nikiiv/zx-uno/hardware/ps2arduino/fotos/zxunops2_conexion_a_membrana.jpg

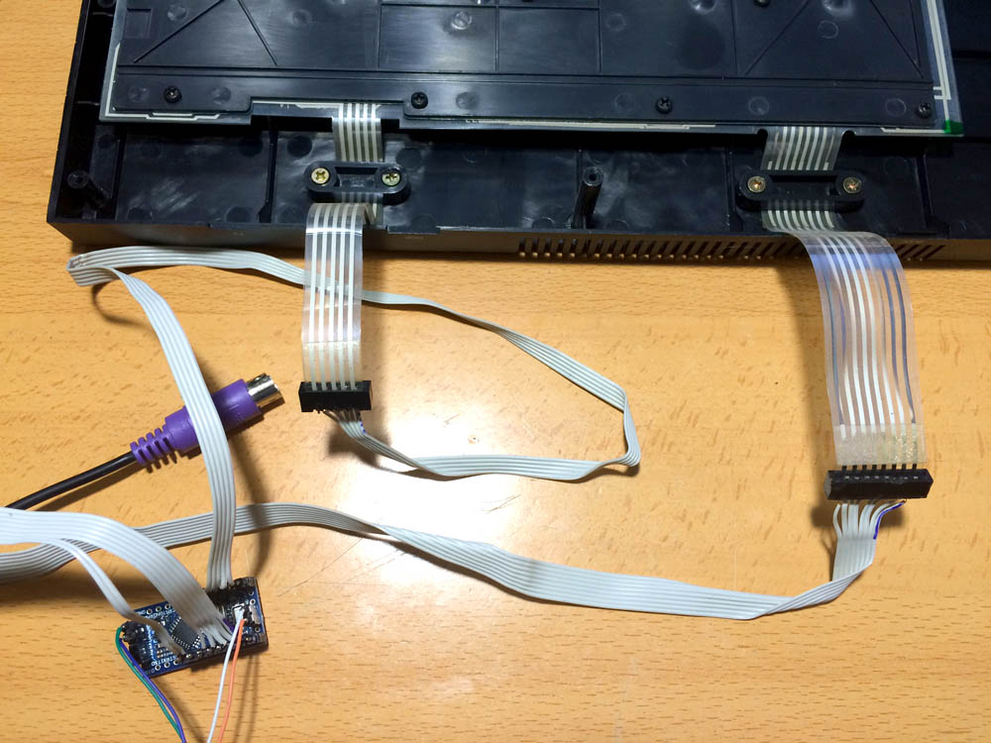
hardware/ps2arduino/fotos/zxunops2_conexion_a_membrana.jpg
