nikiiv/zx-uno/hardware/zxuno/A+/zxunoA.jpg

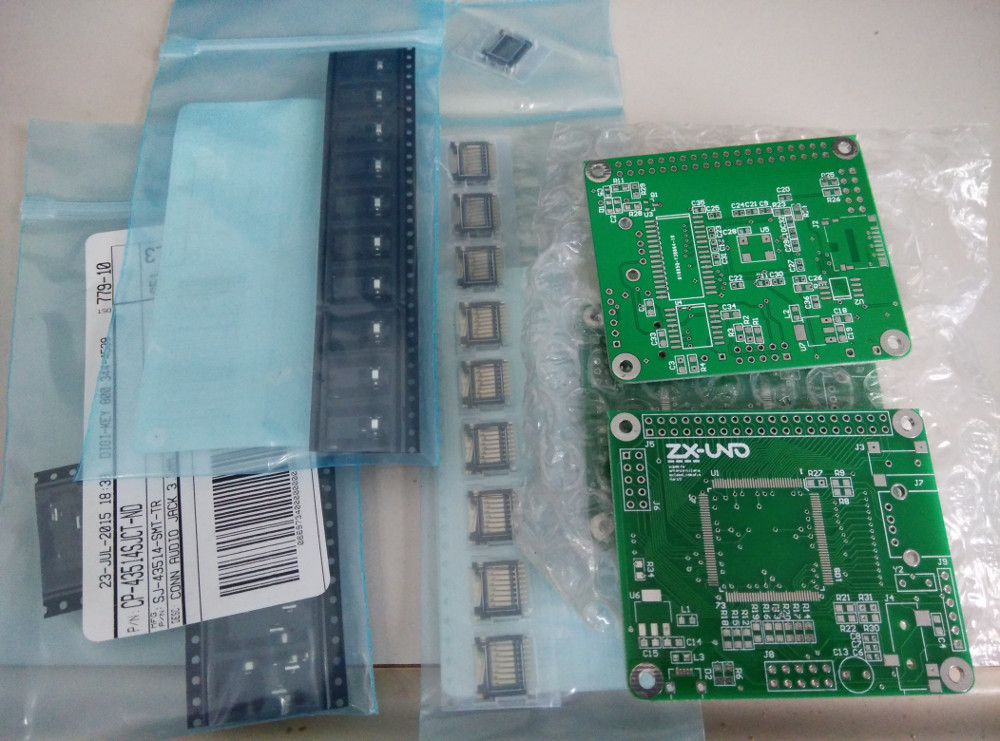
hardware/zxuno/A+/zxunoA.jpg
