nikiiv/zx-uno/hardware/usbjtag/readme.txt

Schematics and firmware source code here:
http://sa89a.net/mp.cgi/ele/ub.htm
