nikiiv/zx-uno/cores/ps2_to_speccy_reloaded/esquema_cableado_ps2_raton_y_teclado.gif

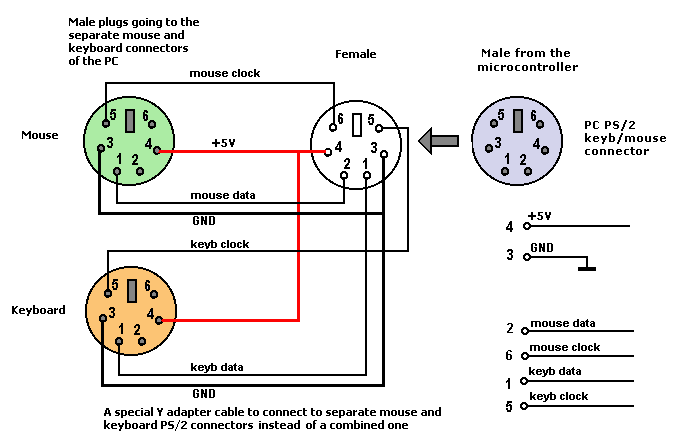
cores/ps2_to_speccy_reloaded/esquema_cableado_ps2_raton_y_teclado.gif
