nikiiv/zx-uno/cores/ps2_to_speccy_reloaded/zx_spectrum_matrix.gif

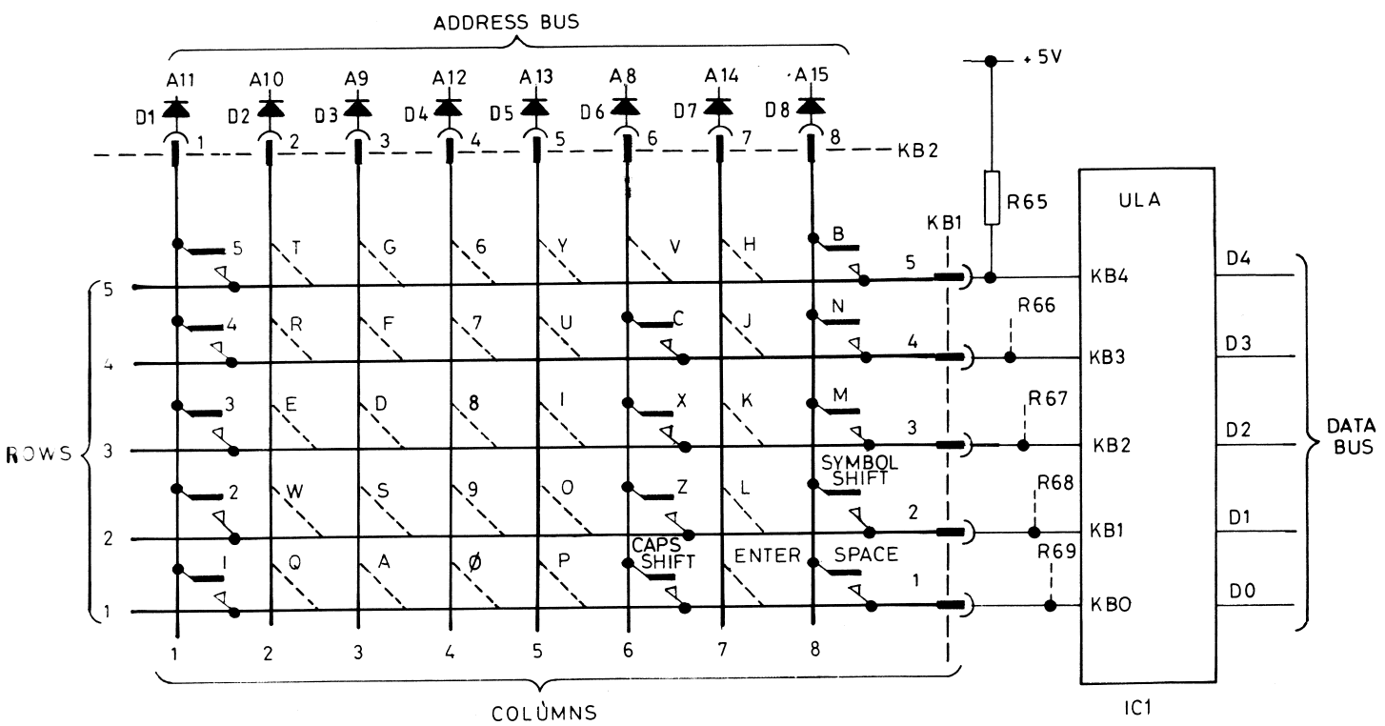
cores/ps2_to_speccy_reloaded/zx_spectrum_matrix.gif
