nikiiv/zx-uno/cores/pzx_player/core/pzx_player_implemented_in_hardware.png

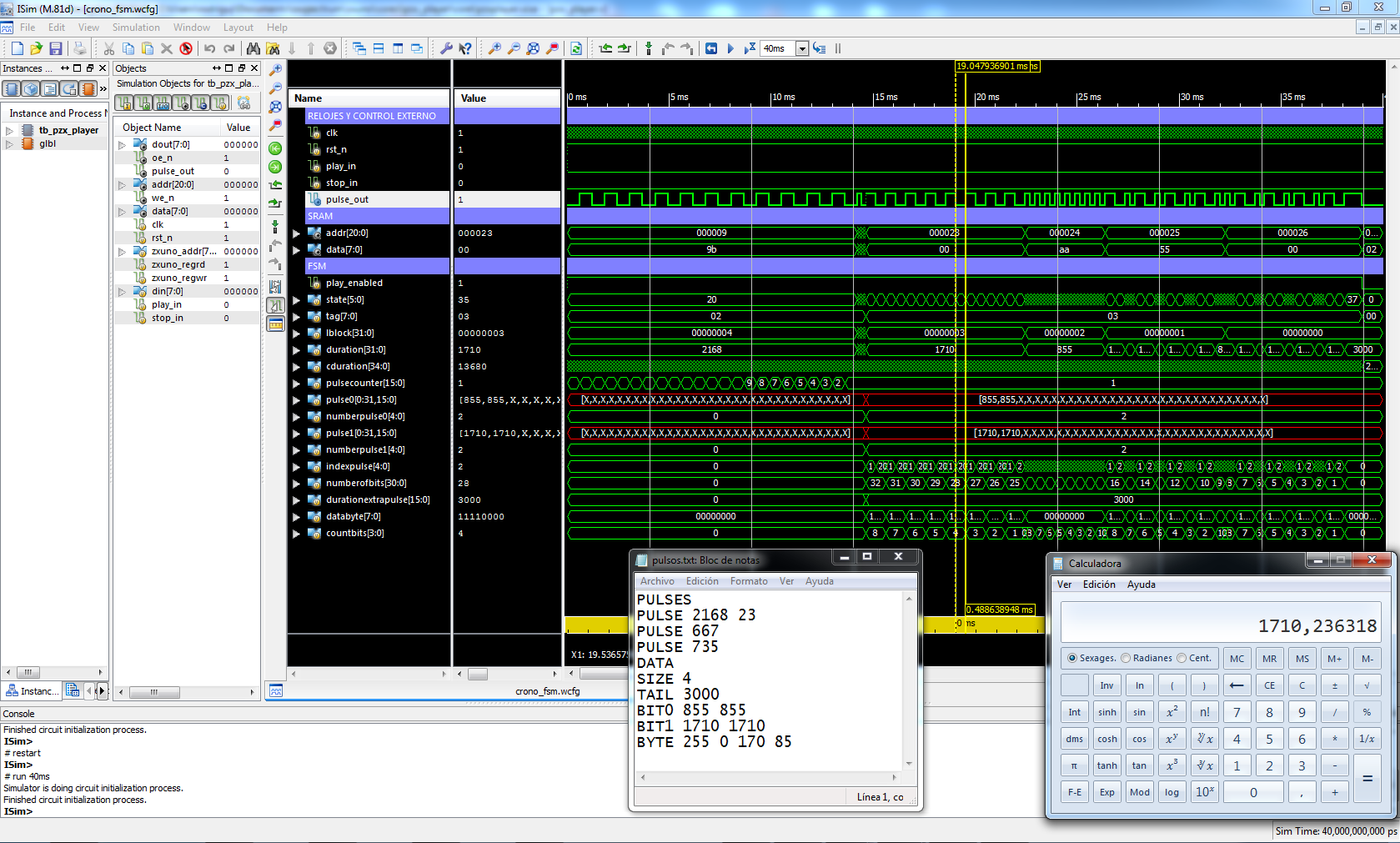
cores/pzx_player/core/pzx_player_implemented_in_hardware.png
