nikiiv/zx-uno/fotos/IMG_3362.JPG

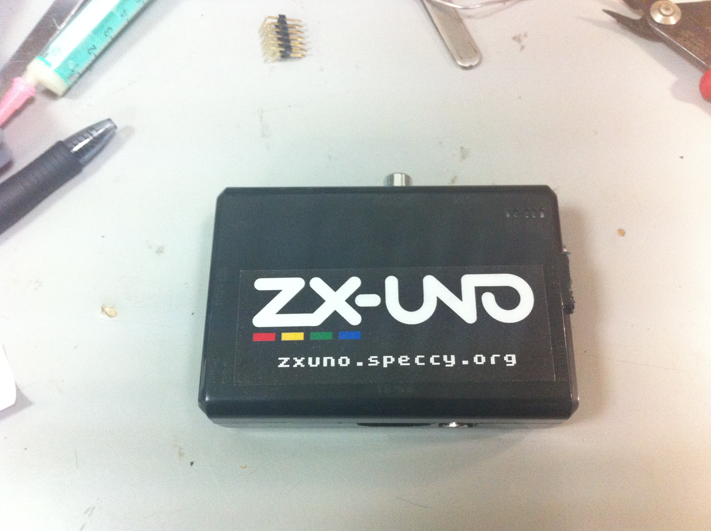
fotos/IMG_3362.JPG
