nikiiv/zx-uno/fotos/IMG_3363.JPG

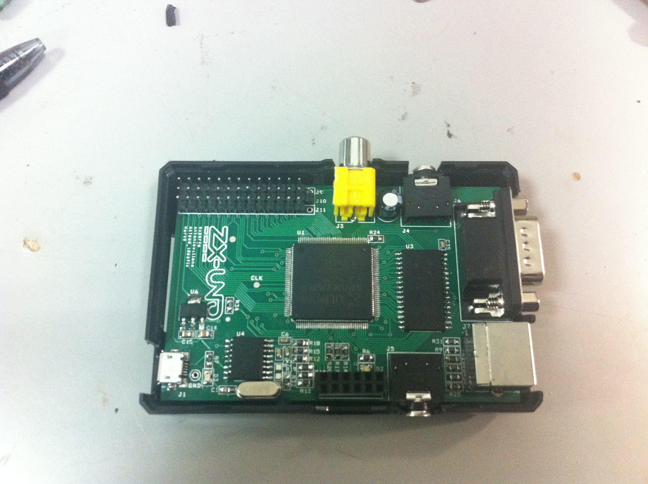
fotos/IMG_3363.JPG
