nikiiv/zx-uno/fotos/IMG_3365.JPG

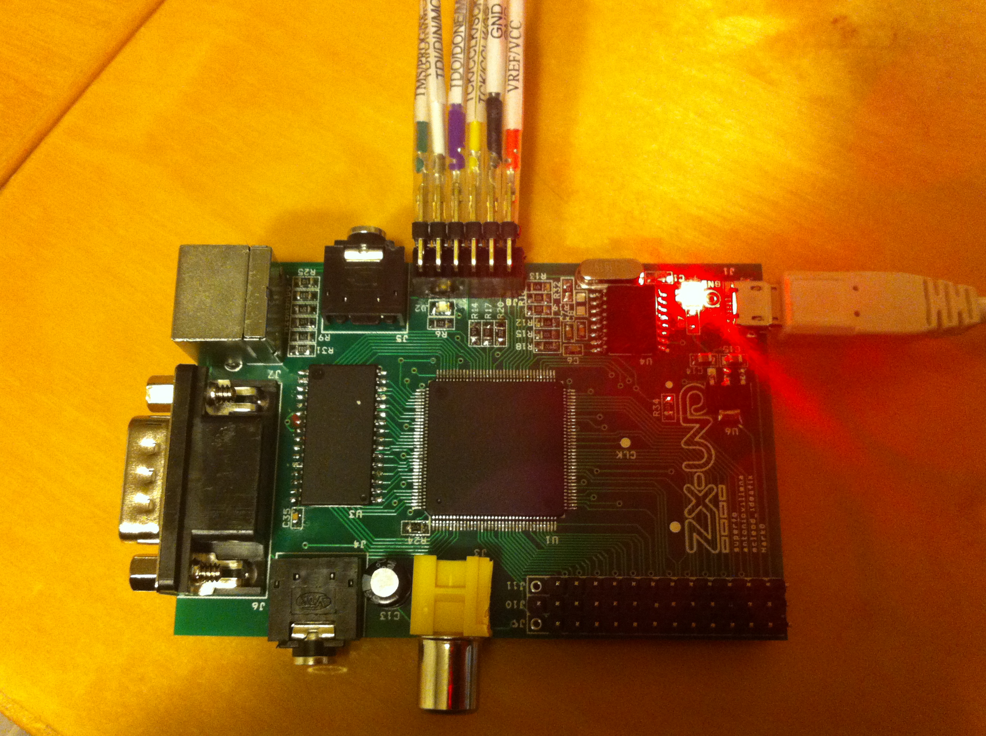
fotos/IMG_3365.JPG
