nikiiv/zx-uno/fotos/IMG_3367.JPG

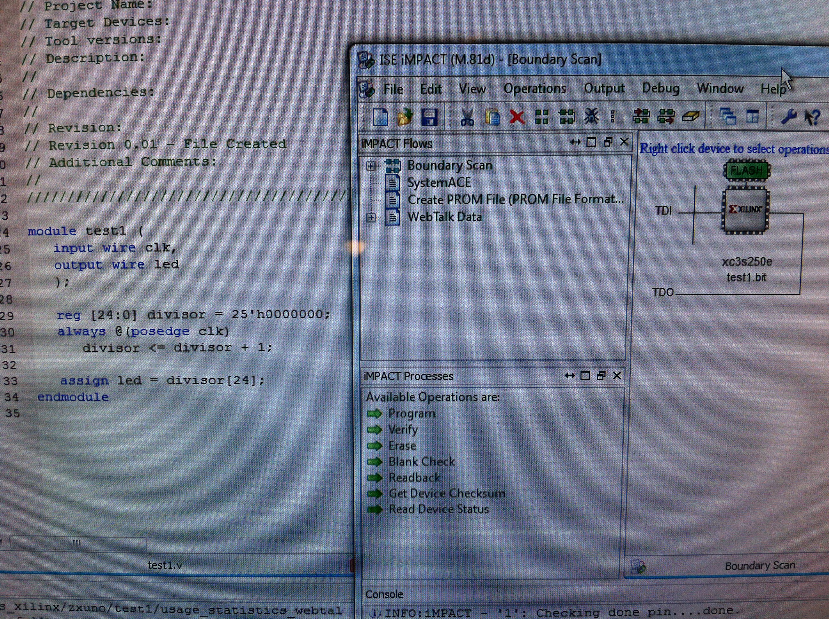
fotos/IMG_3367.JPG
