nikiiv/zx-uno/fotos/IMG_3368.JPG

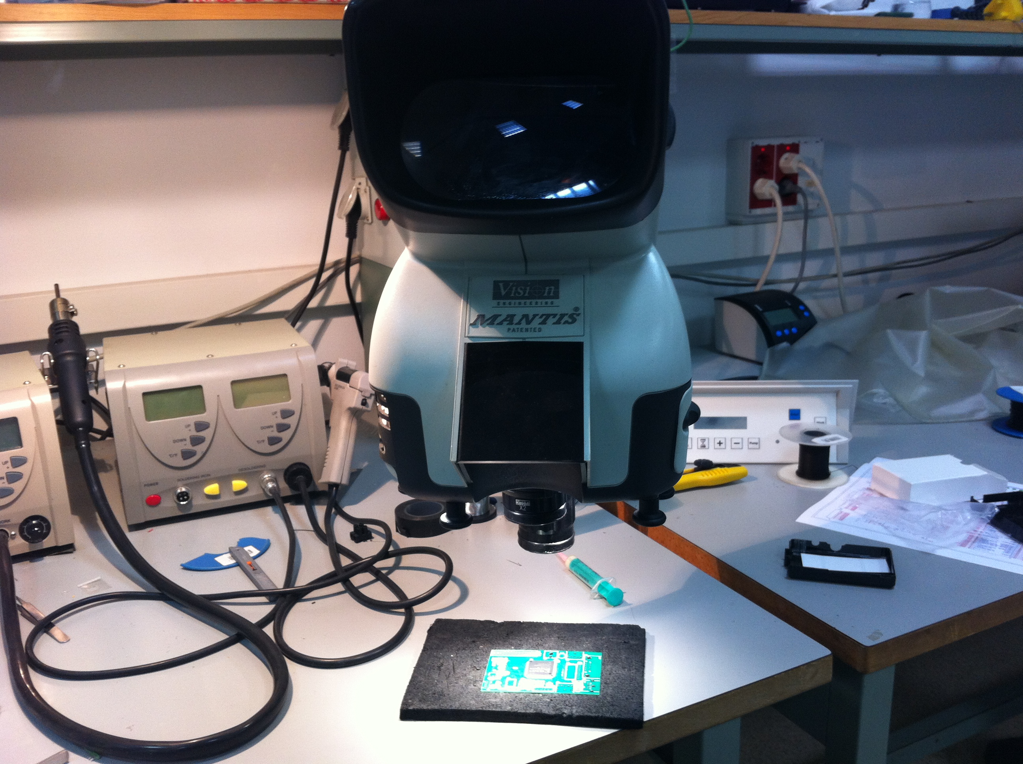
fotos/IMG_3368.JPG
