nikiiv/zx-uno/fotos/IMG_3369.JPG

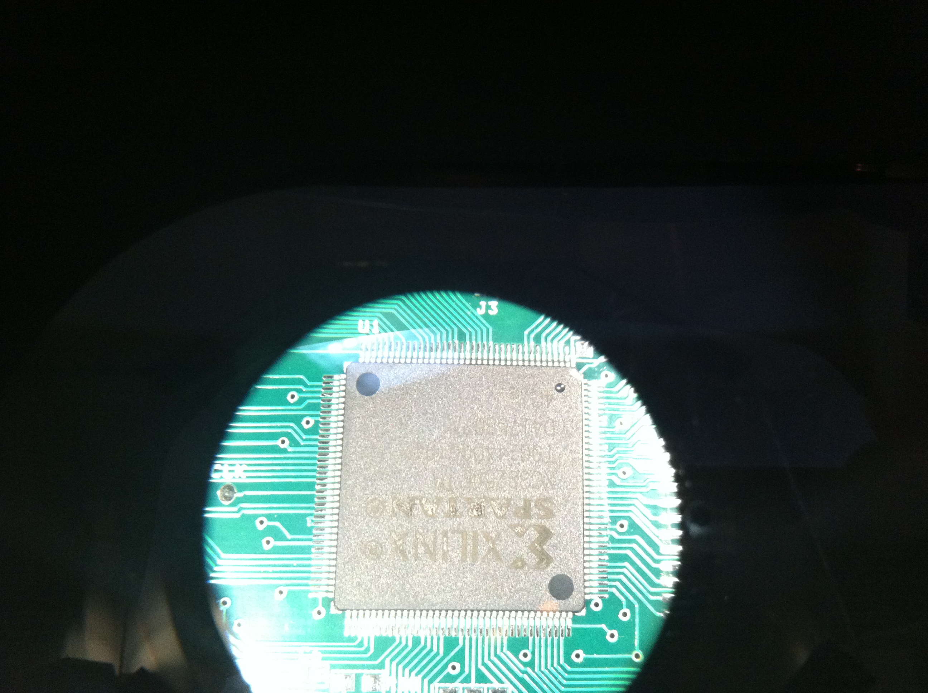
fotos/IMG_3369.JPG
