nikiiv/zx-uno/fotos/IMG_3370.JPG

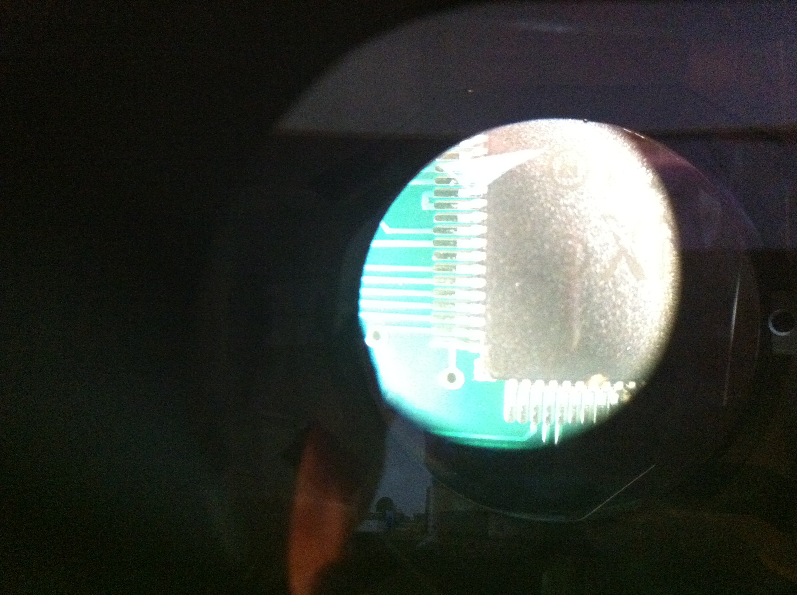
fotos/IMG_3370.JPG
