nikiiv/zx-uno/fotos/IMG_3373.JPG

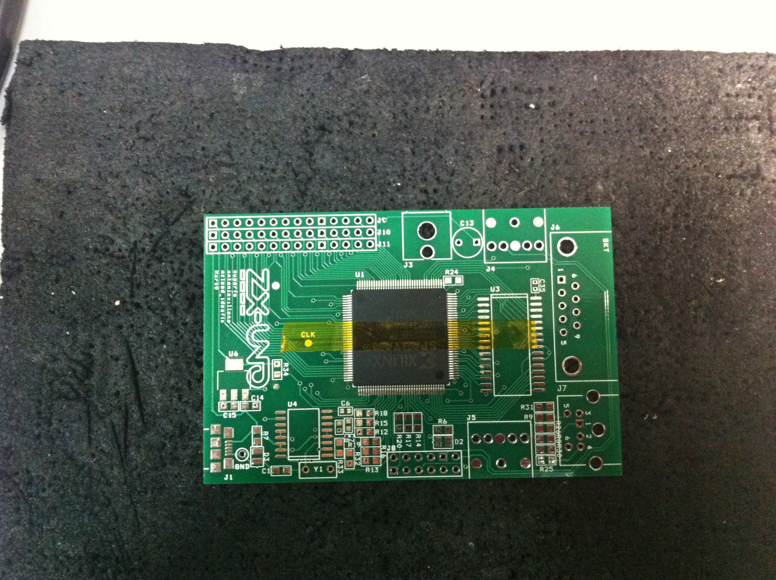
fotos/IMG_3373.JPG
