nikiiv/zx-uno/fotos/IMG_3374.JPG

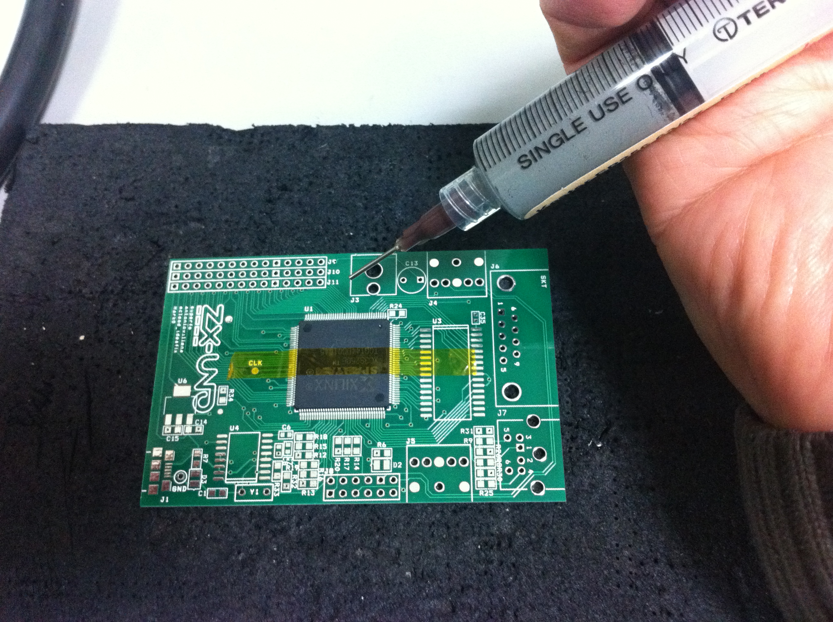
fotos/IMG_3374.JPG
