nikiiv/zx-uno/fotos/IMG_3375.JPG

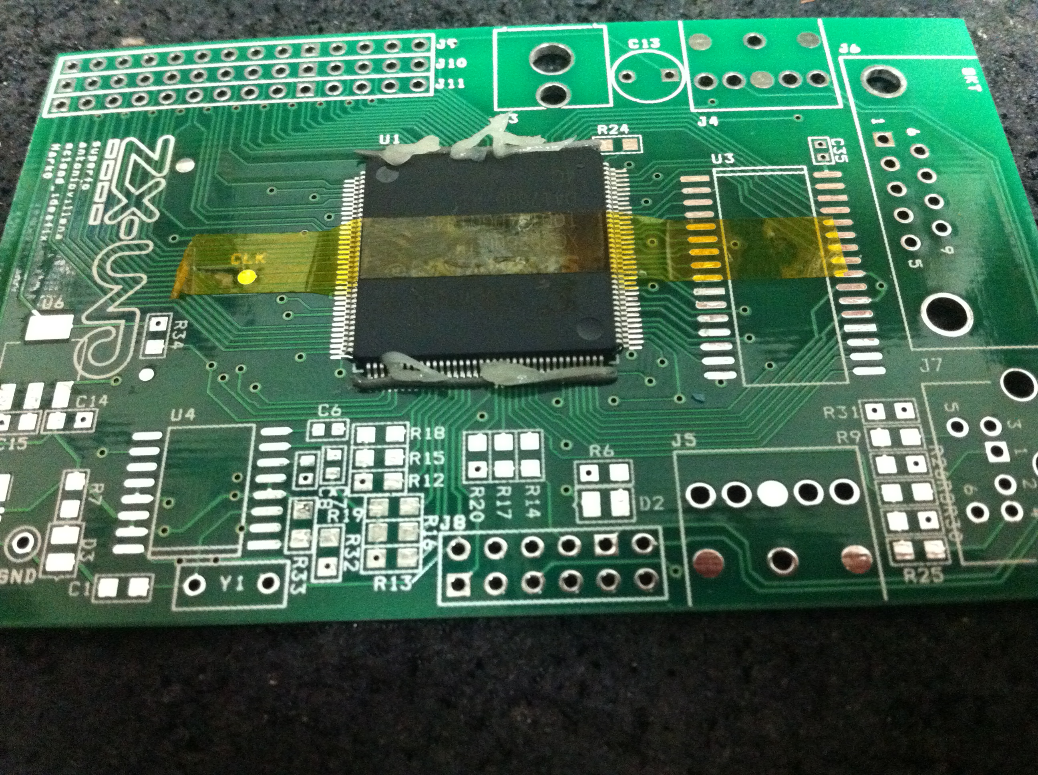
fotos/IMG_3375.JPG
