nikiiv/zx-uno/fotos/IMG_3380.JPG

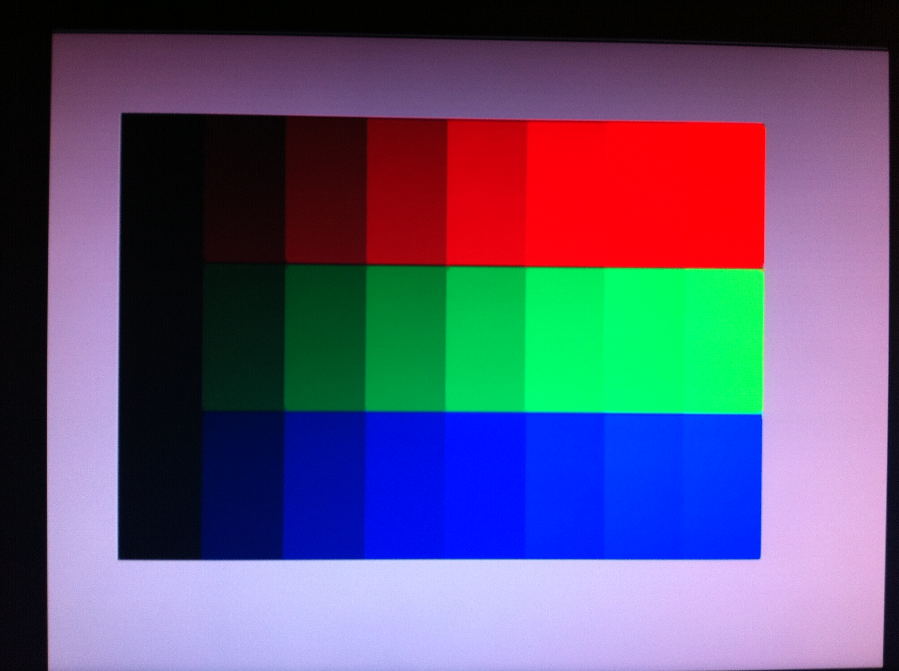
fotos/IMG_3380.JPG
