nikiiv/zx-uno/fotos/IMG_3383.JPG

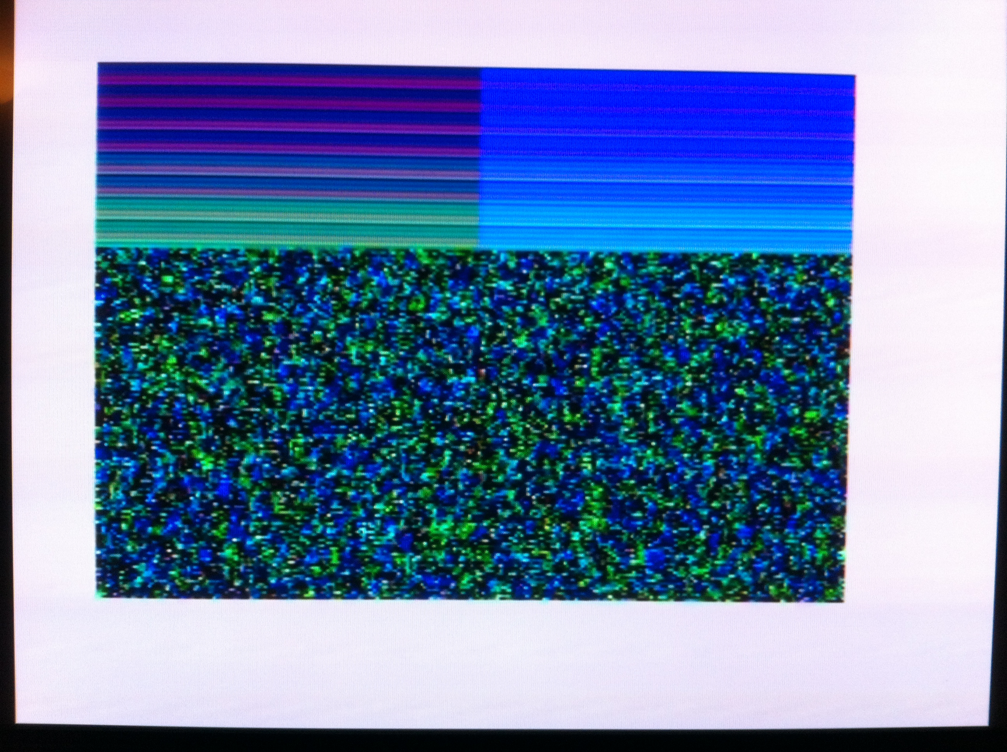
fotos/IMG_3383.JPG
