nikiiv/zx-uno/fotos/IMG_3384.JPG

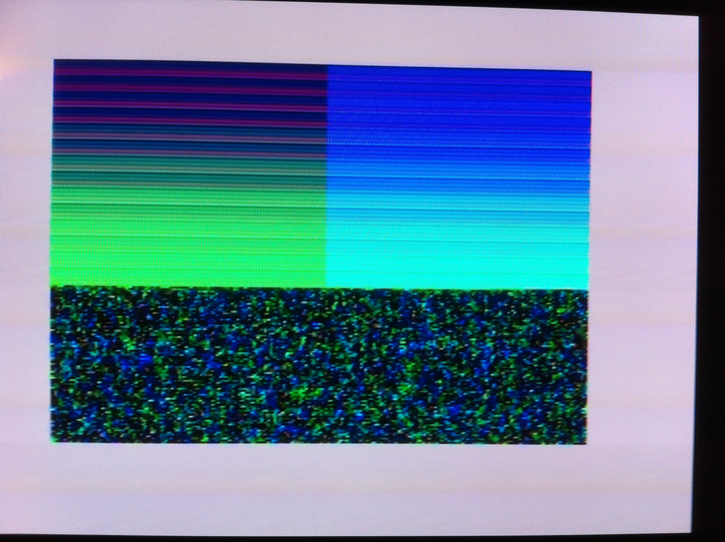
fotos/IMG_3384.JPG
