nikiiv/zx-uno/fotos/IMG_3385.JPG

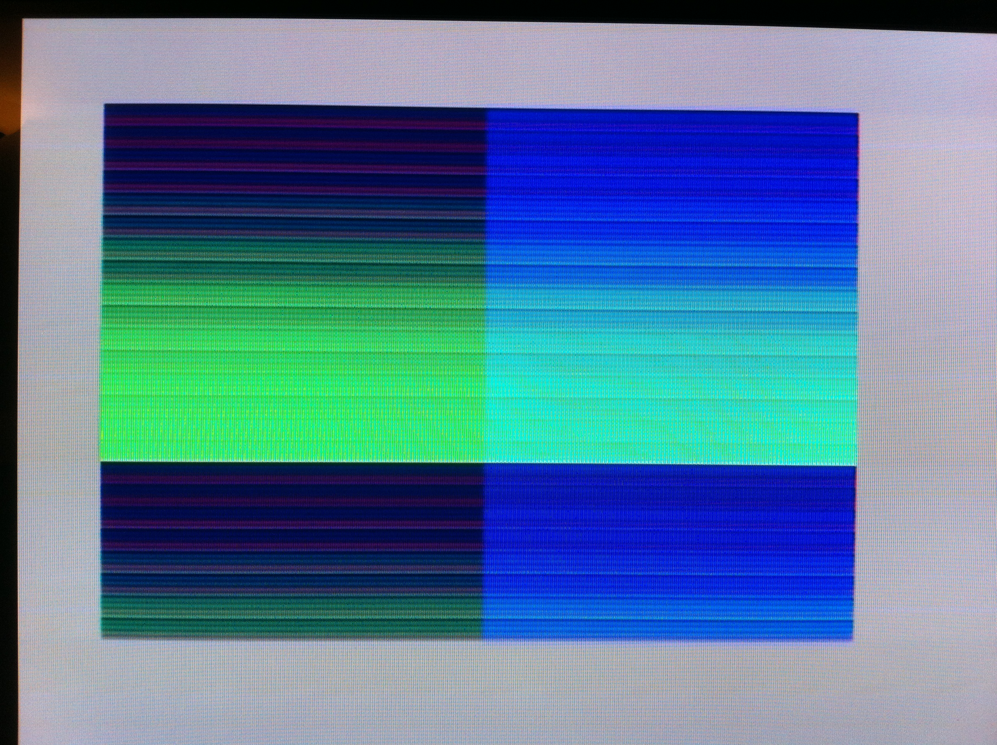
fotos/IMG_3385.JPG
