nikiiv/zx-uno/fotos/IMG_3386.JPG

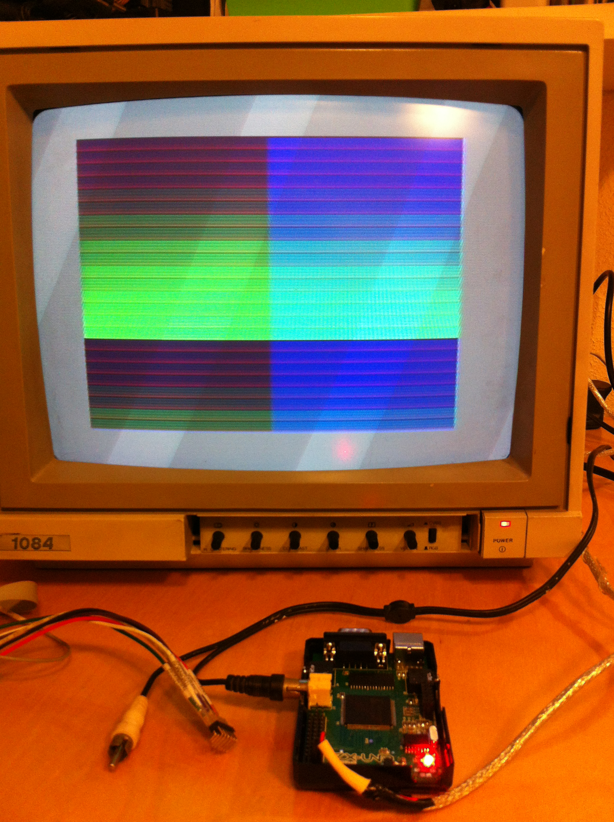
fotos/IMG_3386.JPG
