nikiiv/zx-uno/fotos/IMG_3388.JPG

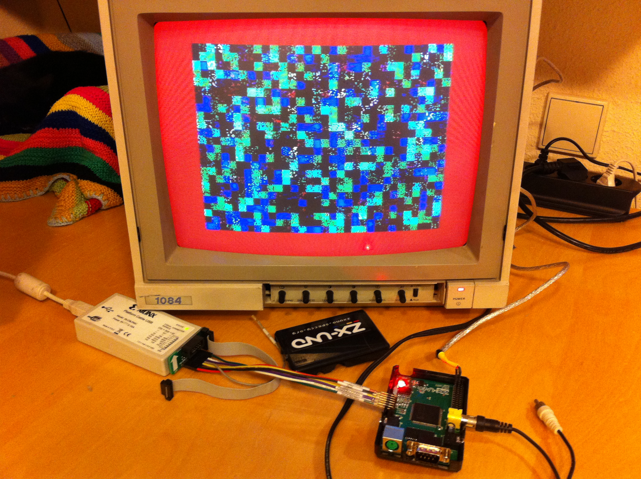
fotos/IMG_3388.JPG
