nikiiv/zx-uno/fotos/IMG_3389.JPG

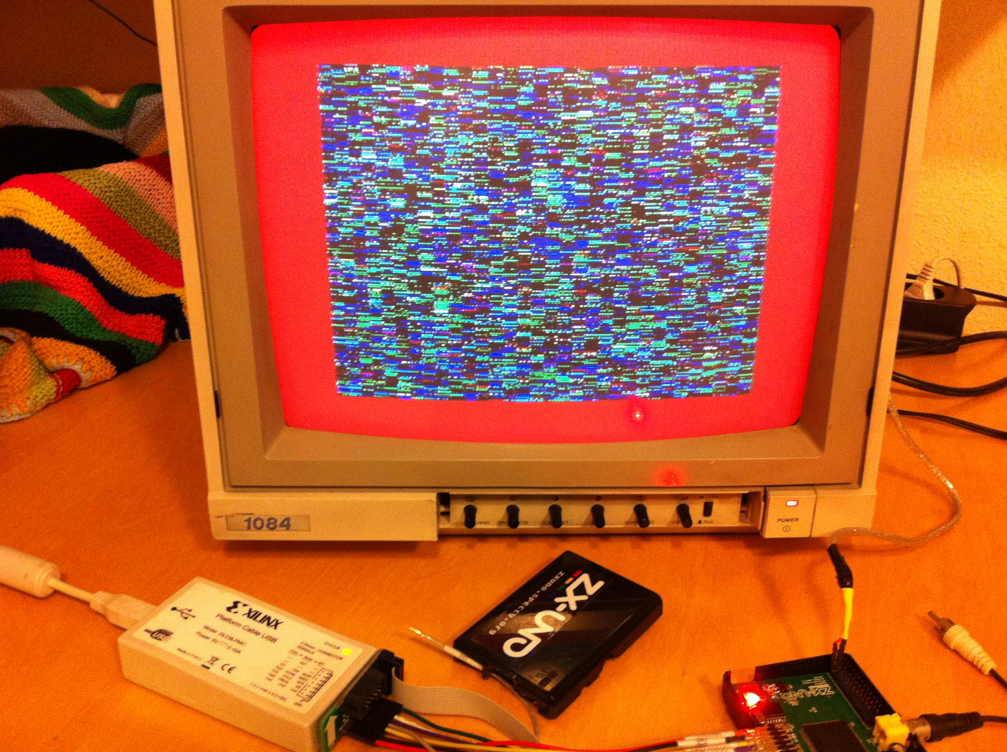
fotos/IMG_3389.JPG
