nikiiv/zx-uno/fotos/IMG_3390.JPG

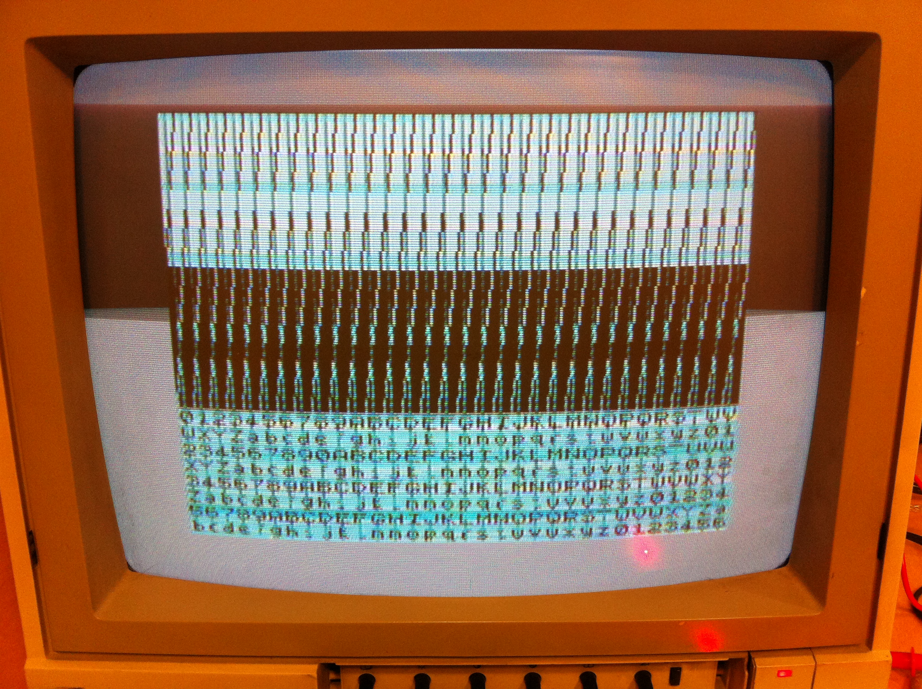
fotos/IMG_3390.JPG
