nikiiv/zx-uno/fotos/IMG_3391.JPG

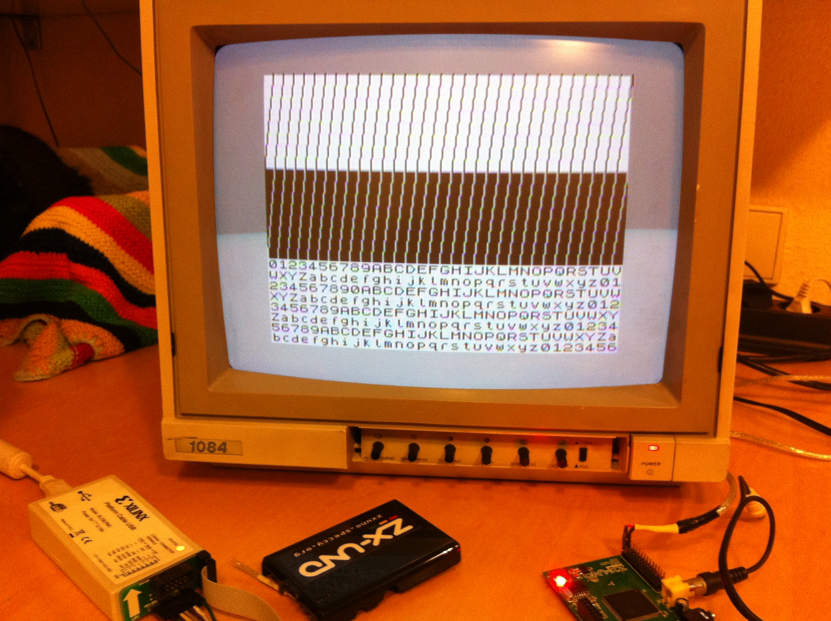
fotos/IMG_3391.JPG
