nikiiv/zx-uno/fotos/IMG_3392.JPG

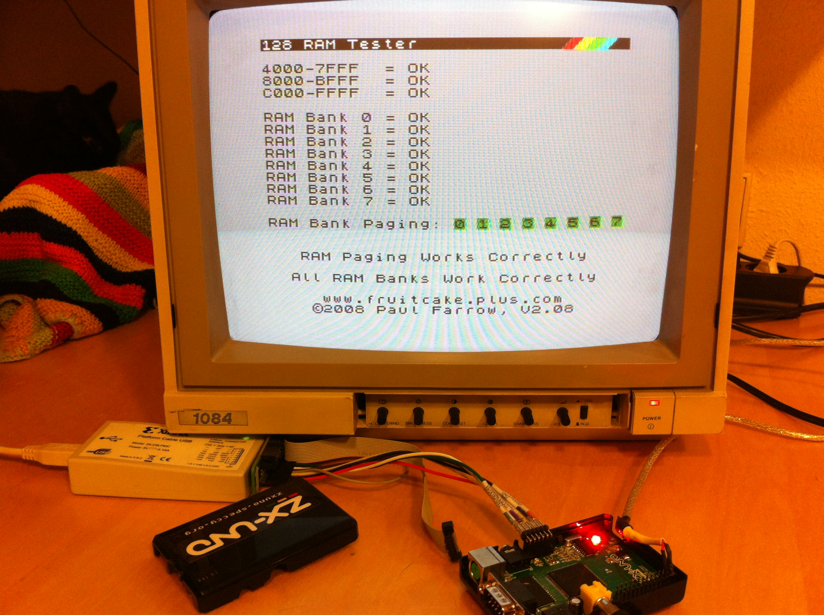
fotos/IMG_3392.JPG
