nikiiv/zx-uno/fotos/IMG_3395.JPG

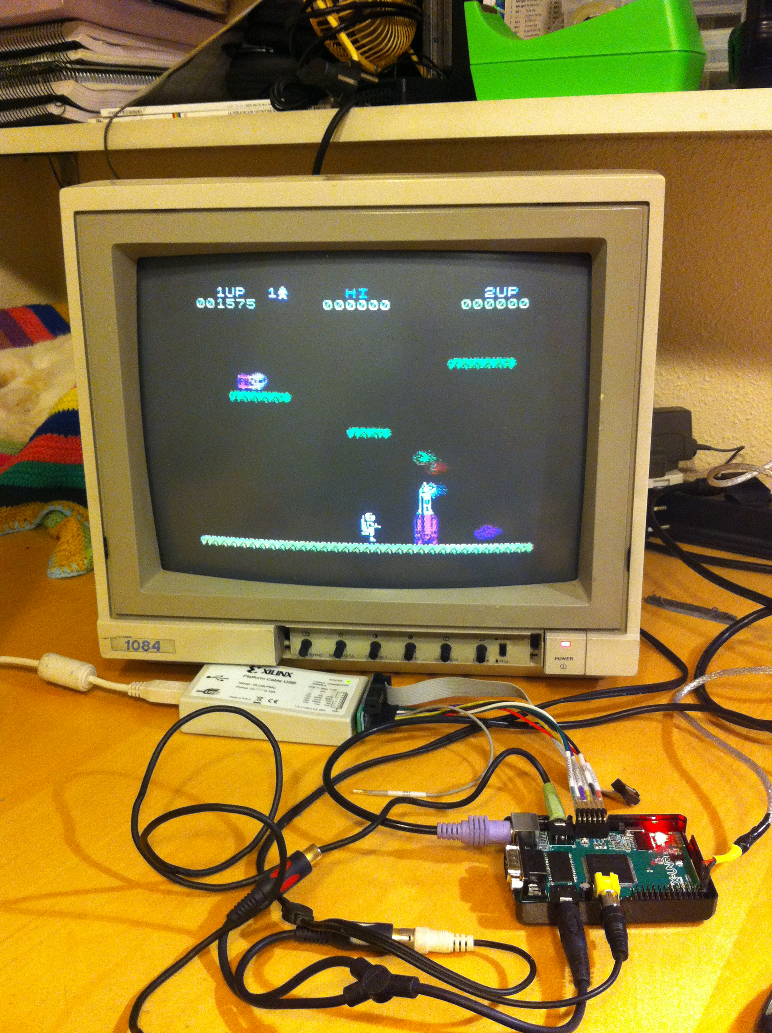
fotos/IMG_3395.JPG
