nikiiv/zx-uno/fotos/IMG_3396.JPG

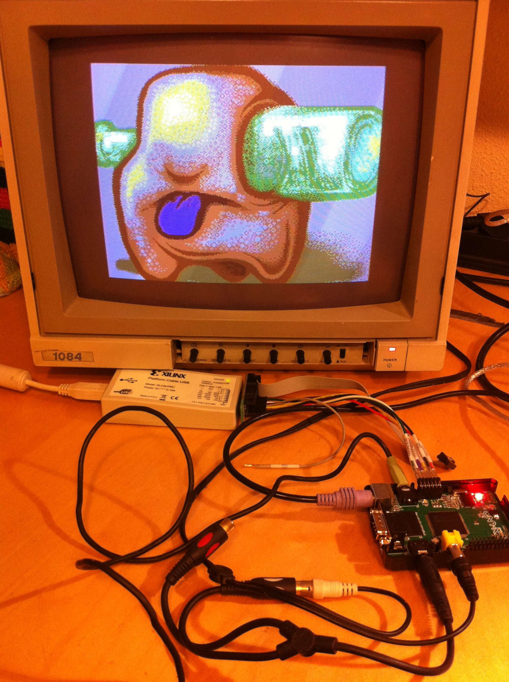
fotos/IMG_3396.JPG
