nikiiv/zx-uno/fotos/IMG_3397.JPG

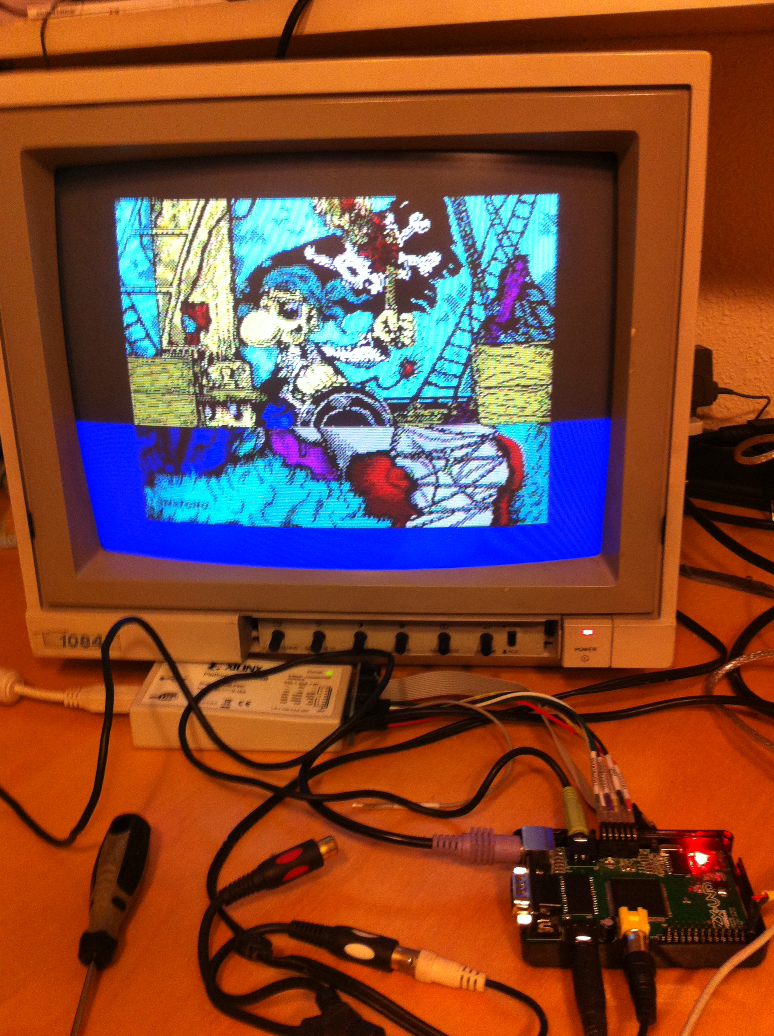
fotos/IMG_3397.JPG
