nikiiv/zx-uno/fotos/IMG_3398.JPG

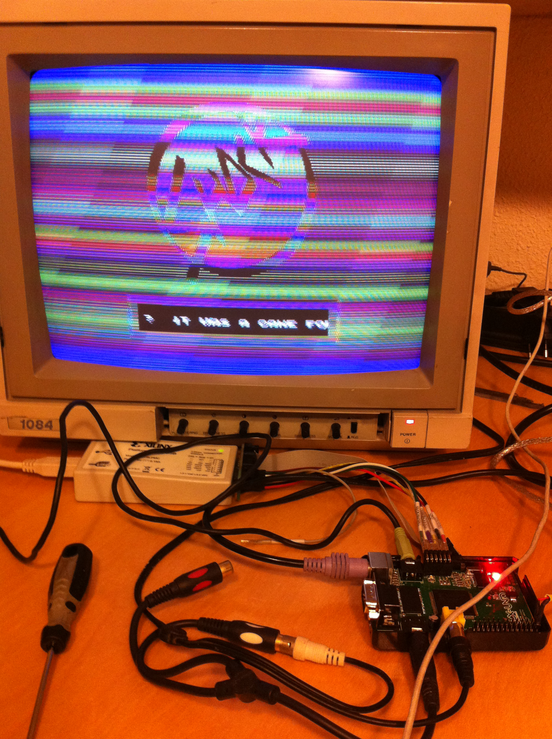
fotos/IMG_3398.JPG
