nikiiv/zx-uno/fotos/IMG_3399.JPG

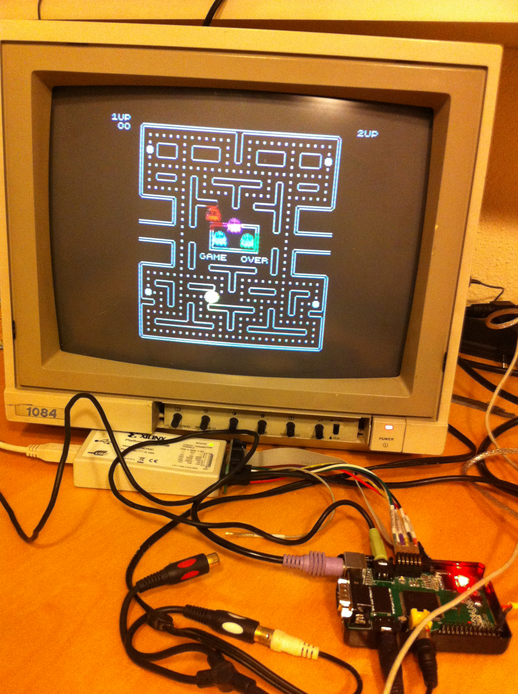
fotos/IMG_3399.JPG
