nikiiv/zx-uno/fotos/IMG_3400.JPG

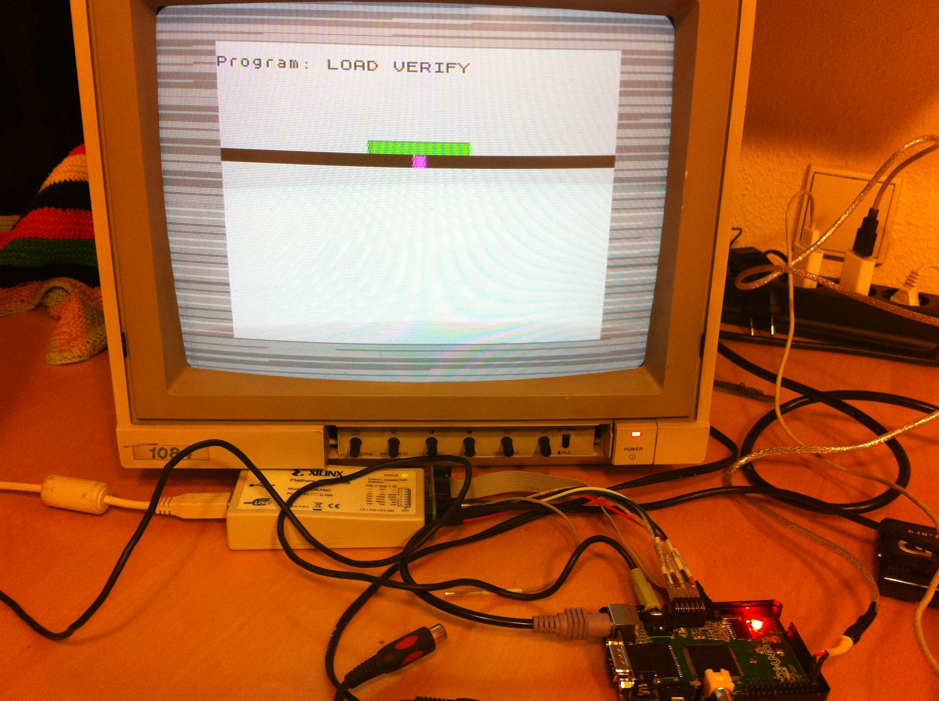
fotos/IMG_3400.JPG
