nikiiv/zx-uno/fotos/IMG_3401.JPG

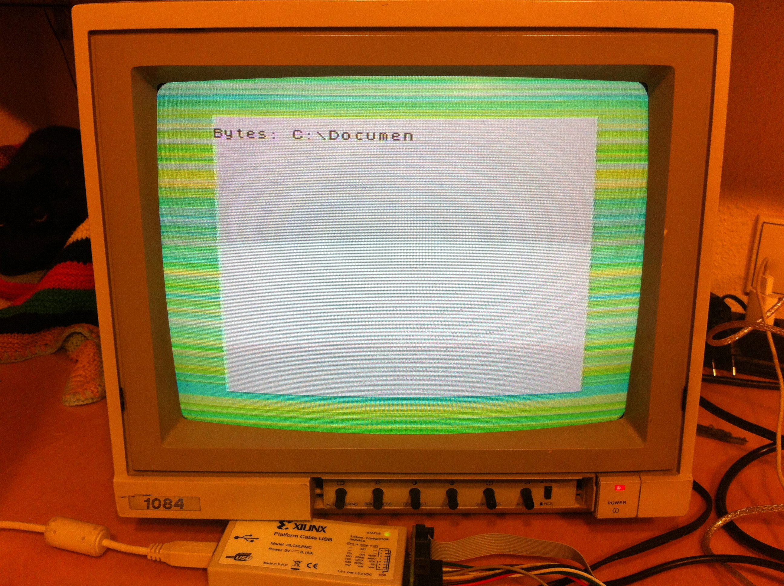
fotos/IMG_3401.JPG
