nikiiv/zx-uno/fotos/IMG_3402.JPG

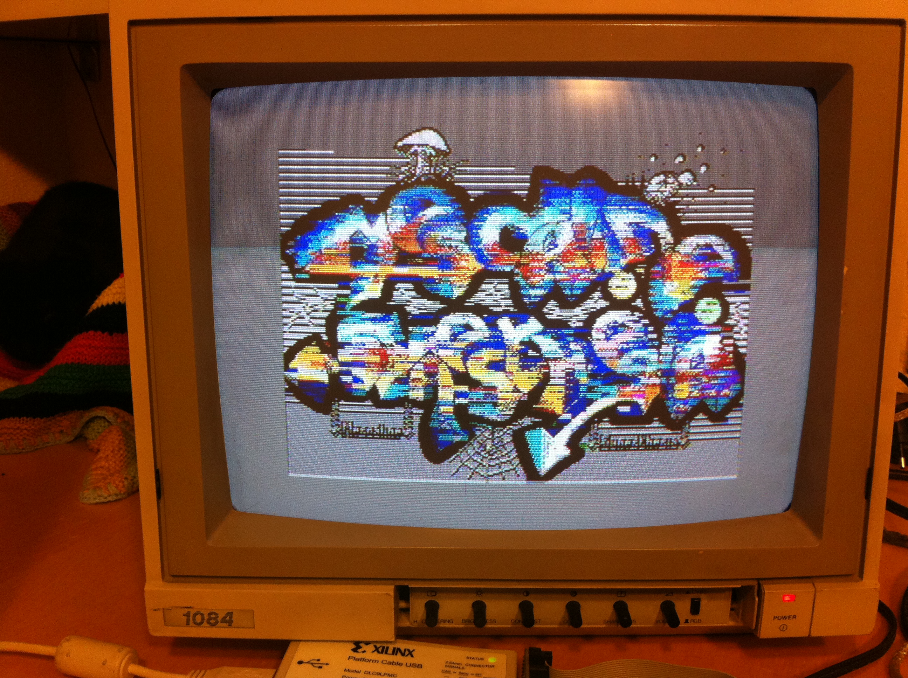
fotos/IMG_3402.JPG
