nikiiv/zx-uno/fotos/IMG_3403.JPG

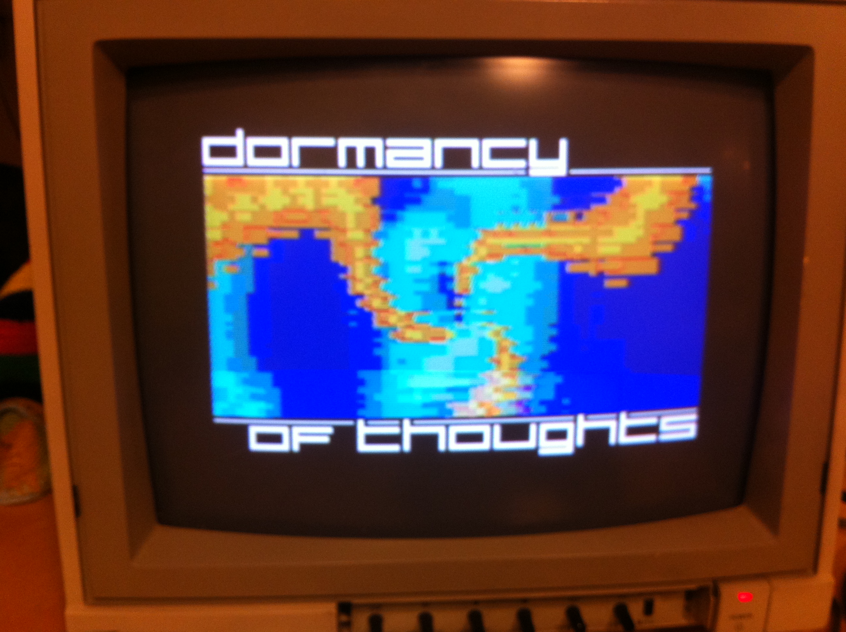
fotos/IMG_3403.JPG
