nikiiv/zx-uno/fotos/IMG_3404.JPG

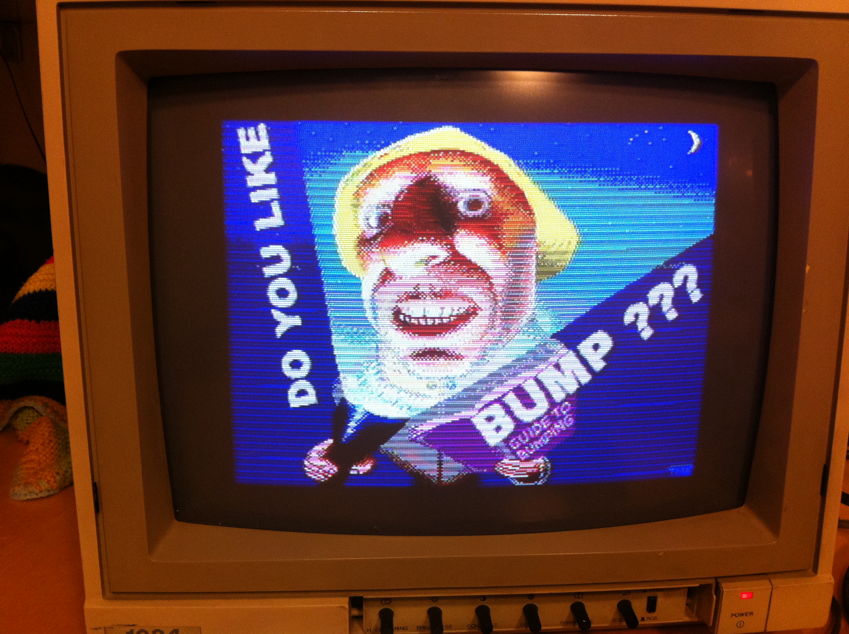
fotos/IMG_3404.JPG
