nikiiv/zx-uno/fotos/IMG_3405.JPG

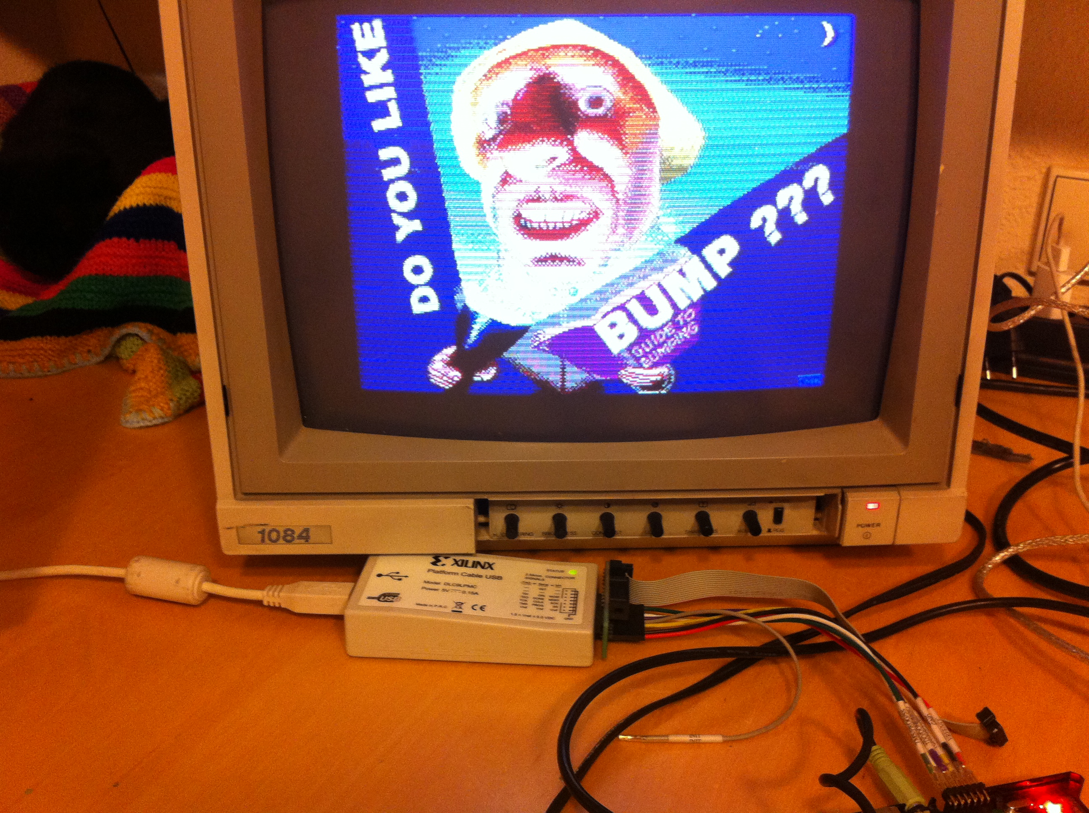
fotos/IMG_3405.JPG
