nikiiv/zx-uno/fotos/posicionando_fpga_con_kapton_y_lupa.jpg

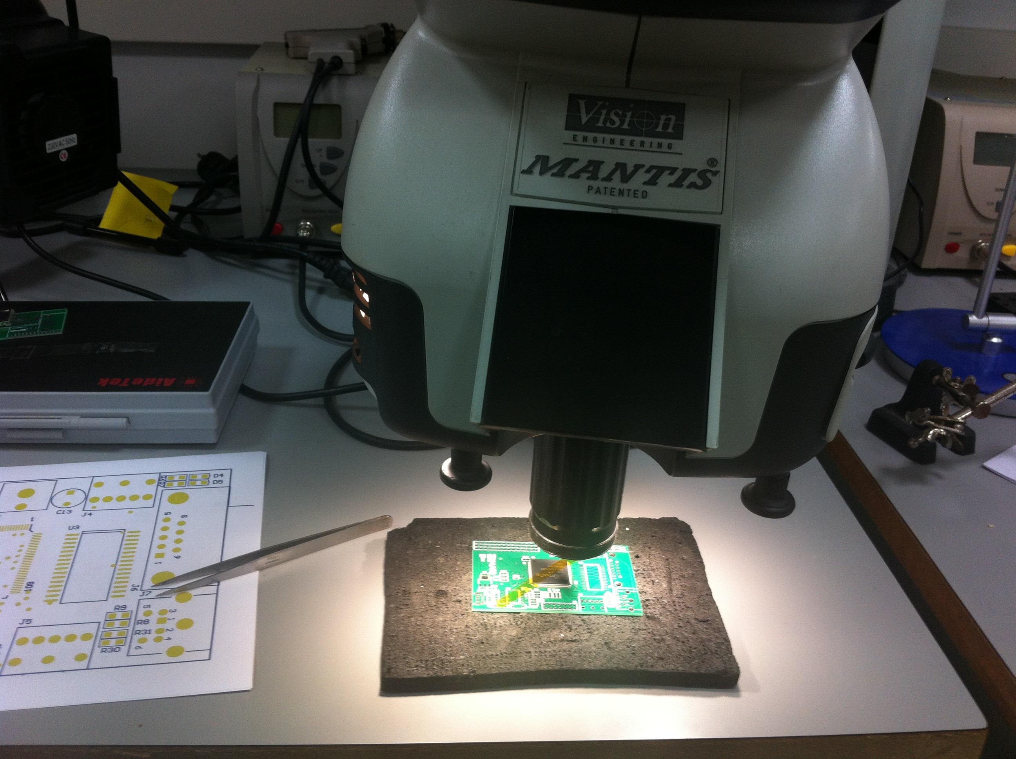
fotos/posicionando_fpga_con_kapton_y_lupa.jpg
