nikiiv/zx-uno/fotos/soldando_resistencias_1_de_4.jpg

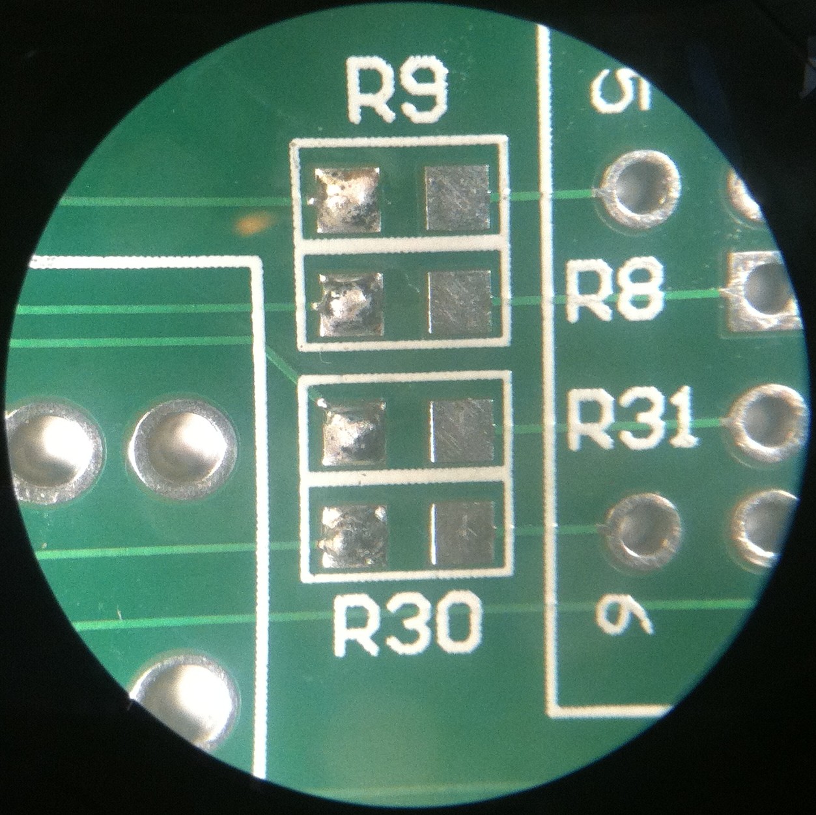
fotos/soldando_resistencias_1_de_4.jpg
