nikiiv/zx-uno/fotos/soldando_resistencias_2_de_4.jpg

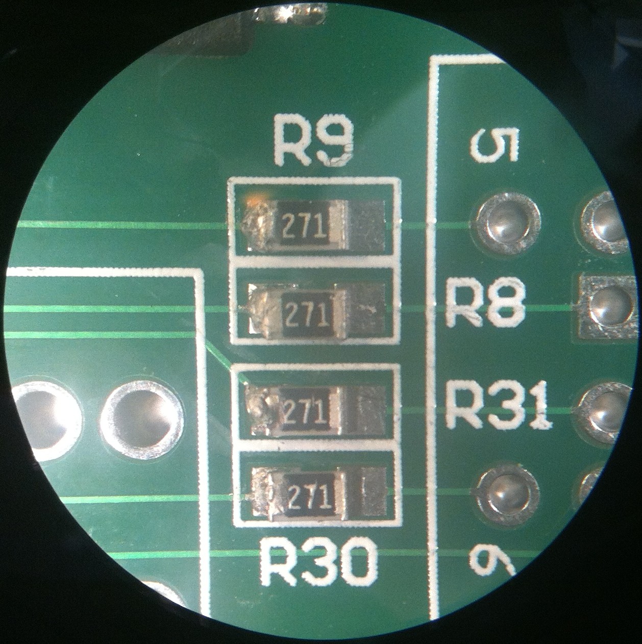
fotos/soldando_resistencias_2_de_4.jpg
