nikiiv/zx-uno/fotos/soldando_resistencias_3_de_4.jpg

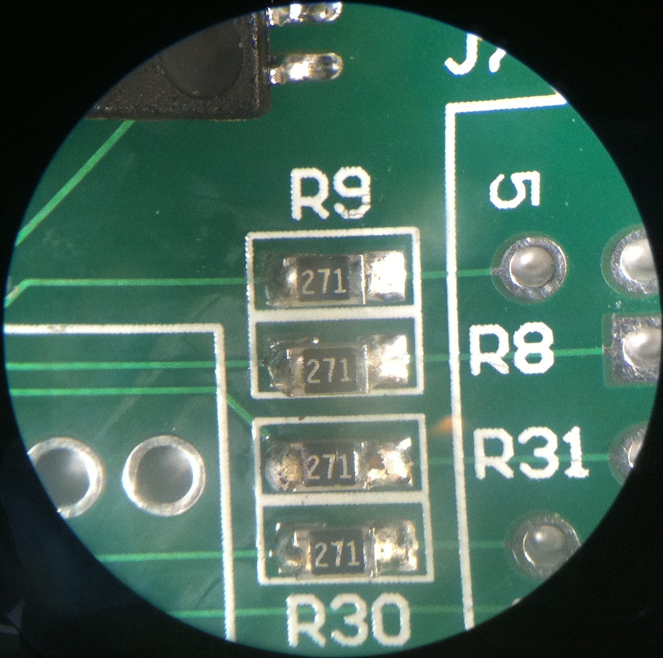
fotos/soldando_resistencias_3_de_4.jpg
