nikiiv/zx-uno/fotos/soldando_resistencias_4_de_4.jpg

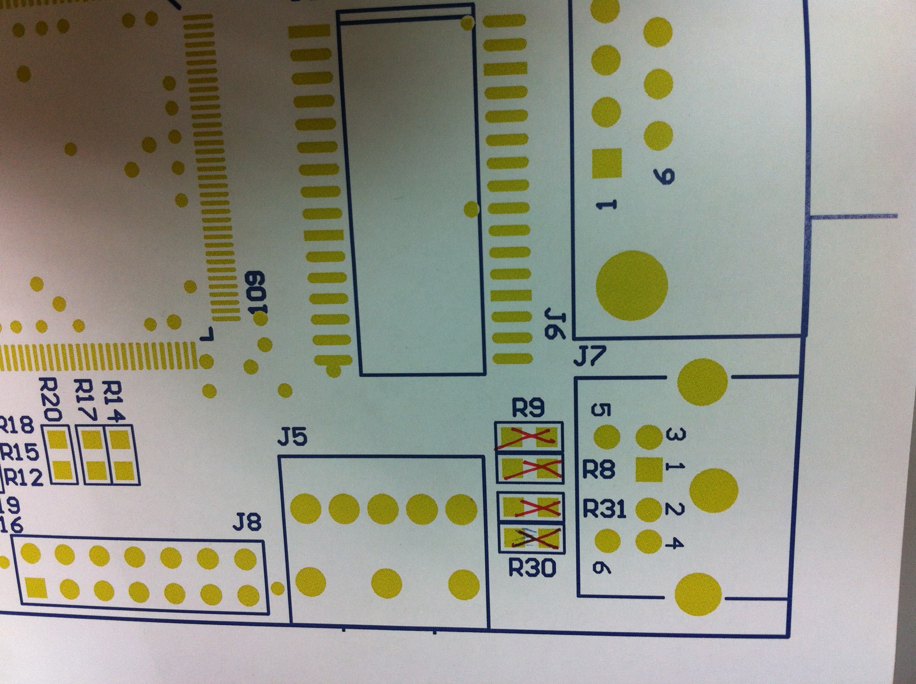
fotos/soldando_resistencias_4_de_4.jpg
