nikiiv/zx-uno/hardware/otros/comcon/comcon_version_mcleod.png

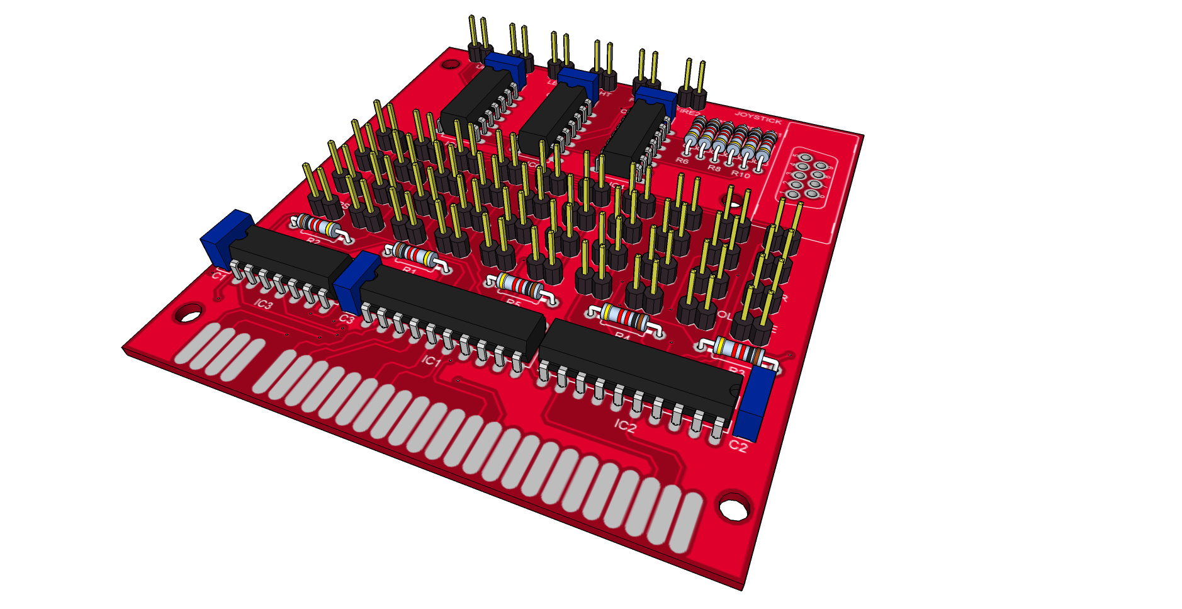
hardware/otros/comcon/comcon_version_mcleod.png
