nikiiv/zx-uno/hardware/otros/comcon/comcon_version_mcleod_top.png

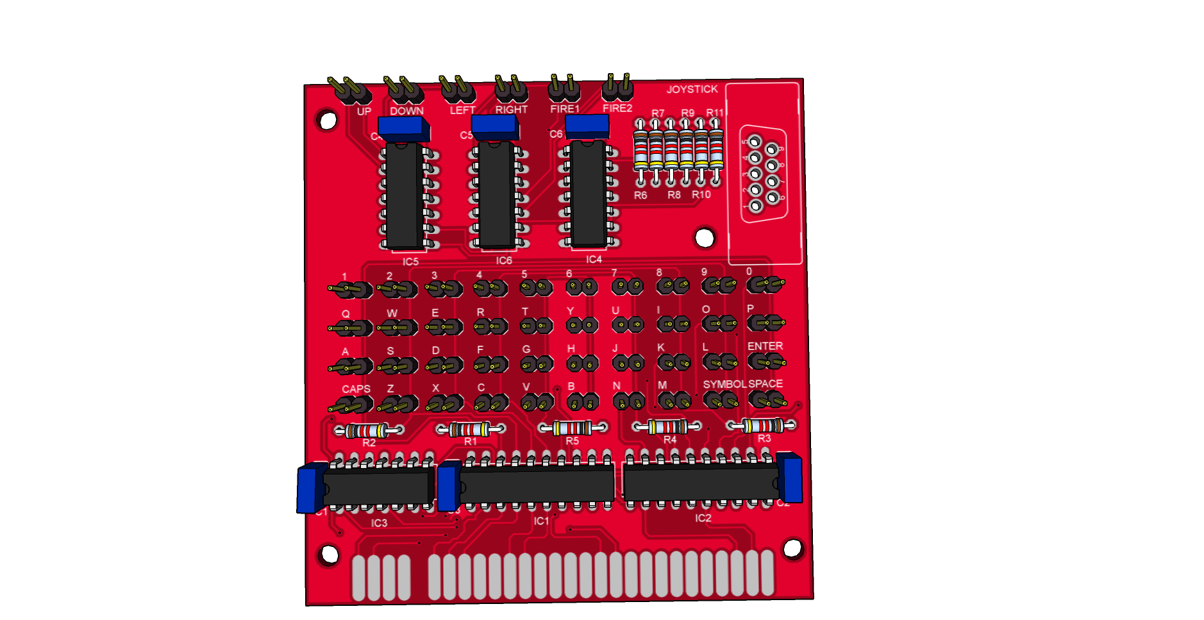
hardware/otros/comcon/comcon_version_mcleod_top.png
