nikiiv/zx-uno/hardware/ps2arduino/+3KeyboardMatrix.png

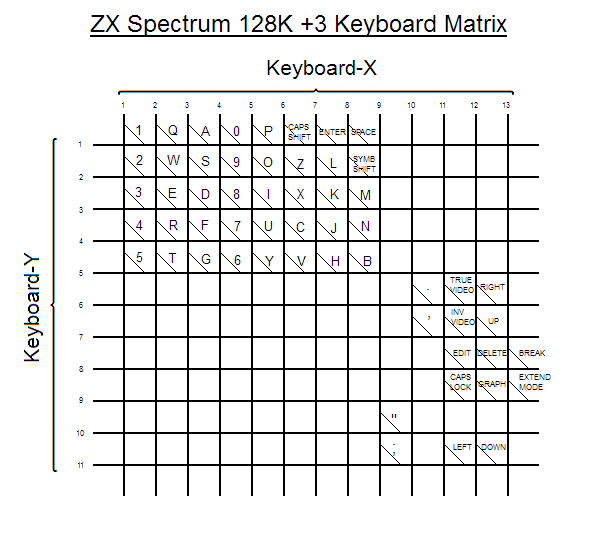
hardware/ps2arduino/+3KeyboardMatrix.png
