nikiiv/zx-uno/hardware/ps2arduino/conexiones_zxunops2.jpg

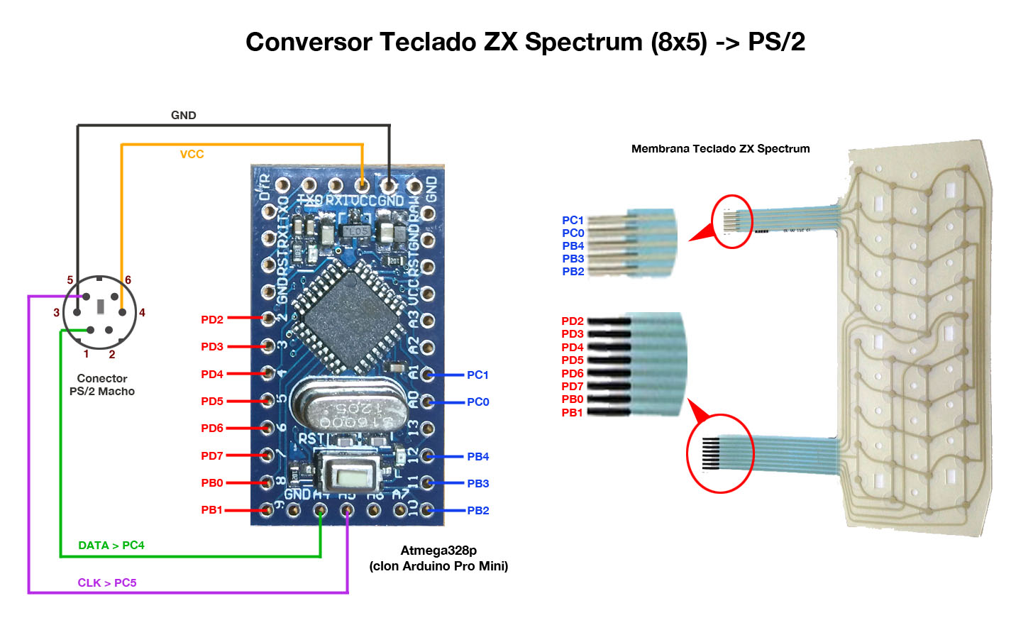
hardware/ps2arduino/conexiones_zxunops2.jpg
