nikiiv/zx-uno/hardware/ps2arduino/fotos/zxunops2_detalle_atmel.jpg

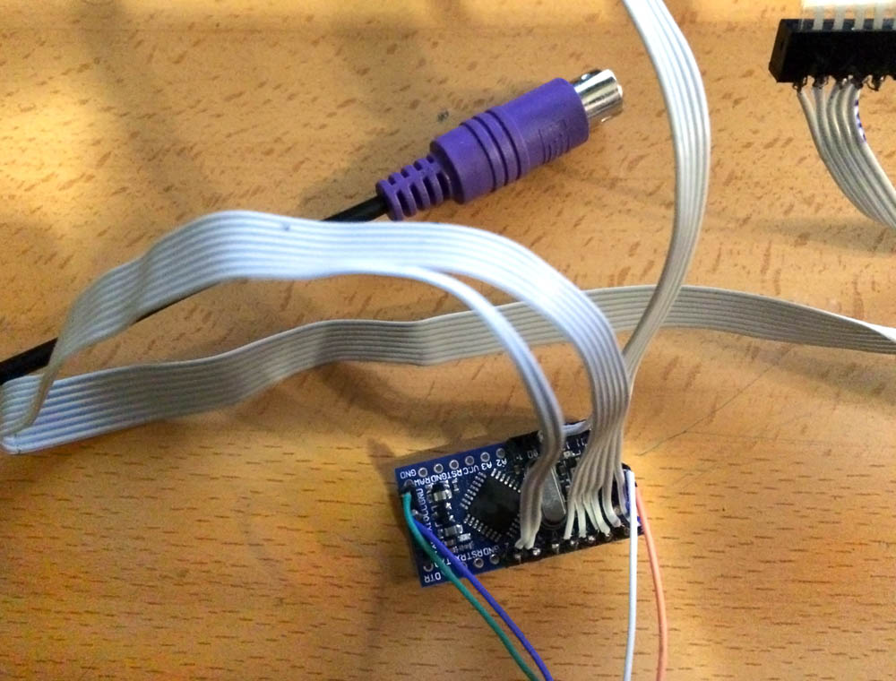
hardware/ps2arduino/fotos/zxunops2_detalle_atmel.jpg
