nikiiv/zx-uno/hardware/ps2arduino/fotos/zxunops2_funcionando.jpg

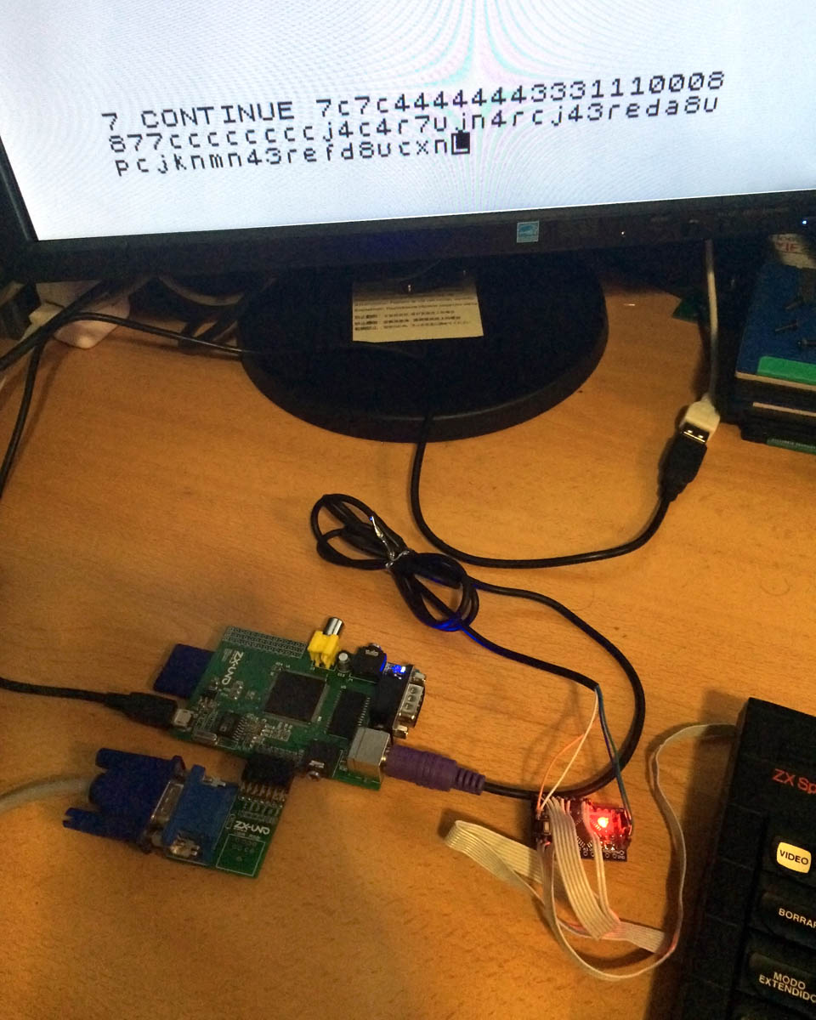
hardware/ps2arduino/fotos/zxunops2_funcionando.jpg
