nikiiv/zx-uno/hardware/ps2arduino/fotos/zxunops2_y_plus.jpg

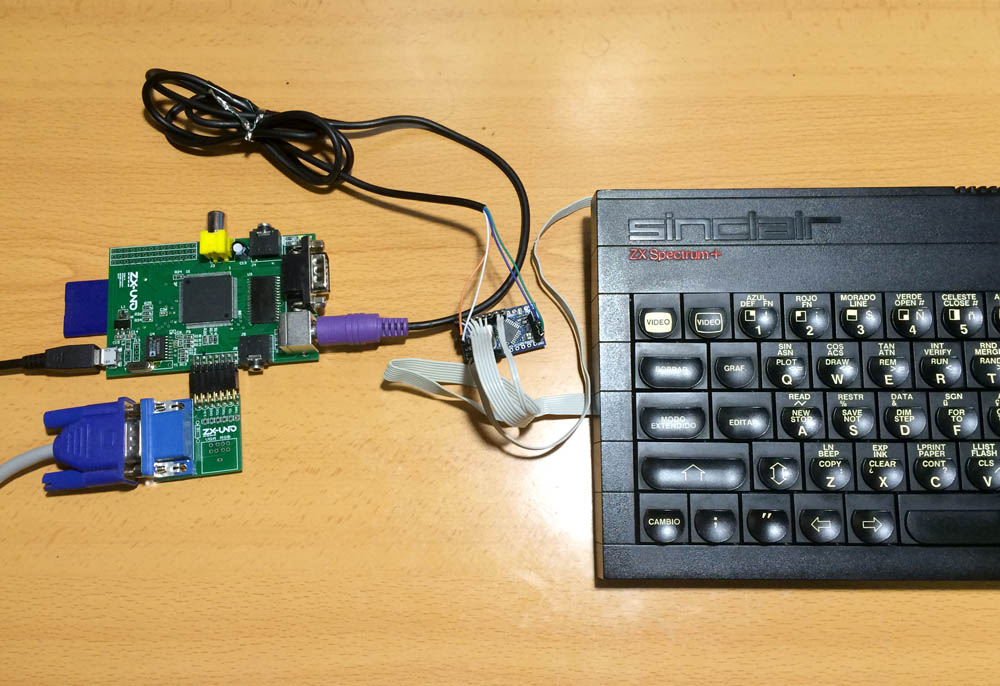
hardware/ps2arduino/fotos/zxunops2_y_plus.jpg
