nikiiv/zx-uno/hardware/ps2arduino/fotos/zxunops2_y_plus_encendido.jpg

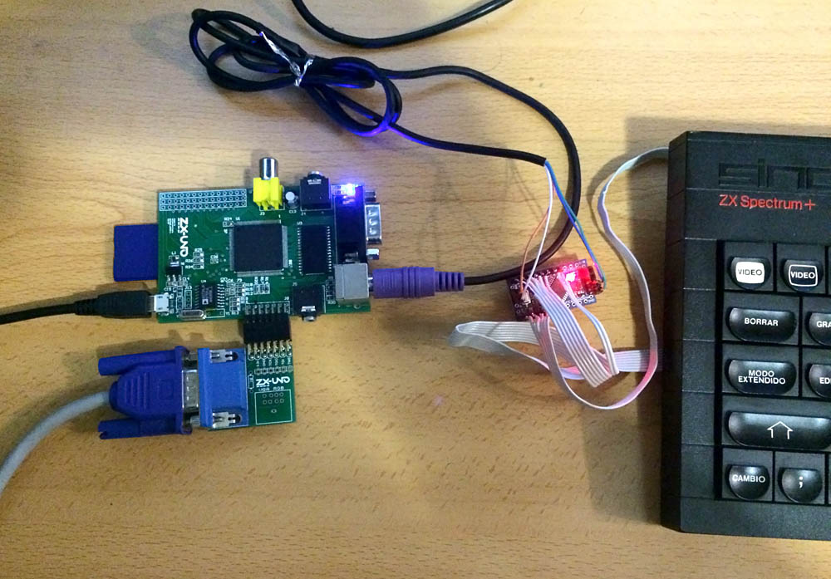
hardware/ps2arduino/fotos/zxunops2_y_plus_encendido.jpg
