nikiiv/zx-uno/hardware/ruta_de_datos_ulaplus.png

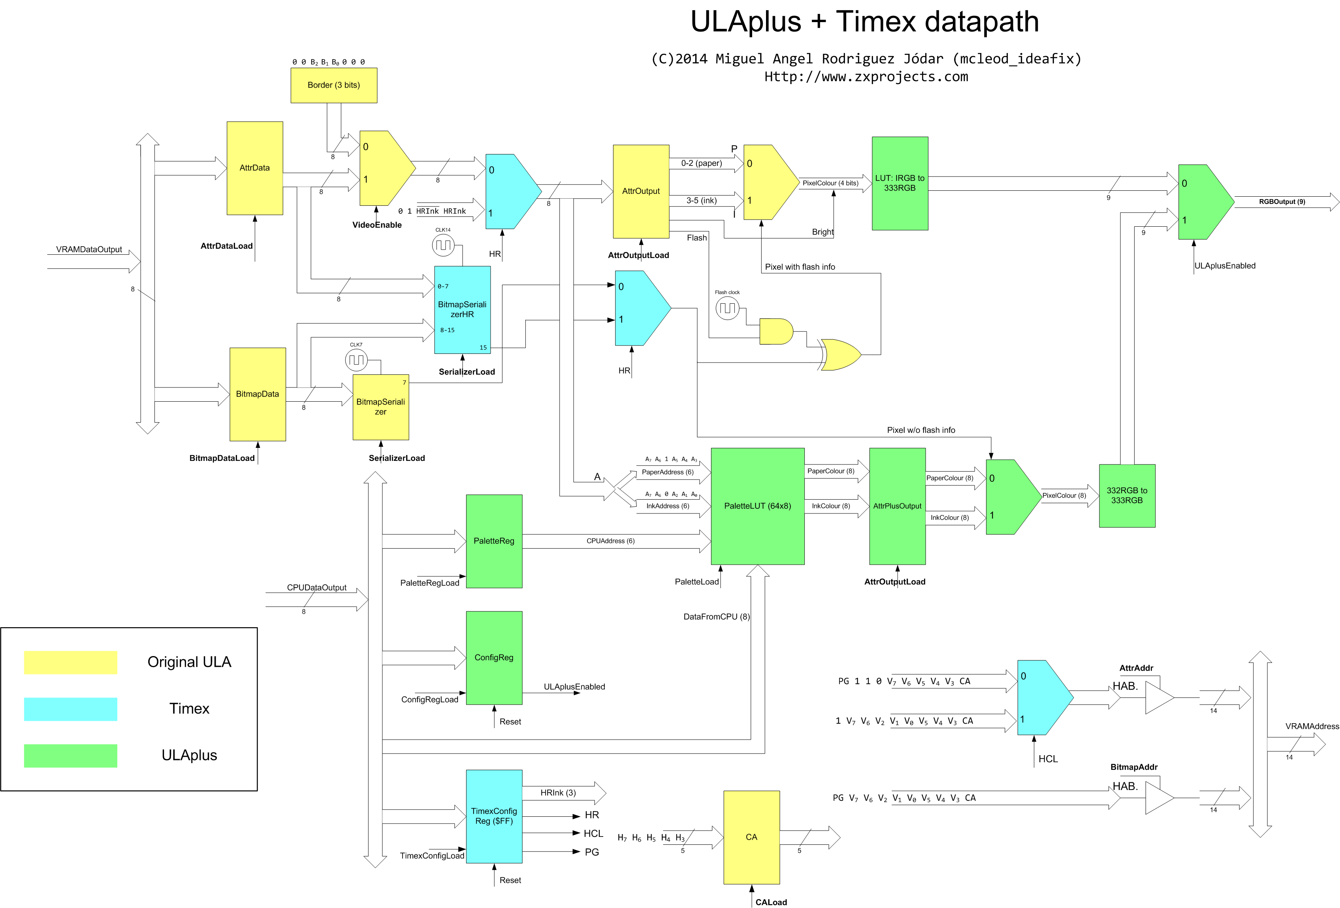
hardware/ruta_de_datos_ulaplus.png
