nikiiv/zx-uno/hardware/spectranet_lite_v2/Spectranet-schem.png

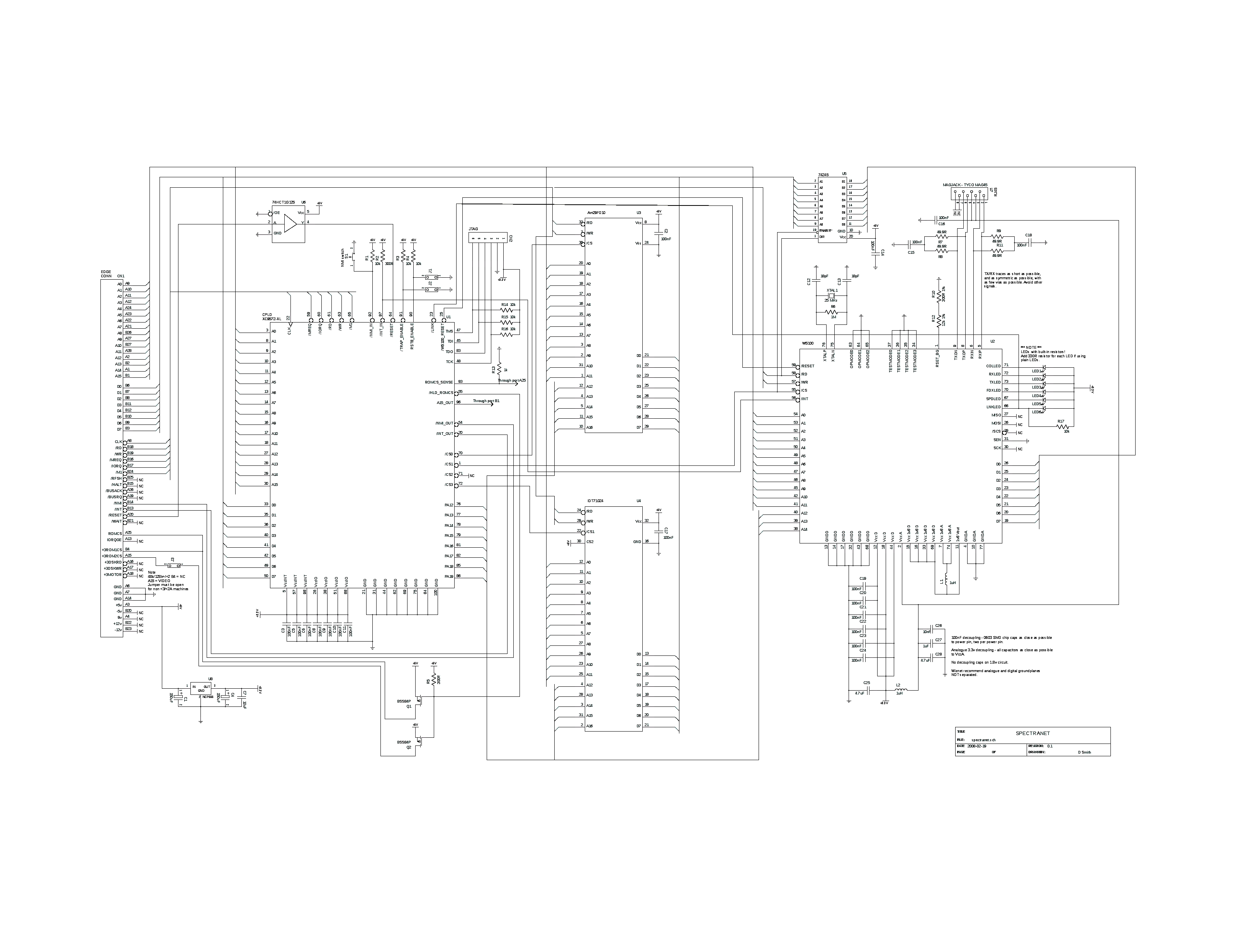
hardware/spectranet_lite_v2/Spectranet-schem.png
