nikiiv/zx-uno/hardware/zxuno/A+/A_verde_3D_joy_led.png

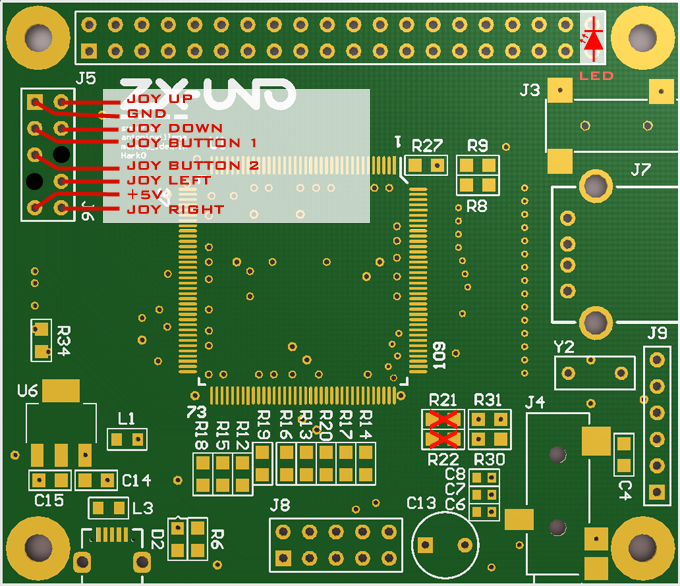
hardware/zxuno/A+/A_verde_3D_joy_led.png
