nikiiv/zx-uno/hardware/zxuno/A+/ZXUNO_A+_bot.jpg

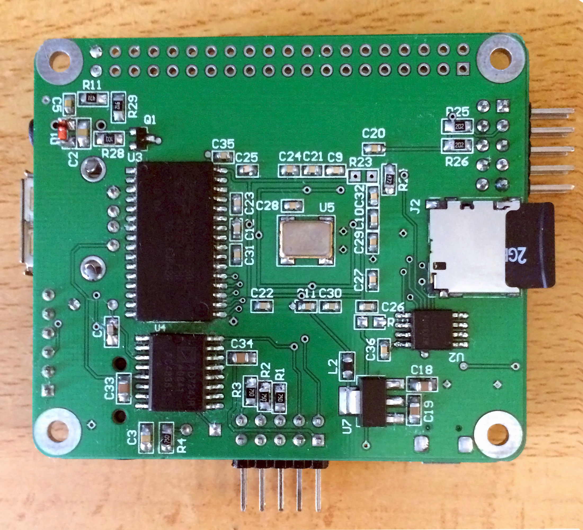
hardware/zxuno/A+/ZXUNO_A+_bot.jpg
