nikiiv/zx-uno/hardware/zxuno/A+/ZXUNO_A+_joy.jpg

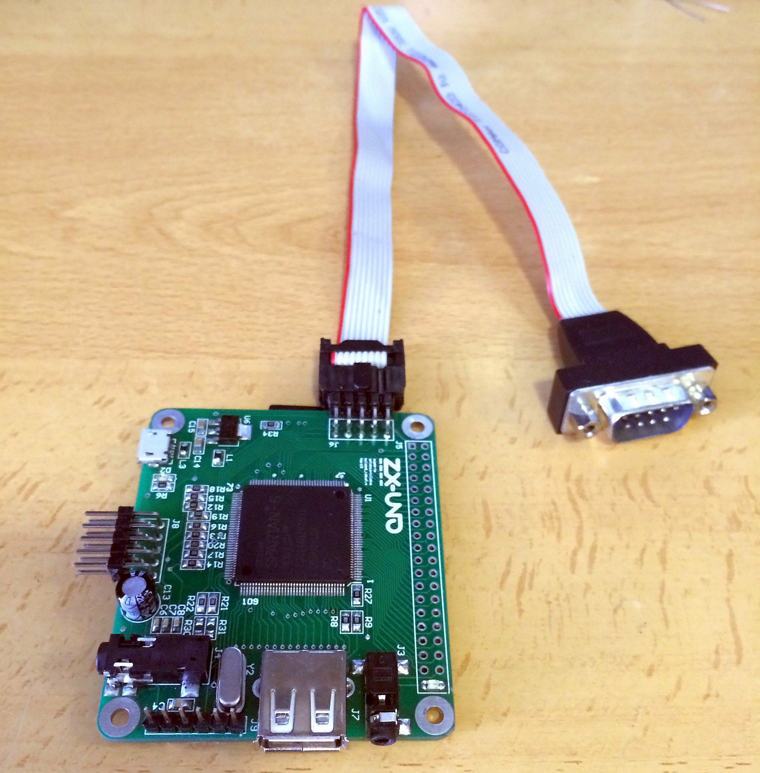
hardware/zxuno/A+/ZXUNO_A+_joy.jpg
