nikiiv/zx-uno/hardware/zxuno/A+/ZXUNO_A+_top.jpg

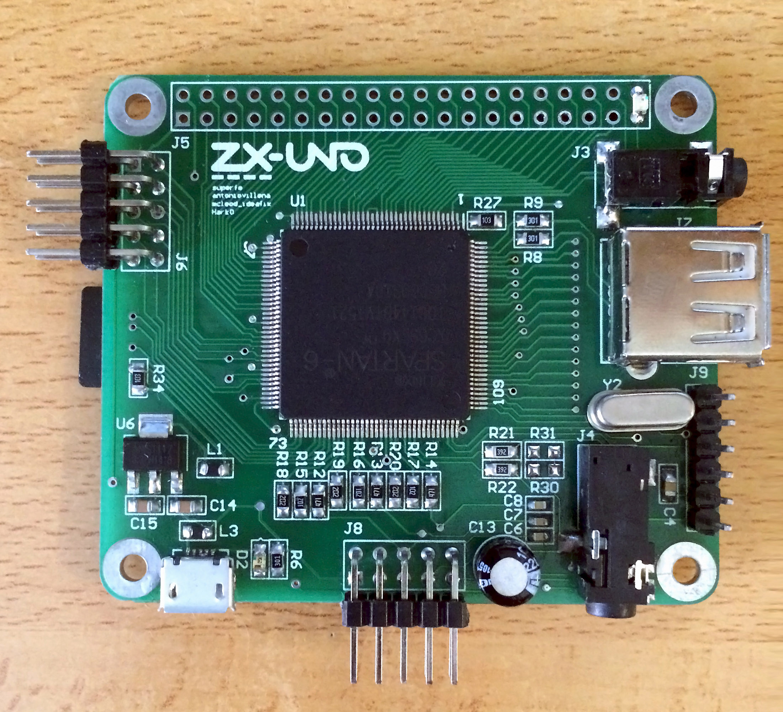
hardware/zxuno/A+/ZXUNO_A+_top.jpg
