nikiiv/zx-uno/hardware/zxuno/v4.1/zxuno_v41.png

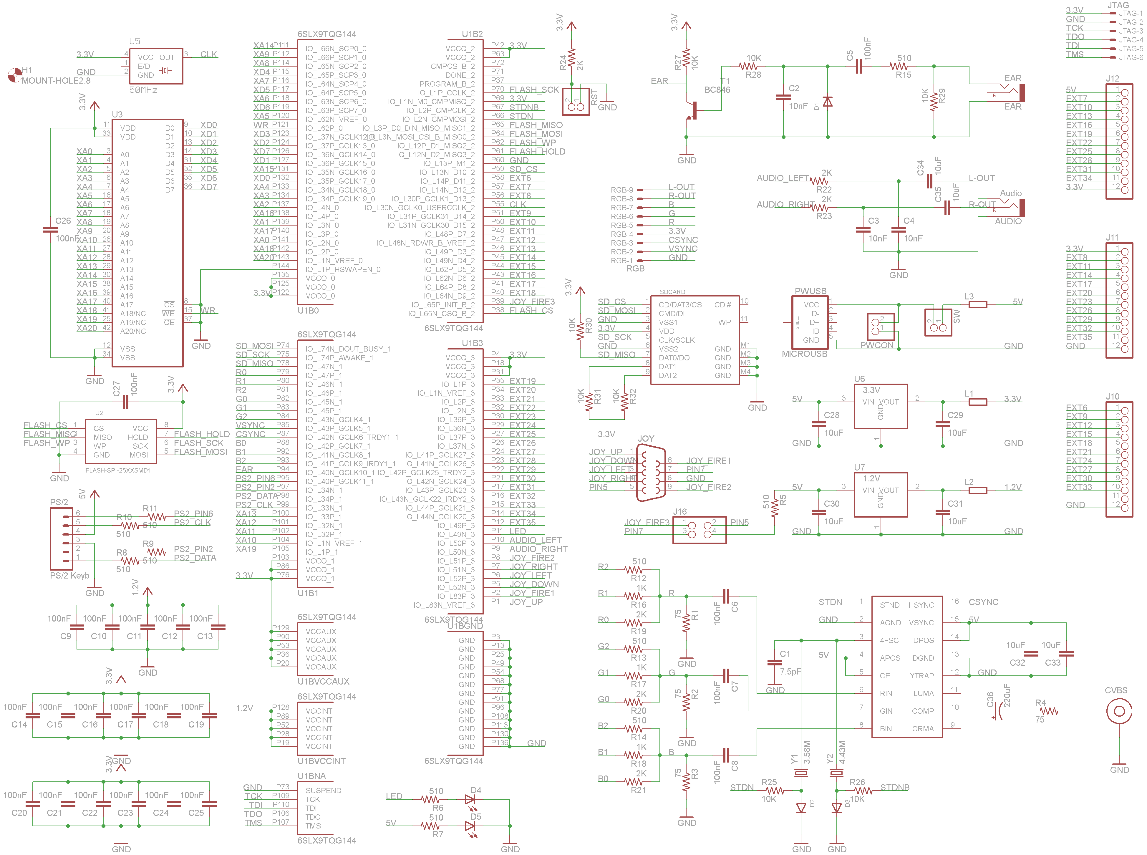
hardware/zxuno/v4.1/zxuno_v41.png
