nikiiv/zx-uno/software/genslideshow_512x384/2_colour_wave.png

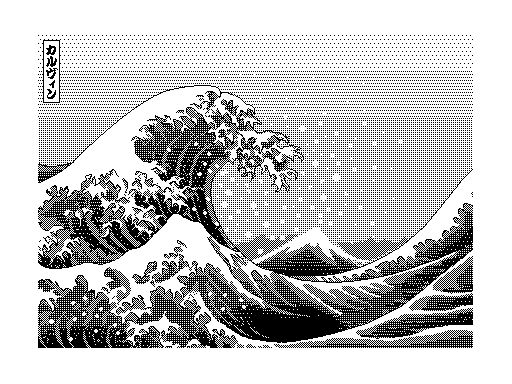
software/genslideshow_512x384/2_colour_wave.png
