nikiiv/zx-uno/software/genslideshow_512x384/army_of_trolls_-_Gary_J_Lucken_3b.png

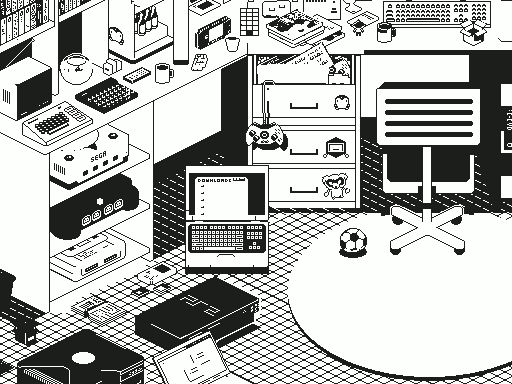
software/genslideshow_512x384/army_of_trolls_-_Gary_J_Lucken_3b.png
