nikiiv/zx-uno/software/genslideshow_512x384/chica.png

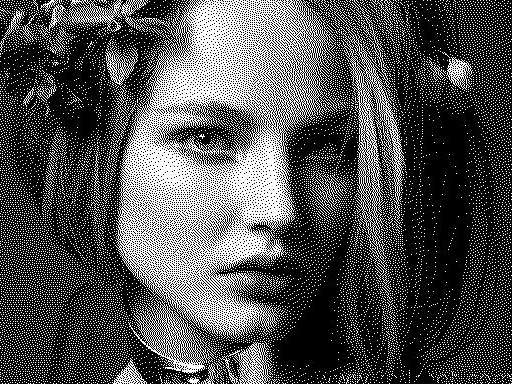
software/genslideshow_512x384/chica.png
