nikiiv/zx-uno/software/genslideshow_512x384/fig11-4.png

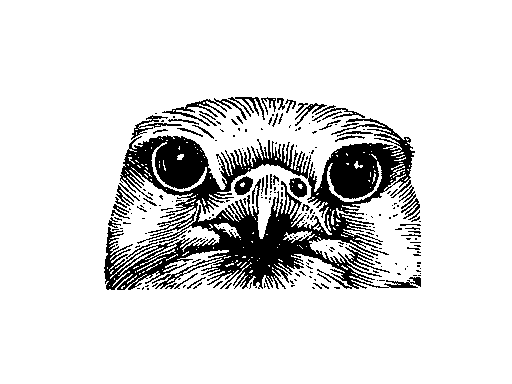
software/genslideshow_512x384/fig11-4.png
