nikiiv/zx-uno/software/genslideshow_512x384/horizontal_grid.png

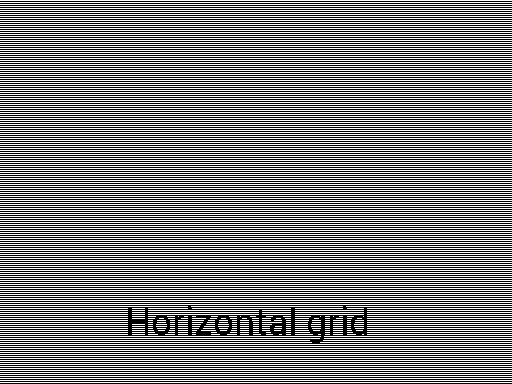
software/genslideshow_512x384/horizontal_grid.png
