nikiiv/zx-uno/software/genslideshow_512x384/japonesas_con_disquetes.png

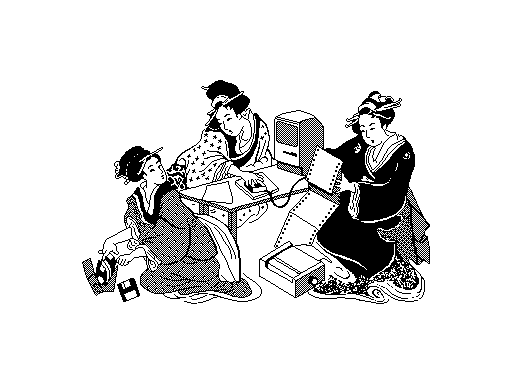
software/genslideshow_512x384/japonesas_con_disquetes.png
