nikiiv/zx-uno/software/genslideshow_512x384/letritas.png

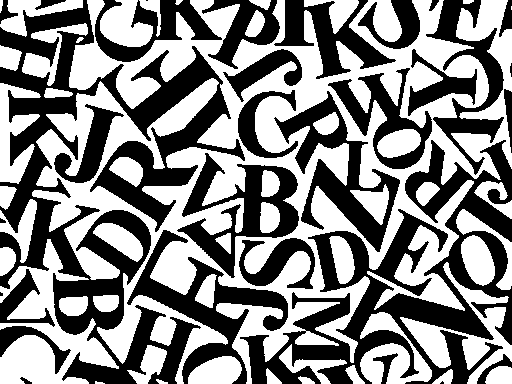
software/genslideshow_512x384/letritas.png
