nikiiv/zx-uno/software/genslideshow_512x384/LIVING_ROOM_FINAL.png

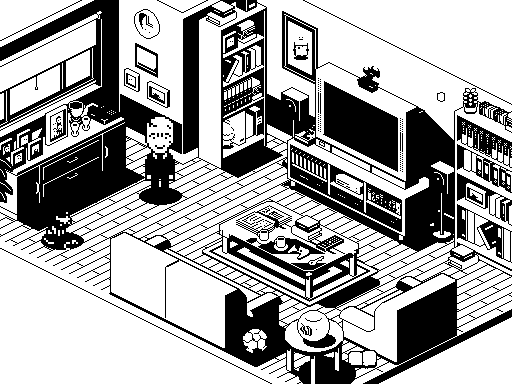
software/genslideshow_512x384/LIVING_ROOM_FINAL.png
