nikiiv/zx-uno/software/genslideshow_512x384/macpaint.png

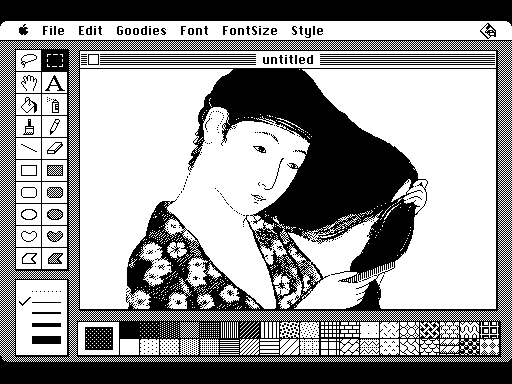
software/genslideshow_512x384/macpaint.png
