nikiiv/zx-uno/software/genslideshow_512x384/new_contest_entry.png

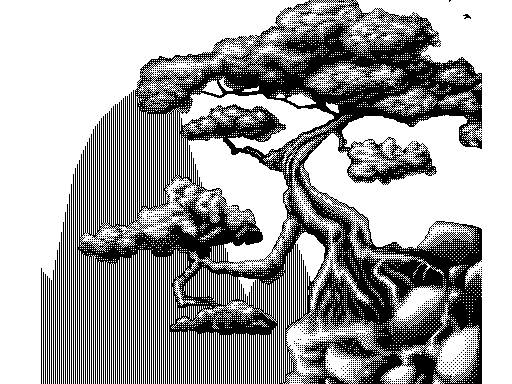
software/genslideshow_512x384/new_contest_entry.png
