nikiiv/zx-uno/software/genslideshow_512x384/paisaje_rio.png

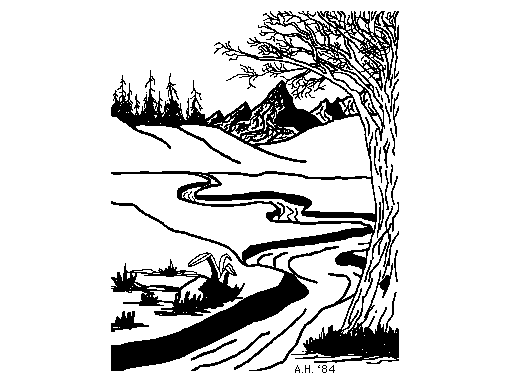
software/genslideshow_512x384/paisaje_rio.png
