nikiiv/zx-uno/software/genslideshow_512x384/pluma.png

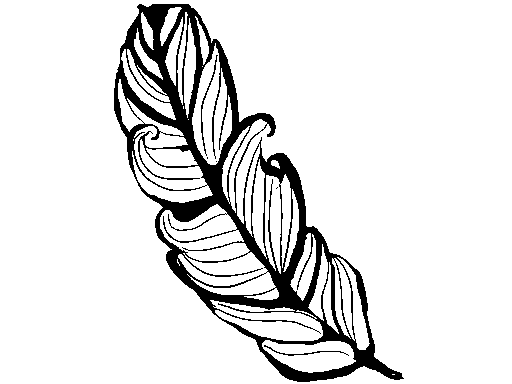
software/genslideshow_512x384/pluma.png
