nikiiv/zx-uno/software/genslideshow_512x384/retrato_bw_512_384.png

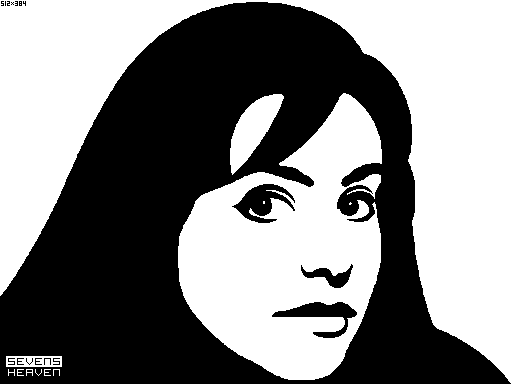
software/genslideshow_512x384/retrato_bw_512_384.png
