nikiiv/zx-uno/software/genslideshow_512x384/vertical_grid.png

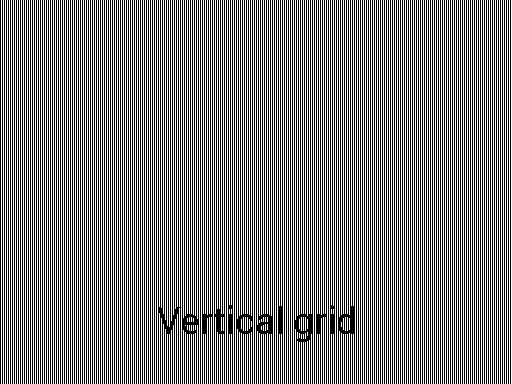
software/genslideshow_512x384/vertical_grid.png
