nikiiv/zx-uno/software/hungup_demo_turbosound/hungup_cover.png

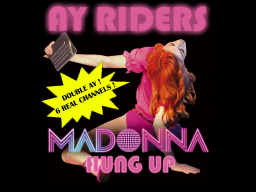
software/hungup_demo_turbosound/hungup_cover.png
