nikiiv/zx-uno/software/jupiter_ace/esquematico_jupiter_ace.png

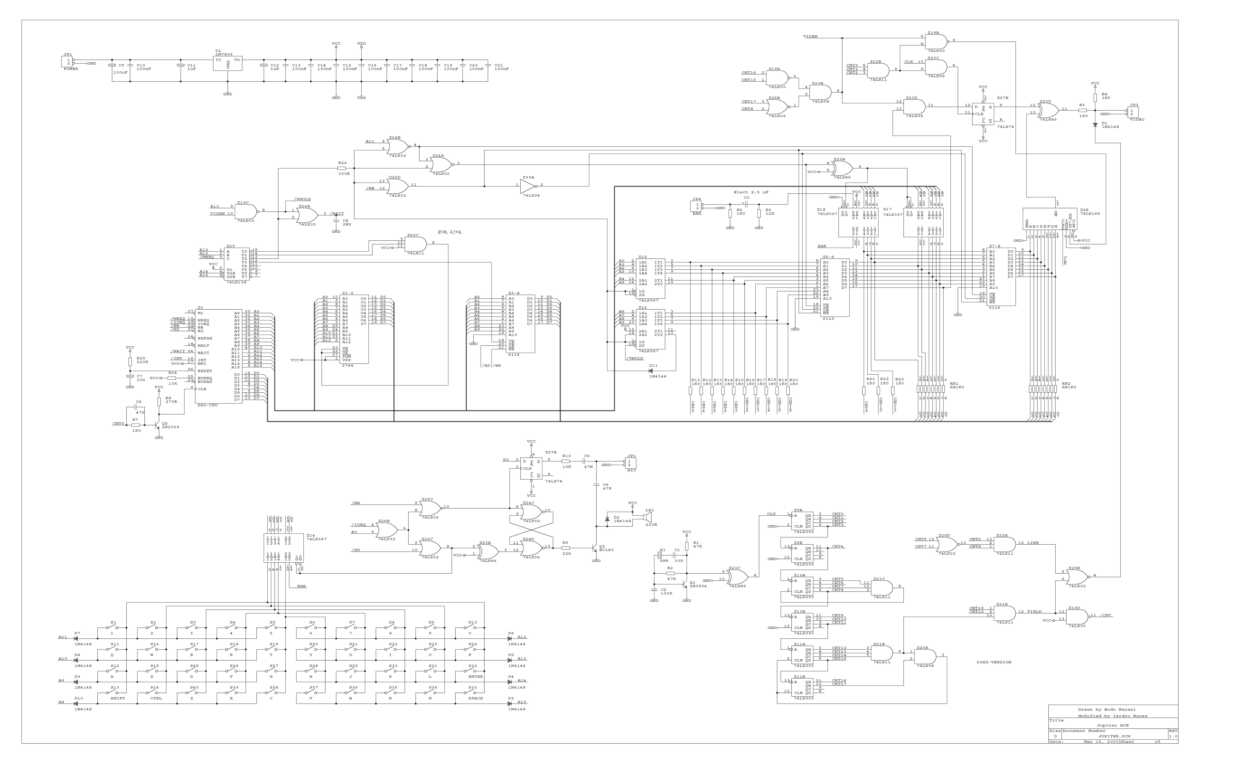
software/jupiter_ace/esquematico_jupiter_ace.png
