nikiiv/zx-uno/software/modo_radastan/hwscroll/clive152x214.bmp

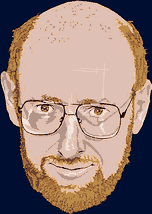
software/modo_radastan/hwscroll/clive152x214.bmp
