nikiiv/zx-uno/software/modo_radastan/hwscroll/foto128x512_inv.bmp

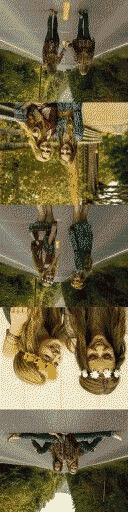
software/modo_radastan/hwscroll/foto128x512_inv.bmp
