nikiiv/zx-uno/software/modo_radastan/hwscroll/lena224x144.bmp

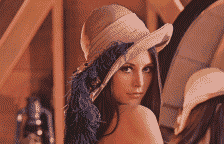
software/modo_radastan/hwscroll/lena224x144.bmp
