nikiiv/zx-uno/software/modo_radastan/hwscroll/lena256x128.bmp

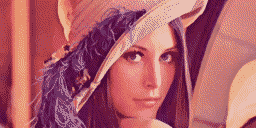
software/modo_radastan/hwscroll/lena256x128.bmp
