nikiiv/zx-uno/software/modo_radastan/hwscroll/pinball_dreams_3.bmp

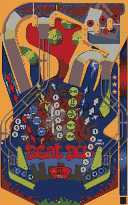
software/modo_radastan/hwscroll/pinball_dreams_3.bmp
