nikiiv/zx-uno/software/modo_radastan/hwscroll/pinball_dreams_4.bmp

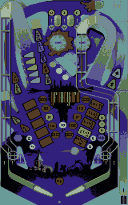
software/modo_radastan/hwscroll/pinball_dreams_4.bmp
