nikiiv/zx-uno/software/web/antigua/imagen/esquema.png

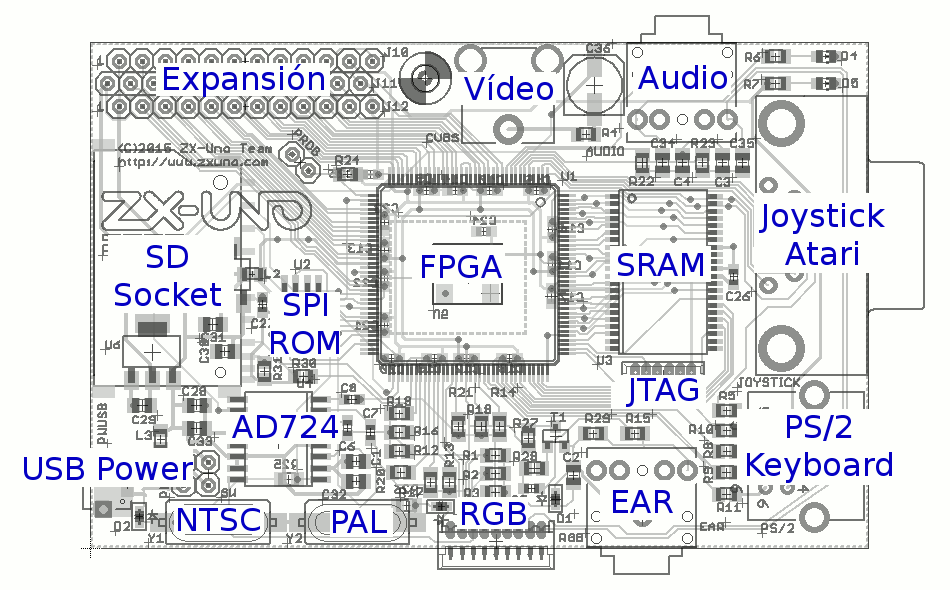
software/web/antigua/imagen/esquema.png
