nikiiv/zx-uno/software/web/antigua/imagen/foto1.jpg

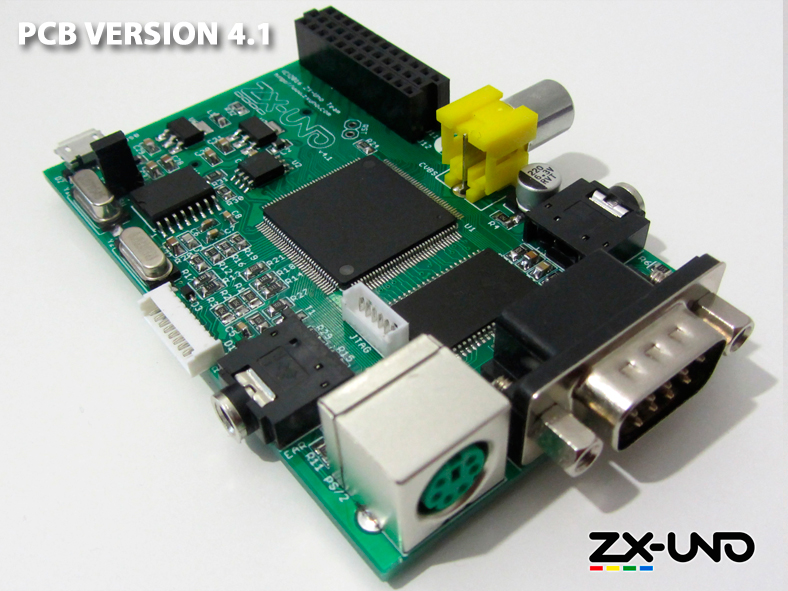
software/web/antigua/imagen/foto1.jpg
