nikiiv/zx-uno/varios/esp8266/conexionado_dentro_del_modulo.jpg

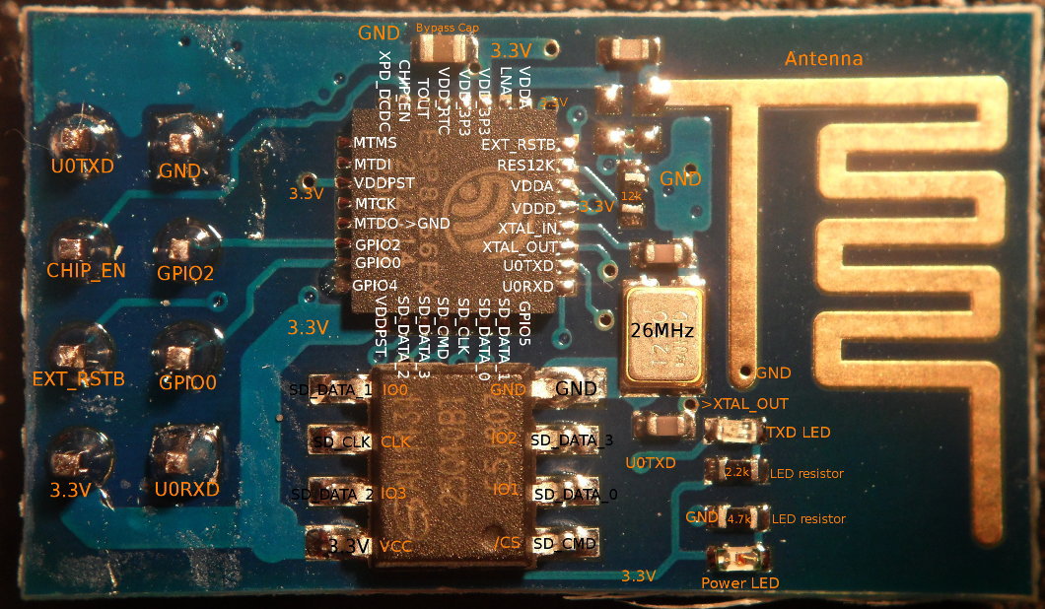
varios/esp8266/conexionado_dentro_del_modulo.jpg
