nikiiv/zx-uno/varios/esp8266/conexiones_plaquita_esp8266.png

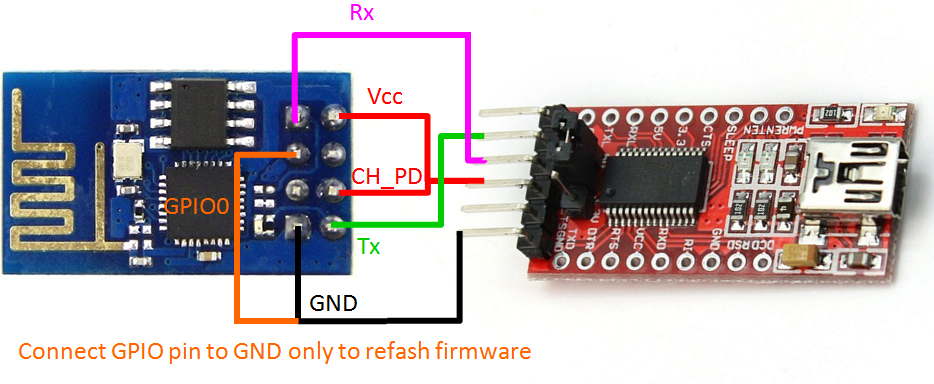
varios/esp8266/conexiones_plaquita_esp8266.png
