nikiiv/zx-uno/varios/esp8266/pinout_plaquita_esp8266.png

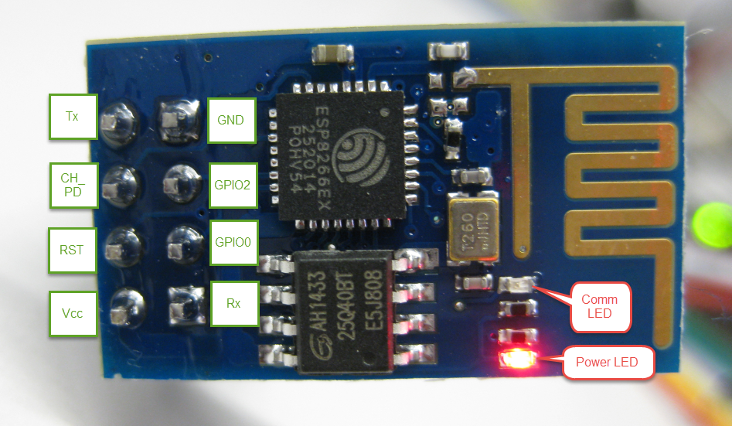
varios/esp8266/pinout_plaquita_esp8266.png
