nikiiv/zx-uno/varios/portada_retropixel_malaga.jpg

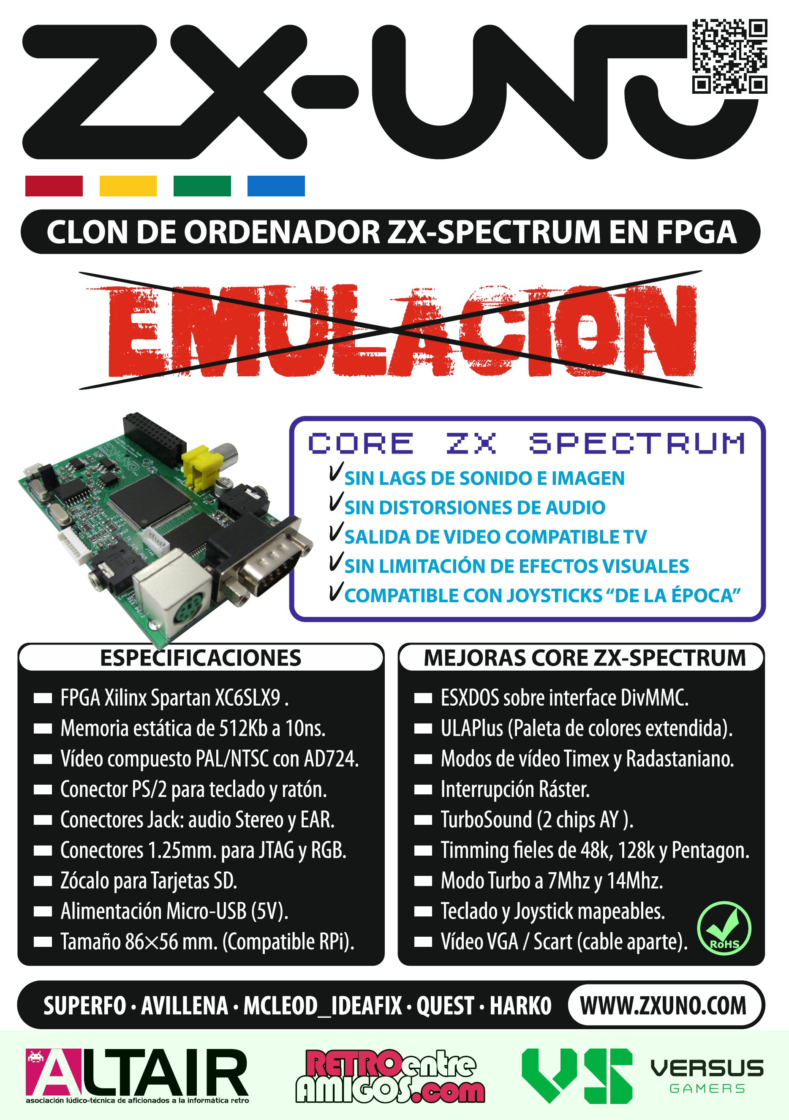
varios/portada_retropixel_malaga.jpg
