nikiiv/zx-uno/hardware/zxuno/A+/BOM.xls

ZX-UNO A+
Comment | Designator | Footprint | Quantity
10pF | C1 | SM/C_0805 | 1
10nF | C2, C3, C4 | SM/C_0805 | 3
100nF | C5, C6, C7, C8, C9, C10, C11, C12, C20, C21, C22, C23, C24, C25, C26, C27, C28, C29, C30, C31, C32, C35, C36 | SM/C_0603 | 23
220uF | C13 | CYL/D.250/LS.150/.031 | 1
4.7uF | C14, C15, C18, C19 | SM/C_0805 | 4
10uF | C33, C34 | SM/C_0805 | 2
1N4148 | D1 | SM/D_0805_21 | 1
LED | D2 | SM/D_0805_21 | 1
microUSB | J1 | MICRO USB | 1
MicroSD | J2 | SD HR1941CT-ND | 1
Phonejack2 TN | J3 | AUDIO JACK MJ-2523-SMT | 1
Phonejack4 | J4 | AUDIO JACK SJ-43514-SMT | 1
Header 20X2 | J5 | HDR2X20 | 1
Header 5X2 | J6, J8 | HDR2X5 | 2
USB | J7 | USB A | 1
Header 6 | J9 | HDR1X6 | 1
Inductor | L1, L2, L3 | SM/L_0805 | 3
BC846 | Q1 | SM/SOT23_231 | 1
75 | R1, R2, R3, R4 | SM/R_0805 | 4
300 | R6, R10 | SM/R_0805 | 2
270 | R8, R9 | SM/R_0805 | 2
470 | R11, R12, R13, R14 | SM/R_0805 | 4
1K | R15, R16, R17 | SM/R_0805 | 3
2K | R18, R19, R20, R25, R26 | SM/R_0805 | 5
3K9 | R21, R22 | SM/R_0805 | 2
4K7 | R23, R24 | SM/R_0805 | 2
10K | R27, R28, R29, R34 | SM/R_0805 | 4
0 | R30, R31 | SM/R_0805 | 2
XC6SLX9/TFP144_1 | U1 |  | 1
W25X40BV/W25Q80BV | U2 | SOJ.050/8/WB.300/L.200 | 1
CY62148EV30 | U3 |  | 1
AD724 | U4 | SOJ.050/16/WB.400/L.400 | 1
50MHz | U5 | SM/OSC | 1
ZLDO1117G33TA | U6 | SM/SOT223 | 1
ZLDO1117G12TA | U7 | SM/SOT223 | 1
4.43M | Y2 | RAD/.300X.125/LS.200/.031 | 1
