nikiiv/zx-uno/hardware/engendros_celes/Engendro_v1.5/Caja 3D/caja.stl

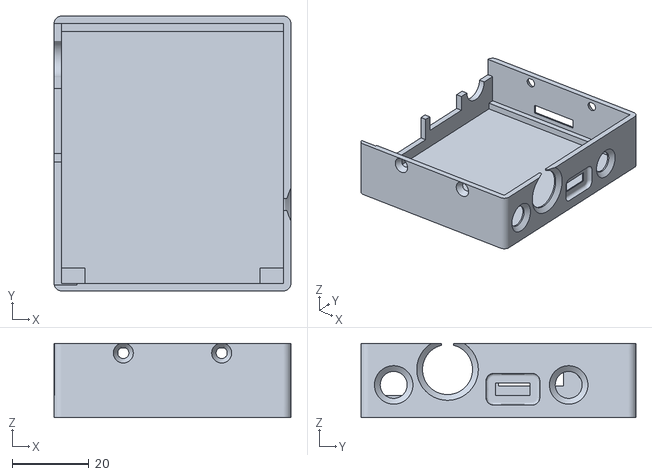
[picture p85: CAD file, 2019-06-25]
hardware/engendros_celes/Engendro_v1.5/Caja 3D/caja.stl
61.6 x 71.5 x 19.3
