nikiiv/zx-uno/hardware/engendros_celes/Engendro_v1.5/Caja 3D/tapa.stl

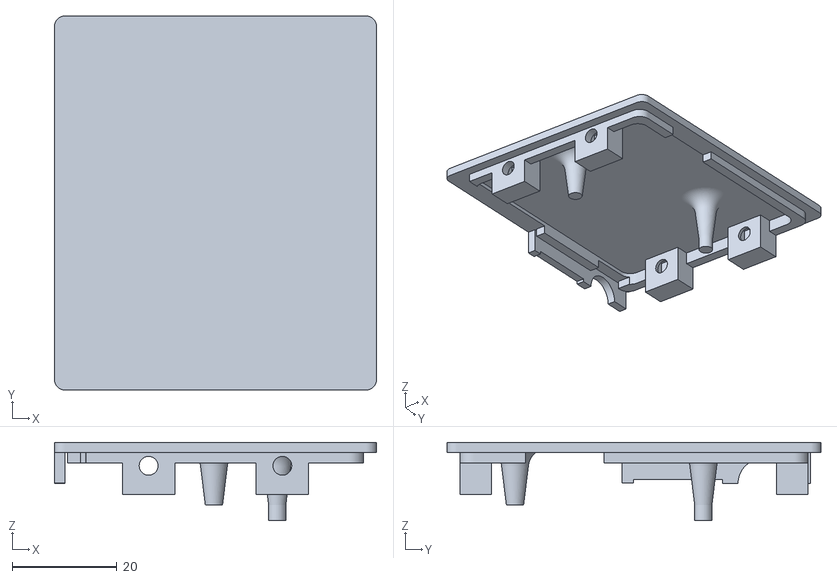
[picture p86: CAD file, 2019-06-25]
hardware/engendros_celes/Engendro_v1.5/Caja 3D/tapa.stl
61.6 x 71.5 x 15.0
