nikiiv/zx-uno/hardware/engendros_celes/Engendro_v1/Caja 3D/Caja y tapa engendro.stl

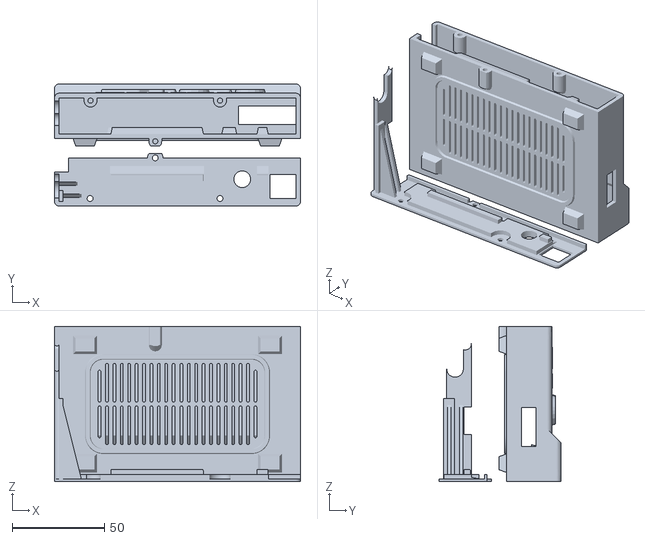
[picture p87: CAD file, 2019-06-25, an earlier design]
hardware/engendros_celes/Engendro_v1/Caja 3D/Caja y tapa engendro.stl
133.0 x 66.0 x 84.0
