nikiiv/zx-uno/(list of files, cad)

Other CAD files:
hardware/engendros_celes/Engendro_v1.5/Caja 3D/caja engendro v1.5.f3d
hardware/otros/comcon/comcon_version_mcleod.skp
