nikiiv/zx-uno/jepalza/test3_modo256/par_usage_statistics.html

Par Statistics

Total Non-vccgnd Signals=259

Total Non-vccgnd Design Pins=882

Total Non-vccgnd Conns=882

Total Non-vccgnd Timing Constrained Conns=615

Phase 1 CPU=3.5 sec

Phase 2 CPU=3.9 sec

Phase 3 CPU=4.3 sec

Phase 4 CPU=4.8 sec

Phase 5 CPU=5.0 sec

Phase 6 CPU=5.0 sec

Phase 7 CPU=5.0 sec

Phase 8 CPU=5.0 sec

Phase 9 CPU=5.1 sec

Phase 10 CPU=5.1 sec

AvgWirelenPerPin Fanout 1=4.0

AvgWirelenPerPin Fanout 2=1.5

AvgWirelenPerPin Fanout 3=2.0

AvgWirelenPerPin Fanout 4=5.5

AvgWirelenPerPin Fanout 10=5.2

AvgWirelenPerPin Fanout 50=1.9

AvgWirelenPerPin Fanout 100=0.0

AvgWirelenPerPin Fanout 500=0.0

AvgWirelenPerPin Fanout 5000=0.0

AvgWirelenPerPin Fanout 20000=0.0

AvgWirelenPerPin Fanout 50000=0.0

AvgWirelenPerPin Fanout 100000=0.0

IRR Gamma=1.1138
