nikiiv/zx-uno/jepalza/test3_modo256/usage_statistics_webtalk.html

### Device Usage Page (usage_statistics_webtalk.html)

This HTML page displays the device usage statistics that will be sent to Xilinx.

Software Version and Target Device
Product Version: | ISE:14.3 (WebPack) - P.40xd | Target Family: | Spartan6
OS Platform: | NT64 | Target Device: | xc6slx9
Project ID (random number) | 07c2e7e4a0334dcc8a35ee2dc0228279.B15E273DFF964BCBA29A244A2E74FAE3.3 | Target Package: | tqg144
Registration ID | 206146466_0_0_971 | Target Speed: | -3
Date Generated | 2014-11-29T19:50:27 | Tool Flow | ISE

User Environment
OS Name | Microsoft Windows 7 , 64-bit | OS Release | Service Pack 1 (build 7601)
CPU Name | Intel(R) Core(TM) i7-2670QM CPU @ 2.20GHz | CPU Speed | 2192 MHz
OS Name | Microsoft Windows 7 , 64-bit | OS Release | Service Pack 1 (build 7601)
CPU Name | Intel(R) Core(TM) i7-2670QM CPU @ 2.20GHz | CPU Speed | 2192 MHz

Device Usage Statistics
Macro Statistics | Miscellaneous Statistics | Net Statistics | Site Usage

Comparators=2

9-bit comparator greater=2

Counters=8

16-bit up counter=2

2-bit up counter=1

8-bit down counter=1

9-bit up counter=4

FSMs=1 Multiplexers=33

1-bit 2-to-1 multiplexer=18

19-bit 2-to-1 multiplexer=2

19-bit 8-to-1 multiplexer=1

3-bit 2-to-1 multiplexer=9

32-bit 2-to-1 multiplexer=1

8-bit 2-to-1 multiplexer=2

Registers=156

Flip-Flops=156

MiscellaneousStatistics

AGG_BONDED_IO=40

AGG_IO=40

AGG_LOCED_IO=40

AGG_SLICE=73

NUM_BONDED_IOB=40

NUM_BSFULL=83

NUM_BSLUTONLY=128

NUM_BSUSED=211

NUM_BUFG=4

NUM_BUFIO2=1

NUM_BUFIO2FB=1

NUM_DCM=1

NUM_ILOGIC2=8

NUM_IOB_FF=8

NUM_LOCED_IOB=40

NUM_LOGIC_O5ANDO6=22

NUM_LOGIC_O5ONLY=56

NUM_LOGIC_O6ONLY=122

NUM_LUT_RT_DRIVES_CARRY4=6

NUM_LUT_RT_EXO6=6

NUM_LUT_RT_O6=56

NUM_SLICEL=22

NUM_SLICEM=2

NUM_SLICEX=49

NUM_SLICE_CARRY4=22

NUM_SLICE_CONTROLSET=10

NUM_SLICE_CYINIT=295

NUM_SLICE_FF=85

NUM_SLICE_UNUSEDCTRL=43

NUM_SRL_O6ONLY=5

NUM_UNUSABLE_FF_BELS=30

NetStatistics

NumNets_Active=299

NumNets_Gnd=1

NumNets_Vcc=1

NumNodesOfType_Active_BOUNCEACROSS=5

NumNodesOfType_Active_BOUNCEIN=43

NumNodesOfType_Active_BUFGOUT=4

NumNodesOfType_Active_BUFHINP2OUT=9

NumNodesOfType_Active_BUFIOINP=2

NumNodesOfType_Active_CLKPIN=30

NumNodesOfType_Active_CLKPINFEED=25

NumNodesOfType_Active_CNTRLPIN=36

NumNodesOfType_Active_DOUBLE=292

NumNodesOfType_Active_GENERIC=68

NumNodesOfType_Active_GLOBAL=48

NumNodesOfType_Active_INPUT=21

NumNodesOfType_Active_IOBIN2OUT=61

NumNodesOfType_Active_IOBOUTPUT=53

NumNodesOfType_Active_LUTINPUT=730

NumNodesOfType_Active_OUTBOUND=240

NumNodesOfType_Active_OUTPUT=257

NumNodesOfType_Active_PADINPUT=43

NumNodesOfType_Active_PADOUTPUT=9

NumNodesOfType_Active_PINBOUNCE=109

NumNodesOfType_Active_PINFEED=841

NumNodesOfType_Active_PINFEED2=9

NumNodesOfType_Active_QUAD=198

NumNodesOfType_Active_REGINPUT=4

NumNodesOfType_Active_SINGLE=415

NumNodesOfType_Gnd_BOUNCEIN=1

NumNodesOfType_Gnd_CLKPIN=1

NumNodesOfType_Gnd_CNTRLPIN=3

NumNodesOfType_Gnd_DOUBLE=2

NumNodesOfType_Gnd_GENERIC=3

NumNodesOfType_Gnd_HGNDOUT=2

NumNodesOfType_Gnd_IOBIN2OUT=3

NumNodesOfType_Gnd_IOBOUTPUT=3

NumNodesOfType_Gnd_LUTINPUT=2

NumNodesOfType_Gnd_OUTBOUND=2

NumNodesOfType_Gnd_OUTPUT=2

NumNodesOfType_Gnd_PADINPUT=3

NumNodesOfType_Gnd_PINBOUNCE=1

NumNodesOfType_Gnd_PINFEED=9

NumNodesOfType_Gnd_SINGLE=3

NumNodesOfType_Vcc_GENERIC=1

NumNodesOfType_Vcc_HVCCOUT=24

NumNodesOfType_Vcc_IOBIN2OUT=1

NumNodesOfType_Vcc_IOBOUTPUT=1

NumNodesOfType_Vcc_KVCCOUT=2

NumNodesOfType_Vcc_LUTINPUT=106

NumNodesOfType_Vcc_PADINPUT=1

NumNodesOfType_Vcc_PINFEED=107

SiteStatistics

BUFG-BUFGMUX=4

IOB-IOBM=18

IOB-IOBS=22

SLICEL-SLICEM=6

SLICEX-SLICEL=10

SLICEX-SLICEM=12

SiteSummary

BUFG=4

BUFG_BUFG=4

BUFIO2=1

BUFIO2FB=1

BUFIO2FB_BUFIO2FB=1

BUFIO2_BUFIO2=1

CARRY4=22

DCM=1

DCM_DCM=1

FF_SR=3

HARD0=14

ILOGIC2=8

ILOGIC2_IFF=8

IOB=40

IOB_IMUX=9

IOB_INBUF=9

IOB_OUTBUF=39

LUT5=78

LUT6=206

LUT_OR_MEM6=5

PAD=40

REG_SR=82

SELMUX2_1=8

SLICEL=22

SLICEM=2

SLICEX=49

Configuration Data

BUFIO2FB_BUFIO2FB

DIVIDE_BYPASS=[TRUE:1]

INVERT_INPUTS=[FALSE:1]

BUFIO2_BUFIO2

DIVIDE=[1:1]

DIVIDE_BYPASS=[TRUE:1]

I_INVERT=[FALSE:1]

DCM

PSCLK=[PSCLK_INV:0] [PSCLK:1]

PSEN=[PSEN_INV:0] [PSEN:1]

PSINCDEC=[PSINCDEC:1] [PSINCDEC_INV:0]

RST=[RST:1] [RST_INV:0]

DCM_DCM

CLKDV_DIVIDE=[10.0:1]

CLKIN_DIVIDE_BY_2=[FALSE:1]

CLKOUT_PHASE_SHIFT=[NONE:1]

CLK_FEEDBACK=[1X:1]

DESKEW_ADJUST=[5:1]

DFS_FREQUENCY_MODE=[LOW:1]

DLL_FREQUENCY_MODE=[LOW:1]

DSS_MODE=[NONE:1]

DUTY_CYCLE_CORRECTION=[TRUE:1]

PSCLK=[PSCLK_INV:0] [PSCLK:1]

PSEN=[PSEN_INV:0] [PSEN:1]

PSINCDEC=[PSINCDEC:1] [PSINCDEC_INV:0]

RST=[RST:1] [RST_INV:0]

STARTUP_WAIT=[FALSE:1]

VERY_HIGH_FREQUENCY=[FALSE:1]

FF_SR

CK=[CK:3] [CK_INV:0]

SRINIT=[SRINIT0:1] [SRINIT1:2]

SYNC_ATTR=[ASYNC:2] [SYNC:1]

ILOGIC2

CLK0=[CLK0_INV:0] [CLK0:8]

ILOGIC2_IFF

CLK0=[CLK0_INV:0] [CLK0:8]

IFFTYPE=[FF:8]

SRINIT_Q=[0:8]

IOB_OUTBUF

DRIVEATTRBOX=[12:39]

SLEW=[SLOW:39]

SUSPEND=[3STATE:39]

LUT_OR_MEM6

CLK=[CLK:5] [CLK_INV:0]

LUT_OR_MEM=[RAM:5]

RAMMODE=[SRL32:5]

REG_SR

CK=[CK:82] [CK_INV:0]

LATCH_OR_FF=[FF:82]

SRINIT=[SRINIT0:70] [SRINIT1:12]

SYNC_ATTR=[ASYNC:48] [SYNC:34]

SLICEL

CLK=[CLK:17] [CLK_INV:0]

SLICEM

CLK=[CLK:2] [CLK_INV:0]

SLICEX

CLK=[CLK:11] [CLK_INV:0]

Pin Data
BUFG I0=4 O=4 BUFG_BUFG I0=4 O=4 BUFIO2 DIVCLK=1 I=1 BUFIO2FB I=1 O=1 BUFIO2FB_BUFIO2FB I=1 O=1 BUFIO2_BUFIO2 DIVCLK=1 I=1 CARRY4 CIN=15 CO3=15 CYINIT=7 DI0=18 DI1=18 DI2=18 DI3=15 O0=22 O1=18 O2=18 O3=18 S0=22 S1=18 S2=18 S3=18 DCM CLK0=1 CLKDV=1 CLKFB=1 CLKFX=1 CLKIN=1 PSCLK=1 PSEN=1 PSINCDEC=1 RST=1 DCM_DCM CLK0=1 CLKDV=1 CLKFB=1 CLKFX=1 CLKIN=1 PSCLK=1 PSEN=1 PSINCDEC=1 RST=1 FF_SR CK=3 D=3 Q=3 SR=1 HARD0 0=14 | ILOGIC2 CE0=8 CLK0=8 D=8 Q4=8 ILOGIC2_IFF CE0=8 CLK0=8 D=8 Q1=8 IOB I=9 O=39 PAD=40 T=8 IOB_IMUX I=9 OUT=9 IOB_INBUF OUT=9 PAD=9 IOB_OUTBUF IN=39 OUT=39 TRI=8 LUT5 A1=4 A2=6 A3=9 A4=5 A5=6 O5=78 LUT6 A1=61 A2=89 A3=112 A4=181 A5=151 A6=201 O6=206 LUT_OR_MEM6 A1=5 A2=5 A3=5 A4=5 A5=5 A6=5 CLK=5 DI1=5 MC31=4 O6=1 WE=5 PAD PAD=40 REG_SR CE=50 CK=82 D=82 Q=82 SR=34 SELMUX2_1 0=8 OUT=8 S0=8 | SLICEL A4=17 A5=5 A6=20 AMUX=5 AQ=17 AX=1 B4=15 B5=5 B6=18 BMUX=3 BQ=15 C4=13 C5=7 C6=18 CE=12 CIN=15 CLK=17 CMUX=5 COUT=15 CQ=13 D=1 D1=1 D2=1 D3=1 D4=14 D5=7 D6=17 DMUX=5 DQ=13 SR=11 SLICEM A1=2 A2=2 A3=2 A4=2 A5=2 A6=2 AQ=1 AX=1 B1=1 B2=1 B3=1 B4=1 B5=1 B6=1 C1=1 C2=1 C3=1 C4=1 C5=1 C6=1 CE=2 CLK=2 D1=1 D2=1 D3=1 D4=1 D5=1 D6=1 DMUX=1 DX=1 | SLICEX A=28 A1=20 A2=29 A3=36 A4=37 A5=37 A6=37 AMUX=2 AQ=10 B=23 B1=14 B2=21 B3=24 B4=25 B5=27 B6=27 BMUX=1 BQ=5 BX=1 C=21 C1=12 C2=15 C3=22 C4=23 C5=26 C6=27 CE=2 CLK=11 CMUX=2 CQ=6 D=35 D1=18 D2=27 D3=34 D4=37 D5=37 D6=37 DMUX=4 DQ=2 SR=1

Tool Usage

Command Line History

xst -intstyle ise -ifn <ise_file>

xst -intstyle ise -ifn <ise_file>

ngdbuild -intstyle ise -dd _ngo -nt timestamp -uc <fname>.ucf -p xc6slx9-tqg144-3 <fname>.ngc <fname>.ngd

map -intstyle ise -p xc6slx9-tqg144-3 -w -logic_opt off -ol high -t 1 -xt 0 -register_duplication off -r 4 -global_opt off -mt off -ir off -pr off -lc off -power off -o <fname>.ncd <fname>.ngd <fname>.pcf

par -w -intstyle ise -ol high -mt off <fname>.ncd <fname>.ncd <fname>.pcf

trce -intstyle ise -v 3 -s 3 -n 3 -fastpaths -xml <fname>.twx <fname>.ncd -o <fname>.twr <fname>.pcf -ucf <fname>.ucf

bitgen -intstyle ise -f <fname>.ut <fname>.ncd

xst -intstyle ise -ifn <ise_file>

xst -intstyle ise -ifn <ise_file>

ngdbuild -intstyle ise -dd _ngo -nt timestamp -uc <fname>.ucf -p xc6slx9-tqg144-3 <fname>.ngc <fname>.ngd

map -intstyle ise -p xc6slx9-tqg144-3 -w -logic_opt off -ol high -t 1 -xt 0 -register_duplication off -r 4 -global_opt off -mt off -ir off -pr off -lc off -power off -o <fname>.ncd <fname>.ngd <fname>.pcf

par -w -intstyle ise -ol high -mt off <fname>.ncd <fname>.ncd <fname>.pcf

trce -intstyle ise -v 3 -s 3 -n 3 -fastpaths -xml <fname>.twx <fname>.ncd -o <fname>.twr <fname>.pcf -ucf <fname>.ucf

bitgen -intstyle ise -f <fname>.ut <fname>.ncd

xst -intstyle ise -ifn <ise_file>

ngdbuild -intstyle ise -dd _ngo -nt timestamp -uc <fname>.ucf -p xc6slx9-tqg144-3 <fname>.ngc <fname>.ngd

map -intstyle ise -p xc6slx9-tqg144-3 -w -logic_opt off -ol high -t 1 -xt 0 -register_duplication off -r 4 -global_opt off -mt off -ir off -pr off -lc off -power off -o <fname>.ncd <fname>.ngd <fname>.pcf

par -w -intstyle ise -ol high -mt off <fname>.ncd <fname>.ncd <fname>.pcf

trce -intstyle ise -v 3 -s 3 -n 3 -fastpaths -xml <fname>.twx <fname>.ncd -o <fname>.twr <fname>.pcf -ucf <fname>.ucf

bitgen -intstyle ise -f <fname>.ut <fname>.ncd

Software Quality
Run Statistics
Program Name | Runs Started | Runs Finished | Errors | Fatal Errors | Internal Errors | Exceptions | Core Dumps
_impact | 40 | 24 | 0 | 0 | 0 | 0 | 0
arwz | 21 | 20 | 0 | 0 | 0 | 0 | 0
bitgen | 454 | 451 | 0 | 0 | 0 | 0 | 0
cse_server | 1 | 1 | 0 | 0 | 0 | 0 | 0
edif2ngd | 1 | 1 | 0 | 0 | 0 | 0 | 0
ibiswriter | 1 | 1 | 0 | 0 | 0 | 0 | 0
map | 500 | 459 | 0 | 0 | 0 | 0 | 0
netgen | 2 | 2 | 0 | 0 | 0 | 0 | 0
ngcbuild | 9 | 9 | 0 | 0 | 0 | 0 | 0
ngdbuild | 617 | 616 | 0 | 0 | 0 | 0 | 0
obngc | 1 | 1 | 0 | 0 | 0 | 0 | 0
par | 459 | 458 | 0 | 0 | 0 | 0 | 0
trce | 456 | 456 | 0 | 0 | 0 | 0 | 0
xst | 1077 | 1058 | 0 | 0 | 0 | 0 | 0

Help Statistics
Help files
/doc/usenglish/isehelp/ite_c_overview.htm ( 2 ) | /doc/usenglish/isehelp/pn_db_design_properties.htm ( 1 )

/doc/usenglish/wizards/arwz/awz_db_dcmclkbuf.htm ( 1 )

Project Statistics
PROP_Enable_Message_Filtering=false | PROP_FitterReportFormat=HTML
PROP_LastAppliedGoal=Balanced | PROP_LastAppliedStrategy=Xilinx Default (unlocked)
PROP_ManualCompileOrderImp=false | PROP_PropSpecInProjFile=Store all values
PROP_Simulator=ISim (VHDL/Verilog) | PROP_SynthTopFile=changed
PROP_Top_Level_Module_Type=HDL | PROP_UseSmartGuide=false
PROP_UserConstraintEditorPreference=Text Editor | PROP_intProjectCreationTimestamp=2014-02-06T02:27:35
PROP_intWbtProjectID=B15E273DFF964BCBA29A244A2E74FAE3 | PROP_intWbtProjectIteration=3
PROP_intWorkingDirLocWRTProjDir=Same | PROP_intWorkingDirUsed=No
PROP_lockPinsUcfFile=changed | PROPEXT_mapTimingMode_spartan6=Non Timing Driven
PROP_AutoTop=true | PROP_DevFamily=Spartan6
PROP_DevDevice=xc6slx9 | PROP_DevFamilyPMName=spartan6
PROP_DevPackage=tqg144 | PROP_Synthesis_Tool=XST (VHDL/Verilog)
PROP_DevSpeed=-3 | PROP_PreferredLanguage=Verilog
FILE_UCF=1 | FILE_VERILOG=4

FILE_XAW=1

Unisim Statistics
XST_UNISIM_SUMMARY
XST_NUM_BUFG=1 | XST_NUM_IBUFG=1
NGDBUILD_PRE_UNISIM_SUMMARY
NGDBUILD_NUM_BUFG=4 | NGDBUILD_NUM_DCM_SP=1 | NGDBUILD_NUM_FD=20 | NGDBUILD_NUM_FDE=38
NGDBUILD_NUM_FDR=15 | NGDBUILD_NUM_FDRE=20 | NGDBUILD_NUM_GND=1 | NGDBUILD_NUM_IBUFG=1
NGDBUILD_NUM_INV=8 | NGDBUILD_NUM_IOBUF=8 | NGDBUILD_NUM_LUT1=62 | NGDBUILD_NUM_LUT2=14
NGDBUILD_NUM_LUT3=17 | NGDBUILD_NUM_LUT4=25 | NGDBUILD_NUM_LUT5=28 | NGDBUILD_NUM_LUT6=61
NGDBUILD_NUM_MUXCY=69 | NGDBUILD_NUM_OBUF=31 | NGDBUILD_NUM_SRLC32E=5 | NGDBUILD_NUM_VCC=1

NGDBUILD_NUM_XORCY=76
NGDBUILD_POST_UNISIM_SUMMARY
NGDBUILD_NUM_BUFG=4 | NGDBUILD_NUM_DCM_SP=1 | NGDBUILD_NUM_FD=20 | NGDBUILD_NUM_FDE=38
NGDBUILD_NUM_FDR=15 | NGDBUILD_NUM_FDRE=20 | NGDBUILD_NUM_GND=1 | NGDBUILD_NUM_IBUF=8
NGDBUILD_NUM_IBUFG=1 | NGDBUILD_NUM_INV=8 | NGDBUILD_NUM_LUT1=62 | NGDBUILD_NUM_LUT2=14
NGDBUILD_NUM_LUT3=17 | NGDBUILD_NUM_LUT4=25 | NGDBUILD_NUM_LUT5=28 | NGDBUILD_NUM_LUT6=61
NGDBUILD_NUM_MUXCY=69 | NGDBUILD_NUM_OBUF=31 | NGDBUILD_NUM_OBUFT=8 | NGDBUILD_NUM_SRLC32E=5
NGDBUILD_NUM_VCC=1 | NGDBUILD_NUM_XORCY=76

XST Command Line Options
XST_OPTION_SUMMARY
-ifn=<fname>.prj | -ofn=<design_top> | -ofmt=NGC | -p=xc6slx9-3-tqg144
-top=<design_top> | -opt_mode=Speed | -opt_level=1 | -power=NO
-iuc=NO | -keep_hierarchy=No | -netlist_hierarchy=As_Optimized | -rtlview=Yes
-glob_opt=AllClockNets | -read_cores=YES | -write_timing_constraints=NO | -cross_clock_analysis=NO
-bus_delimiter=<> | -slice_utilization_ratio=100 | -bram_utilization_ratio=100 | -dsp_utilization_ratio=100
-reduce_control_sets=Auto | -fsm_extract=YES | -fsm_encoding=Auto | -safe_implementation=No
-fsm_style=LUT | -ram_extract=Yes | -ram_style=Auto | -rom_extract=Yes
-shreg_extract=YES | -rom_style=Auto | -auto_bram_packing=NO | -resource_sharing=YES
-async_to_sync=NO | -use_dsp48=Auto | -iobuf=YES | -max_fanout=100000
-bufg=16 | -register_duplication=YES | -register_balancing=No | -optimize_primitives=NO
-use_clock_enable=Auto | -use_sync_set=Auto | -use_sync_reset=Auto | -iob=Auto
-equivalent_register_removal=YES | -slice_utilization_ratio_maxmargin=5
