nikiiv/zx-uno/jepalza/test9_Spectrum_basico/par_usage_statistics.html

Par Statistics

Total Non-vccgnd Signals=2740

Total Non-vccgnd Design Pins=12072

Total Non-vccgnd Conns=12072

Total Non-vccgnd Timing Constrained Conns=10603

Phase 1 CPU=4.5 sec

Phase 2 CPU=5.1 sec

Phase 3 CPU=10.0 sec

Phase 4 CPU=11.3 sec

Phase 5 CPU=21.6 sec

Phase 6 CPU=22.2 sec

Phase 7 CPU=22.2 sec

Phase 8 CPU=22.2 sec

Phase 9 CPU=22.3 sec

Phase 10 CPU=22.8 sec

AvgWirelenPerPin Fanout 1=2.0

AvgWirelenPerPin Fanout 2=3.5

AvgWirelenPerPin Fanout 3=4.0

AvgWirelenPerPin Fanout 4=4.8

AvgWirelenPerPin Fanout 10=4.6

AvgWirelenPerPin Fanout 50=4.0

AvgWirelenPerPin Fanout 100=8.6

AvgWirelenPerPin Fanout 500=3.7

AvgWirelenPerPin Fanout 5000=0.0

AvgWirelenPerPin Fanout 20000=0.0

AvgWirelenPerPin Fanout 50000=0.0

AvgWirelenPerPin Fanout 100000=0.0

IRR Gamma=7.3817
