nikiiv/zx-uno/jepalza/test9_Spectrum_basico/usage_statistics_webtalk.html

### Device Usage Page (usage_statistics_webtalk.html)

This HTML page displays the device usage statistics that will be sent to Xilinx.

Software Version and Target Device
Product Version: | ISE:14.3 (WebPack) - P.40xd | Target Family: | Spartan6
OS Platform: | NT64 | Target Device: | xc6slx9
Project ID (random number) | 07c2e7e4a0334dcc8a35ee2dc0228279.45174291E9A04A838B31B9E73C842F3B.8 | Target Package: | tqg144
Registration ID | 206146466_0_0_971 | Target Speed: | -3
Date Generated | 2014-11-29T19:52:12 | Tool Flow | ISE

User Environment
OS Name | Microsoft Windows 7 , 64-bit | OS Release | Service Pack 1 (build 7601)
CPU Name | Intel(R) Core(TM) i7-2670QM CPU @ 2.20GHz | CPU Speed | 2192 MHz
OS Name | Microsoft Windows 7 , 64-bit | OS Release | Service Pack 1 (build 7601)
CPU Name | Intel(R) Core(TM) i7-2670QM CPU @ 2.20GHz | CPU Speed | 2192 MHz

Device Usage Statistics
Macro Statistics | Miscellaneous Statistics | Net Statistics | Site Usage

Accumulators=2

10-bit up accumulator=2

Adders/Subtractors=26

10-bit adder=1

12-bit subtractor=3

16-bit adder=4

16-bit addsub=2

16-bit subtractor=2

3-bit adder=2

5-bit adder=2

5-bit subtractor=1

6-bit adder=1

7-bit adder=1

8-bit adder=1

8-bit subtractor=1

9-bit adder=4

9-bit subtractor=1

Comparators=18

12-bit comparator lessequal=3

16-bit comparator lessequal=1

3-bit comparator equal=2

4-bit comparator greater=4

5-bit comparator greater=2

8-bit comparator greater=1

9-bit comparator lessequal=5

Counters=14

12-bit up counter=3

16-bit up counter=1

3-bit up counter=1

4-bit down counter=1

4-bit up counter=1

5-bit up counter=2

8-bit down counter=1

9-bit up counter=4

FSMs=1 Multiplexers=1008

1-bit 16-to-1 multiplexer=8

1-bit 2-to-1 multiplexer=437

1-bit 3-to-1 multiplexer=12

1-bit 4-to-1 multiplexer=8

1-bit 8-to-1 multiplexer=1

12-bit 2-to-1 multiplexer=3

16-bit 2-to-1 multiplexer=40

16-bit 7-to-1 multiplexer=1

19-bit 2-to-1 multiplexer=4

19-bit 4-to-1 multiplexer=1

19-bit 8-to-1 multiplexer=1

2-bit 2-to-1 multiplexer=7

3-bit 2-to-1 multiplexer=130

3-bit 3-to-1 multiplexer=3

32-bit 2-to-1 multiplexer=1

4-bit 2-to-1 multiplexer=155

4-bit 3-to-1 multiplexer=4

5-bit 2-to-1 multiplexer=95

8-bit 11-to-1 multiplexer=1

8-bit 2-to-1 multiplexer=87

8-bit 3-to-1 multiplexer=2

8-bit 4-to-1 multiplexer=1

8-bit 8-to-1 multiplexer=1

9-bit 2-to-1 multiplexer=5

RAMs=13

16384x8-bit single-port block Read Only RAM=1

16x1-bit single-port distributed Read Only RAM=1

16x9-bit single-port distributed Read Only RAM=1

256x1-bit single-port distributed Read Only RAM=1

32x8-bit single-port distributed Read Only RAM=1

4x3-bit single-port distributed Read Only RAM=1

64x8-bit dual-port distributed RAM=2

8x1-bit single-port distributed Read Only RAM=1

8x8-bit dual-port distributed RAM=4

Registers=729

Flip-Flops=729

Xors=12

1-bit xor2=6

1-bit xor8=5

8-bit xor2=1

MiscellaneousStatistics

AGG_BONDED_IO=45

AGG_IO=45

AGG_LOCED_IO=45

AGG_SLICE=808

NUM_BONDED_IOB=45

NUM_BSFULL=579

NUM_BSLUTONLY=1581

NUM_BSREGONLY=165

NUM_BSUSED=2325

NUM_BUFG=8

NUM_BUFIO2=1

NUM_BUFIO2FB=1

NUM_DCM=1

NUM_DPRAM_O5ANDO6=22

NUM_DPRAM_O5ONLY=2

NUM_DPRAM_O6ONLY=38

NUM_LOCED_IOB=45

NUM_LOGIC_O5ANDO6=327

NUM_LOGIC_O5ONLY=105

NUM_LOGIC_O6ONLY=1640

NUM_LUT_RT_DRIVES_CARRY4=13

NUM_LUT_RT_DRIVES_FLOP=7

NUM_LUT_RT_EXO5=7

NUM_LUT_RT_EXO6=11

NUM_LUT_RT_O5=6

NUM_LUT_RT_O5ANDO6=2

NUM_LUT_RT_O6=105

NUM_RAMB16BWER=8

NUM_SLICEL=141

NUM_SLICEM=20

NUM_SLICEX=647

NUM_SLICE_CARRY4=82

NUM_SLICE_CONTROLSET=111

NUM_SLICE_CYINIT=2645

NUM_SLICE_F7MUX=63

NUM_SLICE_F8MUX=4

NUM_SLICE_FF=771

NUM_SLICE_LATCH=2

NUM_SLICE_UNUSEDCTRL=427

NUM_SRL_O6ONLY=6

NUM_UNUSABLE_FF_BELS=449

NetStatistics

NumNets_Active=2789

NumNets_Gnd=1

NumNets_Vcc=1

NumNodesOfType_Active_BOUNCEACROSS=115

NumNodesOfType_Active_BOUNCEIN=484

NumNodesOfType_Active_BUFGOUT=8

NumNodesOfType_Active_BUFHINP2OUT=27

NumNodesOfType_Active_BUFIOINP=2

NumNodesOfType_Active_CLKPIN=381

NumNodesOfType_Active_CLKPINFEED=59

NumNodesOfType_Active_CNTRLPIN=484

NumNodesOfType_Active_DOUBLE=5880

NumNodesOfType_Active_GENERIC=77

NumNodesOfType_Active_GLOBAL=180

NumNodesOfType_Active_INPUT=214

NumNodesOfType_Active_IOBIN2OUT=59

NumNodesOfType_Active_IOBOUTPUT=59

NumNodesOfType_Active_LUTINPUT=10459

NumNodesOfType_Active_OUTBOUND=2776

NumNodesOfType_Active_OUTPUT=2906

NumNodesOfType_Active_PADINPUT=46

NumNodesOfType_Active_PADOUTPUT=12

NumNodesOfType_Active_PINBOUNCE=1960

NumNodesOfType_Active_PINFEED=11227

NumNodesOfType_Active_PINFEED2=1

NumNodesOfType_Active_QUAD=3708

NumNodesOfType_Active_REGINPUT=486

NumNodesOfType_Active_SINGLE=6671

NumNodesOfType_Gnd_BOUNCEIN=58

NumNodesOfType_Gnd_CLKPIN=1

NumNodesOfType_Gnd_CNTRLPIN=3

NumNodesOfType_Gnd_DOUBLE=12

NumNodesOfType_Gnd_GENERIC=2

NumNodesOfType_Gnd_HGNDOUT=44

NumNodesOfType_Gnd_INPUT=58

NumNodesOfType_Gnd_IOBIN2OUT=2

NumNodesOfType_Gnd_IOBOUTPUT=2

NumNodesOfType_Gnd_LUTINPUT=66

NumNodesOfType_Gnd_OUTBOUND=15

NumNodesOfType_Gnd_OUTPUT=20

NumNodesOfType_Gnd_PADINPUT=2

NumNodesOfType_Gnd_PINBOUNCE=43

NumNodesOfType_Gnd_PINFEED=120

NumNodesOfType_Gnd_REGINPUT=4

NumNodesOfType_Gnd_SINGLE=14

NumNodesOfType_Vcc_GENERIC=1

NumNodesOfType_Vcc_HVCCOUT=236

NumNodesOfType_Vcc_INPUT=8

NumNodesOfType_Vcc_IOBIN2OUT=1

NumNodesOfType_Vcc_IOBOUTPUT=1

NumNodesOfType_Vcc_KVCCOUT=6

NumNodesOfType_Vcc_LUTINPUT=526

NumNodesOfType_Vcc_PADINPUT=1

NumNodesOfType_Vcc_PINBOUNCE=3

NumNodesOfType_Vcc_PINFEED=535

NumNodesOfType_Vcc_REGINPUT=3

SiteStatistics

BUFG-BUFGMUX=8

IOB-IOBM=21

IOB-IOBS=24

SLICEL-SLICEM=63

SLICEX-SLICEL=145

SLICEX-SLICEM=116

SiteSummary

BUFG=8

BUFG_BUFG=8

BUFIO2=1

BUFIO2FB=1

BUFIO2FB_BUFIO2FB=1

BUFIO2_BUFIO2=1

CARRY4=82

DCM=1

DCM_DCM=1

FF_SR=39

HARD0=14

HARD1=9

IOB=45

IOB_IMUX=12

IOB_INBUF=12

IOB_OUTBUF=41

LUT5=446

LUT6=2081

LUT_OR_MEM5=25

LUT_OR_MEM6=70

PAD=45

RAMB16BWER=8

RAMB16BWER_RAMB16BWER=8

REG_SR=734

SELMUX2_1=67

SLICEL=141

SLICEM=20

SLICEX=647

Configuration Data

BUFIO2FB_BUFIO2FB

DIVIDE_BYPASS=[TRUE:1]

INVERT_INPUTS=[FALSE:1]

BUFIO2_BUFIO2

DIVIDE=[1:1]

DIVIDE_BYPASS=[TRUE:1]

I_INVERT=[FALSE:1]

DCM

PSCLK=[PSCLK_INV:0] [PSCLK:1]

PSEN=[PSEN_INV:0] [PSEN:1]

PSINCDEC=[PSINCDEC:1] [PSINCDEC_INV:0]

RST=[RST:1] [RST_INV:0]

DCM_DCM

CLKDV_DIVIDE=[10.0:1]

CLKIN_DIVIDE_BY_2=[FALSE:1]

CLKOUT_PHASE_SHIFT=[NONE:1]

CLK_FEEDBACK=[1X:1]

DESKEW_ADJUST=[5:1]

DFS_FREQUENCY_MODE=[LOW:1]

DLL_FREQUENCY_MODE=[LOW:1]

DSS_MODE=[NONE:1]

DUTY_CYCLE_CORRECTION=[TRUE:1]

PSCLK=[PSCLK_INV:0] [PSCLK:1]

PSEN=[PSEN_INV:0] [PSEN:1]

PSINCDEC=[PSINCDEC:1] [PSINCDEC_INV:0]

RST=[RST:1] [RST_INV:0]

STARTUP_WAIT=[FALSE:1]

VERY_HIGH_FREQUENCY=[FALSE:1]

FF_SR

CK=[CK:39] [CK_INV:0]

SRINIT=[SRINIT0:37] [SRINIT1:2]

SYNC_ATTR=[ASYNC:28] [SYNC:11]

IOB_OUTBUF

DRIVEATTRBOX=[12:41]

SLEW=[SLOW:41]

SUSPEND=[3STATE:41]

LUT_OR_MEM5

CLK=[CLK:24] [CLK_INV:0]

LUT_OR_MEM=[LUT:1] [RAM:24]

RAMMODE=[DPRAM32:24]

LUT_OR_MEM6

CLK=[CLK:66] [CLK_INV:0]

LUT_OR_MEM=[LUT:4] [RAM:66]

RAMMODE=[SRL16:1] [SRL32:5] [DPRAM32:22] [DPRAM64:38]

RAMB16BWER

CLKA=[CLKA_INV:0] [CLKA:8]

ENA=[ENA_INV:0] [ENA:8]

REGCEA=[REGCEA_INV:0] [REGCEA:8]

RSTA=[RSTA:8] [RSTA_INV:0]

WEA0=[WEA0:8] [WEA0_INV:0]

WEA1=[WEA1:8] [WEA1_INV:0]

WEA2=[WEA2:8] [WEA2_INV:0]

WEA3=[WEA3_INV:0] [WEA3:8]

RAMB16BWER_RAMB16BWER

CLKA=[CLKA_INV:0] [CLKA:8]

DATA_WIDTH_A=[1:8]

DATA_WIDTH_B=[0:8]

DOA_REG=[0:8]

DOB_REG=[0:8]

ENA=[ENA_INV:0] [ENA:8]

EN_RSTRAM_A=[TRUE:8]

EN_RSTRAM_B=[TRUE:8]

RAM_MODE=[TDP:8]

REGCEA=[REGCEA_INV:0] [REGCEA:8]

RSTA=[RSTA:8] [RSTA_INV:0]

RSTTYPE=[SYNC:8]

RST_PRIORITY_A=[CE:8]

RST_PRIORITY_B=[CE:8]

WEA0=[WEA0:8] [WEA0_INV:0]

WEA1=[WEA1:8] [WEA1_INV:0]

WEA2=[WEA2:8] [WEA2_INV:0]

WEA3=[WEA3_INV:0] [WEA3:8]

WRITE_MODE_A=[WRITE_FIRST:8]

WRITE_MODE_B=[WRITE_FIRST:8]

REG_SR

CK=[CK:719] [CK_INV:15]

LATCH_OR_FF=[FF:732] [LATCH:2]

SRINIT=[SRINIT0:657] [SRINIT1:77]

SYNC_ATTR=[ASYNC:508] [SYNC:226]

SLICEL

CLK=[CLK:52] [CLK_INV:0]

SLICEM

CLK=[CLK:20] [CLK_INV:0]

SLICEX

CLK=[CLK:298] [CLK_INV:11]

Pin Data

BUFG

I0=8

O=8

BUFG_BUFG

I0=8

O=8

BUFIO2

DIVCLK=1

I=1

BUFIO2FB

I=1

O=1

BUFIO2FB_BUFIO2FB

I=1

O=1

BUFIO2_BUFIO2

DIVCLK=1

I=1

CARRY4

CIN=56

CO0=3

CO2=1

CO3=56

CYINIT=26

DI0=78

DI1=73

DI2=72

DI3=56

O0=73

O1=69

O2=67

O3=67

S0=82

S1=75

S2=73

S3=71

DCM

CLK0=1

CLKDV=1

CLKFB=1

CLKFX=1

CLKIN=1

PSCLK=1

PSEN=1

PSINCDEC=1

RST=1

DCM_DCM

CLK0=1

CLKDV=1

CLKFB=1

CLKFX=1

CLKIN=1

PSCLK=1

PSEN=1

PSINCDEC=1

RST=1

FF_SR

CE=18

CK=39

D=39

Q=39

SR=19

HARD0

0=14

HARD1

1=9

IOB

I=12

O=41

PAD=45

T=8

IOB_IMUX

I=12

OUT=12

IOB_INBUF

OUT=12

PAD=12

IOB_OUTBUF

IN=41

OUT=41

TRI=8

LUT5

A1=132

A2=195

A3=202

A4=187

A5=221

O5=446

LUT6

A1=1183

A2=1541

A3=1712

A4=1924

A5=1963

A6=2064

O6=2081

LUT_OR_MEM5

A1=25

A2=25

A3=25

A4=25

A5=25

CLK=24

DI1=24

O5=25

WA1=24

WA2=24

WA3=24

WA4=24

WA5=24

WE=24

LUT_OR_MEM6

A1=67

A2=69

A3=69

A4=70

A5=70

A6=70

CLK=66

DI1=43

DI2=23

MC31=4

O6=58

WA1=60

WA2=60

WA3=60

WA4=60

WA5=60

WA6=60

WE=66

PAD

PAD=45

RAMB16BWER

ADDRA0=8

ADDRA1=8

ADDRA10=8

ADDRA11=8

ADDRA12=8

ADDRA13=8

ADDRA2=8

ADDRA3=8

ADDRA4=8

ADDRA5=8

ADDRA6=8

ADDRA7=8

ADDRA8=8

ADDRA9=8

CLKA=8

DIA0=8

DOA0=8

ENA=8

REGCEA=8

RSTA=8

WEA0=8

WEA1=8

WEA2=8

WEA3=8

RAMB16BWER_RAMB16BWER

ADDRA0=8

ADDRA1=8

ADDRA10=8

ADDRA11=8

ADDRA12=8

ADDRA13=8

ADDRA2=8

ADDRA3=8

ADDRA4=8

ADDRA5=8

ADDRA6=8

ADDRA7=8

ADDRA8=8

ADDRA9=8

CLKA=8

DIA0=8

DOA0=8

ENA=8

REGCEA=8

RSTA=8

WEA0=8

WEA1=8

WEA2=8

WEA3=8

REG_SR

CE=517

CK=734

D=734

Q=734

SR=452

SELMUX2_1

0=67

1=67

OUT=67

S0=67

SLICEL

A=26

A1=33

A2=48

A3=49

A4=81

A5=87

A6=112

AMUX=51

AQ=39

AX=30

B=37

B1=33

B2=48

B3=51

B4=81

B5=93

B6=114

BMUX=56

BQ=31

BX=27

C1=49

C2=67

C3=74

C4=97

C5=111

C6=132

CE=34

CIN=56

CLK=52

CMUX=93

COUT=56

CQ=33

CX=80

D=1

D1=51

D2=70

D3=75

D4=98

D5=104

D6=128

DMUX=44

DQ=31

DX=21

SR=39

SLICEM

A=9

A1=17

A2=19

A3=19

A4=19

A5=19

A6=18

AI=5

AMUX=7

AQ=11

AX=14

B=10

B1=19

B2=19

B3=19

B4=19

B5=19

B6=19

BI=7

BMUX=6

BQ=10

BX=8

C=9

C1=16

C2=16

C3=16

C4=16

C5=16

C6=15

CE=20

CI=5

CLK=20

CMUX=6

CQ=7

CX=15

D=12

D1=18

D2=18

D3=18

D4=18

D5=18

D6=18

DI=6

DMUX=7

DQ=8

DX=19

WE=7

SLICEX

A=390

A1=341

A2=426

A3=454

A4=473

A5=470

A6=471

AMUX=37

AQ=191

AX=92

B=348

B1=251

B2=356

B3=386

B4=399

B5=403

B6=403

BMUX=68

BQ=133

BX=72

C=281

C1=267

C2=317

C3=343

C4=351

C5=355

C6=354

CE=206

CLK=309

CMUX=59

CQ=144

CX=65

D=307

D1=237

D2=307

D3=330

D4=344

D5=349

D6=350

DMUX=57

DQ=96

DX=50

SR=185

Tool Usage

Command Line History

xst -intstyle ise -ifn <ise_file>

ngdbuild -intstyle ise -dd _ngo -nt timestamp -uc <fname>.ucf -p xc6slx9-tqg144-3 <fname>.ngc <fname>.ngd

ngdbuild -intstyle ise -dd _ngo -nt timestamp -uc <fname>.ucf -p xc6slx9-tqg144-3 <fname>.ngc <fname>.ngd

ngdbuild -intstyle ise -dd _ngo -nt timestamp -uc <fname>.ucf -p xc6slx9-tqg144-3 <fname>.ngc <fname>.ngd

map -intstyle ise -p xc6slx9-tqg144-3 -w -logic_opt off -ol high -t 1 -xt 0 -register_duplication off -r 4 -global_opt off -mt off -ir off -pr off -lc off -power off -o <fname>.ncd <fname>.ngd <fname>.pcf

par -w -intstyle ise -ol high -mt off <fname>.ncd <fname>.ncd <fname>.pcf

trce -intstyle ise -v 3 -s 3 -n 3 -fastpaths -xml <fname>.twx <fname>.ncd -o <fname>.twr <fname>.pcf -ucf <fname>.ucf

bitgen -intstyle ise -f <fname>.ut <fname>.ncd

xst -intstyle ise -ifn <ise_file>

ngdbuild -intstyle ise -dd _ngo -nt timestamp -uc <fname>.ucf -p xc6slx9-tqg144-3 <fname>.ngc <fname>.ngd

ngdbuild -intstyle ise -dd _ngo -nt timestamp -uc <fname>.ucf -p xc6slx9-tqg144-3 <fname>.ngc <fname>.ngd

map -intstyle ise -p xc6slx9-tqg144-3 -w -logic_opt off -ol high -t 1 -xt 0 -register_duplication off -r 4 -global_opt off -mt off -ir off -pr off -lc off -power off -o <fname>.ncd <fname>.ngd <fname>.pcf

par -w -intstyle ise -ol high -mt off <fname>.ncd <fname>.ncd <fname>.pcf

trce -intstyle ise -v 3 -s 3 -n 3 -fastpaths -xml <fname>.twx <fname>.ncd -o <fname>.twr <fname>.pcf -ucf <fname>.ucf

bitgen -intstyle ise -f <fname>.ut <fname>.ncd

xst -intstyle ise -ifn <ise_file>

xst -intstyle ise -ifn <ise_file>

ngdbuild -intstyle ise -dd _ngo -nt timestamp -uc <fname>.ucf -p xc6slx9-tqg144-3 <fname>.ngc <fname>.ngd

map -intstyle ise -p xc6slx9-tqg144-3 -w -logic_opt off -ol high -t 1 -xt 0 -register_duplication off -r 4 -global_opt off -mt off -ir off -pr off -lc off -power off -o <fname>.ncd <fname>.ngd <fname>.pcf

par -w -intstyle ise -ol high -mt off <fname>.ncd <fname>.ncd <fname>.pcf

trce -intstyle ise -v 3 -s 3 -n 3 -fastpaths -xml <fname>.twx <fname>.ncd -o <fname>.twr <fname>.pcf -ucf <fname>.ucf

bitgen -intstyle ise -f <fname>.ut <fname>.ncd

xst -intstyle ise -ifn <ise_file>

ngdbuild -intstyle ise -dd _ngo -nt timestamp -uc <fname>.ucf -p xc6slx9-tqg144-3 <fname>.ngc <fname>.ngd

map -intstyle ise -p xc6slx9-tqg144-3 -w -logic_opt off -ol high -t 1 -xt 0 -register_duplication off -r 4 -global_opt off -mt off -ir off -pr off -lc off -power off -o <fname>.ncd <fname>.ngd <fname>.pcf

par -w -intstyle ise -ol high -mt off <fname>.ncd <fname>.ncd <fname>.pcf

trce -intstyle ise -v 3 -s 3 -n 3 -fastpaths -xml <fname>.twx <fname>.ncd -o <fname>.twr <fname>.pcf -ucf <fname>.ucf

bitgen -intstyle ise -f <fname>.ut <fname>.ncd

ngdbuild -intstyle ise -dd _ngo -nt timestamp -uc <fname>.ucf -p xc6slx9-tqg144-3 <fname>.ngc <fname>.ngd

map -intstyle ise -p xc6slx9-tqg144-3 -w -logic_opt off -ol high -t 1 -xt 0 -register_duplication off -r 4 -global_opt off -mt off -ir off -pr off -lc off -power off -o <fname>.ncd <fname>.ngd <fname>.pcf

par -w -intstyle ise -ol high -mt off <fname>.ncd <fname>.ncd <fname>.pcf

trce -intstyle ise -v 3 -s 3 -n 3 -fastpaths -xml <fname>.twx <fname>.ncd -o <fname>.twr <fname>.pcf -ucf <fname>.ucf

bitgen -intstyle ise -f <fname>.ut <fname>.ncd

xst -intstyle ise -ifn <ise_file>

ngdbuild -intstyle ise -dd _ngo -nt timestamp -uc <fname>.ucf -p xc6slx9-tqg144-3 <fname>.ngc <fname>.ngd

map -intstyle ise -p xc6slx9-tqg144-3 -w -logic_opt off -ol high -t 1 -xt 0 -register_duplication off -r 4 -global_opt off -mt off -ir off -pr off -lc off -power off -o <fname>.ncd <fname>.ngd <fname>.pcf

par -w -intstyle ise -ol high -mt off <fname>.ncd <fname>.ncd <fname>.pcf

trce -intstyle ise -v 3 -s 3 -n 3 -fastpaths -xml <fname>.twx <fname>.ncd -o <fname>.twr <fname>.pcf -ucf <fname>.ucf

bitgen -intstyle ise -f <fname>.ut <fname>.ncd

xst -intstyle ise -ifn <ise_file>

ngdbuild -intstyle ise -dd _ngo -nt timestamp -uc <fname>.ucf -p xc6slx9-tqg144-3 <fname>.ngc <fname>.ngd

map -intstyle ise -p xc6slx9-tqg144-3 -w -logic_opt off -ol high -t 1 -xt 0 -register_duplication off -r 4 -global_opt off -mt off -ir off -pr off -lc off -power off -o <fname>.ncd <fname>.ngd <fname>.pcf

par -w -intstyle ise -ol high -mt off <fname>.ncd <fname>.ncd <fname>.pcf

trce -intstyle ise -v 3 -s 3 -n 3 -fastpaths -xml <fname>.twx <fname>.ncd -o <fname>.twr <fname>.pcf -ucf <fname>.ucf

bitgen -intstyle ise -f <fname>.ut <fname>.ncd

xst -intstyle ise -ifn <ise_file>

ngdbuild -intstyle ise -dd _ngo -nt timestamp -uc <fname>.ucf -p xc6slx9-tqg144-3 <fname>.ngc <fname>.ngd

map -intstyle ise -p xc6slx9-tqg144-3 -w -logic_opt off -ol high -t 1 -xt 0 -register_duplication off -r 4 -global_opt off -mt off -ir off -pr off -lc off -power off -o <fname>.ncd <fname>.ngd <fname>.pcf

par -w -intstyle ise -ol high -mt off <fname>.ncd <fname>.ncd <fname>.pcf

trce -intstyle ise -v 3 -s 3 -n 3 -fastpaths -xml <fname>.twx <fname>.ncd -o <fname>.twr <fname>.pcf -ucf <fname>.ucf

bitgen -intstyle ise -f <fname>.ut <fname>.ncd

Software Quality
Run Statistics
Program Name | Runs Started | Runs Finished | Errors | Fatal Errors | Internal Errors | Exceptions | Core Dumps
_impact | 40 | 24 | 0 | 0 | 0 | 0 | 0
arwz | 21 | 20 | 0 | 0 | 0 | 0 | 0
bitgen | 455 | 452 | 0 | 0 | 0 | 0 | 0
cse_server | 1 | 1 | 0 | 0 | 0 | 0 | 0
edif2ngd | 1 | 1 | 0 | 0 | 0 | 0 | 0
ibiswriter | 1 | 1 | 0 | 0 | 0 | 0 | 0
map | 501 | 460 | 0 | 0 | 0 | 0 | 0
netgen | 2 | 2 | 0 | 0 | 0 | 0 | 0
ngcbuild | 9 | 9 | 0 | 0 | 0 | 0 | 0
ngdbuild | 618 | 617 | 0 | 0 | 0 | 0 | 0
obngc | 1 | 1 | 0 | 0 | 0 | 0 | 0
par | 460 | 459 | 0 | 0 | 0 | 0 | 0
trce | 457 | 457 | 0 | 0 | 0 | 0 | 0
xst | 1077 | 1059 | 0 | 0 | 0 | 0 | 0

Help Statistics
Help files
/doc/usenglish/isehelp/ite_c_overview.htm ( 2 ) | /doc/usenglish/isehelp/pn_db_design_properties.htm ( 1 )

/doc/usenglish/wizards/arwz/awz_db_dcmclkbuf.htm ( 1 )

Project Statistics
PROP_Enable_Message_Filtering=false | PROP_FitterReportFormat=HTML
PROP_ISimsUseCustomWaveConfigFile_behav=true | PROP_LastAppliedGoal=Balanced
PROP_LastAppliedStrategy=Xilinx Default (unlocked) | PROP_ManualCompileOrderImp=false
PROP_PropSpecInProjFile=Store all values | PROP_SelectedInstanceHierarchicalPath=/tb_zxuno
PROP_Simulator=ISim (VHDL/Verilog) | PROP_SynthOptEffort=High
PROP_SynthTopFile=changed | PROP_Top_Level_Module_Type=HDL
PROP_UseSmartGuide=false | PROP_UserConstraintEditorPreference=Text Editor
PROP_intProjectCreationTimestamp=2014-02-16T16:54:30 | PROP_intWbtProjectID=45174291E9A04A838B31B9E73C842F3B
PROP_intWbtProjectIteration=8 | PROP_intWorkingDirLocWRTProjDir=Same
PROP_intWorkingDirUsed=No | PROP_selectedSimRootSourceNode_behav=work.tb_zxuno
PROP_xilxMapCoverMode=Speed | PROP_AutoTop=false
PROP_DevFamily=Spartan6 | PROP_ISimsUseCustomWaveConfigFilename_behav=changed
PROP_MapLogicOptimization=true | PROP_MapRegDuplication=On
PROP_DevDevice=xc6slx9 | PROP_DevFamilyPMName=spartan6
PROP_ISimSimulationRunTime_behav_tb=10ms | PROP_MapExtraEffort=Continue on Impossible
PROP_DevPackage=tqg144 | PROP_Synthesis_Tool=XST (VHDL/Verilog)
PROP_DevSpeed=-3 | PROP_PreferredLanguage=Verilog
FILE_UCF=1 | FILE_VERILOG=13

FILE_VHDL=9

Unisim Statistics
XST_UNISIM_SUMMARY
XST_NUM_BUFG=1 | XST_NUM_IBUFG=1
NGDBUILD_PRE_UNISIM_SUMMARY
NGDBUILD_NUM_BUFG=8 | NGDBUILD_NUM_DCM_SP=1 | NGDBUILD_NUM_FD=113 | NGDBUILD_NUM_FDC=54
NGDBUILD_NUM_FDCE=114 | NGDBUILD_NUM_FDCE_1=2 | NGDBUILD_NUM_FDC_1=2 | NGDBUILD_NUM_FDE=181
NGDBUILD_NUM_FDE_1=8 | NGDBUILD_NUM_FDP=30 | NGDBUILD_NUM_FDPE=29 | NGDBUILD_NUM_FDPE_1=1
NGDBUILD_NUM_FDR=34 | NGDBUILD_NUM_FDRE=198 | NGDBUILD_NUM_FDS=3 | NGDBUILD_NUM_FDSE=2
NGDBUILD_NUM_GND=1 | NGDBUILD_NUM_IBUF=3 | NGDBUILD_NUM_IBUFG=1 | NGDBUILD_NUM_INV=85
NGDBUILD_NUM_IOBUF=8 | NGDBUILD_NUM_LDC=2 | NGDBUILD_NUM_LUT1=116 | NGDBUILD_NUM_LUT2=164
NGDBUILD_NUM_LUT3=196 | NGDBUILD_NUM_LUT4=209 | NGDBUILD_NUM_LUT5=445 | NGDBUILD_NUM_LUT6=1121
NGDBUILD_NUM_MUXCY=279 | NGDBUILD_NUM_MUXF7=63 | NGDBUILD_NUM_MUXF8=4 | NGDBUILD_NUM_OBUF=33
NGDBUILD_NUM_RAM16X1D=20 | NGDBUILD_NUM_RAM32M=2 | NGDBUILD_NUM_RAM64M=2 | NGDBUILD_NUM_RAM64X1D=10
NGDBUILD_NUM_RAMB16BWER=8 | NGDBUILD_NUM_SRLC16E=1 | NGDBUILD_NUM_SRLC32E=5 | NGDBUILD_NUM_VCC=1

NGDBUILD_NUM_XORCY=276
NGDBUILD_POST_UNISIM_SUMMARY
NGDBUILD_NUM_BUFG=8 | NGDBUILD_NUM_DCM_SP=1 | NGDBUILD_NUM_FD=113 | NGDBUILD_NUM_FDC=54
NGDBUILD_NUM_FDCE=114 | NGDBUILD_NUM_FDCE_1=2 | NGDBUILD_NUM_FDC_1=2 | NGDBUILD_NUM_FDE=181
NGDBUILD_NUM_FDE_1=8 | NGDBUILD_NUM_FDP=30 | NGDBUILD_NUM_FDPE=29 | NGDBUILD_NUM_FDPE_1=1
NGDBUILD_NUM_FDR=34 | NGDBUILD_NUM_FDRE=198 | NGDBUILD_NUM_FDS=3 | NGDBUILD_NUM_FDSE=2
NGDBUILD_NUM_GND=1 | NGDBUILD_NUM_IBUF=11 | NGDBUILD_NUM_IBUFG=1 | NGDBUILD_NUM_INV=85
NGDBUILD_NUM_LDC=2 | NGDBUILD_NUM_LUT1=116 | NGDBUILD_NUM_LUT2=164 | NGDBUILD_NUM_LUT3=196
NGDBUILD_NUM_LUT4=209 | NGDBUILD_NUM_LUT5=445 | NGDBUILD_NUM_LUT6=1121 | NGDBUILD_NUM_MUXCY=279
NGDBUILD_NUM_MUXF7=63 | NGDBUILD_NUM_MUXF8=4 | NGDBUILD_NUM_OBUF=33 | NGDBUILD_NUM_OBUFT=8
NGDBUILD_NUM_RAM32M=2 | NGDBUILD_NUM_RAM64M=2 | NGDBUILD_NUM_RAMB16BWER=8 | NGDBUILD_NUM_SRLC16E=1
NGDBUILD_NUM_SRLC32E=5 | NGDBUILD_NUM_VCC=1 | NGDBUILD_NUM_XORCY=276

XST Command Line Options
XST_OPTION_SUMMARY
-ifn=<fname>.prj | -ofn=<design_top> | -ofmt=NGC | -p=xc6slx9-3-tqg144
-top=<design_top> | -opt_mode=Speed | -opt_level=1 | -power=NO
-iuc=NO | -keep_hierarchy=No | -netlist_hierarchy=As_Optimized | -rtlview=Yes
-glob_opt=AllClockNets | -read_cores=YES | -write_timing_constraints=NO | -cross_clock_analysis=NO
-bus_delimiter=<> | -slice_utilization_ratio=100 | -bram_utilization_ratio=100 | -dsp_utilization_ratio=100
-reduce_control_sets=Auto | -fsm_extract=YES | -fsm_encoding=Auto | -safe_implementation=No
-fsm_style=LUT | -ram_extract=Yes | -ram_style=Auto | -rom_extract=Yes
-shreg_extract=YES | -rom_style=Auto | -auto_bram_packing=NO | -resource_sharing=YES
-async_to_sync=NO | -use_dsp48=Auto | -iobuf=YES | -max_fanout=100000
-bufg=16 | -register_duplication=YES | -register_balancing=No | -optimize_primitives=NO
-use_clock_enable=Auto | -use_sync_set=Auto | -use_sync_reset=Auto | -iob=Auto
-equivalent_register_removal=YES | -slice_utilization_ratio_maxmargin=5
