nikiiv/zx-uno/cores/jupiter_ace_spartan6/test1/par_usage_statistics.html

Par Statistics

Total Non-vccgnd Signals=1987

Total Non-vccgnd Design Pins=9927

Total Non-vccgnd Conns=9927

Total Non-vccgnd Timing Constrained Conns=2153

Phase 1 CPU=8.4 sec

Phase 2 CPU=9.4 sec

Phase 3 CPU=12.1 sec

Phase 4 CPU=12.9 sec

Phase 5 CPU=18.2 sec

Phase 6 CPU=18.2 sec

Phase 7 CPU=18.2 sec

Phase 8 CPU=18.2 sec

Phase 9 CPU=18.2 sec

Phase 10 CPU=18.5 sec

AvgWirelenPerPin Fanout 1=2.0

AvgWirelenPerPin Fanout 2=2.5

AvgWirelenPerPin Fanout 3=3.3

AvgWirelenPerPin Fanout 4=4.0

AvgWirelenPerPin Fanout 10=3.9

AvgWirelenPerPin Fanout 50=3.2

AvgWirelenPerPin Fanout 100=7.6

AvgWirelenPerPin Fanout 500=3.7

AvgWirelenPerPin Fanout 5000=0.0

AvgWirelenPerPin Fanout 20000=0.0

AvgWirelenPerPin Fanout 50000=0.0

AvgWirelenPerPin Fanout 100000=0.0

IRR Gamma=4.6416
