nikiiv/zx-uno/cores/atari_2600_spartan6/test1/zxuno/par_usage_statistics.html

Par Statistics

Total Non-vccgnd Signals=3005

Total Non-vccgnd Design Pins=11992

Total Non-vccgnd Conns=11992

Total Non-vccgnd Timing Constrained Conns=10739

Phase 1 CPU=3.9 sec

Phase 2 CPU=4.5 sec

Phase 3 CPU=9.5 sec

Phase 4 CPU=10.2 sec

Phase 5 CPU=16.5 sec

Phase 6 CPU=17.4 sec

Phase 7 CPU=17.4 sec

Phase 8 CPU=17.4 sec

Phase 9 CPU=17.7 sec

Phase 10 CPU=18.3 sec

AvgWirelenPerPin Fanout 1=2.0

AvgWirelenPerPin Fanout 2=3.5

AvgWirelenPerPin Fanout 3=3.0

AvgWirelenPerPin Fanout 4=3.2

AvgWirelenPerPin Fanout 10=3.9

AvgWirelenPerPin Fanout 50=3.3

AvgWirelenPerPin Fanout 100=9.1

AvgWirelenPerPin Fanout 500=4.6

AvgWirelenPerPin Fanout 5000=0.0

AvgWirelenPerPin Fanout 20000=0.0

AvgWirelenPerPin Fanout 50000=0.0

AvgWirelenPerPin Fanout 100000=0.0

IRR Gamma=5.6092
