nikiiv/zx-uno/cores/nes_v2_spartan6/test1/xilinx/par_usage_statistics.html

Par Statistics

Total Non-vccgnd Signals=6755

Total Non-vccgnd Design Pins=27967

Total Non-vccgnd Conns=27967

Total Non-vccgnd Timing Constrained Conns=25872

Phase 1 CPU=5.7 sec

Phase 2 CPU=6.6 sec

Phase 3 CPU=18.4 sec

Phase 4 CPU=19.3 sec

Phase 5 CPU=44.8 sec

Phase 6 CPU=44.8 sec

Phase 7 CPU=44.8 sec

Phase 8 CPU=44.8 sec

Phase 9 CPU=45.4 sec

Phase 10 CPU=48.4 sec

AvgWirelenPerPin Fanout 1=4.0

AvgWirelenPerPin Fanout 2=3.5

AvgWirelenPerPin Fanout 3=4.7

AvgWirelenPerPin Fanout 4=5.8

AvgWirelenPerPin Fanout 10=4.3

AvgWirelenPerPin Fanout 50=3.4

AvgWirelenPerPin Fanout 100=6.4

AvgWirelenPerPin Fanout 500=4.5

AvgWirelenPerPin Fanout 5000=2.8

AvgWirelenPerPin Fanout 20000=0.0

AvgWirelenPerPin Fanout 50000=0.0

AvgWirelenPerPin Fanout 100000=0.0

IRR Gamma=41.1273
