nikiiv/zx-uno/cores/xt_lite/test1/ise/par_usage_statistics.html

Par Statistics

Total Non-vccgnd Signals=5656

Total Non-vccgnd Design Pins=27080

Total Non-vccgnd Conns=27080

Total Non-vccgnd Timing Constrained Conns=26710

Phase 1 CPU=4.4 sec

Phase 2 CPU=5.2 sec

Phase 3 CPU=13.4 sec

Phase 4 CPU=14.0 sec

Phase 5 CPU=48.8 sec

Phase 6 CPU=48.8 sec

Phase 7 CPU=48.8 sec

Phase 8 CPU=48.8 sec

Phase 9 CPU=49.3 sec

Phase 10 CPU=53.8 sec

AvgWirelenPerPin Fanout 1=5.0

AvgWirelenPerPin Fanout 2=6.0

AvgWirelenPerPin Fanout 3=4.7

AvgWirelenPerPin Fanout 4=6.8

AvgWirelenPerPin Fanout 10=5.6

AvgWirelenPerPin Fanout 50=5.1

AvgWirelenPerPin Fanout 100=9.4

AvgWirelenPerPin Fanout 500=4.8

AvgWirelenPerPin Fanout 5000=2.7

AvgWirelenPerPin Fanout 20000=0.0

AvgWirelenPerPin Fanout 50000=0.0

AvgWirelenPerPin Fanout 100000=0.0

IRR Gamma=55.0812
