nikiiv/zx-uno/building/zxuno_bottom_layer.png

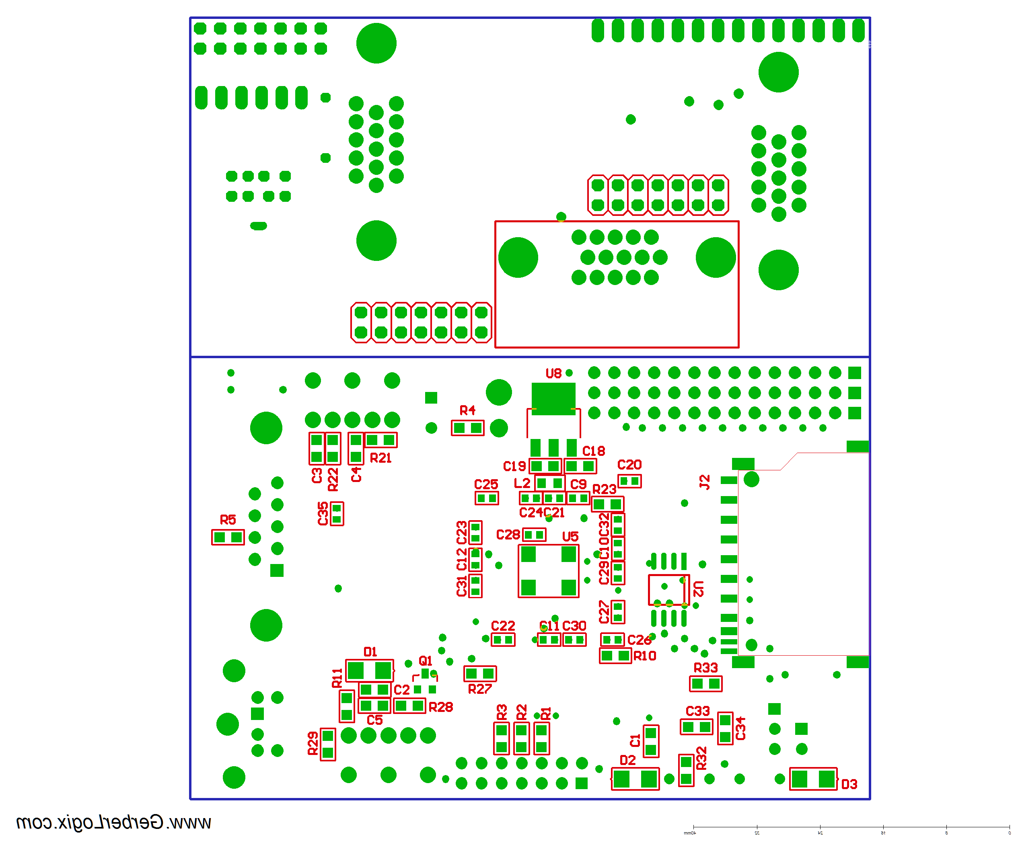
building/zxuno_bottom_layer.png
