nikiiv/zx-uno/building/zxuno_top_layer.png

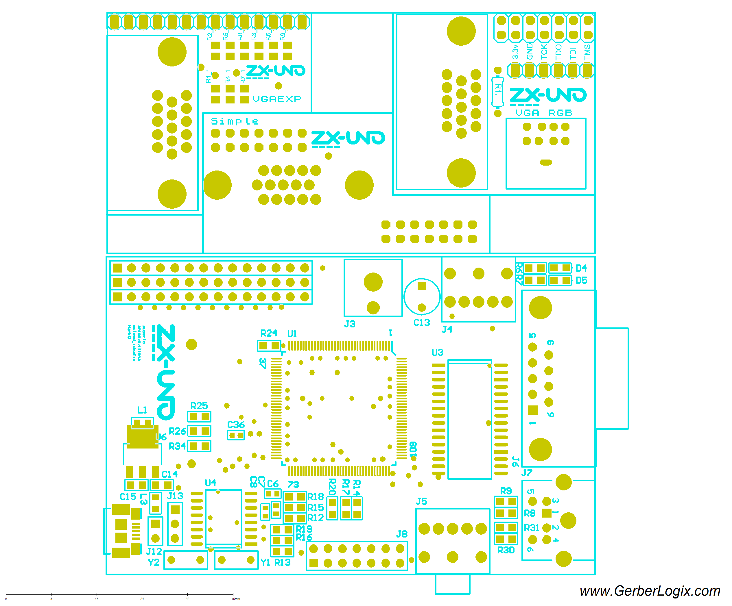
building/zxuno_top_layer.png
