nikiiv/zx-uno/cores/nes_spartan6/test1/README.md

**Ported to ZX-UNO by Quest 19/8/2015

- Hay que abrir el proyecto con ISE 14.7. Si se abre con versiones anteriores, al sintetizar no cabe en core en el ZX-UNO
- Usar con joystick norma Atari de 2 botones (De Master System o Megadrive principalmente)
- Los botones SELECT y START se consiguen poniendo pulsadores en EXT12 y EXT11 del puerto de expansión respectivamente (a GND)
- Para cargar los juegos hay que conectar el ZX-UNO al puerto serie del ordenador con conversión de niveles. (Ver pines_NES.jpg) y ejecutar en la carpeta "sw" el nesdbg_COMx que corresponda a tu puerto serie.

ORIGINAL README:
------------------
**fpga_nes** is an fpga-targeted Nintento Entertainment System emulator written in Verilog.  It is currently under development, and is most notably missing support for mappers and the DMC sound channel.  At this point, it runs most NROM games capably (e.g., Super Mario Brothers, Excitebike).

In addition, this project includes a C++ Windows application called NesDbg, which communicates with the FPGA over USB UART to load ROMs, run unit tests, readwrite memory, etc.

**Hardware Setup:**

Title

1. [Nexys 3 Spartan-6 FPGA board](http://www.digilentinc.com/Products/Detail.cfm?NavPath=2,400,897&Prod=NEXYS3). ($119 / $199)
2. Micro-USB connection for FPGA power and programming.
3. VGA display connection for NES video output.
4. Micro-USB connection for communication between NES and NesDbg software.
5. [PmodBB Bread Board](http://www.digilentinc.com/Products/Detail.cfm?NavPath=2,401,471&Prod=PMOD-BB) for a solderless joypad connection.  ($20)
6. [NES Joypad Adapter](http://www.parallax.com/StoreSearchResults/tabid/768/txtSearch/nes/List/0/SortField/4/ProductID/613/Default.aspx) to accept input from joypads.  ($5)
7. 2 [NES Joypads](http://www.parallax.com/Store/Accessories/Hardware/tabid/162/txtSearch/nes/List/0/SortField/4/ProductID/528/Default.aspx) to accept user input.  (2 * $5)
8. [PmodAMP1](http://www.digilentinc.com/Products/Detail.cfm?Prod=PMOD-AMP1) to amplify NES PWM audio output.  ($20)
9. [Speaker](http://www.digilentinc.com/Products/Catalog.cfm?NavPath=2,393&Cat=3) to play the NES sound.  ($6)

**Development Environment:**

1. [ISE 14.1 WebPack](http://www.xilinx.com/support/download/index.htm) (free)
2. [Visual Studio 2010 Express](http://www.microsoft.com/visualstudio/en-us/products/2010-editions/visual-cpp-express) (free)
