nikiiv/zx-uno/jepalza/test1_led/test1_envsettings.html

System Settings

Environment Settings
Environment Variable | xst | ngdbuild | map | par
PATHEXT | .COM; .EXE; .BAT; .CMD; .VBS; .VBE; .JS; .JSE; .WSF; .WSH; .MSC | .COM; .EXE; .BAT; .CMD; .VBS; .VBE; .JS; .JSE; .WSF; .WSH; .MSC | .COM; .EXE; .BAT; .CMD; .VBS; .VBE; .JS; .JSE; .WSF; .WSH; .MSC | .COM; .EXE; .BAT; .CMD; .VBS; .VBE; .JS; .JSE; .WSF; .WSH; .MSC
Path | C:\Xilinx\14.3\ISE_DS\ISE\\lib\nt64; C:\Xilinx\14.3\ISE_DS\ISE\\bin\nt64; C:\a\arm\WinAVR-20100110\bin; C:\a\arm\WinAVR-20100110\utils\bin; C:\Program Files (x86)\Profactor\ReconstructMeSDK\2.1.845\bin; C:\Windows\system32; C:\Windows; c:\aplis | C:\Xilinx\14.3\ISE_DS\ISE\\lib\nt64; C:\Xilinx\14.3\ISE_DS\ISE\\bin\nt64; C:\a\arm\WinAVR-20100110\bin; C:\a\arm\WinAVR-20100110\utils\bin; C:\Program Files (x86)\Profactor\ReconstructMeSDK\2.1.845\bin; C:\Windows\system32; C:\Windows; c:\aplis | C:\Xilinx\14.3\ISE_DS\ISE\\lib\nt64; C:\Xilinx\14.3\ISE_DS\ISE\\bin\nt64; C:\a\arm\WinAVR-20100110\bin; C:\a\arm\WinAVR-20100110\utils\bin; C:\Program Files (x86)\Profactor\ReconstructMeSDK\2.1.845\bin; C:\Windows\system32; C:\Windows; c:\aplis | C:\Xilinx\14.3\ISE_DS\ISE\\lib\nt64; C:\Xilinx\14.3\ISE_DS\ISE\\bin\nt64; C:\a\arm\WinAVR-20100110\bin; C:\a\arm\WinAVR-20100110\utils\bin; C:\Program Files (x86)\Profactor\ReconstructMeSDK\2.1.845\bin; C:\Windows\system32; C:\Windows; c:\aplis
XILINX | C:\Xilinx\14.3\ISE_DS\ISE\ | C:\Xilinx\14.3\ISE_DS\ISE\ | C:\Xilinx\14.3\ISE_DS\ISE\ | C:\Xilinx\14.3\ISE_DS\ISE\

Synthesis Property Settings
Switch Name | Property Name | Value | Default Value
-ifn | | test1.prj
-ofn | | test1
-ofmt | | NGC | NGC
-p | | xc6slx9-3-tqg144
-top | | test1
-opt_mode | Optimization Goal | Speed | Speed
-opt_level | Optimization Effort | 1 | 1
-power | Power Reduction | NO | No
-iuc | Use synthesis Constraints File | NO | No
-keep_hierarchy | Keep Hierarchy | No | No
-netlist_hierarchy | Netlist Hierarchy | As_Optimized | As_Optimized
-rtlview | Generate RTL Schematic | Yes | No
-glob_opt | Global Optimization Goal | AllClockNets | AllClockNets
-read_cores | Read Cores | YES | Yes
-write_timing_constraints | Write Timing Constraints | NO | No
-cross_clock_analysis | Cross Clock Analysis | NO | No
-bus_delimiter | Bus Delimiter | <> | <>
-slice_utilization_ratio | Slice Utilization Ratio | 100 | 100
-bram_utilization_ratio | BRAM Utilization Ratio | 100 | 100
-dsp_utilization_ratio | DSP Utilization Ratio | 100 | 100
-reduce_control_sets | | Auto | Auto
-fsm_extract | | YES | Yes
-fsm_encoding | | Auto | Auto
-safe_implementation | | No | No
-fsm_style | | LUT | LUT
-ram_extract | | Yes | Yes
-ram_style | | Auto | Auto
-rom_extract | | Yes | Yes
-shreg_extract | | YES | Yes
-rom_style | | Auto | Auto
-auto_bram_packing | | NO | No
-resource_sharing | | YES | Yes
-async_to_sync | | NO | No
-use_dsp48 | | Auto | Auto
-iobuf | | YES | Yes
-max_fanout | | 100000 | 100000
-bufg | | 16 | 16
-register_duplication | | YES | Yes
-register_balancing | | No | No
-optimize_primitives | | NO | No
-use_clock_enable | | Auto | Auto
-use_sync_set | | Auto | Auto
-use_sync_reset | | Auto | Auto
-iob | | Auto | Auto
-equivalent_register_removal | | YES | Yes
-slice_utilization_ratio_maxmargin | | 5 | 0

Translation Property Settings
Switch Name | Property Name | Value | Default Value
-intstyle | | ise | None
-dd | | _ngo | None
-p | | xc6slx9-tqg144-3 | None
-uc | | pines_zxuno.ucf | None

Map Property Settings
Switch Name | Property Name | Value | Default Value
-ol | Place & Route Effort Level (Overall) | high | high
-xt | Extra Cost Tables | 0 | 0
-ir | Use RLOC Constraints | OFF | OFF
-t | Starting Placer Cost Table (1-100) Map | 1 | 0
-r | Register Ordering | 4 | 4
-intstyle | | ise | None
-lc | LUT Combining | off | off
-o | | test1_map.ncd | None
-w | | true | false
-pr | Pack I/O Registers/Latches into IOBs | off | off
-p | | xc6slx9-tqg144-3 | None

Place and Route Property Settings
Switch Name | Property Name | Value | Default Value
-intstyle | | ise
-mt | Enable Multi-Threading | off | off
-ol | Place & Route Effort Level (Overall) | high | std
-w | | true | false

Operating System Information
Operating System Information | xst | ngdbuild | map | par
CPU Architecture/Speed | Intel(R) Core(TM) i7-2670QM CPU @ 2.20GHz/2192 MHz | Intel(R) Core(TM) i7-2670QM CPU @ 2.20GHz/2192 MHz | Intel(R) Core(TM) i7-2670QM CPU @ 2.20GHz/2192 MHz | Intel(R) Core(TM) i7-2670QM CPU @ 2.20GHz/2192 MHz
Host | ingepal | ingepal | ingepal | ingepal
OS Name | Microsoft Windows 7 , 64-bit | Microsoft Windows 7 , 64-bit | Microsoft Windows 7 , 64-bit | Microsoft Windows 7 , 64-bit
OS Release | Service Pack 1 (build 7601) | Service Pack 1 (build 7601) | Service Pack 1 (build 7601) | Service Pack 1 (build 7601)
