nikiiv/zx-uno/jepalza/test1_led/test1_summary.html

test1 Project Status (11/28/2014 - 08:34:38)
Project File: | test1.xise | Parser Errors: | No Errors
Module Name: | test1 | Implementation State: | Programming File Generated
Target Device: | xc6slx9-3tqg144 | Errors: | No Errors
Product Version: | ISE 14.3 | Warnings: | 1 Warning (0 new)
Design Goal: | Balanced | Routing Results: | All Signals Completely Routed
Design Strategy: | Xilinx Default (unlocked) | Timing Constraints: | All Constraints Met
Environment: | System Settings | Final Timing Score: | 0 (Timing Report)

Device Utilization Summary | | | | | [-]
Slice Logic Utilization | Used | Available | Utilization | Note(s)
Number of Slice Registers | 25 | 11,440 | 1%
Number used as Flip Flops | 25
Number used as Latches | 0
Number used as Latch-thrus | 0
Number used as AND/OR logics | 0
Number of Slice LUTs | 25 | 5,720 | 1%
Number used as logic | 24 | 5,720 | 1%
Number using O6 output only | 0
Number using O5 output only | 23
Number using O5 and O6 | 1
Number used as ROM | 0
Number used as Memory | 0 | 1,440 | 0%
Number used exclusively as route-thrus | 1
Number with same-slice register load | 0
Number with same-slice carry load | 1
Number with other load | 0
Number of occupied Slices | 7 | 1,430 | 1%
Nummber of MUXCYs used | 28 | 2,860 | 1%
Number of LUT Flip Flop pairs used | 25
Number with an unused Flip Flop | 0 | 25 | 0%
Number with an unused LUT | 0 | 25 | 0%
Number of fully used LUT-FF pairs | 25 | 25 | 100%
Number of unique control sets | 1
Number of slice register sites lost to control set restrictions | 7 | 11,440 | 1%
Number of bonded IOBs | 2 | 102 | 1%
Number of LOCed IOBs | 2 | 2 | 100%
Number of RAMB16BWERs | 0 | 32 | 0%
Number of RAMB8BWERs | 0 | 64 | 0%
Number of BUFIO2/BUFIO2_2CLKs | 0 | 32 | 0%
Number of BUFIO2FB/BUFIO2FB_2CLKs | 0 | 32 | 0%
Number of BUFG/BUFGMUXs | 1 | 16 | 6%
Number used as BUFGs | 1
Number used as BUFGMUX | 0
Number of DCM/DCM_CLKGENs | 0 | 4 | 0%
Number of ILOGIC2/ISERDES2s | 0 | 200 | 0%
Number of IODELAY2/IODRP2/IODRP2_MCBs | 0 | 200 | 0%
Number of OLOGIC2/OSERDES2s | 0 | 200 | 0%
Number of BSCANs | 0 | 4 | 0%
Number of BUFHs | 0 | 128 | 0%
Number of BUFPLLs | 0 | 8 | 0%
Number of BUFPLL_MCBs | 0 | 4 | 0%
Number of DSP48A1s | 0 | 16 | 0%
Number of ICAPs | 0 | 1 | 0%
Number of MCBs | 0 | 2 | 0%
Number of PCILOGICSEs | 0 | 2 | 0%
Number of PLL_ADVs | 0 | 2 | 0%
Number of PMVs | 0 | 1 | 0%
Number of STARTUPs | 0 | 1 | 0%
Number of SUSPEND_SYNCs | 0 | 1 | 0%
Average Fanout of Non-Clock Nets | 1.03

Performance Summary | | | | [-]
Final Timing Score: | 0 (Setup: 0, Hold: 0) | Pinout Data: | Pinout Report
Routing Results: | All Signals Completely Routed | Clock Data: | Clock Report
Timing Constraints: | All Constraints Met

Detailed Reports | | | | | | [-]
Report Name | Status | Generated | Errors | Warnings | Infos
Synthesis Report | Current | vie 28. nov 09:02:44 2014 | 0 | 1 Warning (0 new) | 0
Translation Report | Current | vie 28. nov 09:03:02 2014 | 0 | 0 | 0
Map Report | Current | vie 28. nov 09:03:10 2014 | 0 | 0 | 6 Infos (0 new)
Place and Route Report | Current | vie 28. nov 09:03:17 2014 | 0 | 0 | 3 Infos (0 new)
Power Report
Post-PAR Static Timing Report | Current | vie 28. nov 09:03:22 2014 | 0 | 0 | 4 Infos (0 new)
Bitgen Report | Current | vie 28. nov 09:03:30 2014 | 0 | 0 | 0

Secondary Reports | | | [-]
Report Name | Status | Generated
Post-Synthesis Simulation Model Report | Out of Date | vie 28. nov 08:42:12 2014
WebTalk Report | Current | vie 28. nov 09:03:31 2014
WebTalk Log File | Current | vie 28. nov 09:03:40 2014

Date Generated: 11/29/2014 - 19:17:58
