nikiiv/zx-uno/jepalza/test3_modo256/tld_zxuno_summary.html

tld_zxuno Project Status (11/29/2014 - 19:50:58)
Project File: | zxuno.xise | Parser Errors: | No Errors
Module Name: | tld_zxuno | Implementation State: | Programming File Generated
Target Device: | xc6slx9-3tqg144 | Errors: | No Errors
Product Version: | ISE 14.3 | Warnings: | 16 Warnings (0 new)
Design Goal: | Balanced | Routing Results: | All Signals Completely Routed
Design Strategy: | Xilinx Default (unlocked) | Timing Constraints: | All Constraints Met
Environment: | System Settings | Final Timing Score: | 0 (Timing Report)

Device Utilization Summary | | | | | [-]
Slice Logic Utilization | Used | Available | Utilization | Note(s)
Number of Slice Registers | 85 | 11,440 | 1%
Number used as Flip Flops | 85
Number used as Latches | 0
Number used as Latch-thrus | 0
Number used as AND/OR logics | 0
Number of Slice LUTs | 211 | 5,720 | 3%
Number used as logic | 200 | 5,720 | 3%
Number using O6 output only | 122
Number using O5 output only | 56
Number using O5 and O6 | 22
Number used as ROM | 0
Number used as Memory | 5 | 1,440 | 1%
Number used as Dual Port RAM | 0
Number used as Single Port RAM | 0
Number used as Shift Register | 5
Number using O6 output only | 5
Number using O5 output only | 0
Number using O5 and O6 | 0
Number used exclusively as route-thrus | 6
Number with same-slice register load | 0
Number with same-slice carry load | 6
Number with other load | 0
Number of occupied Slices | 73 | 1,430 | 5%
Nummber of MUXCYs used | 88 | 2,860 | 3%
Number of LUT Flip Flop pairs used | 211
Number with an unused Flip Flop | 128 | 211 | 60%
Number with an unused LUT | 0 | 211 | 0%
Number of fully used LUT-FF pairs | 83 | 211 | 39%
Number of unique control sets | 10
Number of slice register sites lost to control set restrictions | 30 | 11,440 | 1%
Number of bonded IOBs | 40 | 102 | 39%
Number of LOCed IOBs | 40 | 40 | 100%
IOB Flip Flops | 8
Number of RAMB16BWERs | 0 | 32 | 0%
Number of RAMB8BWERs | 0 | 64 | 0%
Number of BUFIO2/BUFIO2_2CLKs | 1 | 32 | 3%
Number used as BUFIO2s | 1
Number used as BUFIO2_2CLKs | 0
Number of BUFIO2FB/BUFIO2FB_2CLKs | 1 | 32 | 3%
Number used as BUFIO2FBs | 1
Number used as BUFIO2FB_2CLKs | 0
Number of BUFG/BUFGMUXs | 4 | 16 | 25%
Number used as BUFGs | 4
Number used as BUFGMUX | 0
Number of DCM/DCM_CLKGENs | 1 | 4 | 25%
Number used as DCMs | 1
Number used as DCM_CLKGENs | 0
Number of ILOGIC2/ISERDES2s | 8 | 200 | 4%
Number used as ILOGIC2s | 8
Number used as ISERDES2s | 0
Number of IODELAY2/IODRP2/IODRP2_MCBs | 0 | 200 | 0%
Number of OLOGIC2/OSERDES2s | 0 | 200 | 0%
Number of BSCANs | 0 | 4 | 0%
Number of BUFHs | 0 | 128 | 0%
Number of BUFPLLs | 0 | 8 | 0%
Number of BUFPLL_MCBs | 0 | 4 | 0%
Number of DSP48A1s | 0 | 16 | 0%
Number of ICAPs | 0 | 1 | 0%
Number of MCBs | 0 | 2 | 0%
Number of PCILOGICSEs | 0 | 2 | 0%
Number of PLL_ADVs | 0 | 2 | 0%
Number of PMVs | 0 | 1 | 0%
Number of STARTUPs | 0 | 1 | 0%
Number of SUSPEND_SYNCs | 0 | 1 | 0%
Average Fanout of Non-Clock Nets | 3.52

Performance Summary | | | | [-]
Final Timing Score: | 0 (Setup: 0, Hold: 0) | Pinout Data: | Pinout Report
Routing Results: | All Signals Completely Routed | Clock Data: | Clock Report
Timing Constraints: | All Constraints Met

Detailed Reports | | | | | | [-]
Report Name | Status | Generated | Errors | Warnings | Infos
Synthesis Report | Current | sáb 29. nov 19:49:51 2014 | 0 | 16 Warnings (0 new) | 6 Infos (0 new)
Translation Report | Current | sáb 29. nov 19:49:56 2014 | 0 | 0 | 0
Map Report | Current | sáb 29. nov 19:50:06 2014 | 0 | 0 | 7 Infos (0 new)
Place and Route Report | Current | sáb 29. nov 19:50:13 2014 | 0 | 0 | 3 Infos (0 new)
Power Report
Post-PAR Static Timing Report | Current | sáb 29. nov 19:50:18 2014 | 0 | 0 | 4 Infos (0 new)
Bitgen Report | Current | sáb 29. nov 19:50:27 2014 | 0 | 0 | 1 Info (0 new)

Secondary Reports | | | [-]
Report Name | Status | Generated
WebTalk Report | Current | sáb 29. nov 19:50:27 2014
WebTalk Log File | Current | sáb 29. nov 19:50:58 2014

Date Generated: 11/29/2014 - 19:50:58
