nikiiv/zx-uno/jepalza/test9_Spectrum_basico/pal_sync_generator_progressive_summary.html

pal_sync_generator_progressive Project Status (02/17/2014 - 02:14:48)
Project File: | ula_reloaded.xise | Parser Errors: | No Errors
Module Name: | pal_sync_generator_progressive | Implementation State: | Programming File Not Generated
Target Device: | xc3s250e-4tq144 | Errors:
Product Version: | ISE 12.4 | Warnings:
Design Goal: | Balanced | Routing Results:
Design Strategy: | Xilinx Default (unlocked) | Timing Constraints:
Environment: | | Final Timing Score:

Detailed Reports | | | | | | [-]
Report Name | Status | Generated | Errors | Warnings | Infos
Synthesis Report
Translation Report
Map Report
Place and Route Report
CPLD Fitter Report (Text)
Power Report
Post-PAR Static Timing Report
Bitgen Report

Secondary Reports | | | [-]
Report Name | Status | Generated
ISIM Simulator Log | Out of Date | lun 17. feb 01:28:02 2014
WebTalk Report | Current | lun 17. feb 02:14:41 2014
WebTalk Log File | Current | lun 17. feb 02:14:47 2014

Date Generated: 02/17/2014 - 02:14:48
