nikiiv/zx-uno/cores/cores_para_testar_la_placa/testpines/tld_summary.html

tld Project Status
Project File: | testpines.xise | Parser Errors: | No Errors
Module Name: | tld | Implementation State: | New
Target Device: | xc6slx9-3tqg144 | Errors:
Product Version: | ISE 12.4 | Warnings:
Design Goal: | Balanced | Routing Results:
Design Strategy: | Xilinx Default (unlocked) | Timing Constraints:
Environment: | | Final Timing Score:

Detailed Reports | | | | | | [-]
Report Name | Status | Generated | Errors | Warnings | Infos
Synthesis Report
Translation Report
Map Report
Place and Route Report
Power Report
Post-PAR Static Timing Report
Bitgen Report

Secondary Reports | | | [-]
Report Name | Status | Generated

Date Generated: 03/08/2015 - 22:09:00
