nikiiv/zx-uno/cores/spectrum_v1_spartan3/test3/tld_zxuno_summary.html

tld_zxuno Project Status (09/07/2014 - 02:22:29)
Project File: | zxuno.xise | Parser Errors: | No Errors
Module Name: | tld_zxuno | Implementation State: | Synthesized
Target Device: | xc3s250e-4tq144 | Errors: | No Errors
Product Version: | ISE 12.4 | Warnings: | 1 Warning (1 new)
Design Goal: | Balanced | Routing Results:
Design Strategy: | Xilinx Default (unlocked) | Timing Constraints:
Environment: | System Settings | Final Timing Score:

Device Utilization Summary (estimated values) | | | | [-]
Logic Utilization | Used | Available | Utilization
Number of Slices | 126 | 2448 | 5%
Number of Slice Flip Flops | 85 | 4896 | 1%
Number of 4 input LUTs | 235 | 4896 | 4%
Number of bonded IOBs | 39 | 108 | 36%
Number of GCLKs | 4 | 24 | 16%
Number of DCMs | 1 | 4 | 25%

Detailed Reports | | | | | | [-]
Report Name | Status | Generated | Errors | Warnings | Infos
Synthesis Report | Current | dom 7. sep 02:22:27 2014 | 0 | 1 Warning (1 new) | 0
Translation Report
Map Report
Place and Route Report
Power Report
Post-PAR Static Timing Report
Bitgen Report

Secondary Reports | | | [-]
Report Name | Status | Generated

Date Generated: 09/07/2014 - 02:22:29
