nikiiv/zx-uno/cores/spectrum_v1_spartan3/test6/tld_zxuno_summary.html

tld_zxuno Project Status
Project File: | zxuno.xise | Parser Errors: | No Errors
Module Name: | tld_zxuno | Implementation State: | New
Target Device: | xc3s250e-4tq144 | Errors:
Product Version: | ISE 12.4 | Warnings:
Design Goal: | Balanced | Routing Results:
Design Strategy: | Xilinx Default (unlocked) | Timing Constraints:
Environment: | | Final Timing Score:

Current Errors | | [-]
No Errors Found

Detailed Reports | | | | | | [-]
Report Name | Status | Generated | Errors | Warnings | Infos
Synthesis Report
Translation Report
Map Report
Place and Route Report
Power Report
Post-PAR Static Timing Report
Bitgen Report

Secondary Reports | | | [-]
Report Name | Status | Generated

Date Generated: 02/13/2014 - 01:45:10
