nikiiv/zx-uno/cores/spectrum_v1_spartan3/test8/tld_zxuno_summary.html

tld_zxuno Project Status (02/15/2014 - 03:27:38)
Project File: | zxuno.xise | Parser Errors: | No Errors
Module Name: | tld_zxuno | Implementation State: | Programming File Generated
Target Device: | xc3s250e-4tq144 | Errors: | No Errors
Product Version: | ISE 12.4 | Warnings: | 119 Warnings (0 new)
Design Goal: | Balanced | Routing Results: | All Signals Completely Routed
Design Strategy: | Xilinx Default (unlocked) | Timing Constraints: | All Constraints Met
Environment: | System Settings | Final Timing Score: | 0 (Timing Report)

Device Utilization Summary | | | | | [-]
Logic Utilization | Used | Available | Utilization | Note(s)
Number of Slice Flip Flops | 730 | 4,896 | 14%
Number of 4 input LUTs | 3,046 | 4,896 | 62%
Number of occupied Slices | 1,814 | 2,448 | 74%
Number of Slices containing only related logic | 1,814 | 1,814 | 100%
Number of Slices containing unrelated logic | 0 | 1,814 | 0%
Total Number of 4 input LUTs | 3,202 | 4,896 | 65%
Number used as logic | 2,972
Number used as a route-thru | 156
Number used for Dual Port RAMs | 32
Number used for 32x1 RAMs | 32
Number used as Shift registers | 10
Number of bonded IOBs | 44 | 108 | 40%
IOB Flip Flops | 3
Number of RAMB16s | 10 | 12 | 83%
Number of BUFGMUXs | 7 | 24 | 29%
Number of DCMs | 1 | 4 | 25%
Average Fanout of Non-Clock Nets | 3.69

Performance Summary | | | | [-]
Final Timing Score: | 0 (Setup: 0, Hold: 0) | Pinout Data: | Pinout Report
Routing Results: | All Signals Completely Routed | Clock Data: | Clock Report
Timing Constraints: | All Constraints Met

Detailed Reports | | | | | | [-]
Report Name | Status | Generated | Errors | Warnings | Infos
Synthesis Report | Current | sáb 15. feb 04:49:40 2014 | 0 | 119 Warnings (0 new) | 11 Infos (0 new)
Translation Report | Current | sáb 15. feb 04:49:45 2014 | 0 | 0 | 0
Map Report | Current | sáb 15. feb 04:49:53 2014 | 0 | 0 | 3 Infos (0 new)
Place and Route Report | Current | sáb 15. feb 04:51:16 2014 | 0 | 0 | 3 Infos (0 new)
Power Report
Post-PAR Static Timing Report | Current | sáb 15. feb 04:51:21 2014 | 0 | 0 | 5 Infos (0 new)
Bitgen Report | Current | sáb 15. feb 04:51:40 2014 | 0 | 0 | 1 Info (0 new)

Secondary Reports | | | [-]
Report Name | Status | Generated
ISIM Simulator Log | Out of Date | sáb 15. feb 04:10:29 2014
WebTalk Report | Current | sáb 15. feb 04:51:40 2014
WebTalk Log File | Current | sáb 15. feb 04:51:58 2014

Date Generated: 02/16/2014 - 16:52:57
