nikiiv/zx-uno/cores/atari_2600_spartan6/test1/zxuno/ZXUNO_A2601_summary.html

ZXUNO_A2601 Project Status
Project File: | zxuno_a2601.xise | Parser Errors:
Module Name: | ZXUNO_A2601 | Implementation State: | New
Target Device: | xc6slx9-2tqg144 | Errors:
Product Version: | ISE 14.7 | Warnings:
Design Goal: | Balanced | Routing Results:
Design Strategy: | Xilinx Default (unlocked) | Timing Constraints:
Environment: | | Final Timing Score:

Detailed Reports | | | | | | [-]
Report Name | Status | Generated | Errors | Warnings | Infos
Synthesis Report
Translation Report
Map Report
Place and Route Report
Power Report
Post-PAR Static Timing Report
Bitgen Report

Secondary Reports | | | [-]
Report Name | Status | Generated

Date Generated: 02/10/2016 - 14:28:42
