nikiiv/zx-uno/cores/xt_lite/test1/ise/zxuno_Next186lite_2M_EXT_summary.html

zxuno_Next186lite_2M_INT Project Status
Project File: | Next186_SoC.xise | Parser Errors:
Module Name: | zxuno_Next186lite_2M_EXT | Implementation State: | New
Target Device: | xc6slx9-2tqg144 | Errors:
Product Version: | ISE 14.7 | Warnings:
Design Goal: | Area Reduction | Routing Results:
Design Strategy: | strategy1 | Timing Constraints:
Environment: | | Final Timing Score:

Detailed Reports | | | | | | [-]
Report Name | Status | Generated | Errors | Warnings | Infos
Synthesis Report
Translation Report
Map Report
Place and Route Report
CPLD Fitter Report (Text)
Power Report
Post-PAR Static Timing Report
Bitgen Report

Secondary Reports | | | [-]
Report Name | Status | Generated

Date Generated: 02/18/2017 - 14:17:19
