nikiiv/zx-uno/cores/Acorn_electron/test1/README.md

By David Banks (hoglet) 2015

Ported to ZX-UNO by Quest Nov-2015

# ElectronFpga
