nikiiv/zx-uno/cores/sms_v2_spartan6/test1/README.TXT

This is a port of the Ben Leperchey's Sega Master System HDL core to the ZX-UNO board.
Original source code: https://github.com/ben0109/Papilio-Master-System

All credits go to Ben. 
Ben's Blog: http://fpga-hacks.blogspot.com.es/

Ported to ZX-UNO by Quest of Zonadepruebas forum (http://www.zonadepruebas.com)

If the author feel that he don't want to see this adaptation of his work published here, please contact ZX-UNO team and the files will be removed. (http://zxuno.speccy.org/index_e.shtml)
