nikiiv/zx-uno/cores/sms_v2_spartan6/test4/README.TXT

This is a port of the Ben Leperchey's Sega Master System HDL core to the ZX-UNO board.
Original source code: https://github.com/ben0109/Papilio-Master-System

All credits go to Ben. 
Ben's Blog: http://fpga-hacks.blogspot.com.es/

Ported to ZX-UNO by Quest of ZX-UNO team (http://www.zxuno.com)

As per original author's request, and following the ZX-UNO open source rules, every source code change, addition, improvement, etc, is available freely at ZX-UNO SVN repository: 

http://www.atc.us.es/svn/zxuno/

User    guest
Pass: zxuno
