nikiiv/zx-uno/cores/spectrum_v1_spartan3/test5/ram128k_tester_hex.txt

F3
3E
3E
ED
47
ED
56
01
2B
69
0B
78
B1
20
FB
3E
0F
D3
FE
01
FD
7F
AF
ED
79
D9
6F
D9
21
00
40
75
11
01
40
01
FF
BF
ED
B0
C3
3B
00
FF
FF
FF
FF
FF
FF
FF
FF
FF
FF
FF
FF
FF
FB
DD
E9
3E
07
01
FD
7F
ED
79
21
00
C0
11
01
C0
75
01
FF
3F
ED
B0
3D
F2
3D
00
21
00
40
5C
45
4D
71
23
0C
10
FB
0C
1D
20
F7
21
00
40
5C
45
4D
7E
B9
C2
77
00
23
0C
10
F7
0C
1D
20
F3
C3
98
01
DD
21
81
00
21
00
40
C3
0B
01
A7
CA
06
01
3D
28
38
7B
FE
0E
3E
02
28
77
1C
DD
21
99
00
FB
6B
3E
0A
76
D3
FE
06
01
0E
DE
00
0B
78
B1
20
FA
3E
0F
D3
FE
3E
70
3D
C2
AB
00
3E
0A
D3
FE
3E
6F
3D
C2
B5
00
1D
C2
A5
00
5D
18
D5
7B
FE
06
38
10
D9
21
00
58
11
01
58
01
FF
02
3E
38
77
ED
B0
D9
1C
DD
21
DF
00
FB
6B
3E
09
76
D3
FE
06
01
0E
DE
00
0B
78
B1
20
FA
3E
0F
D3
FE
3E
70
3D
C2
F1
00
3E
09
D3
FE
3E
6F
3D
C2
FB
00
1D
C2
EB
00
5D
18
D5
F6
08
D3
FE
76
54
01
00
40
36
00
7E
FE
FF
20
08
23
0B
78
B1
20
F3
18
65
1E
01
01
00
40
62
69
73
23
0B
78
B1
20
F9
06
40
62
69
7E
AB
20
46
23
0B
78
B1
20
F6
CB
13
30
E2
06
40
62
69
36
FF
23
0B
78
B1
20
F8
21
00
00
4D
59
37
08
19
71
ED
52
08
CB
15
CB
14
0C
79
EE
0F
20
F0
01
00
40
62
69
59
7E
FE
FF
28
04
BB
20
08
1C
23
0B
78
B1
20
F1
1D
3E
02
18
09
1E
FF
1C
CB
1F
30
FB
3E
01
DD
E9
E5
01
00
12
11
A8
0C
CD
31
09
E1
DD
21
97
01
C3
0B
01
C9
21
00
80
1E
40
45
4D
7E
B9
20
0E
23
0C
10
F8
0C
1D
20
F4
D9
7D
F6
01
6F
D9
21
00
C0
1E
40
45
4D
7E
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
CD
CA
08
01
00
00
11
25
0A
CD
31
09
01
05
16
11
0F
0A
CD
31
09
01
04
17
11
F7
09
CD
31
09
01
00
02
11
F0
0A
CD
31
09
01
00
03
11
F9
0A
CD
31
09
01
00
04
11
02
0B
CD
31
09
01
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
FF
FF
FF
FF
FF
FF
FF
FF
FF
FF
FF
FF
FF
FF
FF
FF
FF
FF
FF
FF
FF
FF
FF
FF
FF
FF
FF
FF
FF
FF
FF
FF
FF
FF
FF
FF
FF
FF
FF
FF
FF
FF
FF
FF
FF
FF
FF
FF
FF
FF
FF
FF
FF
FF
FF
FF
FF
FF
FF
FF
FF
FF
FF
FF
FF
FF
FF
FF
FF
FF
FF
FF
FF
FF
FF
FF
FF
FF
FF
FF
FF
FF
FF
FF
FF
FF
FF
FF
FF
FF
FF
FF
FF
FF
FF
FF
FF
FF
FF
