nikiiv/zx-uno/jepalza/test3_modo256/ipcore_dir/relojes_flist.txt

# Output products list for <relojes>
relojes_flist.txt
relojes_xmdf.tcl
