nikiiv/zx-uno/cores/spectrum_v1_spartan3/test3/tld_zxuno_envsettings.html

System Settings

Environment Settings
Environment Variable | xst | ngdbuild | map | par
PATHEXT | .COM; .EXE; .BAT; .CMD; .VBS; .VBE; .JS; .JSE; .WSF; .WSH; .MSC | < data not available > | < data not available > | < data not available >

Path

C:\Xilinx\12.4\ISE_DS\ISE\\lib\nt;
C:\Xilinx\12.4\ISE_DS\ISE\\bin\nt;
C:\Xilinx\12.4\ISE_DS\PlanAhead\bin;
C:\Xilinx\12.4\ISE_DS\ISE\bin\nt;
C:\Xilinx\12.4\ISE_DS\ISE\lib\nt;
C:\Xilinx\12.4\ISE_DS\EDK\bin\nt;
C:\Xilinx\12.4\ISE_DS\EDK\lib\nt;
C:\Xilinx\12.4\ISE_DS\common\bin\nt;
C:\Xilinx\12.4\ISE_DS\common\lib\nt;
C:\Program Files\NVIDIA Corporation\PhysX\Common;
C:\Program Files\Microsoft HPC Pack 2012\Bin\;
C:\WinAVR-20100110\bin;
C:\WinAVR-20100110\utils\bin;
C:\PROGRA~1\Borland\CBUILD~1\Bin;
C:\PROGRA~1\Borland\CBUILD~1\Projects\Bpl;
C:\Program Files\Common Files\Microsoft Shared\Windows Live;
C:\Windows\system32;
C:\Windows;
C:\Windows\System32\Wbem;
C:\Windows\System32\WindowsPowerShell\v1.0\;
C:\Program Files\TortoiseSVN\bin;
C:\Program Files\Windows Live\Shared;
C:\Program Files\Windows Kits\8.0\Windows Performance Toolkit\;
C:\Program Files\Microsoft SQL Server\110\Tools\Binn\;
C:\Program Files\Calibre2\;
C:\Program Files\gnuplot\bin;
C:\Program Files\Git\cmd;
C:\Program Files\QuickTime\QTSystem\;
C:\Wincupl\WINCUPL\EXE;
C:\Wincupl\WINCUPL\FITTERS;
C:\vbcc\bin;
C:\Program Files\GnuWin32\bin;
C:\Program Files\SDCC\bin

< data not available >

< data not available >

< data not available >
XILINX | C:\Xilinx\12.4\ISE_DS\ISE\ | < data not available > | < data not available > | < data not available >
XILINX_DSP | C:\Xilinx\12.4\ISE_DS\ISE | < data not available > | < data not available > | < data not available >
XILINX_EDK | C:\Xilinx\12.4\ISE_DS\EDK | < data not available > | < data not available > | < data not available >
XILINX_PLANAHEAD | C:\Xilinx\12.4\ISE_DS\PlanAhead | < data not available > | < data not available > | < data not available >

Synthesis Property Settings
Switch Name | Property Name | Value | Default Value
-ifn | | tld_zxuno.prj
-ifmt | | mixed | MIXED
-ofn | | tld_zxuno
-ofmt | | NGC | NGC
-p | | xc3s250e-4-tq144
-top | | tld_zxuno
-opt_mode | Optimization Goal | Speed | Speed
-opt_level | Optimization Effort | 1 | 1
-iuc | Use synthesis Constraints File | NO | NO
-keep_hierarchy | Keep Hierarchy | No | NO
-netlist_hierarchy | Netlist Hierarchy | As_Optimized | As_Optimized
-rtlview | Generate RTL Schematic | Yes | NO
-glob_opt | Global Optimization Goal | AllClockNets | AllClockNets
-read_cores | Read Cores | YES | YES
-write_timing_constraints | Write Timing Constraints | NO | NO
-cross_clock_analysis | Cross Clock Analysis | NO | NO
-bus_delimiter | Bus Delimiter | <> | <>
-slice_utilization_ratio | Slice Utilization Ratio | 100 | 100%
-bram_utilization_ratio | BRAM Utilization Ratio | 100 | 100%
-verilog2001 | Verilog 2001 | YES | YES
-fsm_extract | | YES | YES
-fsm_encoding | | Auto | AUTO
-safe_implementation | | No | NO
-fsm_style | | LUT | LUT
-ram_extract | | Yes | YES
-ram_style | | Auto | AUTO
-rom_extract | | Yes | YES
-shreg_extract | | YES | YES
-rom_style | | Auto | AUTO
-auto_bram_packing | | NO | NO
-resource_sharing | | YES | YES
-async_to_sync | | NO | NO
-mult_style | | Auto | AUTO
-iobuf | | YES | YES
-max_fanout | | 500 | 500
-bufg | | 24 | 24
-register_duplication | | YES | YES
-register_balancing | | No | NO
-optimize_primitives | | NO | NO
-use_clock_enable | | Yes | YES
-use_sync_set | | Yes | YES
-use_sync_reset | | Yes | YES
-iob | | Auto | AUTO
-equivalent_register_removal | | YES | YES
-slice_utilization_ratio_maxmargin | | 5 | 0%

Operating System Information
Operating System Information | xst | ngdbuild | map | par
CPU Architecture/Speed | Intel(R) Core(TM)2 Quad CPU Q6600 @ 2.40GHz/2400 MHz | < data not available > | < data not available > | < data not available >
Host | mcleod | < data not available > | < data not available > | < data not available >
OS Name | Microsoft | < data not available > | < data not available > | < data not available >
OS Release | Service Pack 1 (build 7601) | < data not available > | < data not available > | < data not available >
