nikiiv/zx-uno/cores/atari_2600_spartan6/test1/zxuno/A6500_summary.html

EP4CE6_A2601 Project Status (11/21/2015 - 19:06:06)
Project File: | zxuno_a2601.xise | Parser Errors: | No Errors
Module Name: | A6500 | Implementation State: | Programming File Not Generated
Target Device: | xc6slx9-2tqg144 | Errors:
Product Version: | ISE 14.7 | Warnings:
Design Goal: | Balanced | Routing Results:
Design Strategy: | Xilinx Default (unlocked) | Timing Constraints:
Environment: | | Final Timing Score:

Detailed Reports | | | | | | [-]
Report Name | Status | Generated | Errors | Warnings | Infos
Synthesis Report
Translation Report
Map Report
Place and Route Report
CPLD Fitter Report (Text)
Power Report
Post-PAR Static Timing Report
Bitgen Report

Secondary Reports | | | [-]
Report Name | Status | Generated
WebTalk Report | Out of Date | sáb nov 21 19:06:05 2015
WebTalk Log File | Out of Date | sáb nov 21 19:06:06 2015

Date Generated: 11/21/2015 - 19:48:16
