nikiiv/zx-uno/cores/nes_spartan6/test1/pines_NES.jpg

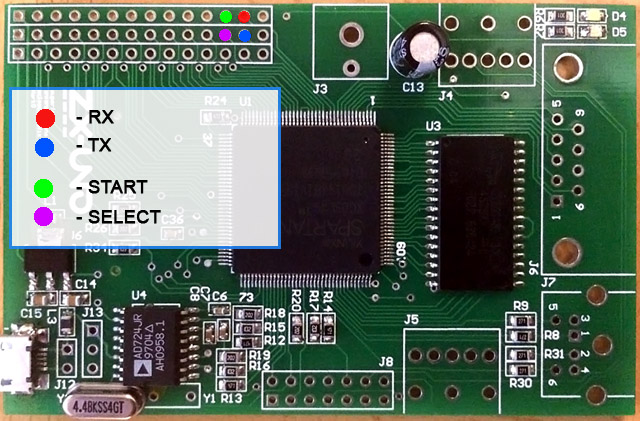
cores/nes_spartan6/test1/pines_NES.jpg
