nikiiv/zx-uno/cores/oric_spartan6/test1/doc/oric_schema.jpg

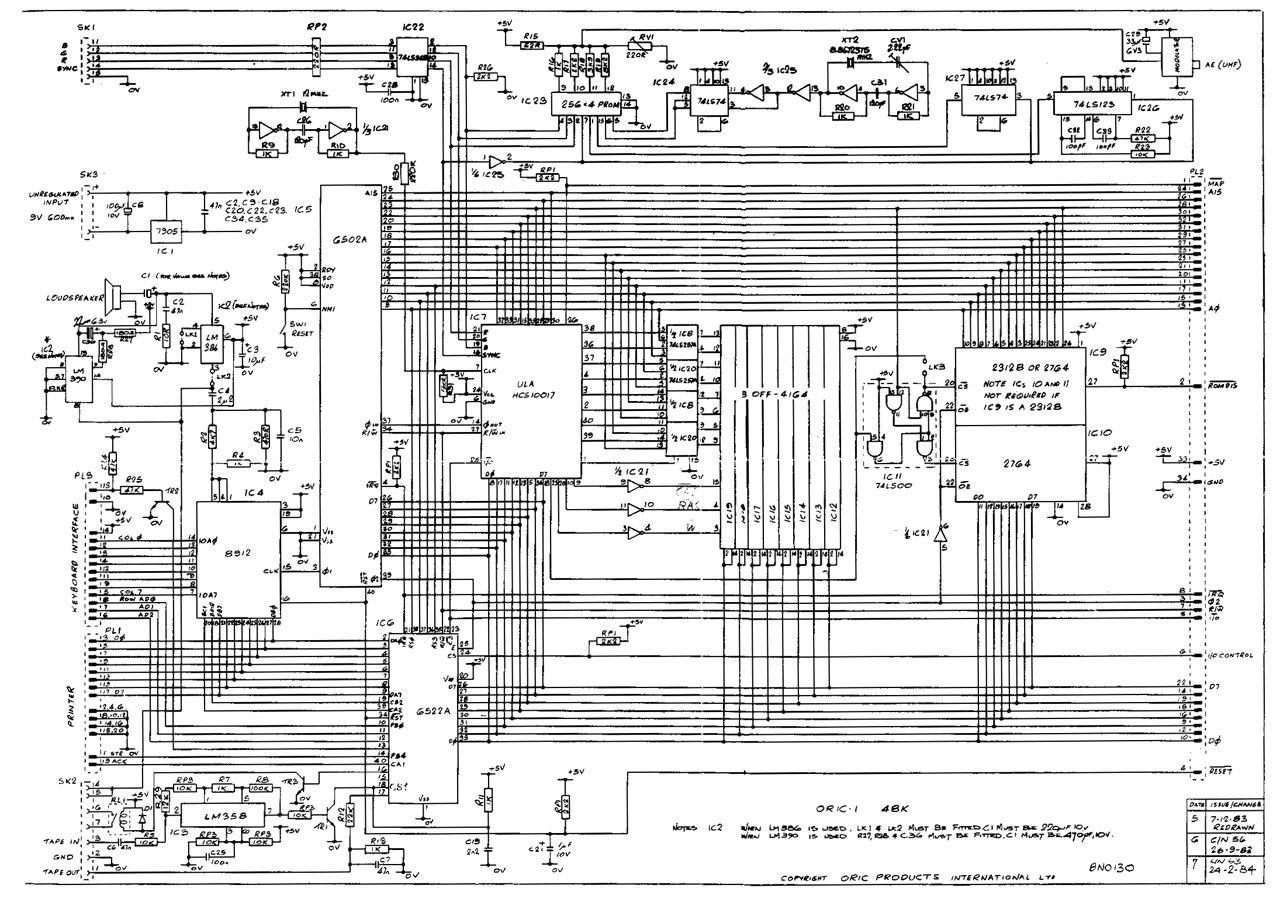
cores/oric_spartan6/test1/doc/oric_schema.jpg
