nikiiv/zx-uno/cores/spectrum_v2_spartan6/test20/raster_tests/zelda.bmp

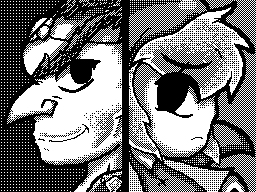
cores/spectrum_v2_spartan6/test20/raster_tests/zelda.bmp
