nikiiv/zx-uno/cores/spectrum_v2_spartan6/test20/timings_pentagon128.png

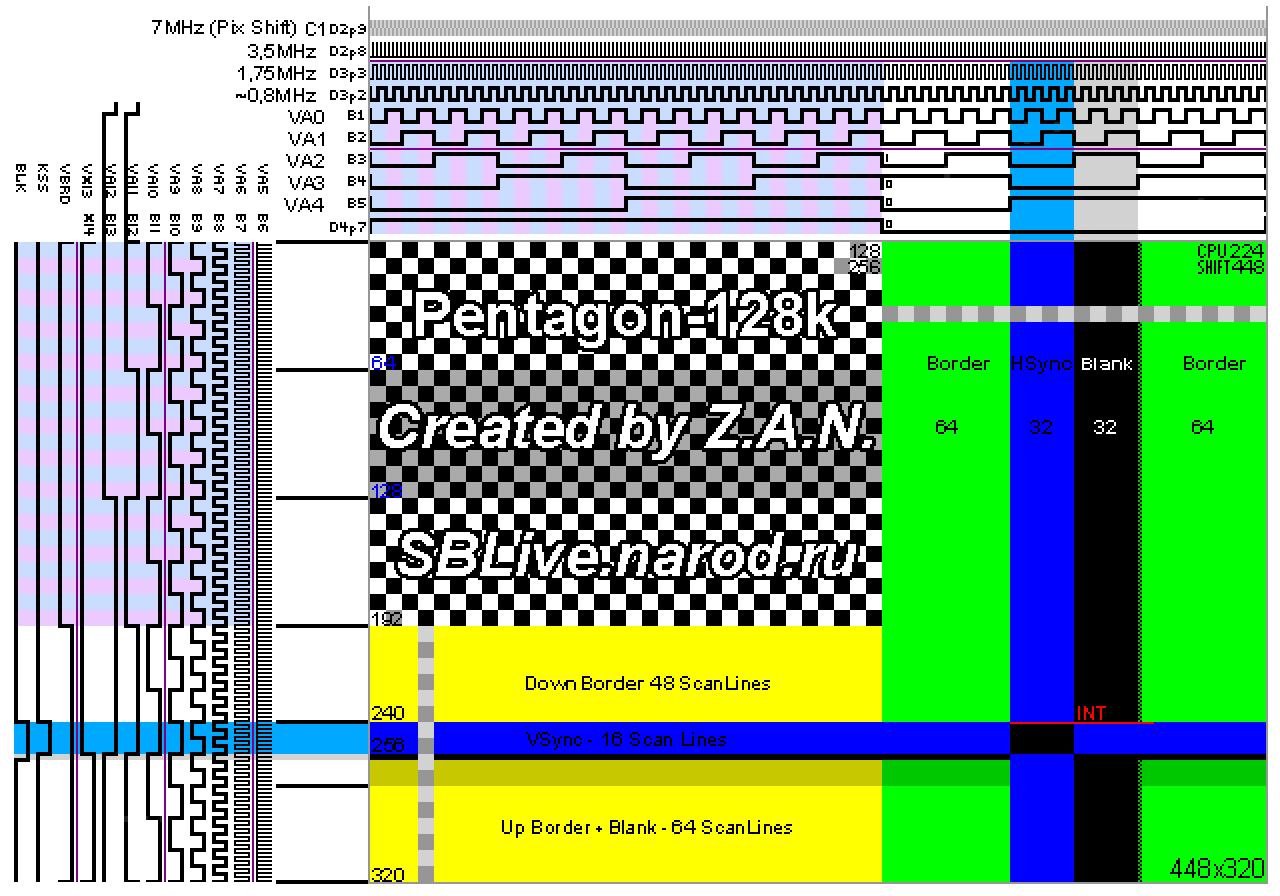
cores/spectrum_v2_spartan6/test20/timings_pentagon128.png
