nikiiv/zx-uno/hardware/otros/ad724/conectores_pcb.pdf

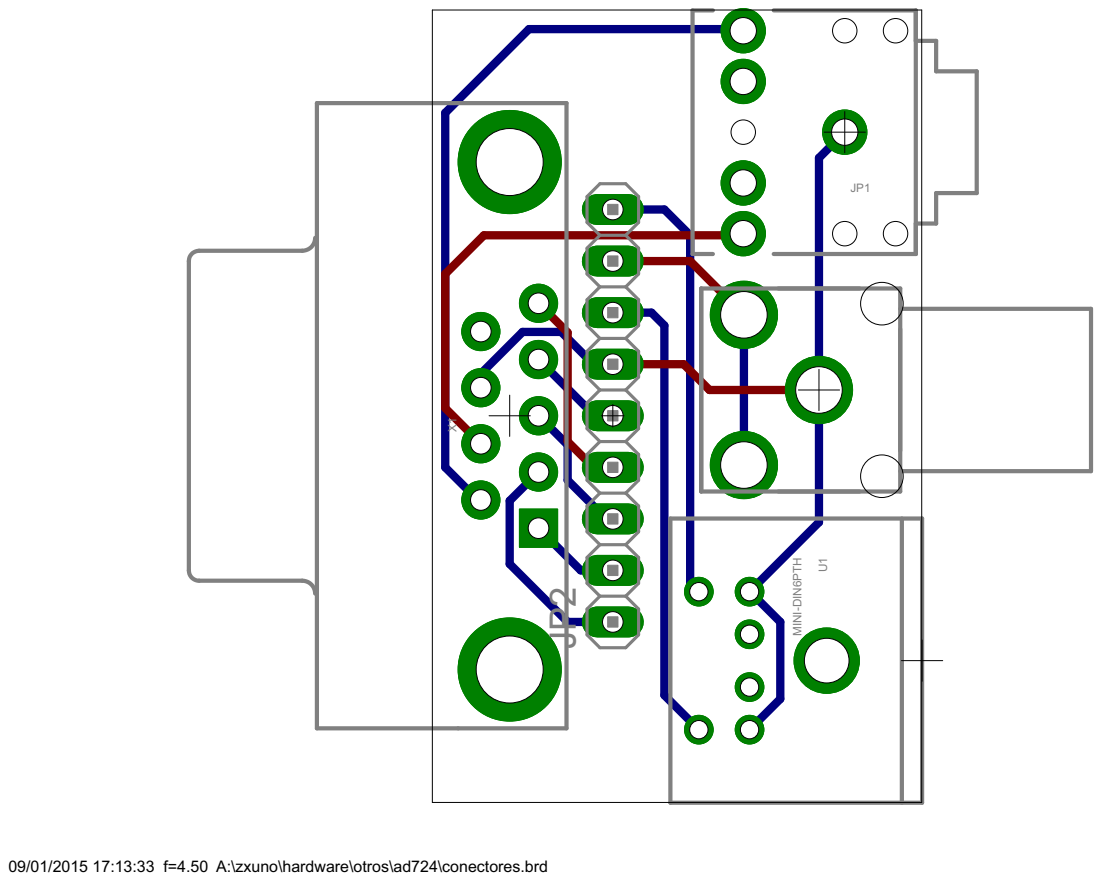
[picture p118: page 1]

09/01/2015 17:13:33 f=4.50 A:\zxuno\hardware\otros\ad724\conectores.brd
