nikiiv/zx-uno/hardware/otros/ad724/conectores_sch.pdf

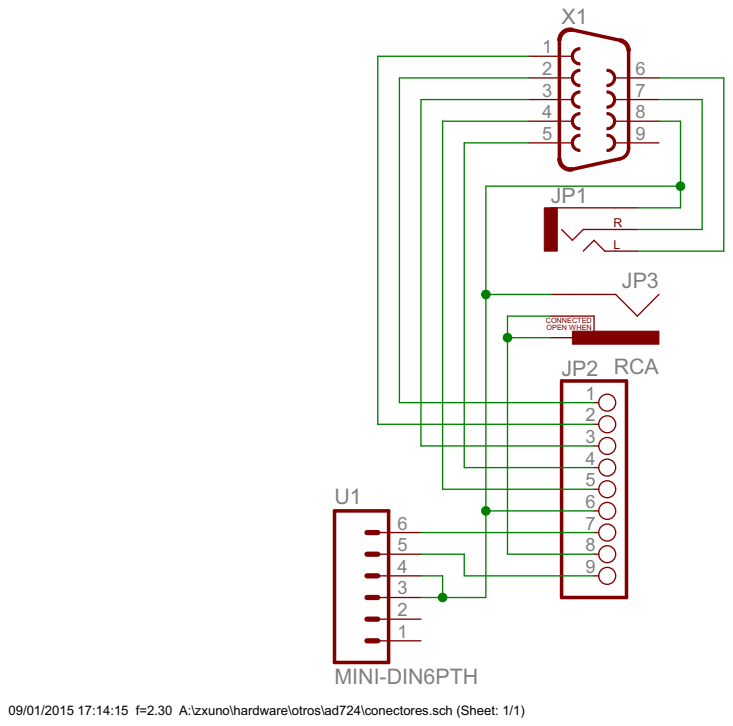
[picture p119: page 1]

7 8

09/01/2015 17:14:15 f=2.30 A:\zxuno\hardware\otros\ad724\conectores.sch (Sheet: 1/1)
