nikiiv/zx-uno/hardware/engendros_celes/Engendro_v1.5/Esquematico/Engendro v1.5_scheme.pdf

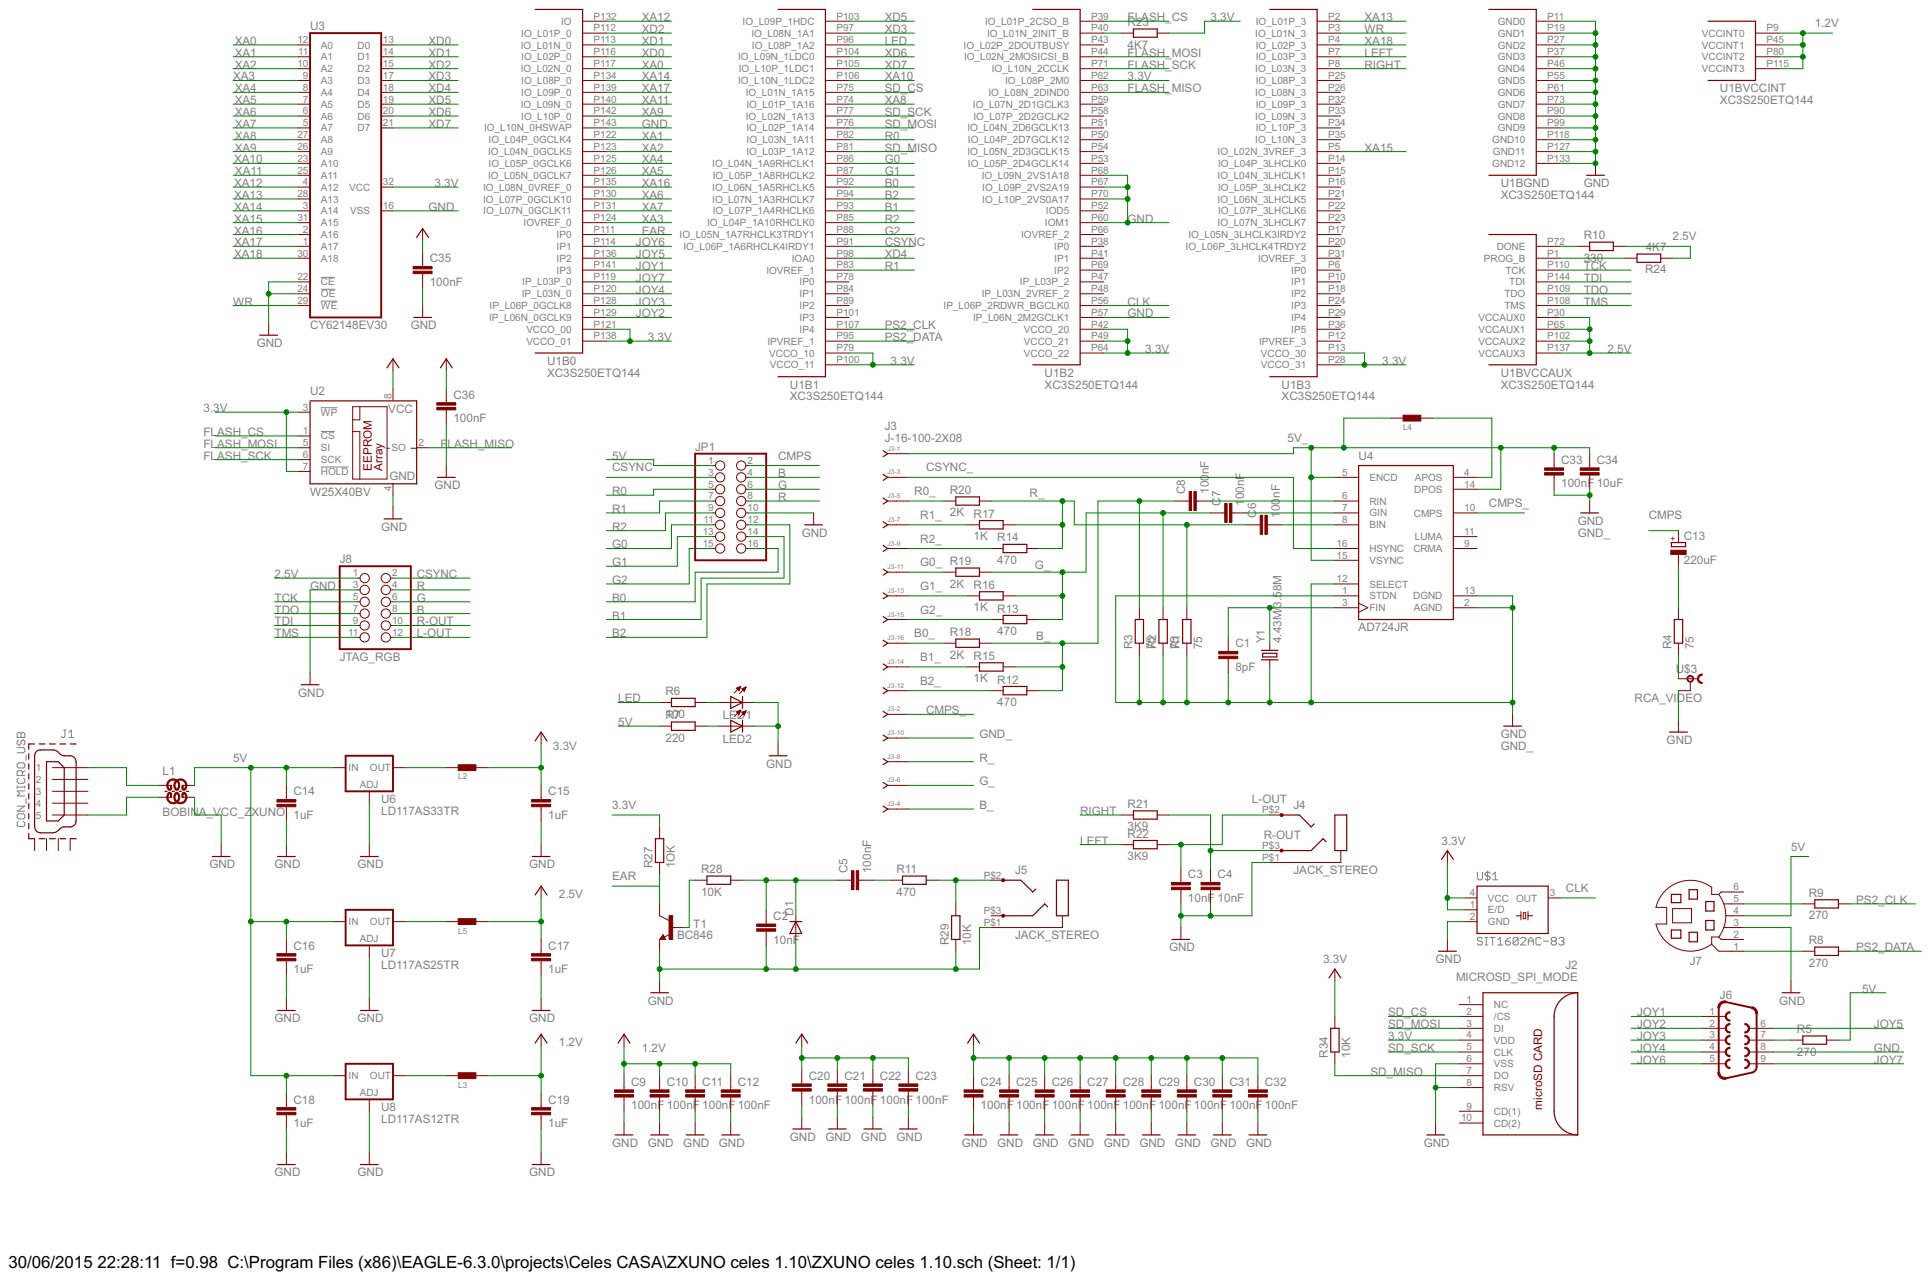
[picture p120: page 1]

30/06/2015 22:28:11 f=0.98 C:\Program Files (x86)\EAGLE-6.3.0\projects\Celes CASA\ZXUNO celes 1.10\ZXUNO celes 1.10.sch (Sheet: 1/1)
