nikiiv/zx-uno/hardware/engendros_celes/Engendro_v1.5/Fotolitos PCB_LAYOUTS_LISTAS/engendro_pcb_bottom_1.5.pdf

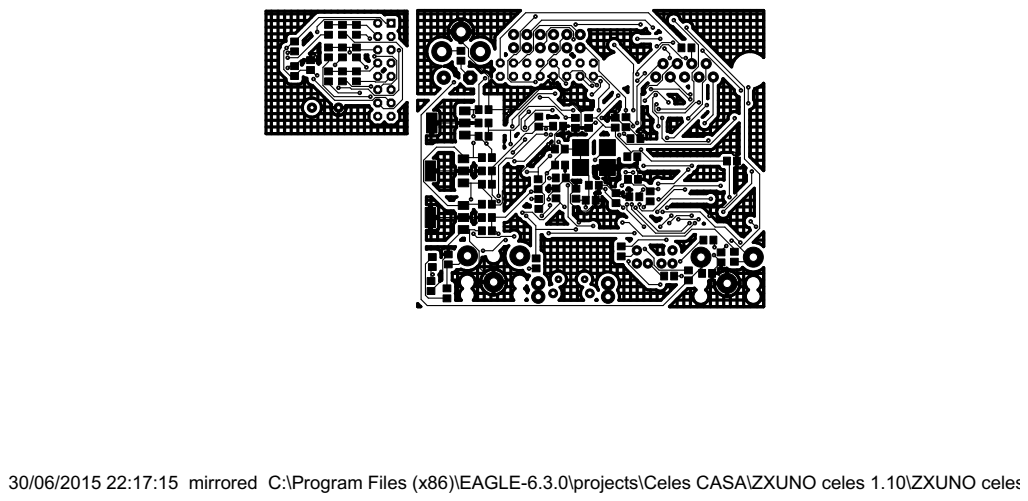
[picture p123: page 1]

30/06/2015 22:17:15 mirrored C:\Program Files (x86)\EAGLE-6.3.0\projects\Celes CASA\ZXUNO celes 1.10\ZXUNO celes 1.10.brd
