nikiiv/zx-uno/software/web/antigua/ficheros/zxuno_v4_pcb.pdf

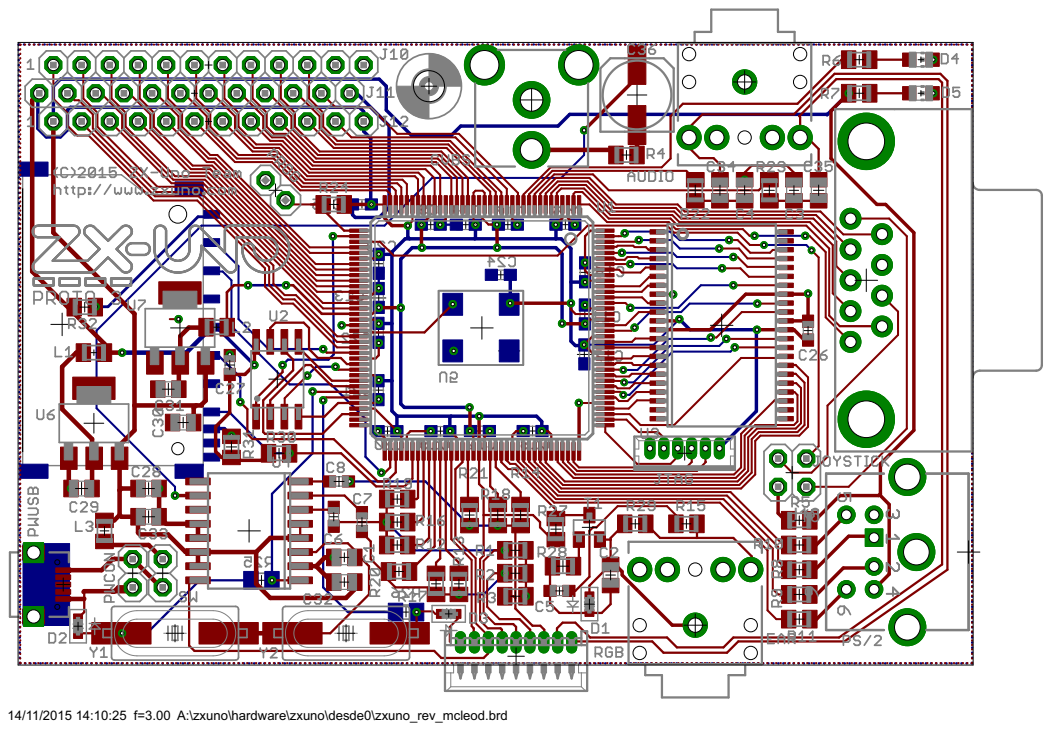
[picture p125: page 1]

14/11/2015 14:10:25 f=3.00 A:\zxuno\hardware\zxuno\desde0\zxuno_rev_mcleod.brd
