nikiiv/zx-uno/software/web/antigua/ficheros/zxuno_v4_sch.pdf

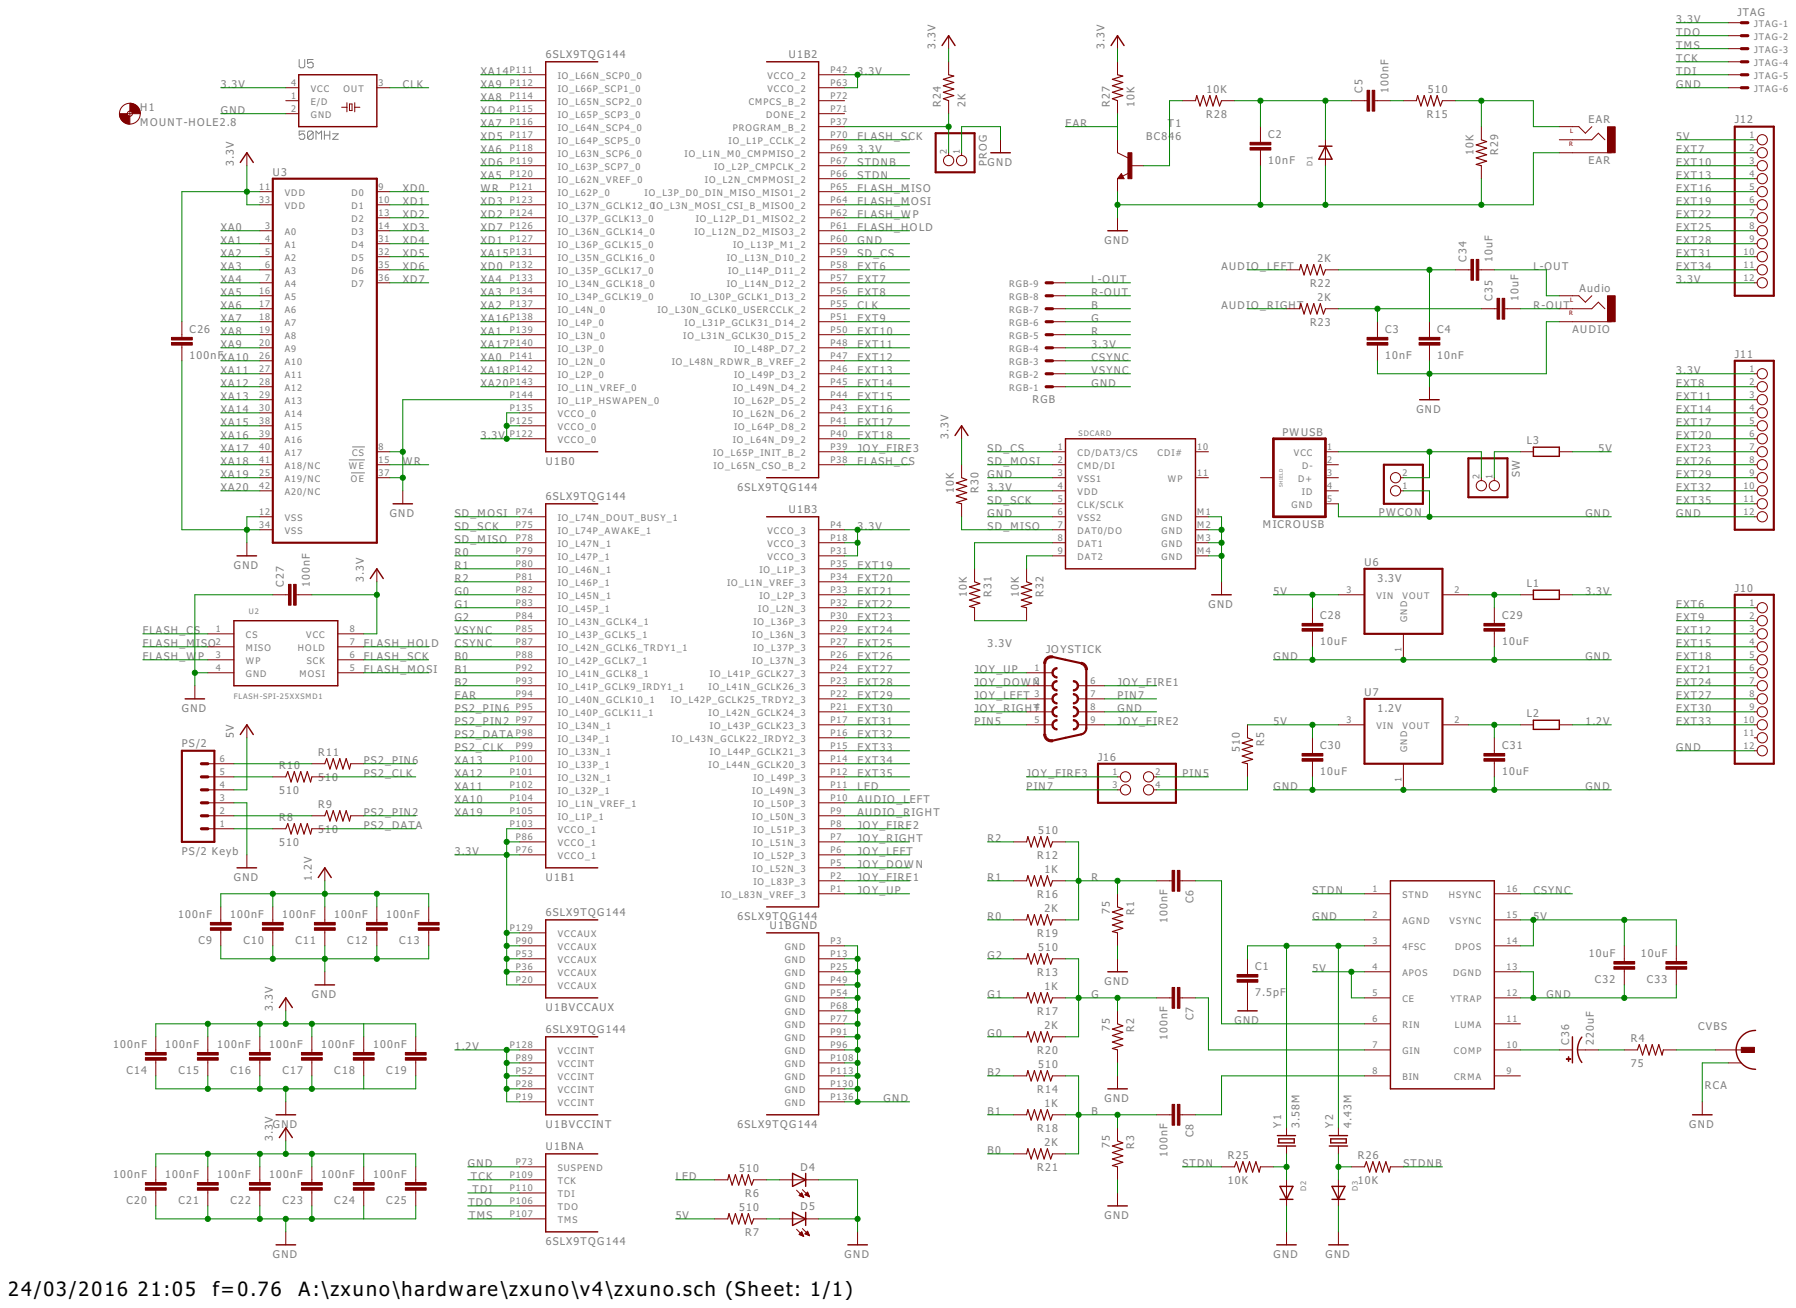
[picture p126: page 1]

L-OUT
RGB-1 RGB-2 RGB-3 RGB-4 RGB-5 RGB-6 RGB-7 RGB-8 RGB-9

24/03/2016 21:05 f=0.76 A:\zxuno\hardware\zxuno\v4\zxuno.sch (Sheet: 1/1)
