nikiiv/zx-uno/hardware/engendros_celes/Engendro_v1/Esquematico/ZXUNO celes 1.7.pdf

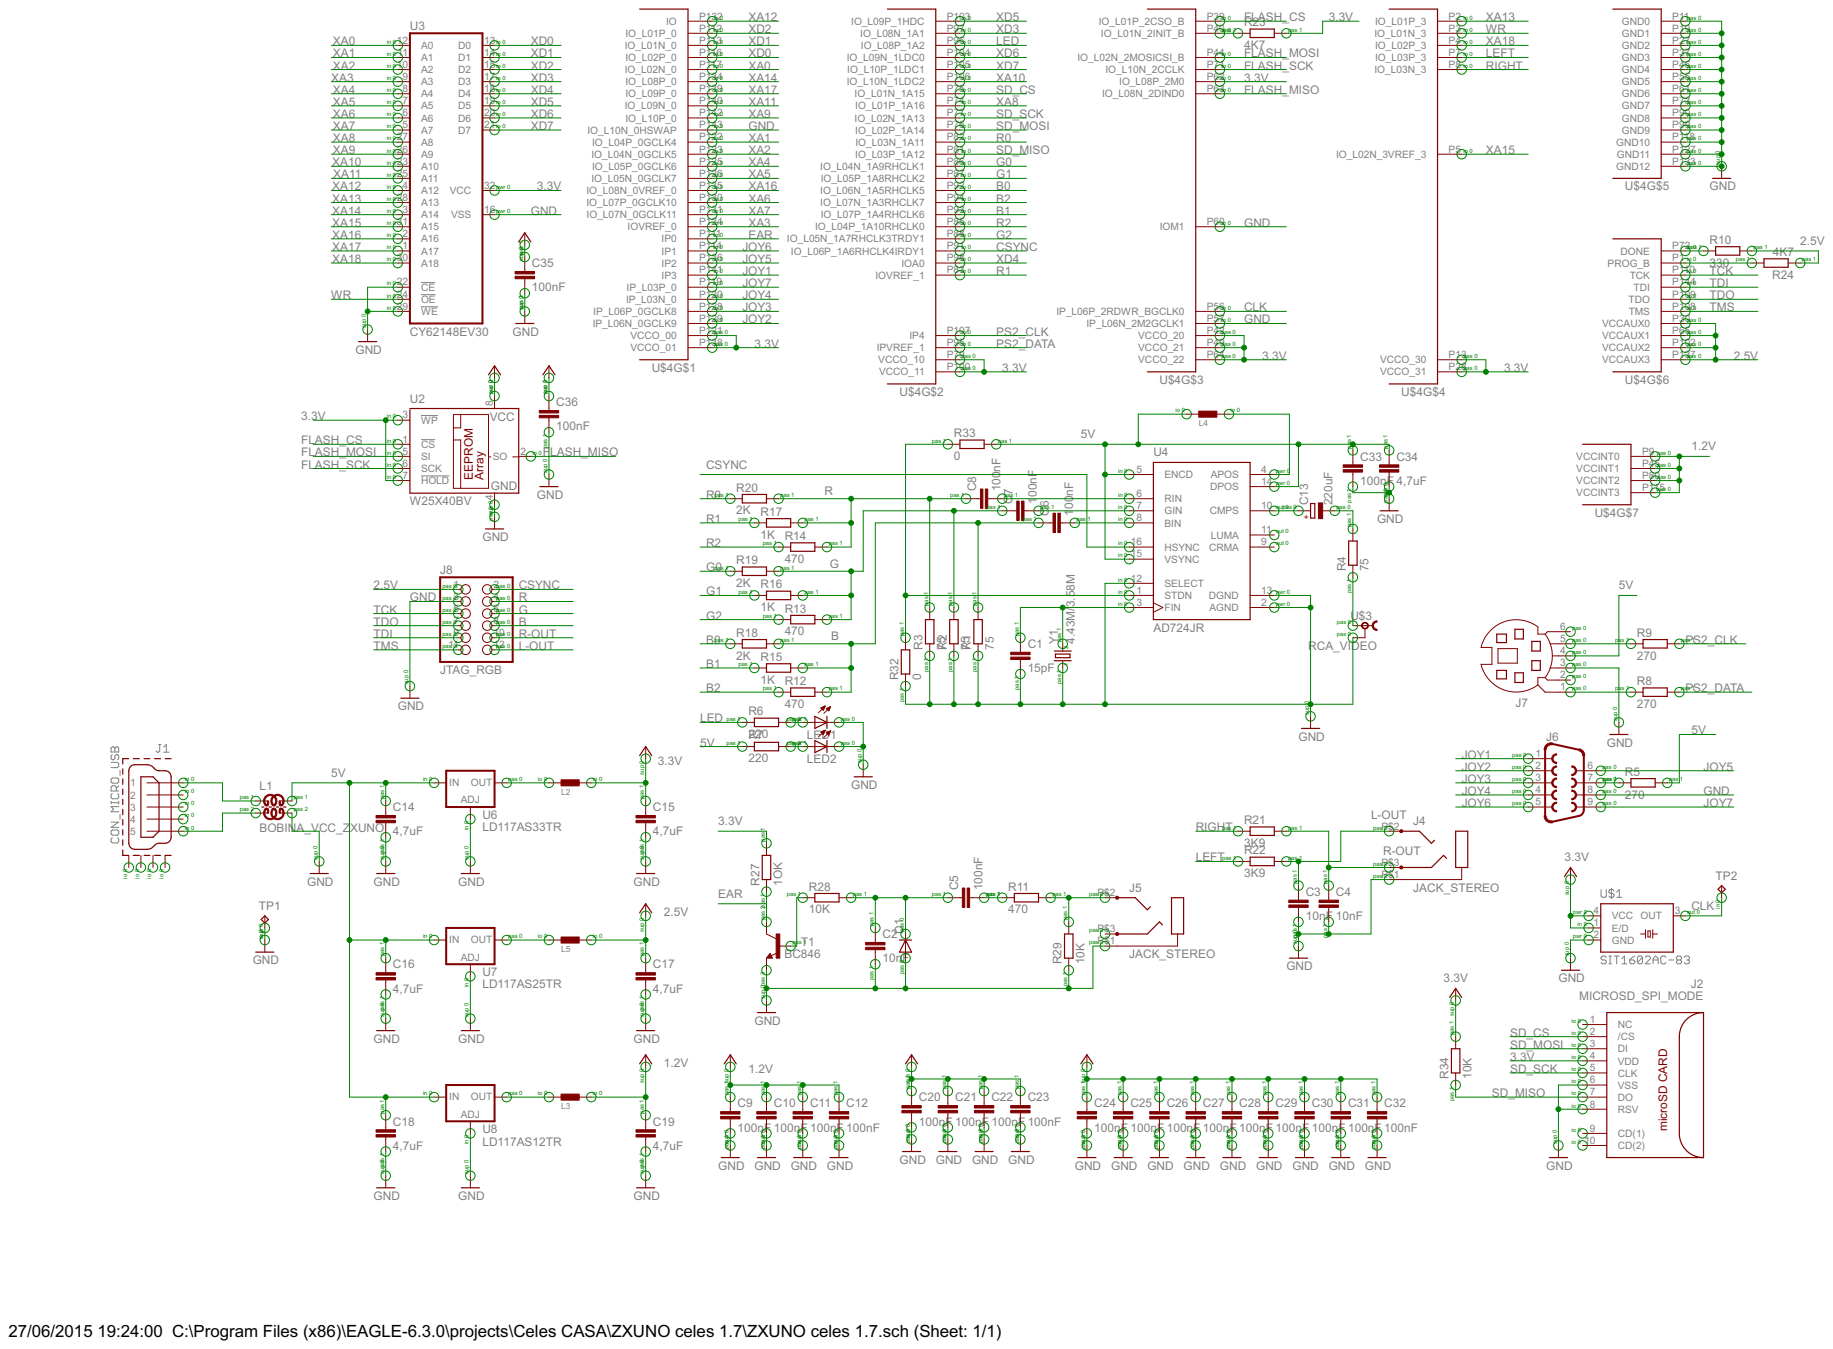
[picture p127: page 1]

27/06/2015 19:24:00 C:\Program Files (x86)\EAGLE-6.3.0\projects\Celes CASA\ZXUNO celes 1.7\ZXUNO celes 1.7.sch (Sheet: 1/1)
