nikiiv/zx-uno/(list of files, drawings)

Other design files:
hardware/hdmi/hdmi_superfo/hdmi addon.PcbDoc
hardware/hdmi/hdmi_superfo/hdmi addon.SchDoc
hardware/USB-PS2/USB-PS2.PcbDoc
hardware/USB-PS2/USB-PS2_1.SchDoc
hardware/zxuno/A++/ZX_UNO_Aplus2.PcbDoc
hardware/zxuno/A++/ZX_UNO_Aplus2.PcbLib
hardware/zxuno/A++/ZX_UNO_Aplus2.PrjPcb
hardware/zxuno/A++/ZX_UNO_Aplus2.SchDoc
hardware/zxuno/A++/ZX_UNO_Aplus2.SchLib
hardware/zxuno/A++/ZX_UNO_Aplus_HAT1.PcbDoc
hardware/zxuno/A++/ZX_UNO_Aplus_HAT1.PcbLib
hardware/zxuno/A++/ZX_UNO_Aplus_HAT1.PrjPcb
hardware/zxuno/A++/ZX_UNO_Aplus_HAT1.SchDoc
hardware/zxuno/A++/ZX_UNO_Aplus_HAT1.SchLib
hardware/zxuno/A++/ZX_UNO_Aplus_HAT2.PcbDoc
hardware/zxuno/A++/ZX_UNO_Aplus_HAT2.PcbLib
hardware/zxuno/A++/ZX_UNO_Aplus_HAT2.PrjPcb
hardware/zxuno/A++/ZX_UNO_Aplus_HAT2.SchDoc
hardware/zxuno/A++/ZX_UNO_Aplus_HAT2.SchLib
hardware/zxuno/A+/zxuno.PcbDoc
hardware/zxuno/A+/zxuno.SchDoc
hardware/zxuno/v1/ZX_UNO_0_12.DSN
hardware/zxuno/v2/zxuno.PcbDoc
hardware/zxuno/v2/zxuno.PrjPCB
hardware/zxuno/v2/zxuno.SchDoc
hardware/zxuno/v3/zxuno.PcbDoc
hardware/zxuno/v3/zxuno.PrjPCB
hardware/zxuno/v3/zxuno.SchDoc
