nikiiv/zx-uno/hardware/unoedge/unoedge_antiguos/zxuno_bus_v1.brd

## EAGLE design hardware/unoedge/unoedge_antiguos/zxuno_bus_v1.brd (2019-06-25, an earlier design)

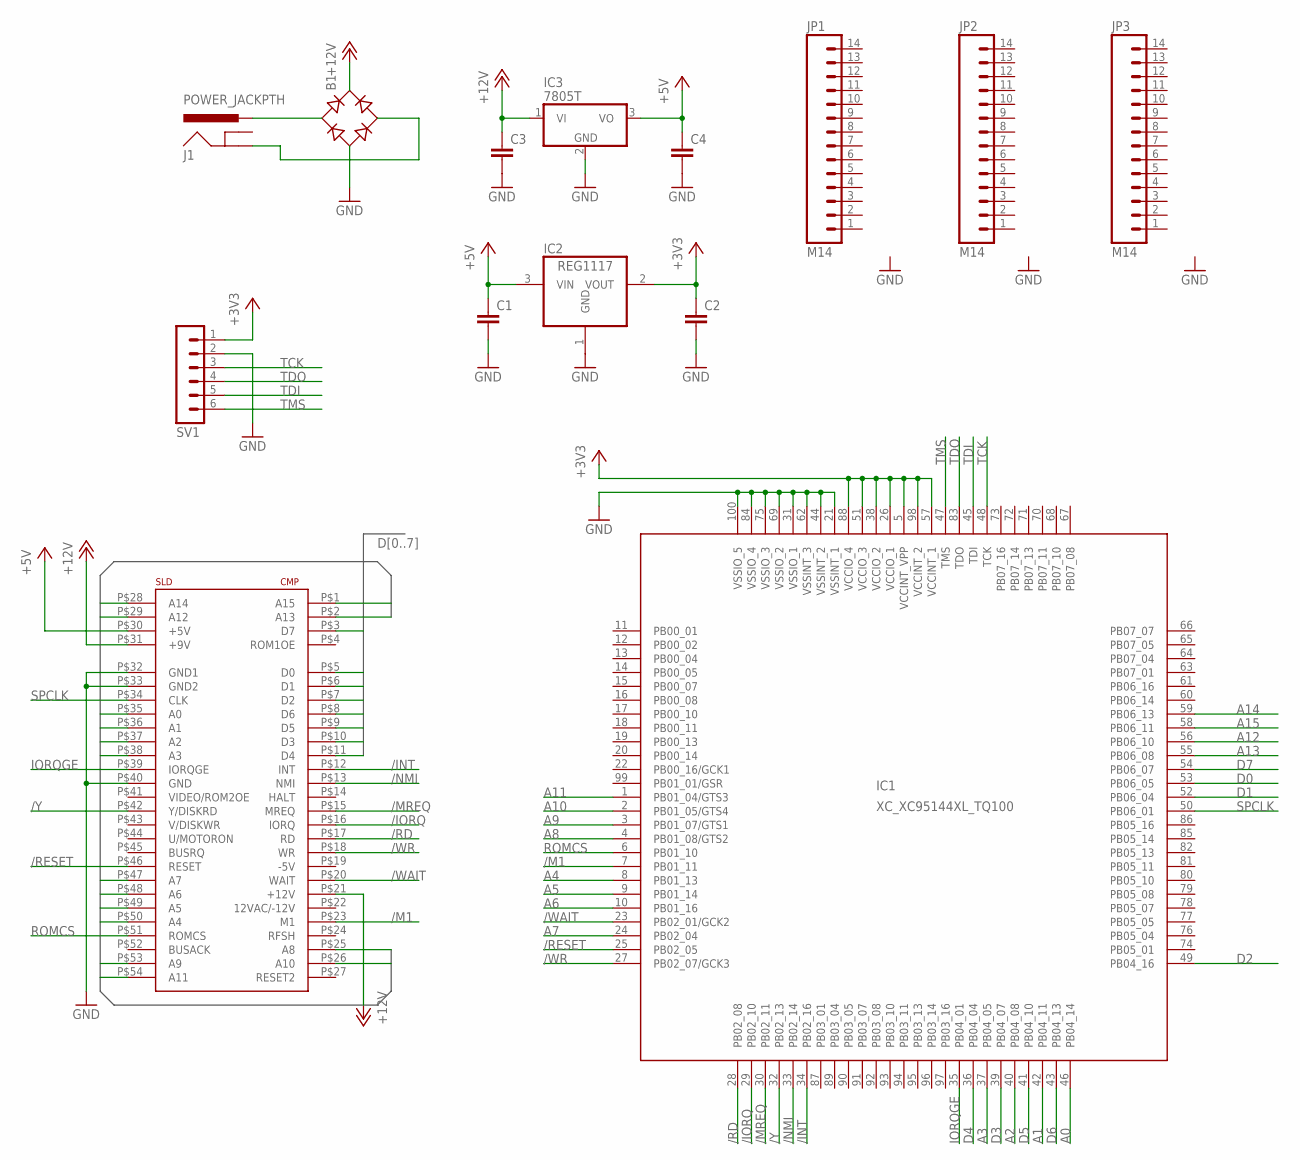
[picture p128: schematic zxuno_bus_v1.sch]

Parts:
B1: RB1A
C1, C2, C3, C4: C-EUC1206K; C1206K
IC1: XC_XC95144XL_TQ100; XC_XC-TQ100
IC2: REG1117; SOT223
IC3: 7805T; TO220H
J1: POWER_JACKPTH; POWER_JACK_PTH
JP1, JP2, JP3: M14; 1X14
SV1: MA06-1
U$1: CONECTOR_EDGE_LADO_SPECTRUM; CONECTOR_LADO_SPECTRUM

Connections:
+3V3: C2.1, IC1.5 (VCCINT_VPP), IC1.26 (VCCIO_1), IC1.38 (VCCIO_2), IC1.51 (VCCIO_3), IC1.57 (VCCINT_1), IC1.88 (VCCIO_4), IC1.98 (VCCINT_2), IC2.2 (VOUT), SV1.1
+5V: C1.1, C4.1, IC2.3 (VIN), IC3.3 (VO), U$1.P$30 (+5V)
+12V: B1.+, C3.1, IC3.1 (VI), U$1.P$21 (+12V), U$1.P$31 (+9V)
/INT: IC1.34 (PB02_16), U$1.P$12 (INT)
/IORQ: IC1.29 (PB02_10), U$1.P$16 (IORQ)
/M1: IC1.7 (PB01_11), U$1.P$23 (M1)
/MREQ: IC1.30 (PB02_11), U$1.P$15 (MREQ)
/NMI: IC1.33 (PB02_14), U$1.P$13 (NMI)
/RD: IC1.28 (PB02_08), U$1.P$17 (RD)
/RESET: IC1.25 (PB02_05), U$1.P$46 (RESET)
/WAIT: IC1.23 (PB02_01/GCK2), U$1.P$20 (WAIT)
/WR: IC1.27 (PB02_07/GCK3), U$1.P$18 (WR)
/Y: IC1.32 (PB02_13), U$1.P$42 (Y/DISKRD)
A0: IC1.46 (PB04_14), U$1.P$35 (A0)
A1: IC1.42 (PB04_11), U$1.P$36 (A1)
A2: IC1.40 (PB04_08), U$1.P$37 (A2)
A3: IC1.37 (PB04_05), U$1.P$38 (A3)
A4: IC1.8 (PB01_13), U$1.P$50 (A4)
A5: IC1.9 (PB01_14), U$1.P$49 (A5)
A6: IC1.10 (PB01_16), U$1.P$48 (A6)
A7: IC1.24 (PB02_04), U$1.P$47 (A7)
A8: IC1.4 (PB01_08/GTS2), U$1.P$25 (A8)
A9: IC1.3 (PB01_07/GTS1), U$1.P$53 (A9)
A10: IC1.2 (PB01_05/GTS4), U$1.P$26 (A10)
A11: IC1.1 (PB01_04/GTS3), U$1.P$54 (A11)
A12: IC1.56 (PB06_10), U$1.P$29 (A12)
A13: IC1.55 (PB06_08), U$1.P$2 (A13)
A14: IC1.59 (PB06_13), U$1.P$28 (A14)
A15: IC1.58 (PB06_11), U$1.P$1 (A15)
D0: IC1.53 (PB06_05), U$1.P$5 (D0)
D1: IC1.52 (PB06_04), U$1.P$6 (D1)
D2: IC1.49 (PB04_16), U$1.P$7 (D2)
D3: IC1.39 (PB04_07), U$1.P$10 (D3)
D4: IC1.36 (PB04_04), U$1.P$11 (D4)
D5: IC1.41 (PB04_10), U$1.P$9 (D5)
D6: IC1.43 (PB04_13), U$1.P$8 (D6)
D7: IC1.54 (PB06_07), U$1.P$3 (D7)
GND: B1.-, C1.2, C2.2, C3.2, C4.2, IC1.21 (VSSINT_1), IC1.31 (VSSIO_1), IC1.44 (VSSINT_2), IC1.62 (VSSINT_3), IC1.69 (VSSIO_2), IC1.75 (VSSIO_3), IC1.84 (VSSIO_4), IC1.100 (VSSIO_5), IC2.1 (GND), IC3.2 (GND), SV1.2, U$1.P$32 (GND1), U$1.P$33 (GND2), U$1.P$40 (GND)
IORQGE: IC1.35 (PB04_01), U$1.P$39 (IORQGE)
unnamed: B1.AC1, J1.PWR
unnamed: B1.AC2, J1.GND
ROMCS: IC1.6 (PB01_10), U$1.P$51 (ROMCS)
SPCLK: IC1.50 (PB06_01), U$1.P$34 (CLK)
TCK: IC1.48 (TCK), SV1.3
TDI: IC1.45 (TDI), SV1.5
TDO: IC1.83 (TDO), SV1.4
TMS: IC1.47 (TMS), SV1.6

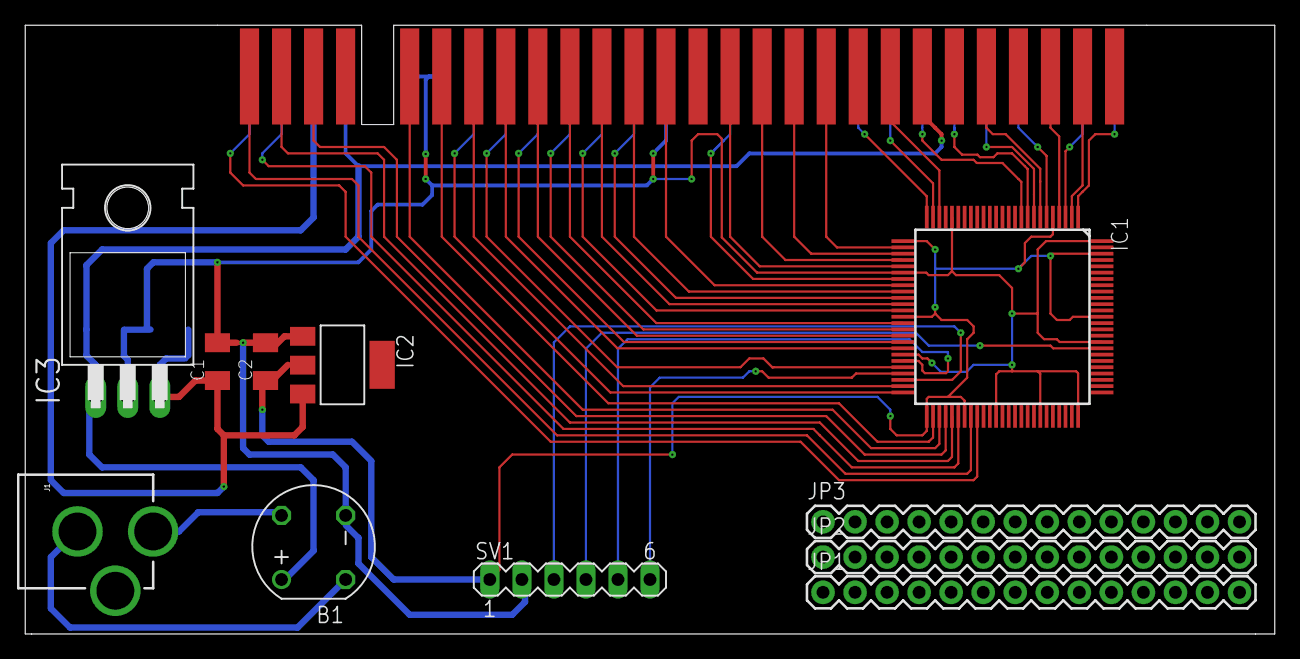
[picture p129: board zxuno_bus_v1.brd from above]

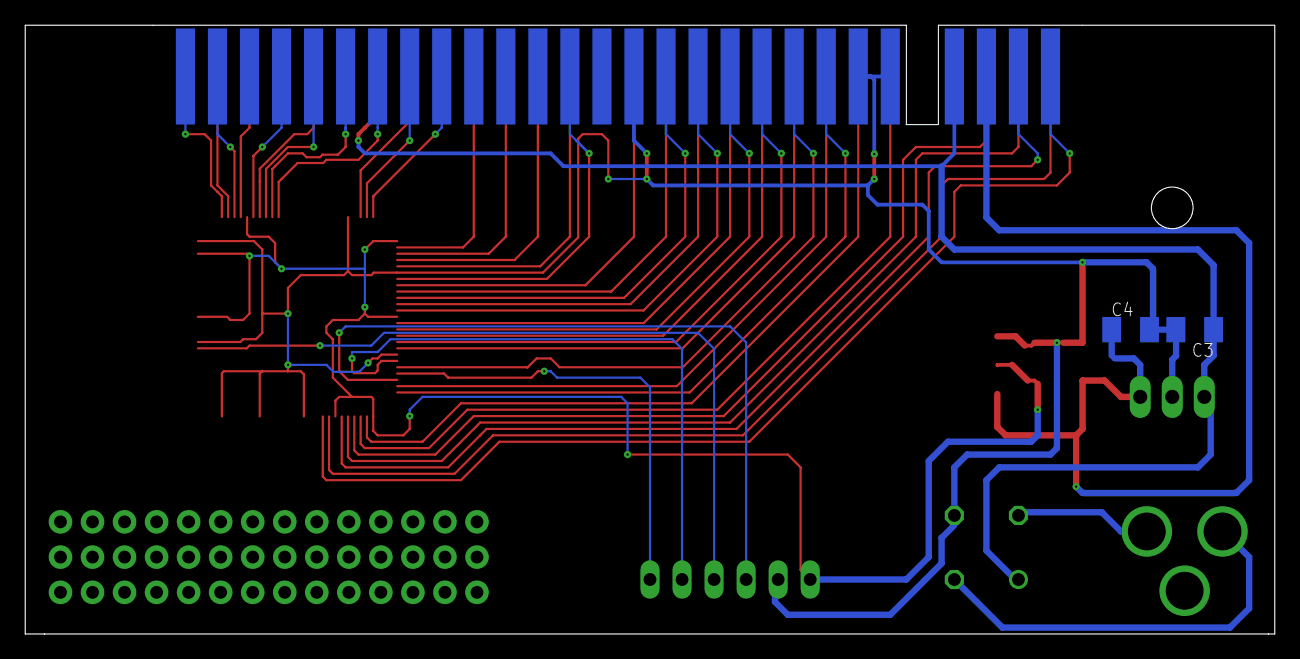
[picture p130: board zxuno_bus_v1.brd from below]

Board: 2 copper layers, 99.1 x 48.3 mm, 14 parts (2 on the bottom side), 47 nets.
