nikiiv/zx-uno/hardware/gomasuno/gomasuno.brd

## EAGLE design hardware/gomasuno/gomasuno.brd (2019-06-25)

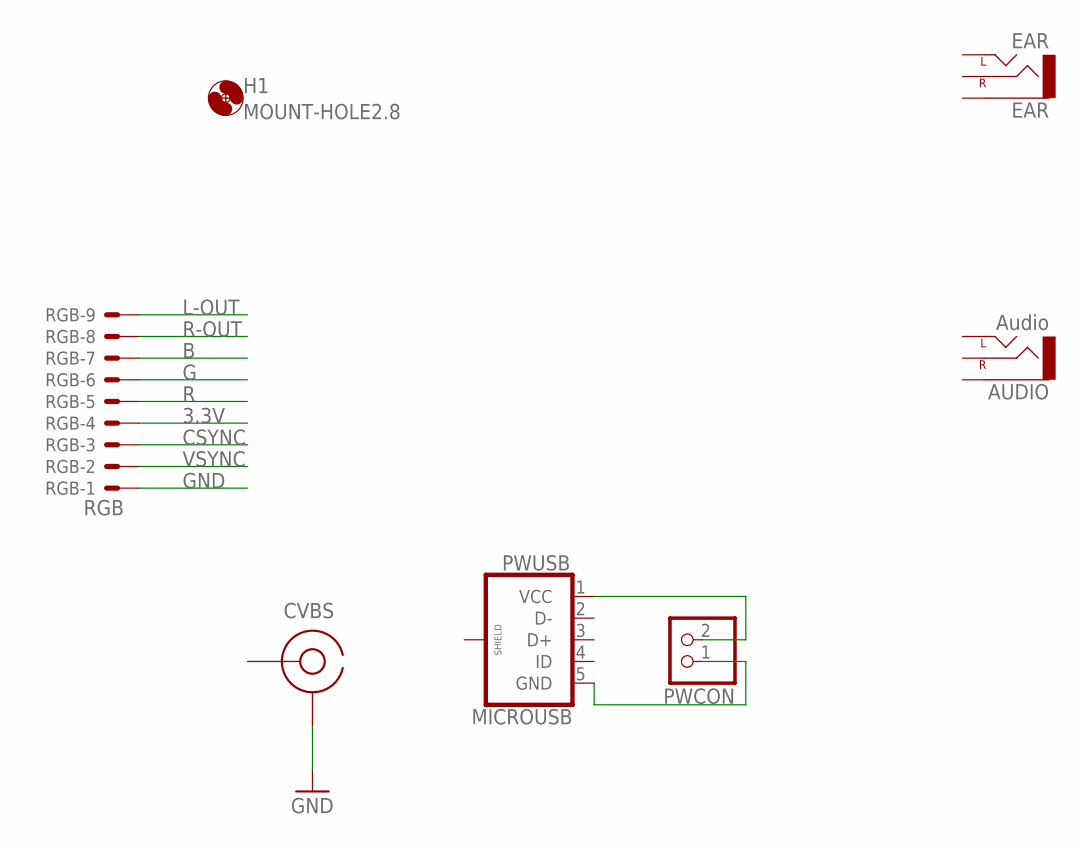
[picture p131: schematic gomasuno.sch]

Parts:
AUDIO: Audio; AUDIO-JACK
CVBS: RCA
EAR: EAR; AUDIO-JACK
H1: MOUNT-HOLE2.8; 2,8
PWCON: PINHD-1X2; 1X02
PWUSB: MICROUSB; MICRO_USB_1PRIMARY
RGB: RGB; 53048-09

Connections:
3.3V: RGB.4
B: RGB.7
CSYNC: RGB.3
G: RGB.6
GND: CVBS.GND, PWCON.1, PWUSB.5 (GND), RGB.1
L-OUT: RGB.9
unnamed: PWCON.2, PWUSB.1 (VCC)
R: RGB.5
R-OUT: RGB.8
VSYNC: RGB.2

Board: 2 copper layers, 7 parts (0 on the bottom side), 2 nets, no tracks yet.
