nikiiv/zx-uno/hardware/wifi/wifi.brd

## EAGLE design hardware/wifi/wifi.brd (2019-06-25)

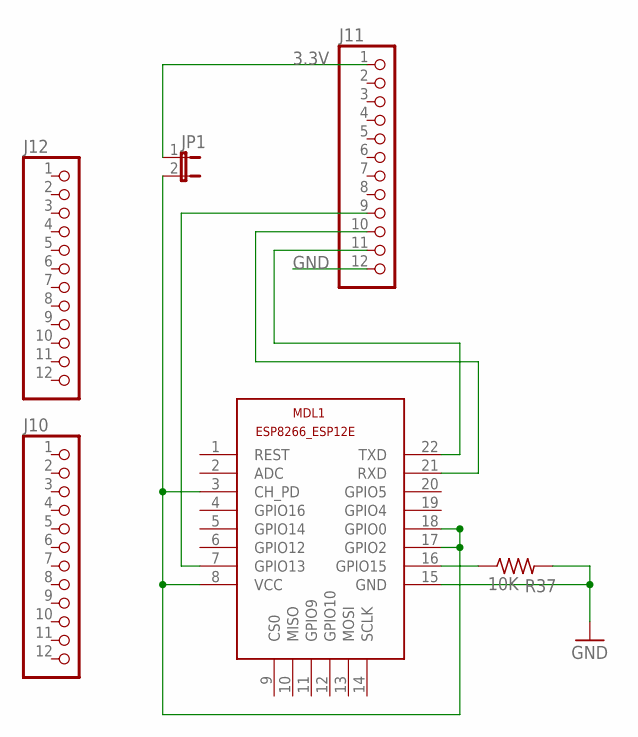
[picture p132: schematic wifi.sch]

Parts:
J10, J11, J12: PINHD-1X12; 1X12
JP1: JP1E; JP1
MDL1: ESP8266-12EESP8266-ESP12E; ESP8266-ESP12E
R37: 10K; R0805

Connections:
3.3V: J11.1, JP1.1
GND: J11.12, MDL1.15 (GND), R37.2
unnamed: MDL1.16 (GPIO15), R37.1
unnamed: J11.9, MDL1.7 (GPIO13)
unnamed: J11.10, MDL1.21 (RXD)
unnamed: J11.11, MDL1.22 (TXD)
VIN: JP1.2, MDL1.3 (CH_PD), MDL1.8 (VCC), MDL1.17 (GPIO2), MDL1.18 (GPIO0)

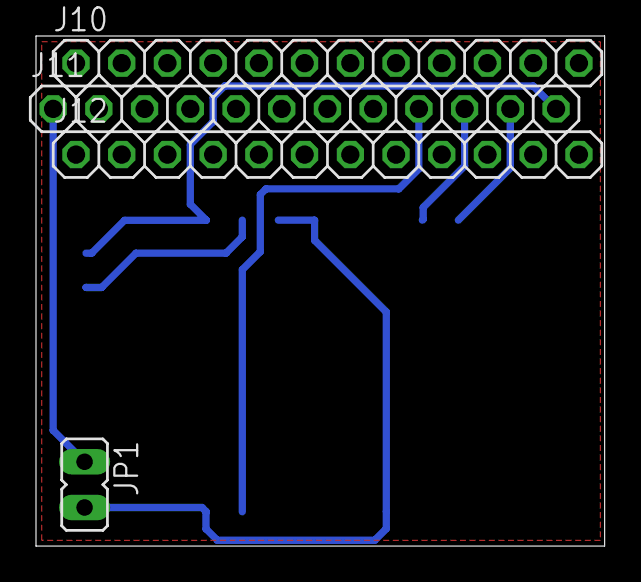
[picture p133: board wifi.brd from above]

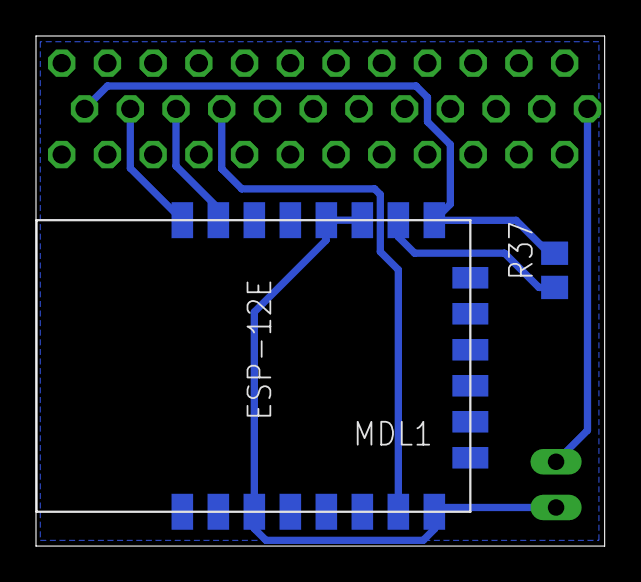
[picture p134: board wifi.brd from below]

Board: 2 copper layers, 31.6 x 28.3 mm, 6 parts (2 on the bottom side), 7 nets.
