nikiiv/zx-uno/hardware/otros/raspberry/berry_4.0.brd

## EAGLE design hardware/otros/raspberry/berry_4.0.brd (2019-06-25)

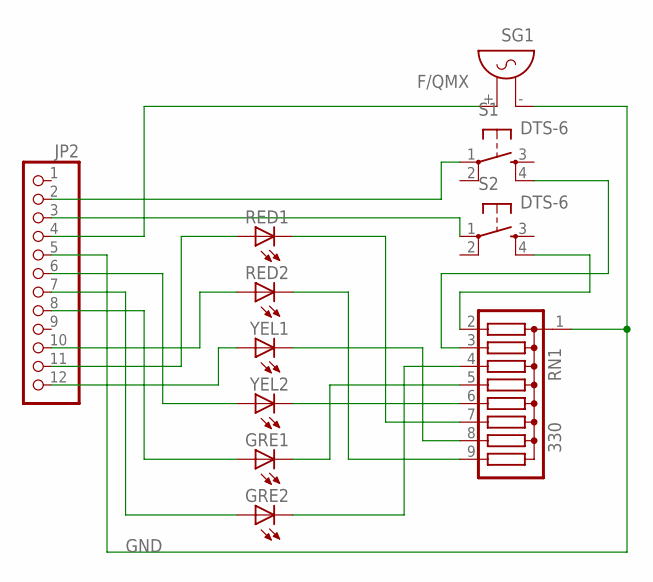
[picture p135: schematic berry_4.0.sch]

Parts:
GRE1, GRE2: LED3MM
JP2: PINHD-1X12; 1X12
RED1, RED2: LED3MM
RN1: 330; SIL9
S1, S2: DTS-6
SG1: F/QMX
YEL1, YEL2: LED3MM

Connections:
GND: JP2.5, RN1.1, SG1.- (1)
unnamed: GRE1.K (C), RN1.5
unnamed: JP2.2, S1.1
unnamed: RN1.8, YEL1.K (C)
unnamed: JP2.10, RED2.A
unnamed: RN1.6, YEL2.K (C)
unnamed: RED2.K (C), RN1.9
unnamed: JP2.4, SG1.+ (2)
unnamed: RED1.K (C), RN1.7
unnamed: GRE2.K (C), RN1.4
unnamed: GRE2.A, JP2.7
unnamed: GRE1.A, JP2.8
unnamed: RN1.2, S2.4
unnamed: RN1.3, S1.4
unnamed: JP2.11, RED1.A
unnamed: JP2.3, S2.1
unnamed: JP2.6, YEL2.A
unnamed: JP2.12, YEL1.A

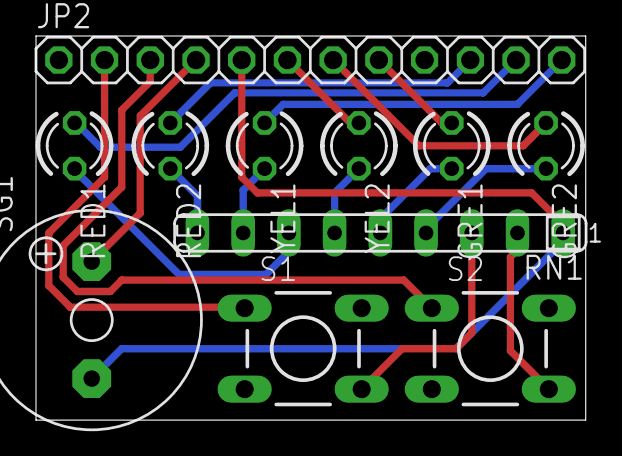
[picture p136: board berry_4.0.brd from above]

Board: 2 copper layers, 30.5 x 21.3 mm, 11 parts (0 on the bottom side), 18 nets.
