nikiiv/zx-uno/hardware/plaquita_z80/z80.brd

## EAGLE design hardware/plaquita_z80/z80.brd (2019-06-25)

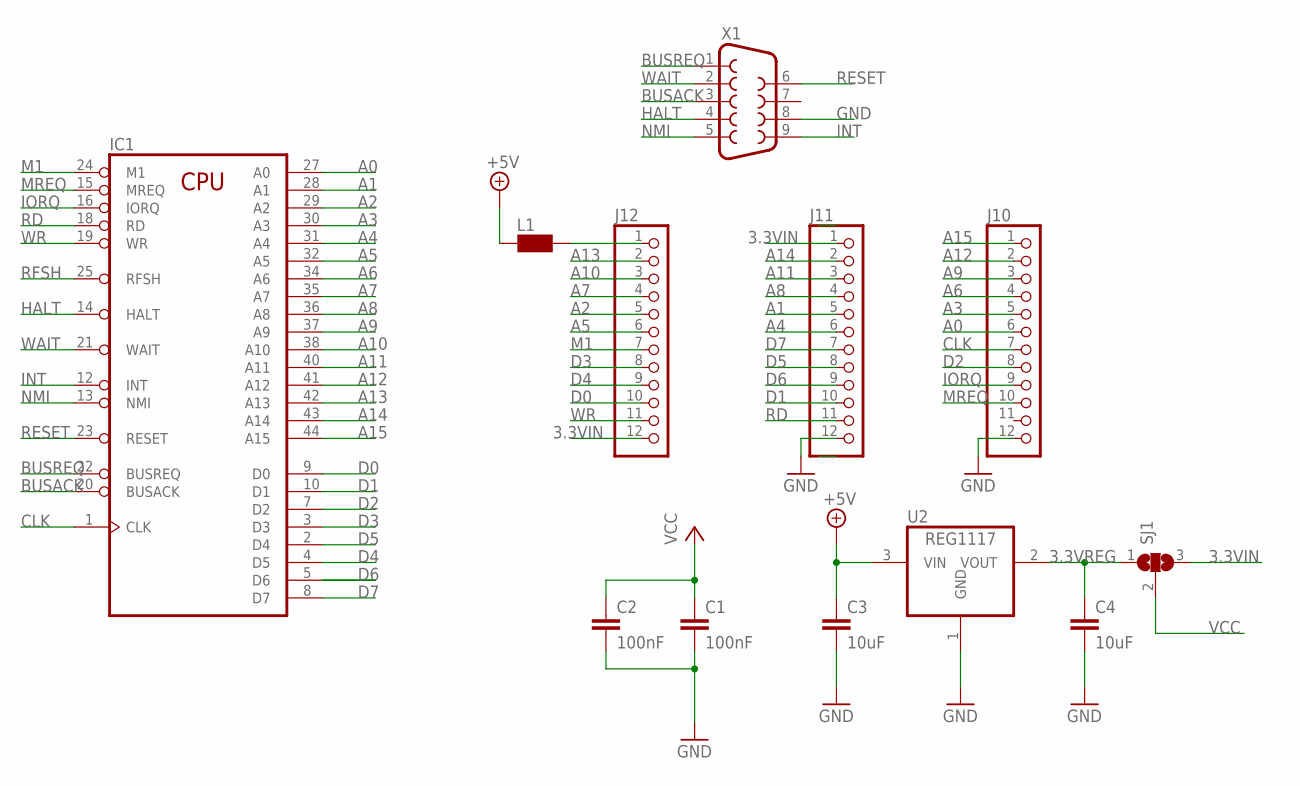
[picture p137: schematic z80.sch]

Parts:
C1, C2: 100nF; C0805K
C3, C4: 10uF; C0805K
IC1: Z80CPU-F; QFP-44
J10, J11, J12: PINHD-1X12; 1X12
L1: WE-CBF_0805; 0805
SJ1: SJ2W; SJ_2
U2: REG1117; SOT223
X1: F09D

Connections:
3.3VIN: J11.1, J12.12, SJ1.3
3.3VREG: C4.1, SJ1.1, U2.2 (VOUT)
+5V: C3.1, L1.2, U2.3 (VIN)
A0: IC1.27 (A0), J10.6
A1: IC1.28 (A1), J11.5
A2: IC1.29 (A2), J12.5
A3: IC1.30 (A3), J10.5
A4: IC1.31 (A4), J11.6
A5: IC1.32 (A5), J12.6
A6: IC1.34 (A6), J10.4
A7: IC1.35 (A7), J12.4
A8: IC1.36 (A8), J11.4
A9: IC1.37 (A9), J10.3
A10: IC1.38 (A10), J12.3
A11: IC1.40 (A11), J11.3
A12: IC1.41 (A12), J10.2
A13: IC1.42 (A13), J12.2
A14: IC1.43 (A14), J11.2
A15: IC1.44 (A15), J10.1
BUSACK: IC1.20 (BUSACK), X1.3
BUSREQ: IC1.22 (BUSREQ), X1.1
CLK: IC1.1 (CLK), J10.7
D0: IC1.9 (D0), J12.10
D1: IC1.10 (D1), J11.10
D2: IC1.7 (D2), J10.8
D3: IC1.3 (D3), J12.8
D4: IC1.4 (D5), J12.9
D5: IC1.2 (D4), J11.8
D6: IC1.5 (D6), J11.9
D7: IC1.8 (D7), J11.7
GND: C1.2, C2.2, C3.2, C4.2, IC1.26 (GND), J10.12, J11.12, U2.1 (GND), X1.8
HALT: IC1.14 (HALT), X1.4
INT: IC1.12 (INT), X1.9
IORQ: IC1.16 (IORQ), J10.9
M1: IC1.24 (M1), J12.7
MREQ: IC1.15 (MREQ), J10.10
unnamed: J12.1, L1.1
NMI: IC1.13 (NMI), X1.5
RD: IC1.18 (RD), J11.11
RESET: IC1.23 (RESET), X1.6
RFSH: IC1.25 (RFSH)
VCC: C1.1, C2.1, IC1.6 (VCC), SJ1.2
WAIT: IC1.21 (WAIT), X1.2
WR: IC1.19 (WR), J12.11

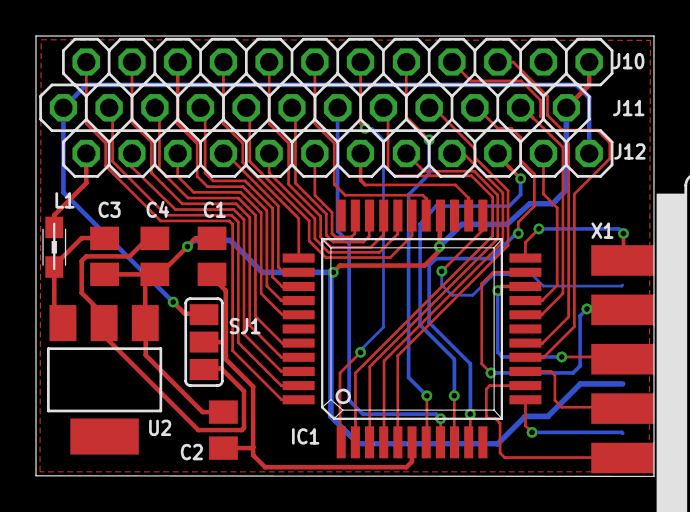
[picture p138: board z80.brd from above]

Board: 2 copper layers, 34.3 x 24.5 mm, 12 parts (0 on the bottom side), 43 nets.
