nikiiv/zx-uno/hardware/multivideo/multivideo.brd

## EAGLE design hardware/multivideo/multivideo.brd (2019-06-25)

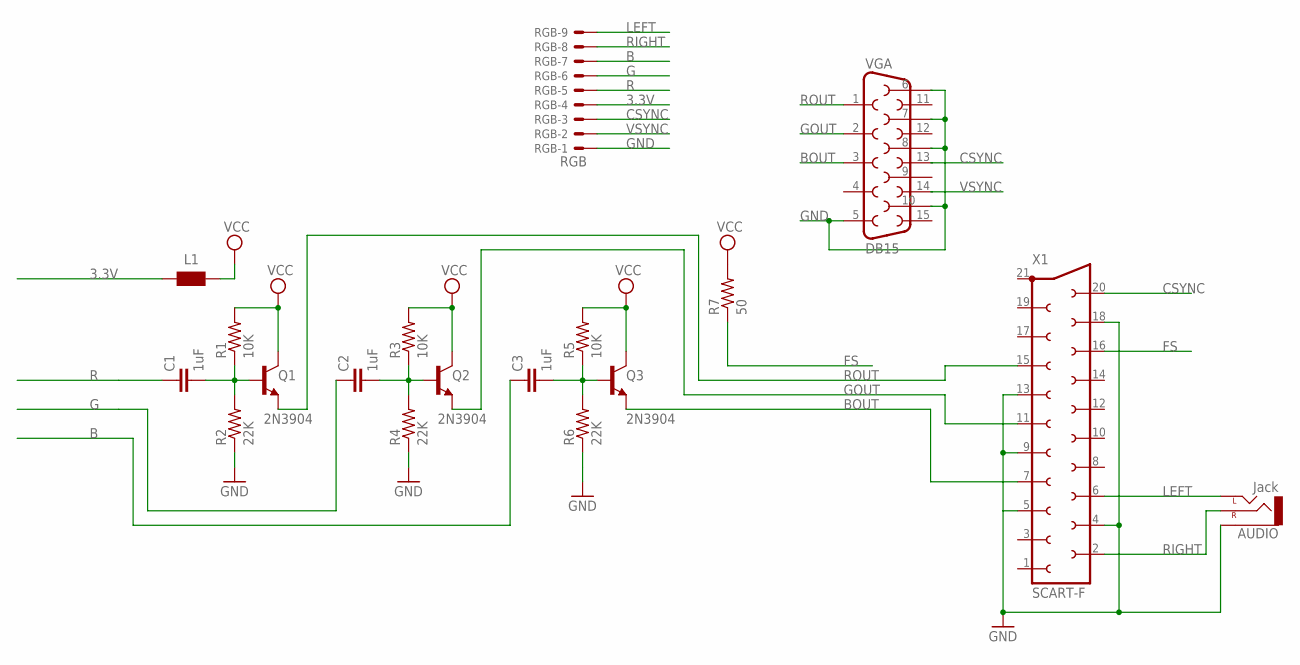
[picture p139: schematic multivideo.sch]

Parts:
AUDIO: Jack; AUDIO-JACK
C1, C2, C3: 1uF; C1206K
L1: WE-CBF_0805; 0805
Q1, Q2, Q3: 2N3904; SOT23
R1, R3, R5: 10K; R0805
R2, R4, R6: 22K; R0805
R7: 50; R0805
RGB: RGB; 53048-09
VGA: DB15
X1: SCART-F

Connections:
3.3V: L1.1, RGB.4
B: C3.1, RGB.7
BOUT: Q3.2 (E), VGA.3, X1.7
CSYNC: RGB.3, VGA.13, X1.20
FS: R7.1, X1.16
G: C2.1, RGB.6
GND: AUDIO.SLEEVE, R2.1, R4.1, R6.1, RGB.1, VGA.5, VGA.6, VGA.7, VGA.8, VGA.10, X1.4, X1.5, X1.9, X1.13, X1.18
GOUT: Q2.2 (E), VGA.2, X1.11
LEFT: AUDIO.TIP (LEFT), RGB.9, X1.6
unnamed: C1.2, Q1.1 (B), R1.1, R2.2
unnamed: C3.2, Q3.1 (B), R5.1, R6.2
unnamed: C2.2, Q2.1 (B), R3.1, R4.2
R: C1.1, RGB.5
RIGHT: AUDIO.RING (RIGHT), RGB.8, X1.2
ROUT: Q1.2 (E), VGA.1, X1.15
VCC: L1.2, Q1.3 (C), Q2.3 (C), Q3.3 (C), R1.2, R3.2, R5.2, R7.2
VSYNC: RGB.2, VGA.14

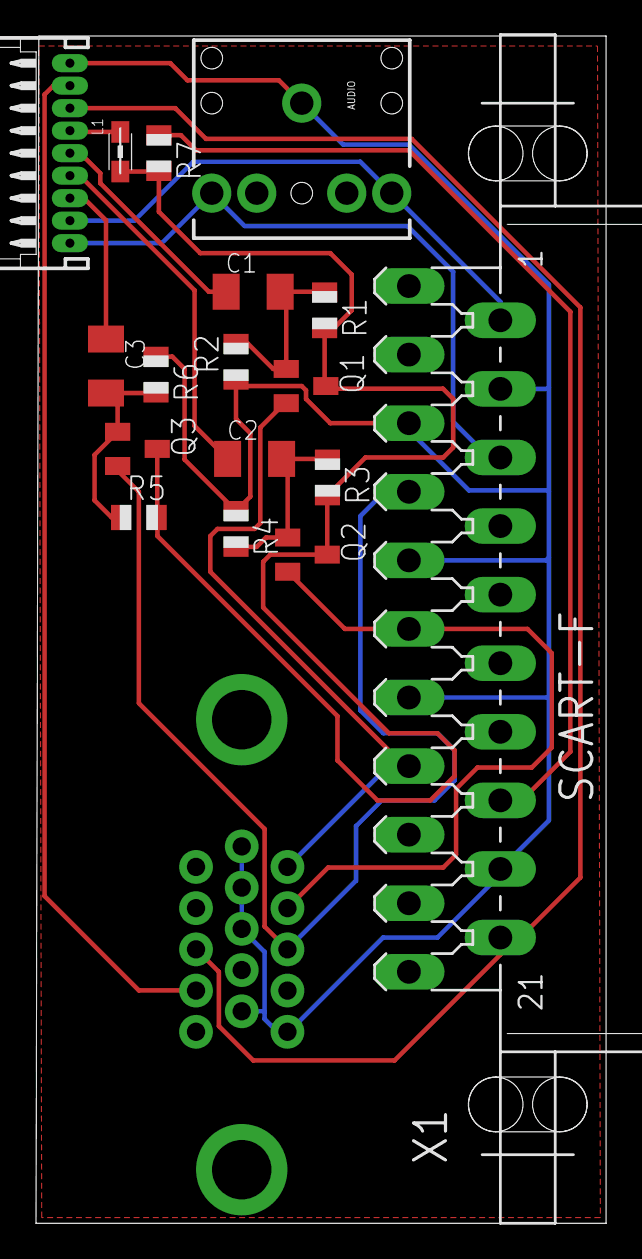
[picture p140: board multivideo.brd from above]

Board: 2 copper layers, 31.7 x 66.0 mm, 18 parts (1 on the bottom side), 17 nets.
