nikiiv/zx-uno/hardware/USB-PS2/USB-PS2.brd

## EAGLE design hardware/USB-PS2/USB-PS2.brd (2019-06-25)

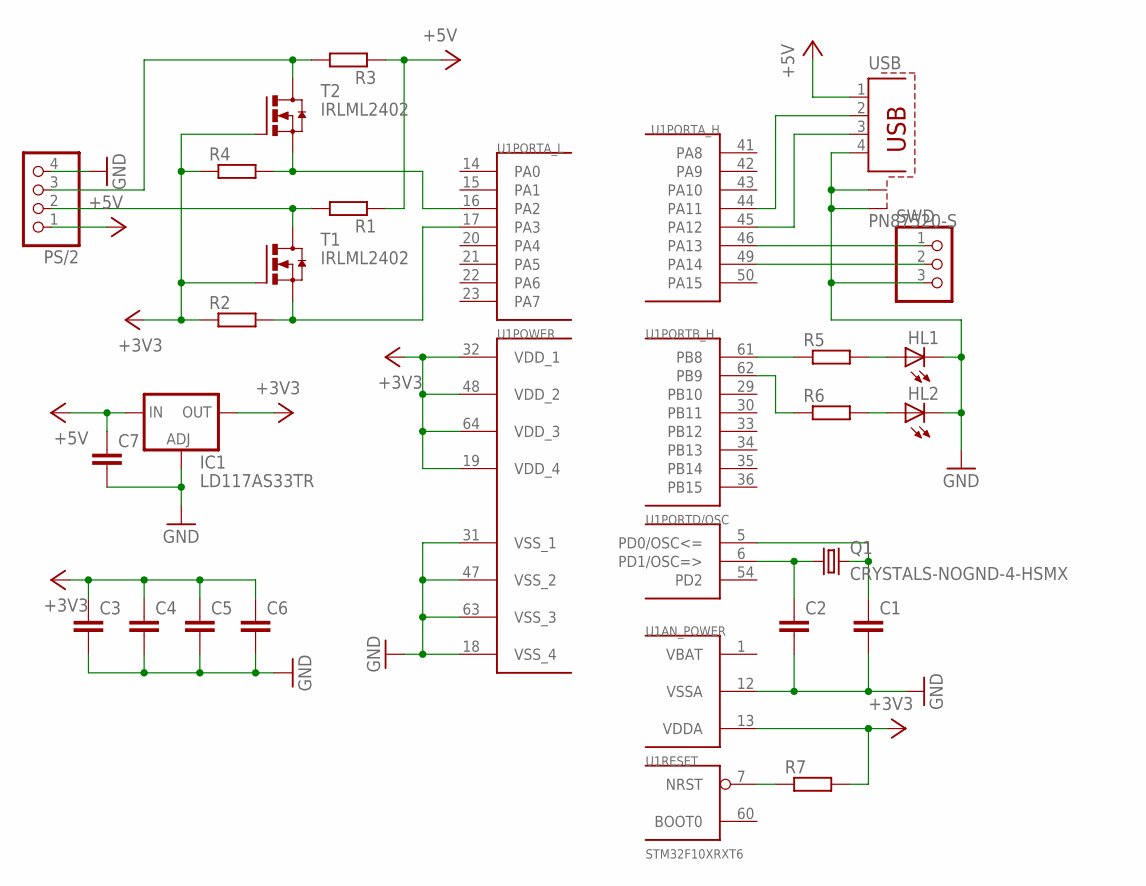
[picture p144: schematic USB-PS2.sch]

Parts:
C1, C2, C3, C4, C5, C6, C7: C-EUC0603K; C0603K
HL1, HL2: LEDSML0805; SML0805
IC1: LD117AS33TR; SOT223
PS/2: PINHD-1X4; 1X04
Q1: CRYSTALS-NOGND-4-HSMX; HC49-4-HSMX
R1, R2, R3, R4, R5, R6, R7: R-EU_R0603; R0603
SWD: PINHD-1X3; 1X03
T1, T2: IRLML2402; MICRO3
U1: STM32F10XRXT6; TQFP64
USB: PN87520-S

Connections:
+3V3: C3.1, C4.1, C5.1, C6.1, IC1.4 (OUT), R2.1, R4.1, R7.2, T1.1 (G), T2.1 (G), U1.13 (VDDA), U1.19 (VDD_4), U1.32 (VDD_1), U1.48 (VDD_2), U1.64 (VDD_3)
+5V: C7.1, IC1.3 (IN), PS/2.1, R1.1, R3.1, USB.1
GND: C1.2, C2.2, C3.2, C4.2, C5.2, C6.2, C7.2, HL1.C, HL2.C, IC1.1 (ADJ), PS/2.4, SWD.3, U1.12 (VSSA), U1.18 (VSS_4), U1.31 (VSS_1), U1.47 (VSS_2), U1.63 (VSS_3), USB.4, USB.S1, USB.S2
unnamed: U1.44 (PA11), USB.2
unnamed: U1.45 (PA12), USB.3
unnamed: R5.1, U1.61 (PB8)
unnamed: C1.1, Q1.2, U1.5 (PD0/OSC<=)
unnamed: HL1.A, R5.2
unnamed: HL2.A, R6.2
unnamed: R6.1, U1.62 (PB9)
unnamed: C2.1, Q1.1, U1.6 (PD1/OSC=>)
unnamed: R7.1, U1.7 (NRST)
unnamed: R2.2, T1.2 (S), U1.17 (PA3)
unnamed: R4.2, T2.2 (S), U1.16 (PA2)
PS2_CLK: PS/2.2, R1.2, T1.3 (D)
PS2_DAT: PS/2.3, R3.2, T2.3 (D)
SWCLK: SWD.2, U1.49 (PA14)
SWDIO: SWD.1, U1.46 (PA13)
VBAT: U1.1 (VBAT)

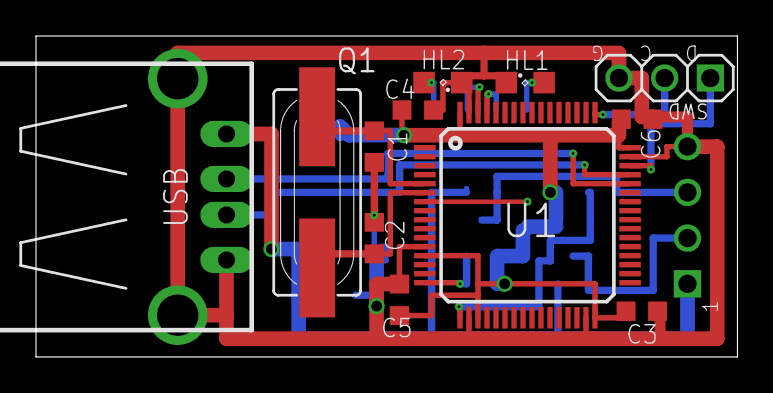
[picture p145: board USB-PS2.brd from above]

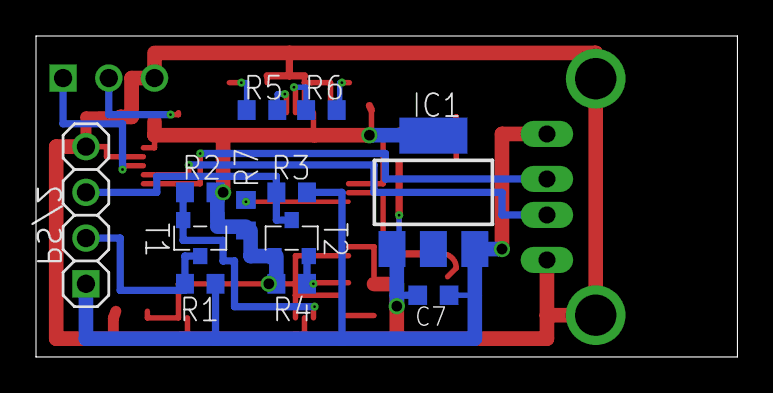
[picture p146: board USB-PS2.brd from below]

Board: 2 copper layers, 39.0 x 17.8 mm, 24 parts (12 on the bottom side), 18 nets.
