nikiiv/zx-uno/hardware/otros/comcon/comcon_version_av_antigua.brd

## EAGLE design hardware/otros/comcon/comcon_version_av_antigua.brd (2019-06-25)

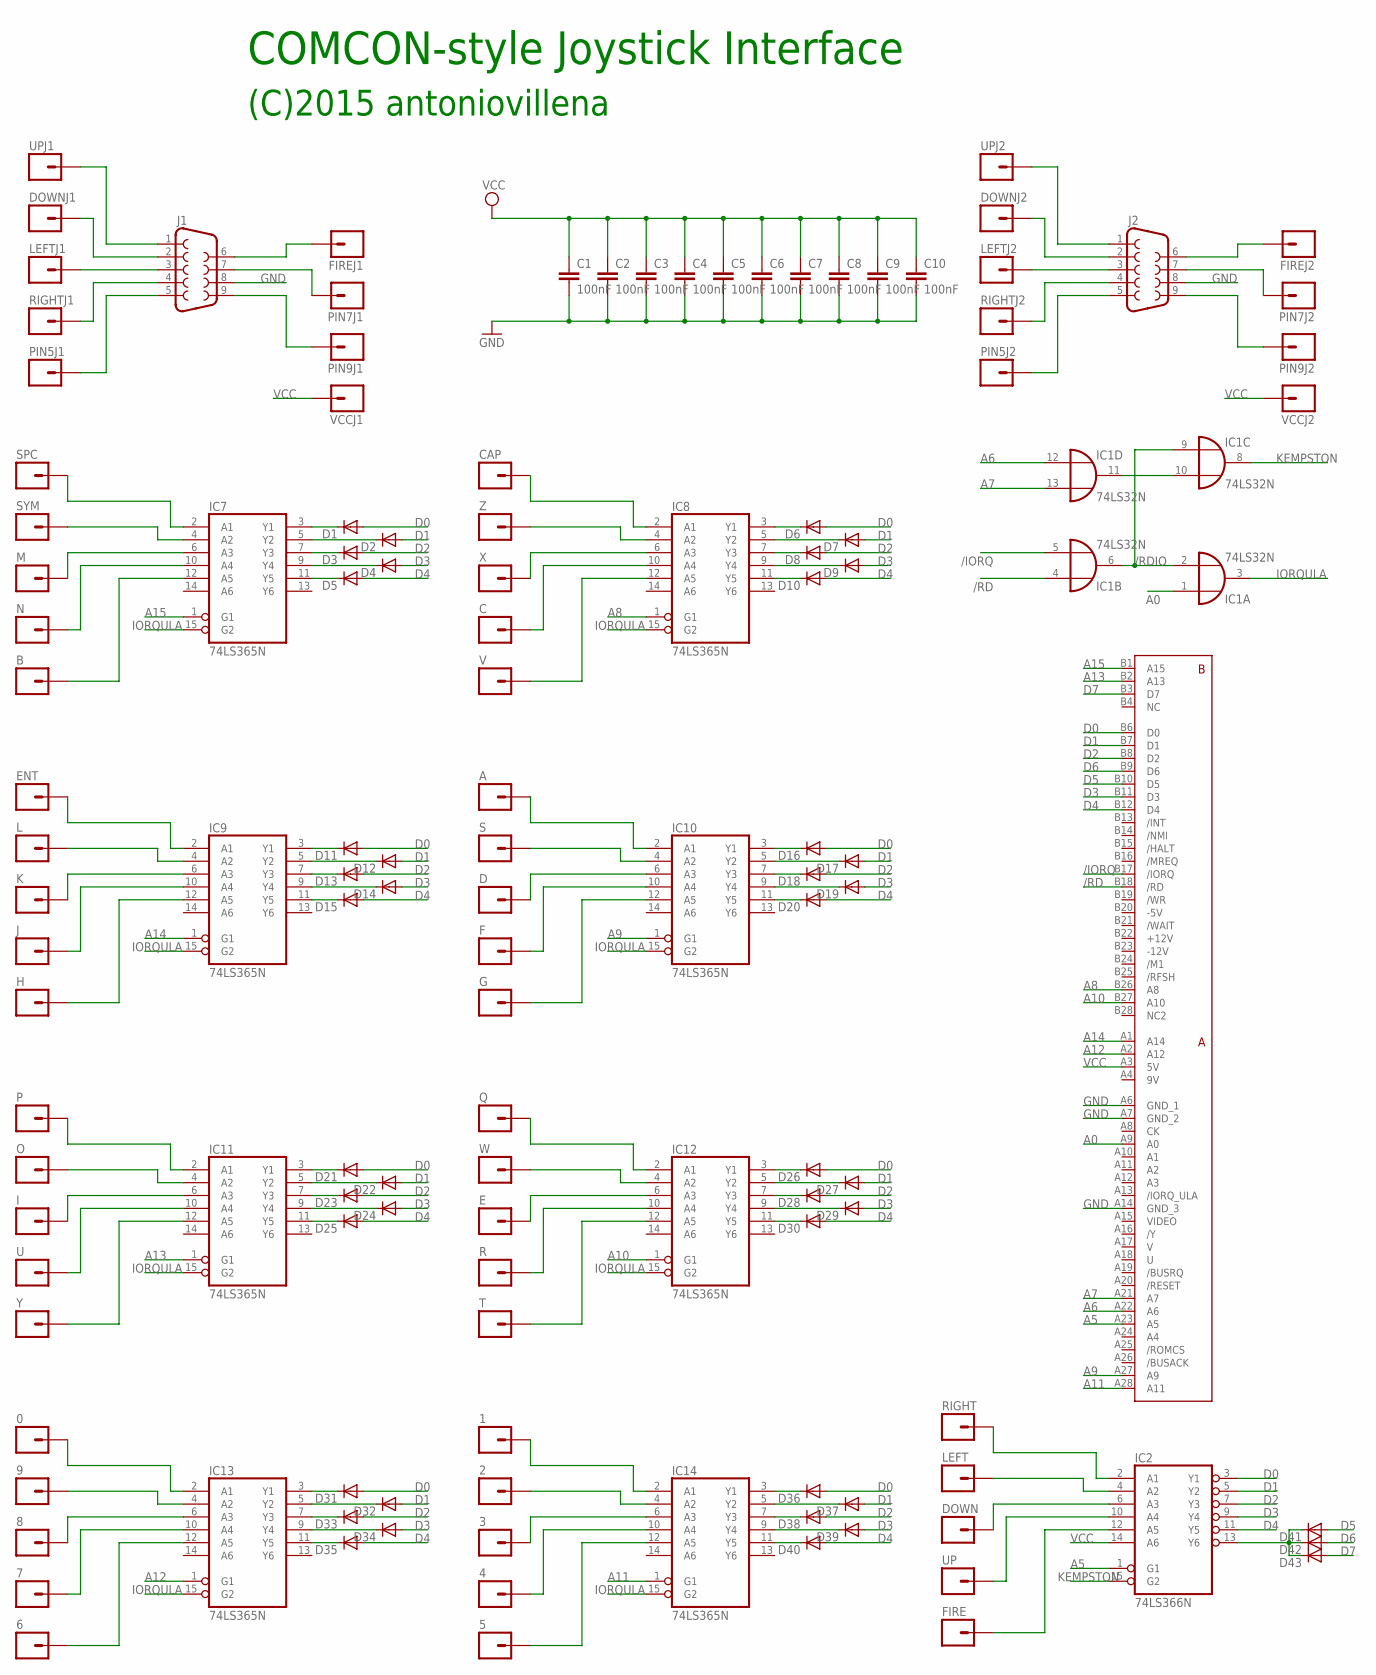
[picture p147: schematic comcon_version_av_antigua.sch]

Parts:
0, 1, 2, 3, 4, 5, 6, 7, 8, 9: M01PTH; 1X01
A: M01PTH; 1X01
B: M01PTH; 1X01
C: M01PTH; 1X01
C1, C2, C3, C4, C5, C6, C7, C8, C9, C10: 100nF; C050-025X075
CAP: M01PTH; 1X01
D: M01PTH; 1X01
D1, D2, D3, D4, D5, D6, D7, D8, D9, D10, D11, D12, D13, D14, D15, D16, D17, D18, D19, D20, D21, D22, D23, D24, D25, D26, D27, D28, D29, D30, D31, D32, D33, D34, D35, D36, D37, D38, D39, D40, D43: 1N4148DO35-7; DO35-7
D41, D42: 1N4148DO35-10; DO35-10
DOWN: M01PTH; 1X01
DOWNJ1, DOWNJ2: M01PTH; 1X01
E: M01PTH; 1X01
ENT: M01PTH; 1X01
F: M01PTH; 1X01
FIRE: M01PTH; 1X01
FIREJ1, FIREJ2: M01PTH; 1X01
G: M01PTH; 1X01
H: M01PTH; 1X01
I: M01PTH; 1X01
IC1: 74LS32N; DIL14
IC2: 74LS366N; DIL16
IC7, IC8, IC9, IC10, IC11, IC12, IC13, IC14: 74LS365N; DIL16
J: M01PTH; 1X01
J1, J2: DB9MALE; DB9_MALE
K: M01PTH; 1X01
L: M01PTH; 1X01
LEFT: M01PTH; 1X01
LEFTJ1, LEFTJ2: M01PTH; 1X01
M: M01PTH; 1X01
N: M01PTH; 1X01
O: M01PTH; 1X01
P: M01PTH; 1X01
PIN5J1, PIN5J2, PIN7J1, PIN7J2, PIN9J1, PIN9J2: M01PTH; 1X01
Q: M01PTH; 1X01
R: M01PTH; 1X01
RIGHT: M01PTH; 1X01
RIGHTJ1, RIGHTJ2: M01PTH; 1X01
S: M01PTH; 1X01
SPC: M01PTH; 1X01
SYM: M01PTH; 1X01
T: M01PTH; 1X01
U: M01PTH; 1X01
U$3: ZXSP_ED2X28_SPE; 2X28_SPE
UP: M01PTH; 1X01
UPJ1, UPJ2: M01PTH; 1X01
V: M01PTH; 1X01
VCCJ1, VCCJ2: M01PTH; 1X01
W: M01PTH; 1X01
X: M01PTH; 1X01
Y: M01PTH; 1X01
Z: M01PTH; 1X01

Connections:
9V: U$3.A4 (9V)
+12V: U$3.B22 (+12V)
-5V: U$3.B20 (-5V)
-12V: U$3.B23 (-12V)
/IORQ: IC1.5 (I1), U$3.B17 (/IORQ)
/RD: IC1.4 (I0), U$3.B18 (/RD)
/RDIO: IC1.2 (I1), IC1.6 (O), IC1.9 (I0)
A0: IC1.1 (I0), U$3.A9 (A0)
A5: IC2.1 (G1), U$3.A23 (A5)
A6: IC1.12 (I0), U$3.A22 (A6)
A7: IC1.13 (I1), U$3.A21 (A7)
A8: IC8.1 (G1), U$3.B26 (A8)
A9: IC10.1 (G1), U$3.A27 (A9)
A10: IC12.1 (G1), U$3.B27 (A10)
A11: IC14.1 (G1), U$3.A28 (A11)
A12: IC13.1 (G1), U$3.A2 (A12)
A13: IC11.1 (G1), U$3.B2 (A13)
A14: IC9.1 (G1), U$3.A1 (A14)
A15: IC7.1 (G1), U$3.B1 (A15)
D0: D1.A, D6.A, D11.A, D16.A, D21.A, D26.A, D31.A, D36.A, IC2.3 (Y1), U$3.B6 (D0)
D1: D2.A, D7.A, D12.A, D17.A, D22.A, D27.A, D32.A, D37.A, IC2.5 (Y2), U$3.B7 (D1)
D2: D3.A, D8.A, D13.A, D18.A, D23.A, D28.A, D33.A, D38.A, IC2.7 (Y3), U$3.B8 (D2)
D3: D4.A, D9.A, D14.A, D19.A, D24.A, D29.A, D34.A, D39.A, IC2.9 (Y4), U$3.B11 (D3)
D4: D5.A, D10.A, D15.A, D20.A, D25.A, D30.A, D35.A, D40.A, IC2.11 (Y5), U$3.B12 (D4)
D5: D41.A, U$3.B10 (D5)
D6: D42.A, U$3.B9 (D6)
D7: D43.A, U$3.B3 (D7)
GND: C1.2, C2.2, C3.2, C4.2, C5.2, C6.2, C7.2, C8.2, C9.2, C10.2, IC1.7 (GND), IC2.8 (GND), IC7.8 (GND), IC8.8 (GND), IC9.8 (GND), IC10.8 (GND), IC11.8 (GND), IC12.8 (GND), IC13.8 (GND), IC14.8 (GND), J1.8, J2.8, U$3.A6 (GND_1), U$3.A7 (GND_2), U$3.A14 (GND_3)
IORQULA: IC1.3 (O), IC7.15 (G2), IC8.15 (G2), IC9.15 (G2), IC10.15 (G2), IC11.15 (G2), IC12.15 (G2), IC13.15 (G2), IC14.15 (G2)
KEMPSTON: IC1.8 (O), IC2.15 (G2)
unnamed: D41.C, D42.C, D43.C, IC2.13 (Y6)
unnamed: IC7.2 (A1), SPC.1
unnamed: D1.C, IC7.3 (Y1)
unnamed: IC1.10 (I1), IC1.11 (O)
unnamed: J1.1, UPJ1.1
unnamed: DOWNJ1.1, J1.2
unnamed: J1.3, LEFTJ1.1
unnamed: J1.4, RIGHTJ1.1
unnamed: J1.5, PIN5J1.1
unnamed: FIREJ1.1, J1.6
unnamed: J1.9, PIN9J1.1
unnamed: IC7.4 (A2), SYM.1
unnamed: J2.1, UPJ2.1
unnamed: DOWNJ2.1, J2.2
unnamed: J2.3, LEFTJ2.1
unnamed: J2.4, RIGHTJ2.1
unnamed: J2.5, PIN5J2.1
unnamed: IC7.6 (A3), M.1
unnamed: D2.C, IC7.5 (Y2)
unnamed: IC7.10 (A4), N.1
unnamed: D3.C, IC7.7 (Y3)
unnamed: B.1, IC7.12 (A5)
unnamed: D4.C, IC7.9 (Y4)
unnamed: D5.C, IC7.11 (Y5)
unnamed: CAP.1, IC8.2 (A1)
unnamed: IC8.4 (A2), Z.1
unnamed: IC8.6 (A3), X.1
unnamed: C.1, IC8.10 (A4)
unnamed: FIREJ2.1, J2.6
unnamed: J2.9, PIN9J2.1
unnamed: J1.7, PIN7J1.1
unnamed: J2.7, PIN7J2.1
unnamed: IC2.2 (A1), RIGHT.1
unnamed: IC2.4 (A2), LEFT.1
unnamed: DOWN.1, IC2.6 (A3)
unnamed: IC2.10 (A4), UP.1
unnamed: FIRE.1, IC2.12 (A5)
unnamed: IC8.12 (A5), V.1
unnamed: D6.C, IC8.3 (Y1)
unnamed: D7.C, IC8.5 (Y2)
unnamed: D8.C, IC8.7 (Y3)
unnamed: D9.C, IC8.9 (Y4)
unnamed: D10.C, IC8.11 (Y5)
unnamed: ENT.1, IC9.2 (A1)
unnamed: IC9.4 (A2), L.1
unnamed: IC9.6 (A3), K.1
unnamed: IC9.10 (A4), J.1
unnamed: H.1, IC9.12 (A5)
unnamed: D11.C, IC9.3 (Y1)
unnamed: D12.C, IC9.5 (Y2)
unnamed: D13.C, IC9.7 (Y3)
unnamed: D14.C, IC9.9 (Y4)
unnamed: D15.C, IC9.11 (Y5)
unnamed: A.1, IC10.2 (A1)
unnamed: IC10.4 (A2), S.1
unnamed: D.1, IC10.6 (A3)
unnamed: F.1, IC10.10 (A4)
unnamed: G.1, IC10.12 (A5)
unnamed: D16.C, IC10.3 (Y1)
unnamed: D17.C, IC10.5 (Y2)
unnamed: D18.C, IC10.7 (Y3)
unnamed: D19.C, IC10.9 (Y4)
unnamed: D20.C, IC10.11 (Y5)
unnamed: IC11.2 (A1), P.1
unnamed: IC11.4 (A2), O.1
unnamed: I.1, IC11.6 (A3)
unnamed: IC11.10 (A4), U.1
unnamed: IC11.12 (A5), Y.1
unnamed: D21.C, IC11.3 (Y1)
unnamed: D22.C, IC11.5 (Y2)
unnamed: D23.C, IC11.7 (Y3)
unnamed: D24.C, IC11.9 (Y4)
unnamed: D25.C, IC11.11 (Y5)
unnamed: IC12.2 (A1), Q.1
unnamed: IC12.4 (A2), W.1
unnamed: E.1, IC12.6 (A3)
unnamed: IC12.10 (A4), R.1
unnamed: IC12.12 (A5), T.1
unnamed: D26.C, IC12.3 (Y1)
unnamed: D27.C, IC12.5 (Y2)
unnamed: D28.C, IC12.7 (Y3)
unnamed: D29.C, IC12.9 (Y4)
unnamed: D30.C, IC12.11 (Y5)
unnamed: 0.1, IC13.2 (A1)
unnamed: 9.1, IC13.4 (A2)
unnamed: 8.1, IC13.6 (A3)
unnamed: 7.1, IC13.10 (A4)
unnamed: 6.1, IC13.12 (A5)
unnamed: D31.C, IC13.3 (Y1)
unnamed: D32.C, IC13.5 (Y2)
unnamed: D33.C, IC13.7 (Y3)
unnamed: D34.C, IC13.9 (Y4)
unnamed: D35.C, IC13.11 (Y5)
unnamed: 1.1, IC14.2 (A1)
unnamed: 2.1, IC14.4 (A2)
unnamed: 3.1, IC14.6 (A3)
unnamed: 4.1, IC14.10 (A4)
unnamed: 5.1, IC14.12 (A5)
unnamed: D36.C, IC14.3 (Y1)
unnamed: D37.C, IC14.5 (Y2)
unnamed: D38.C, IC14.7 (Y3)
unnamed: D39.C, IC14.9 (Y4)
unnamed: D40.C, IC14.11 (Y5)
VCC: C1.1, C2.1, C3.1, C4.1, C5.1, C6.1, C7.1, C8.1, C9.1, C10.1, IC1.14 (VCC), IC2.14 (A6), IC2.16 (VCC), IC7.16 (VCC), IC8.16 (VCC), IC9.16 (VCC), IC10.16 (VCC), IC11.16 (VCC), IC12.16 (VCC), IC13.16 (VCC), IC14.16 (VCC), U$3.A3 (5V), VCCJ1.1, VCCJ2.1

Notes on the sheet:
COMCON-style Joystick Interface
(C)2015 antoniovillena

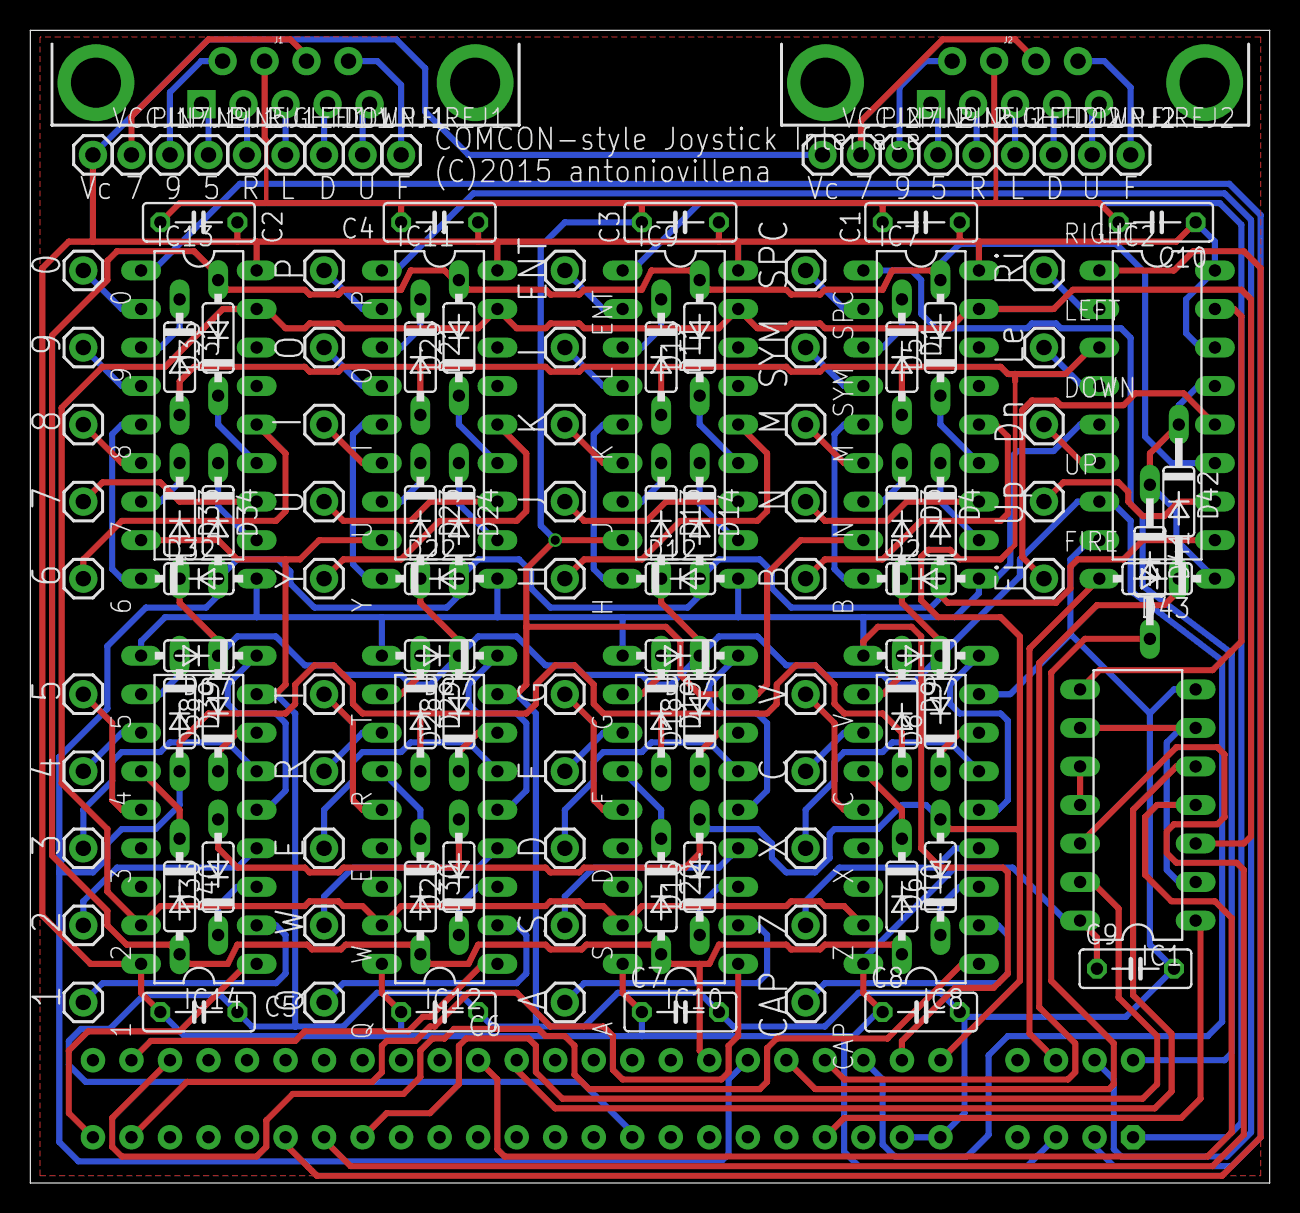
[picture p148: board comcon_version_av_antigua.brd from above]

Board: 2 copper layers, 81.7 x 76.0 mm, 129 parts (1 on the bottom side), 130 nets.
