nikiiv/zx-uno/hardware/scart/antiguos/adaptador_vga_scart.brd

## EAGLE design hardware/scart/antiguos/adaptador_vga_scart.brd (2019-06-25, an earlier design)

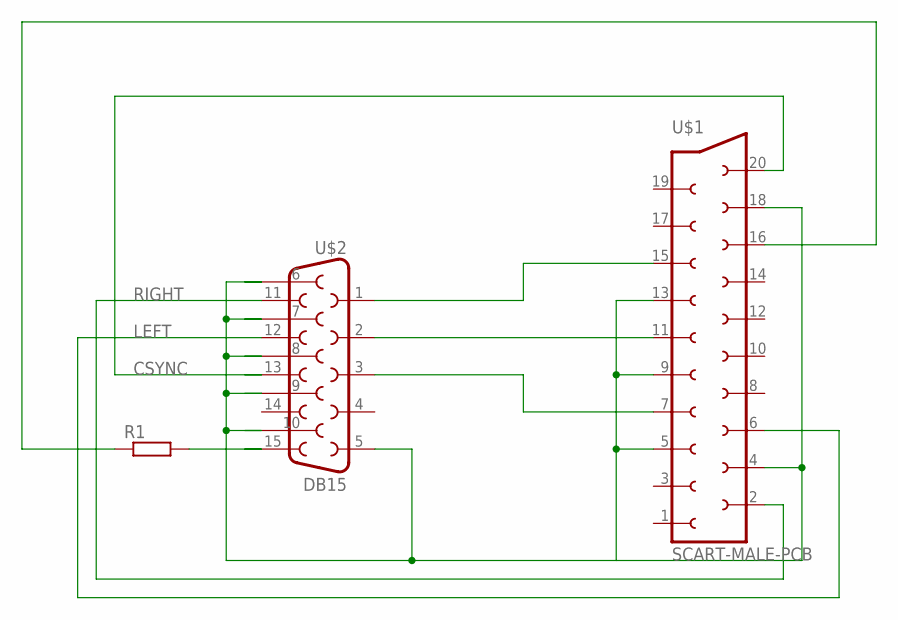
[picture p149: schematic adaptador_vga_scart.sch]

Parts:
R1: R-EU_0204/7; 0204/7
U$1: SCART-MALE-PCB; SCART-PCB
U$2: DB15

Connections:
BOUT: U$1.7, U$2.3
CSYNC: U$1.20, U$2.13
GND: U$1.4, U$1.5, U$1.9, U$1.13, U$1.18, U$2.5, U$2.6, U$2.7, U$2.8, U$2.9, U$2.10
GOUT: U$1.11, U$2.2
LEFT: U$1.6, U$2.12
unnamed: U$1.15, U$2.1
unnamed: R1.2, U$2.15
unnamed: R1.1, U$1.16
RIGHT: U$1.2, U$2.11

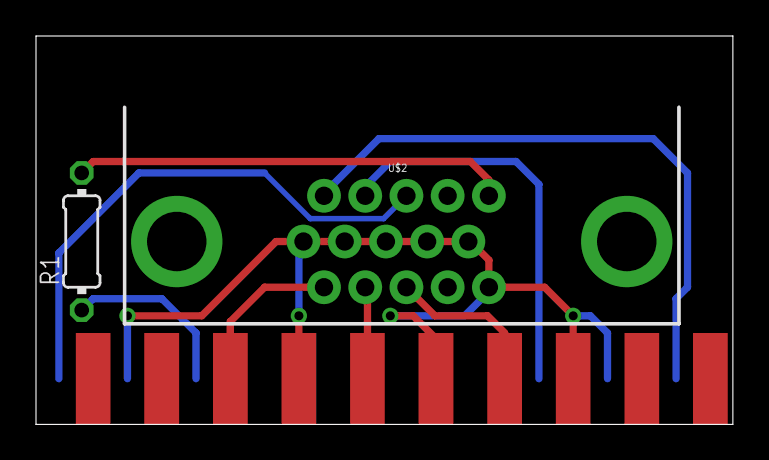
[picture p150: board adaptador_vga_scart.brd from above]

Board: 2 copper layers, 38.7 x 21.6 mm, 3 parts (0 on the bottom side), 9 nets.
