nikiiv/zx-uno/hardware/unoedge/unoedge_antiguos/zxuno_bus_v2_for_zxuno_v41.brd

## EAGLE design hardware/unoedge/unoedge_antiguos/zxuno_bus_v2_for_zxuno_v41.brd (2019-06-25, an earlier design)

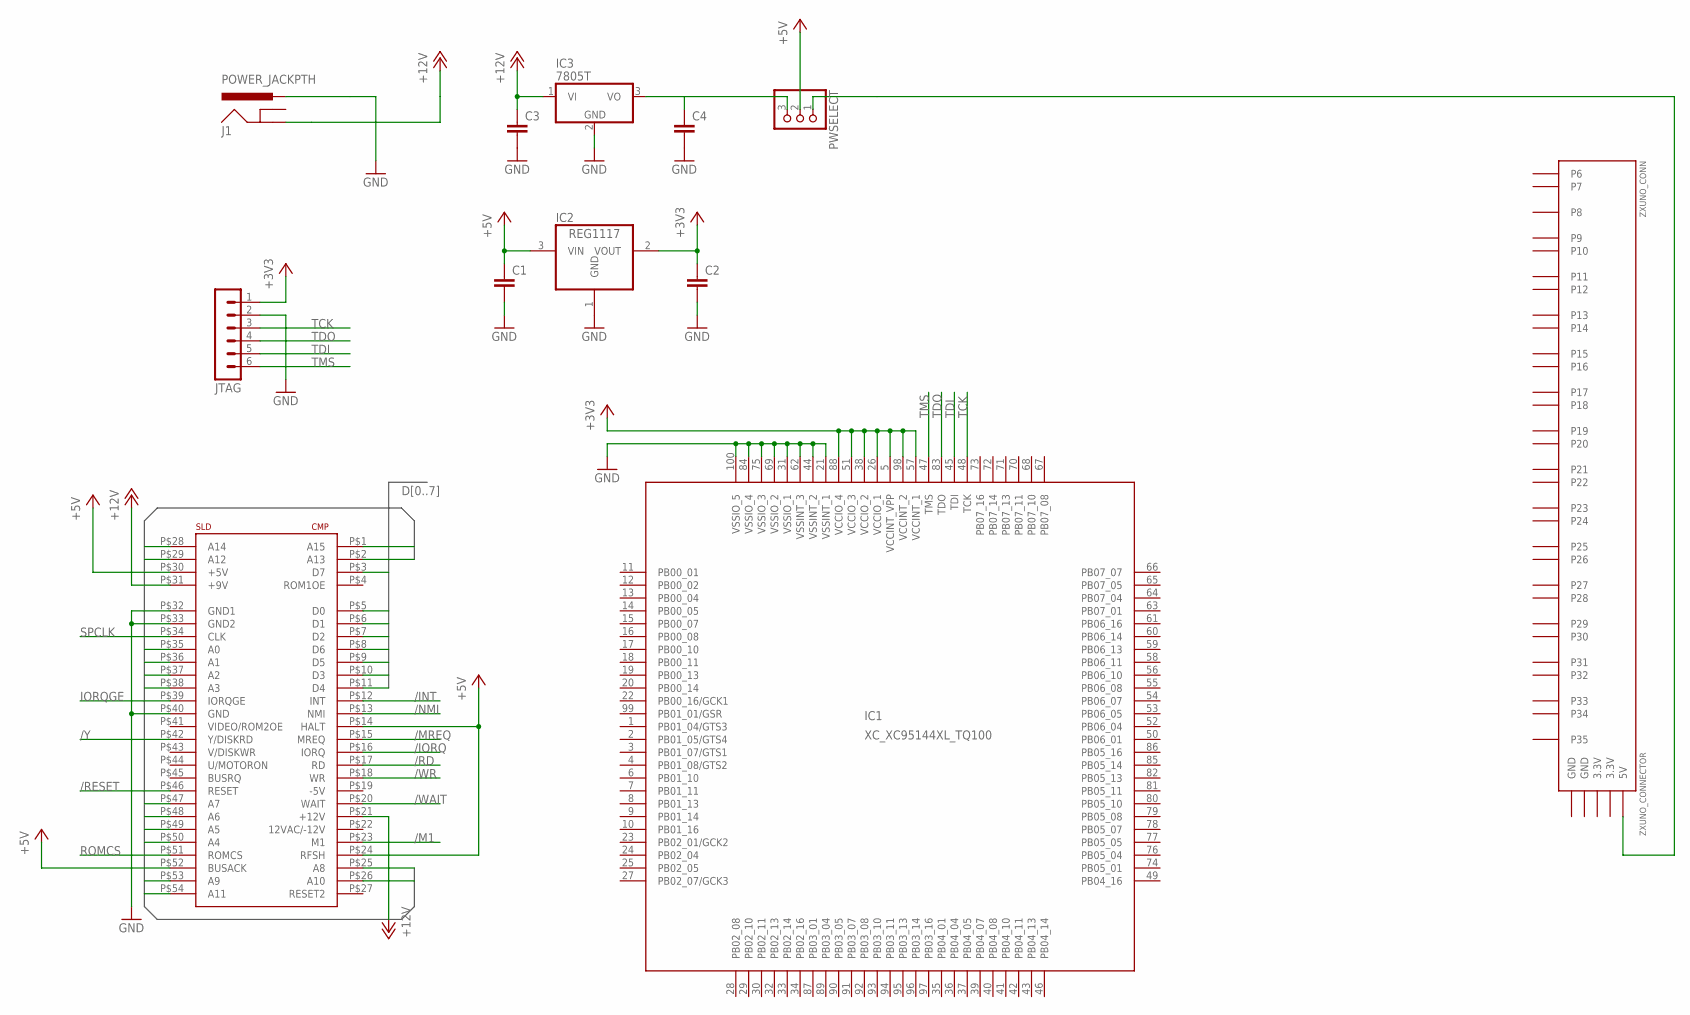
[picture p151: schematic zxuno_bus_v2_for_zxuno_v41.sch]

Parts:
C1, C2, C3, C4: C-EUC1206K; C1206K
IC1: XC_XC95144XL_TQ100; XC_XC-TQ100
IC2: REG1117; SOT223
IC3: 7805T; TO220H
J1: POWER_JACKPTH; POWER_JACK_PTH
JTAG: MA06-1
PWSELECT: PINHD-1X3; 1X03
U$1: CONECTOR_EDGE_LADO_SPECTRUM; CONECTOR_LADO_SPECTRUM
ZXUNO_CONN: ZXUNO_CONNECTOR

Connections:
3.3V: ZXUNO_CONN.3.3V@1 (3.3V), ZXUNO_CONN.3.3V@2 (3.3V)
+3V3: C2.1, IC1.5 (VCCINT_VPP), IC1.26 (VCCIO_1), IC1.38 (VCCIO_2), IC1.51 (VCCIO_3), IC1.57 (VCCINT_1), IC1.88 (VCCIO_4), IC1.98 (VCCINT_2), IC2.2 (VOUT), JTAG.1
+5V: C1.1, IC2.3 (VIN), PWSELECT.2, U$1.P$14 (HALT), U$1.P$24 (RFSH), U$1.P$30 (+5V), U$1.P$52 (BUSACK)
+12V: C3.1, IC3.1 (VI), J1.GND, U$1.P$21 (+12V), U$1.P$31 (+9V)
/INT: U$1.P$12 (INT)
/IORQ: U$1.P$16 (IORQ)
/M1: U$1.P$23 (M1)
/MREQ: U$1.P$15 (MREQ)
/NMI: U$1.P$13 (NMI)
/RD: U$1.P$17 (RD)
/RESET: U$1.P$46 (RESET)
/WAIT: U$1.P$20 (WAIT)
/WR: U$1.P$18 (WR)
/Y: U$1.P$42 (Y/DISKRD)
A0: U$1.P$35 (A0)
A1: U$1.P$36 (A1)
A2: U$1.P$37 (A2)
A3: U$1.P$38 (A3)
A4: U$1.P$50 (A4)
A5: U$1.P$49 (A5)
A6: U$1.P$48 (A6)
A7: U$1.P$47 (A7)
A8: U$1.P$25 (A8)
A9: U$1.P$53 (A9)
A10: U$1.P$26 (A10)
A11: U$1.P$54 (A11)
A12: U$1.P$29 (A12)
A13: U$1.P$2 (A13)
A14: U$1.P$28 (A14)
A15: U$1.P$1 (A15)
D0: U$1.P$5 (D0)
D1: U$1.P$6 (D1)
D2: U$1.P$7 (D2)
D3: U$1.P$10 (D3)
D4: U$1.P$11 (D4)
D5: U$1.P$9 (D5)
D6: U$1.P$8 (D6)
D7: U$1.P$3 (D7)
GND: C1.2, C2.2, C3.2, C4.2, IC1.21 (VSSINT_1), IC1.31 (VSSIO_1), IC1.44 (VSSINT_2), IC1.62 (VSSINT_3), IC1.69 (VSSIO_2), IC1.75 (VSSIO_3), IC1.84 (VSSIO_4), IC1.100 (VSSIO_5), IC2.1 (GND), IC3.2 (GND), J1.PWR, JTAG.2, U$1.P$32 (GND1), U$1.P$33 (GND2), U$1.P$40 (GND), ZXUNO_CONN.GND@1 (GND), ZXUNO_CONN.GND@2 (GND)
IORQGE: U$1.P$39 (IORQGE)
unnamed: PWSELECT.1, ZXUNO_CONN.5V
unnamed: C4.1, IC3.3 (VO), PWSELECT.3
ROMCS: U$1.P$51 (ROMCS)
SPCLK: U$1.P$34 (CLK)
TCK: IC1.48 (TCK), JTAG.3
TDI: IC1.45 (TDI), JTAG.5
TDO: IC1.83 (TDO), JTAG.4
TMS: IC1.47 (TMS), JTAG.6

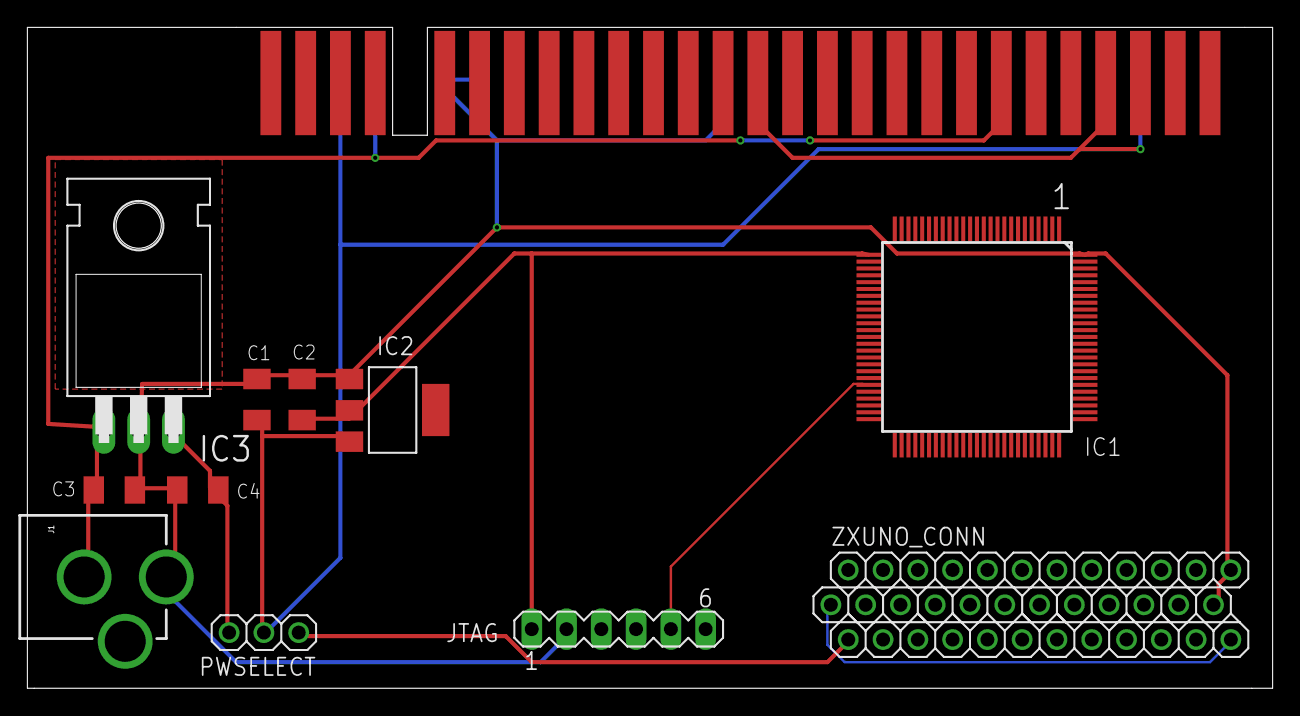
[picture p152: board zxuno_bus_v2_for_zxuno_v41.brd from above]

Board: 2 copper layers, 90.9 x 48.3 mm, 12 parts (0 on the bottom side), 11 nets.
