nikiiv/zx-uno/hardware/otros/interface2/cartucho.brd

## EAGLE design hardware/otros/interface2/cartucho.brd (2019-06-25)

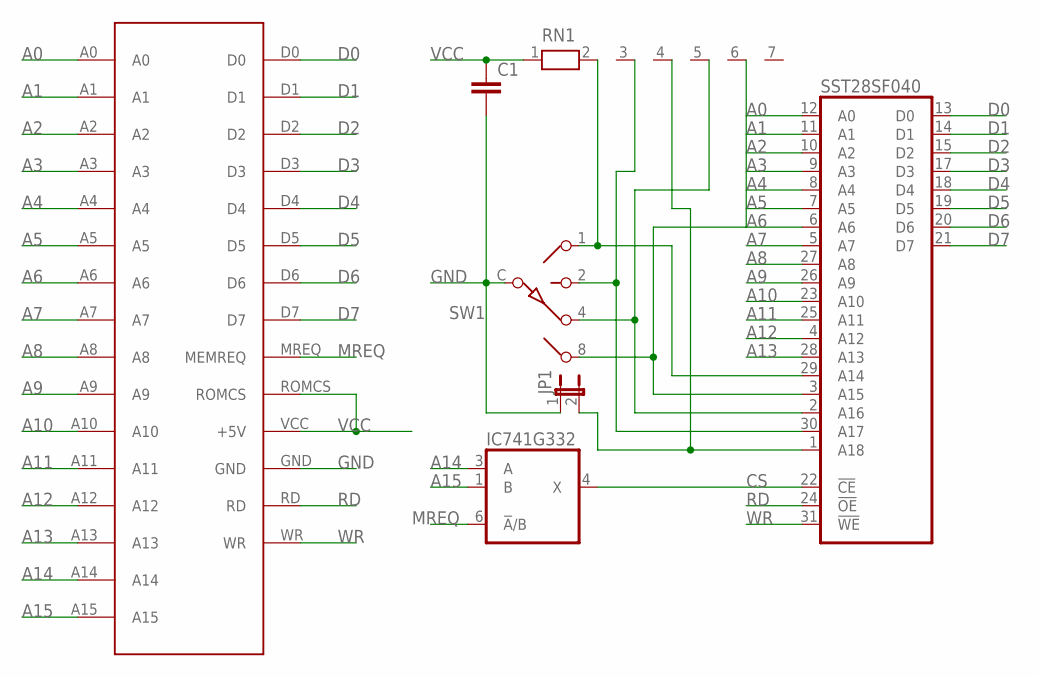
[picture p153: schematic cartucho.sch]

Parts:
C1: C-EUC0603; C0603
IC741G332: 741G3157DBVR; DBV_R-PDSO-G6
JP1: JP1E; JP1
RN1: RN06; RN-7
SST28SF040: SST39VF040N; PLCC32R
SW1: SW-C16
U$1: IF2BUS; BUS_CARTUCHO_IF2

Connections:
A0: SST28SF040.12 (A0), U$1.A0
A1: SST28SF040.11 (A1), U$1.A1
A2: SST28SF040.10 (A2), U$1.A2
A3: SST28SF040.9 (A3), U$1.A3
A4: SST28SF040.8 (A4), U$1.A4
A5: SST28SF040.7 (A5), U$1.A5
A6: SST28SF040.6 (A6), U$1.A6
A7: SST28SF040.5 (A7), U$1.A7
A8: SST28SF040.27 (A8), U$1.A8
A9: SST28SF040.26 (A9), U$1.A9
A10: SST28SF040.23 (A10), U$1.A10
A11: SST28SF040.25 (A11), U$1.A11
A12: SST28SF040.4 (A12), U$1.A12
A13: SST28SF040.28 (A13), U$1.A13
A14: IC741G332.3 (A), U$1.A14
A15: IC741G332.1 (B), U$1.A15
CS: IC741G332.4 (X), SST28SF040.22 (!CE)
D0: SST28SF040.13 (D0), U$1.D0
D1: SST28SF040.14 (D1), U$1.D1
D2: SST28SF040.15 (D2), U$1.D2
D3: SST28SF040.17 (D3), U$1.D3
D4: SST28SF040.18 (D4), U$1.D4
D5: SST28SF040.19 (D5), U$1.D5
D6: SST28SF040.20 (D6), U$1.D6
D7: SST28SF040.21 (D7), U$1.D7
GND: C1.2, IC741G332.2 (GND), JP1.1, SST28SF040.16 (GND), SW1.C, U$1.GND
MREQ: IC741G332.6 (!A!/B), U$1.MREQ (MEMREQ)
unnamed: JP1.2, RN1.4, SST28SF040.1 (A18)
unnamed: RN1.3, SST28SF040.30 (A17), SW1.2
unnamed: RN1.5, SST28SF040.2 (A16), SW1.4
unnamed: RN1.6, SST28SF040.3 (A15), SW1.8
unnamed: RN1.2, SST28SF040.29 (A14), SW1.1
RD: SST28SF040.24 (!OE), U$1.RD
VCC: C1.1, IC741G332.5 (VCC), RN1.1, SST28SF040.32 (VCC), U$1.ROMCS, U$1.VCC (+5V)
WR: SST28SF040.31 (!WE), U$1.WR

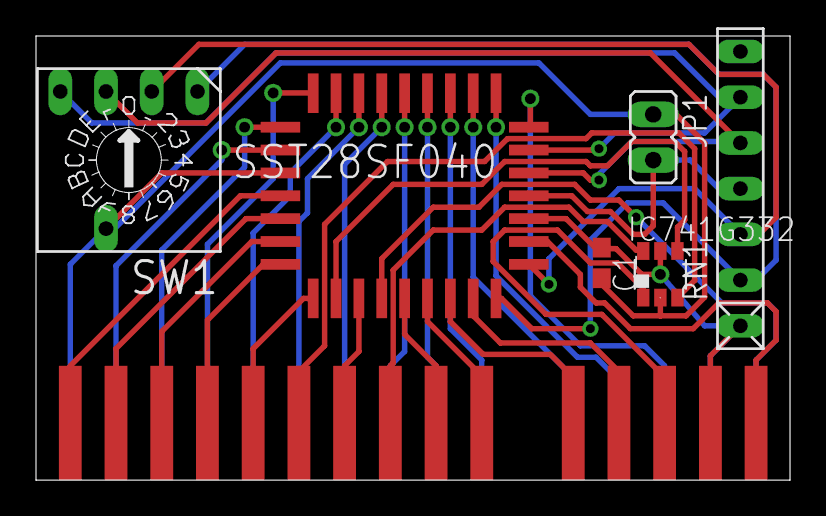
[picture p154: board cartucho.brd from above]

Board: 2 copper layers, 41.9 x 24.7 mm, 7 parts (0 on the bottom side), 35 nets.
