nikiiv/zx-uno/hardware/otros/raspberry/amebot_raspberry_adapter.brd

## EAGLE design hardware/otros/raspberry/amebot_raspberry_adapter.brd (2019-06-25)

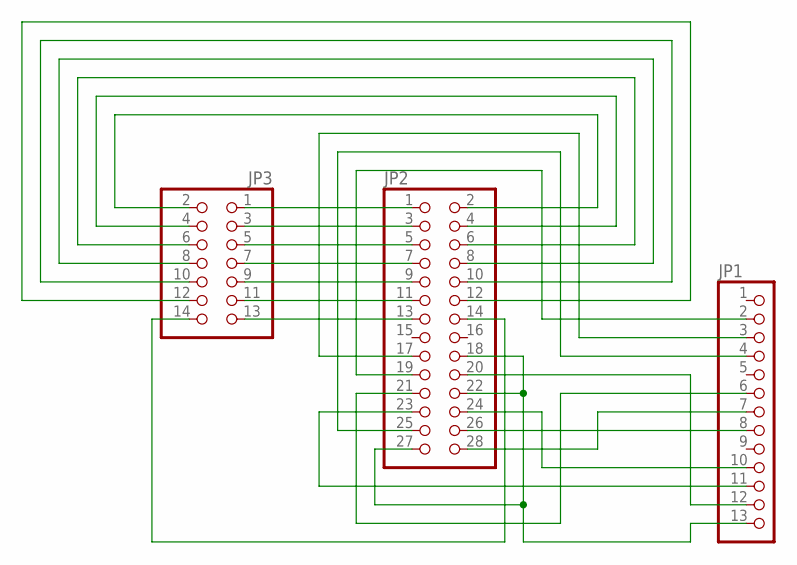
[picture p155: schematic amebot_raspberry_adapter.sch]

Parts:
JP1: PINHD-1X13; 1X13
JP2: PINHD-2X14; 2X14
JP3: PINHD-2X7; 2X07

Connections:
GND: JP1.13, JP2.18, JP2.22, JP2.27
unnamed: JP1.3, JP2.17
unnamed: JP1.4, JP2.25
unnamed: JP1.7, JP2.28
unnamed: JP1.12, JP2.20
unnamed: JP1.8, JP2.26
unnamed: JP1.2, JP2.19
unnamed: JP1.6, JP2.21
unnamed: JP1.11, JP2.23
unnamed: JP2.1, JP3.1
unnamed: JP2.3, JP3.3
unnamed: JP2.5, JP3.5
unnamed: JP2.7, JP3.7
unnamed: JP2.9, JP3.9
unnamed: JP2.11, JP3.11
unnamed: JP2.13, JP3.13
unnamed: JP2.2, JP3.2
unnamed: JP2.4, JP3.4
unnamed: JP2.6, JP3.6
unnamed: JP2.8, JP3.8
unnamed: JP2.10, JP3.10
unnamed: JP2.12, JP3.12
unnamed: JP2.14, JP3.14
unnamed: JP1.10, JP2.24

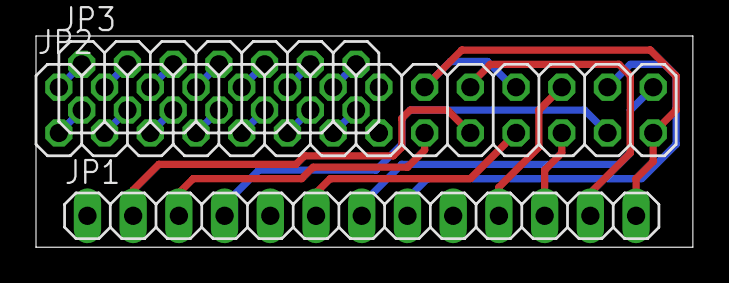
[picture p156: board amebot_raspberry_adapter.brd from above]

Board: 2 copper layers, 36.5 x 11.7 mm, 3 parts (0 on the bottom side), 24 nets.
