nikiiv/zx-uno/hardware/memoria_extra/placa_v1.brd

## EAGLE design hardware/memoria_extra/placa_v1.brd (2019-06-25)

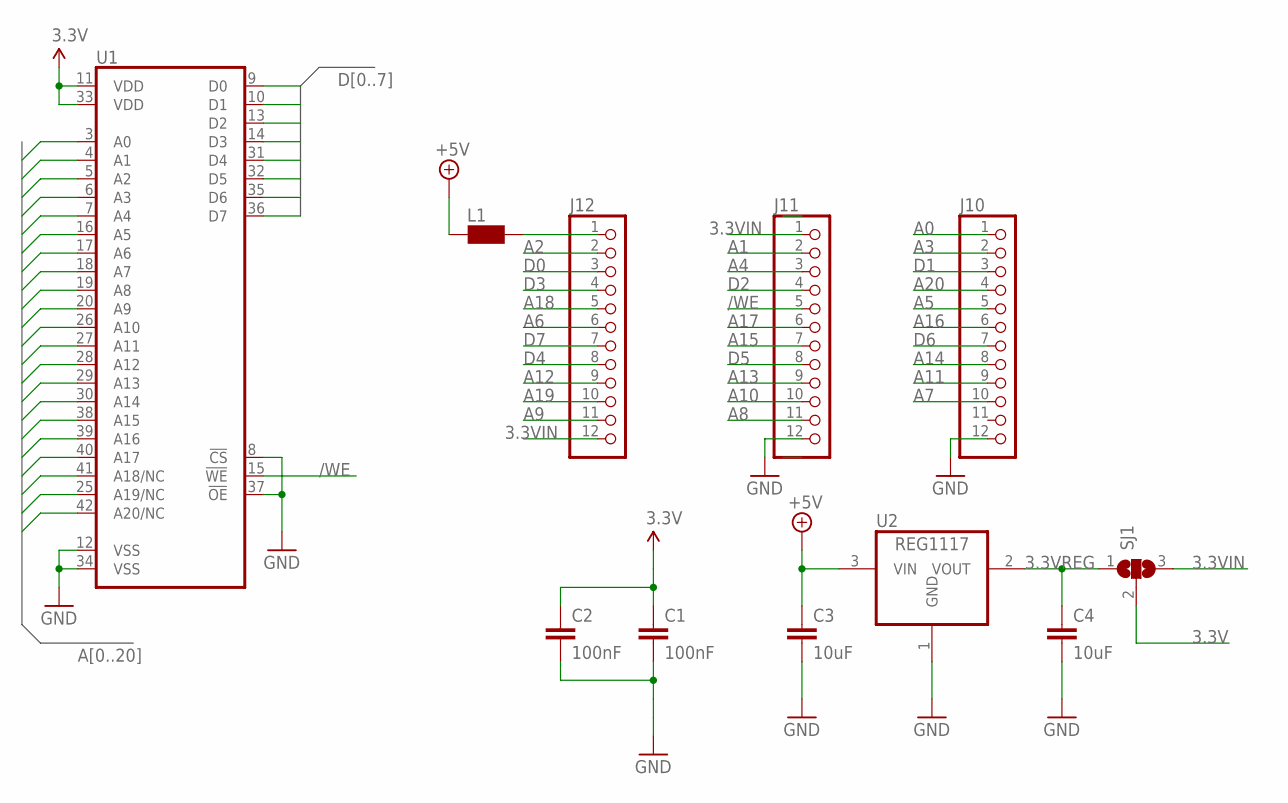
[picture p157: schematic placa_v1.sch]

Parts:
C1, C2: 100nF; C0805K
C3, C4: 10uF; C0805K
J10, J11, J12: PINHD-1X12; 1X12
L1: WE-CBF_0805; 0805
SJ1: SJ2W; SJ_2
U1: ISSI_SRAM_8BIT; TSOP44-II
U2: REG1117; SOT223

Connections:
3.3V: C1.1, C2.1, SJ1.2, U1.11 (VDD), U1.33 (VDD)
3.3VIN: J11.1, J12.12, SJ1.3
3.3VREG: C4.1, SJ1.1, U2.2 (VOUT)
+5V: C3.1, L1.2, U2.3 (VIN)
/WE: J11.5, U1.15 (!WE)
A0: J10.1, U1.3 (A0)
A1: J11.2, U1.4 (A1)
A2: J12.2, U1.5 (A2)
A3: J10.2, U1.6 (A3)
A4: J11.3, U1.7 (A4)
A5: J10.5, U1.16 (A5)
A6: J12.6, U1.17 (A6)
A7: J10.10, U1.18 (A7)
A8: J11.11, U1.19 (A8)
A9: J12.11, U1.20 (A9)
A10: J11.10, U1.26 (A10)
A11: J10.9, U1.27 (A11)
A12: J12.9, U1.28 (A12)
A13: J11.9, U1.29 (A13)
A14: J10.8, U1.30 (A14)
A15: J11.7, U1.38 (A15)
A16: J10.6, U1.39 (A16)
A17: J11.6, U1.40 (A17)
A18: J12.5, U1.41 (A18/NC)
A19: J12.10, U1.25 (A19/NC)
A20: J10.4, U1.42 (A20/NC)
D0: J12.3, U1.9 (D0)
D1: J10.3, U1.10 (D1)
D2: J11.4, U1.13 (D2)
D3: J12.4, U1.14 (D3)
D4: J12.8, U1.31 (D4)
D5: J11.8, U1.32 (D5)
D6: J10.7, U1.35 (D6)
D7: J12.7, U1.36 (D7)
GND: C1.2, C2.2, C3.2, C4.2, J10.12, J11.12, U1.8 (!CS), U1.12 (VSS), U1.34 (VSS), U1.37 (!OE), U2.1 (GND)
unnamed: J12.1, L1.1

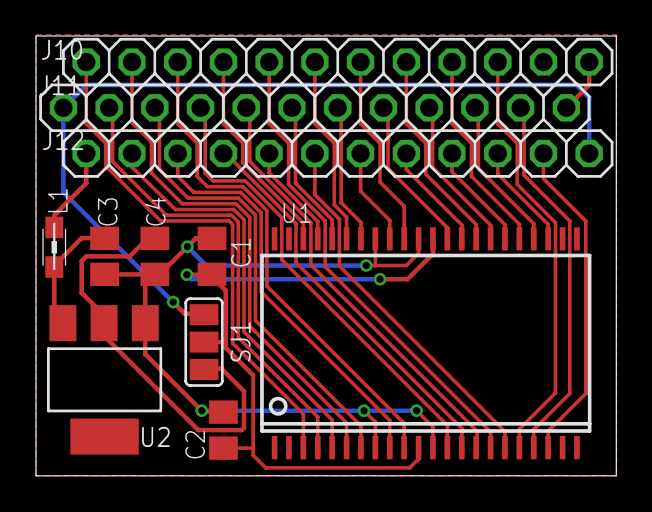
[picture p158: board placa_v1.brd from above]

Board: 2 copper layers, 32.2 x 24.4 mm, 11 parts (0 on the bottom side), 36 nets.
