nikiiv/zx-uno/hardware/trainer/trainer2.brd

## EAGLE design hardware/trainer/trainer2.brd (2019-06-25)

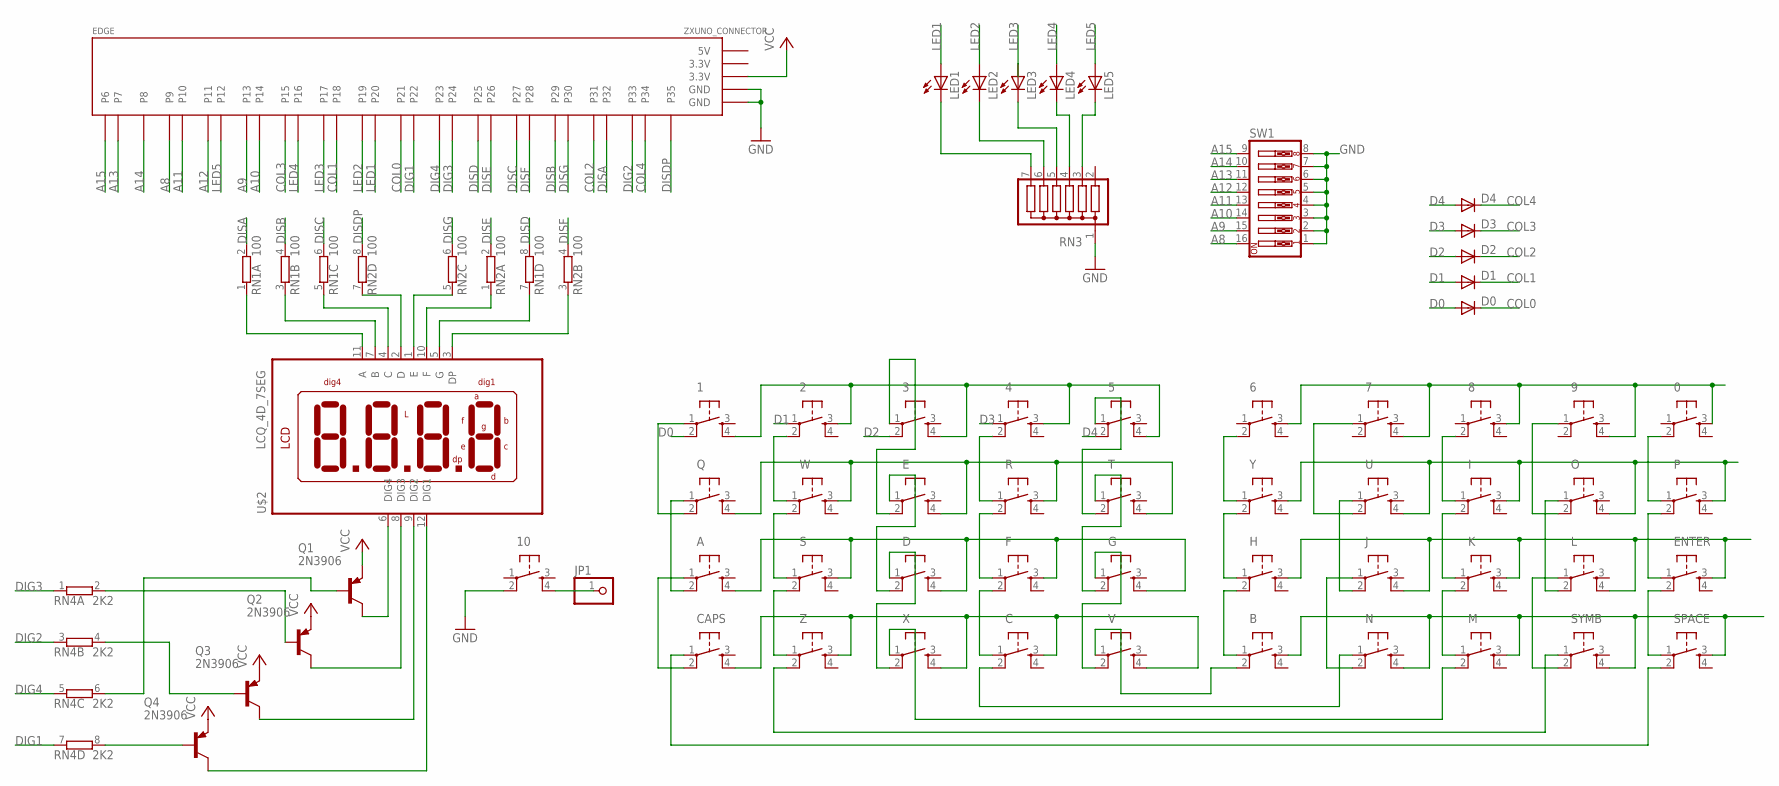
[picture p159: schematic trainer2.sch]

Parts:
0, 1, 2, 3, 4, 5, 6, 7, 8, 9, 10: DTS-6
A: DTS-6
B: DTS-6
C: DTS-6
CAPS: DTS-6
D: DTS-6
D0, D1, D2, D3, D4: 1N4148DO35-7; DO35-7
E: DTS-6
EDGE: ZXUNO_CONNECTOR
ENTER: DTS-6
F: DTS-6
G: DTS-6
H: DTS-6
I: DTS-6
J: DTS-6
JP1: PINHD-1X1; 1X01
K: DTS-6
L: DTS-6
LED1, LED2, LED3, LED4, LED5: LED3MM
M: DTS-6
N: DTS-6
O: DTS-6
P: DTS-6
Q: DTS-6
Q1, Q2, Q3, Q4: 2N3906; TO92
R: DTS-6
RN1, RN2: 100; SIL8
RN3: G06R; SIL7
RN4: 2K2; SIL8
S: DTS-6
SPACE: DTS-6
SW1: SW_DIP-8; EDG-08
SYMB: DTS-6
T: DTS-6
U: DTS-6
U$2: LCQ_4D_7SEG; LDQ_4D_7SEG
V: DTS-6
W: DTS-6
X: DTS-6
Y: DTS-6
Z: DTS-6

Connections:
3.3V: EDGE.3.3V@1 (3.3V)
5V: EDGE.5V
A8: C.3, CAPS.4, EDGE.P9, SW1.16, V.4, X.4, Z.3
A9: A.4, D.4, EDGE.P13, F.3, G.4, S.3, SW1.15
A10: E.4, EDGE.P14, Q.4, R.3, SW1.14, T.4, W.3
A11: 1.4, 2.3, 3.4, 4.3, 5.4, EDGE.P10, SW1.13
A12: 0.3, 6.3, 7.4, 8.3, 9.4, EDGE.P11, SW1.12
A13: EDGE.P7, I.3, O.4, P.3, SW1.11, U.4, Y.3
A14: EDGE.P8, ENTER.3, H.3, J.4, K.3, L.4, SW1.10
A15: B.3, EDGE.P6, M.3, N.4, SPACE.3, SW1.9, SYMB.4
COL0: D0.C, EDGE.P21
COL1: D1.C, EDGE.P18
COL2: D2.C, EDGE.P31
COL3: D3.C, EDGE.P15
COL4: D4.C, EDGE.P34
D0: 1.2, D0.A
D1: 2.1, D1.A
D2: 3.2, D2.A
D3: 4.1, D3.A
D4: 5.2, D4.A
DIG1: EDGE.P22, RN4.7 (1)
DIG2: EDGE.P33, RN4.3 (1)
DIG3: EDGE.P24, RN4.1
DIG4: EDGE.P23, RN4.5 (1)
DISA: EDGE.P32, RN1.2
DISB: EDGE.P29, RN1.4 (2)
DISC: EDGE.P27, RN1.6 (2)
DISD: EDGE.P25, RN1.8 (2)
DISDP: EDGE.P35, RN2.8 (2)
DISE: EDGE.P26, RN2.2
DISF: EDGE.P28, RN2.4 (2)
DISG: EDGE.P30, RN2.6 (2)
ELETE: M.2, X.1
GND: 10.2, EDGE.GND@1 (GND), EDGE.GND@2 (GND), RN3.1, SW1.1, SW1.2, SW1.3, SW1.4, SW1.5, SW1.6, SW1.7, SW1.8
LED1: EDGE.P20, LED1.A
LED2: EDGE.P19, LED2.A
LED3: EDGE.P17, LED3.A
LED4: EDGE.P16, LED4.A
LED5: EDGE.P12, LED5.A
unnamed: Q1.1 (C), U$2.6 (DIG4)
unnamed: Q2.1 (C), U$2.8 (DIG3)
unnamed: Q3.1 (C), U$2.9 (DIG2)
unnamed: Q4.1 (C), U$2.12 (DIG1)
unnamed: Q2.2 (B), RN4.2
unnamed: Q1.2 (B), RN4.6 (2)
unnamed: Q3.2 (B), RN4.4 (2)
unnamed: Q4.2 (B), RN4.8 (2)
unnamed: RN1.1, U$2.11 (A)
unnamed: RN1.3 (1), U$2.7 (B)
unnamed: RN1.5 (1), U$2.4 (C)
unnamed: RN2.7 (1), U$2.2 (D)
unnamed: RN2.5 (1), U$2.1 (E)
unnamed: RN2.1, U$2.10 (F)
unnamed: 10.4, JP1.1
unnamed: S.1, W.2
unnamed: S.2, Z.1
unnamed: RN2.3 (1), U$2.3 (DP)
unnamed: SYMB.1, Z.2
unnamed: RN1.7 (1), U$2.5 (G)
unnamed: C.1, F.2
unnamed: CAPS.1, SPACE.2
unnamed: 4.2, R.1
unnamed: F.1, R.2
unnamed: LED4.K (C), RN3.4
unnamed: LED5.K (C), RN3.3
unnamed: LED3.K (C), RN3.5
unnamed: B.2, V.1
unnamed: 5.1, T.2
unnamed: G.2, T.1
unnamed: A.2, Q.1
unnamed: J.2, U.1
unnamed: J.1, N.2
unnamed: 3.1, E.2
unnamed: D.2, E.1
unnamed: A.1, CAPS.2
unnamed: 1.1, Q.2
unnamed: K.2, M.1
unnamed: 2.2, W.1
unnamed: 7.1, U.2
unnamed: LED2.K (C), RN3.6
unnamed: G.1, V.2
unnamed: C.2, N.1
unnamed: L.1, SYMB.2
unnamed: LED1.K (C), RN3.7
unnamed: I.2, K.1
unnamed: 8.2, I.1
unnamed: L.2, O.1
unnamed: B.1, H.2
unnamed: H.1, Y.2
unnamed: ENTER.2, SPACE.1
unnamed: ENTER.1, P.2
unnamed: 0.2, P.1
unnamed: 6.2, Y.1
unnamed: 9.1, O.2
unnamed: D.1, X.2
VCC: EDGE.3.3V@2 (3.3V), Q1.3 (E), Q2.3 (E), Q3.3 (E), Q4.3 (E)

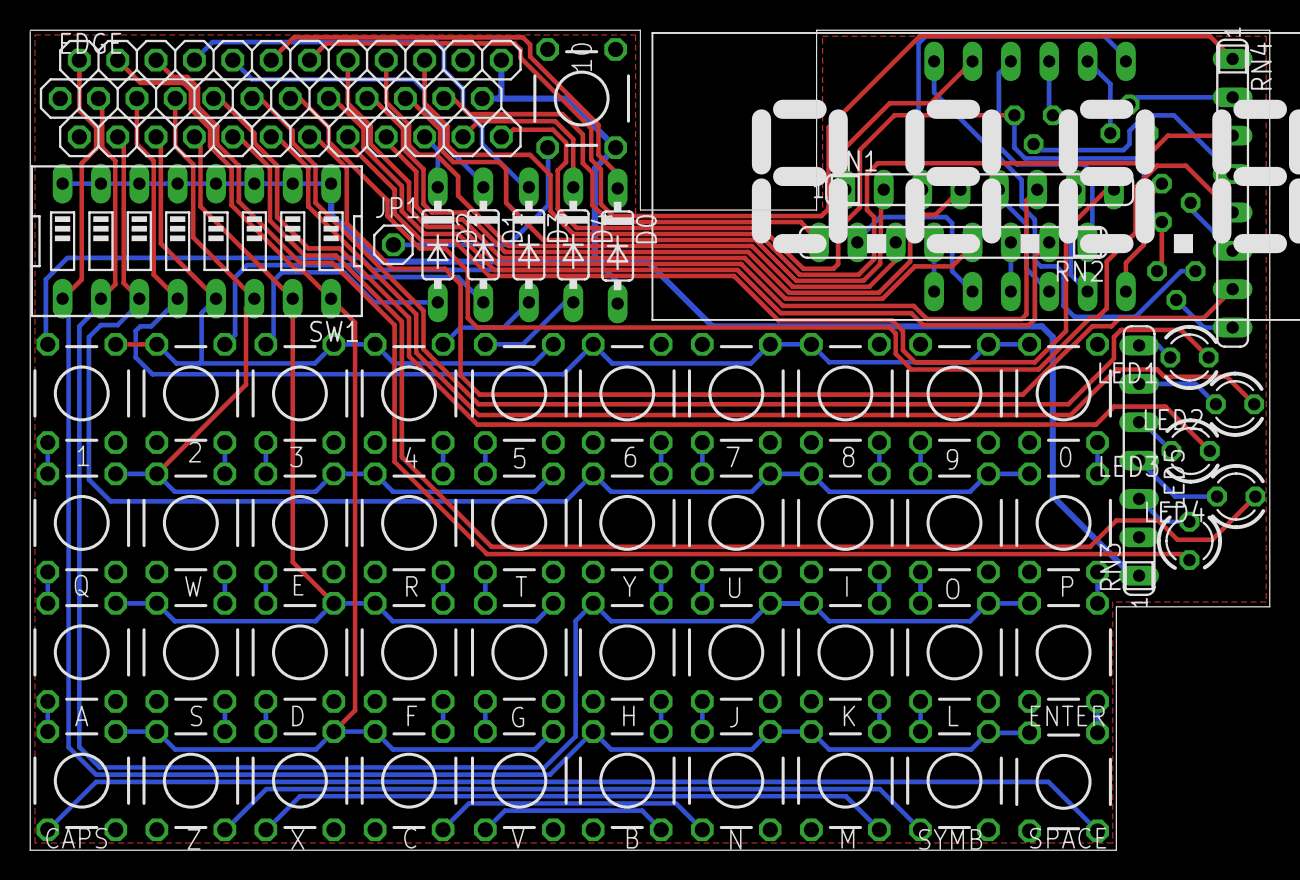
[picture p160: board trainer2.brd from above]

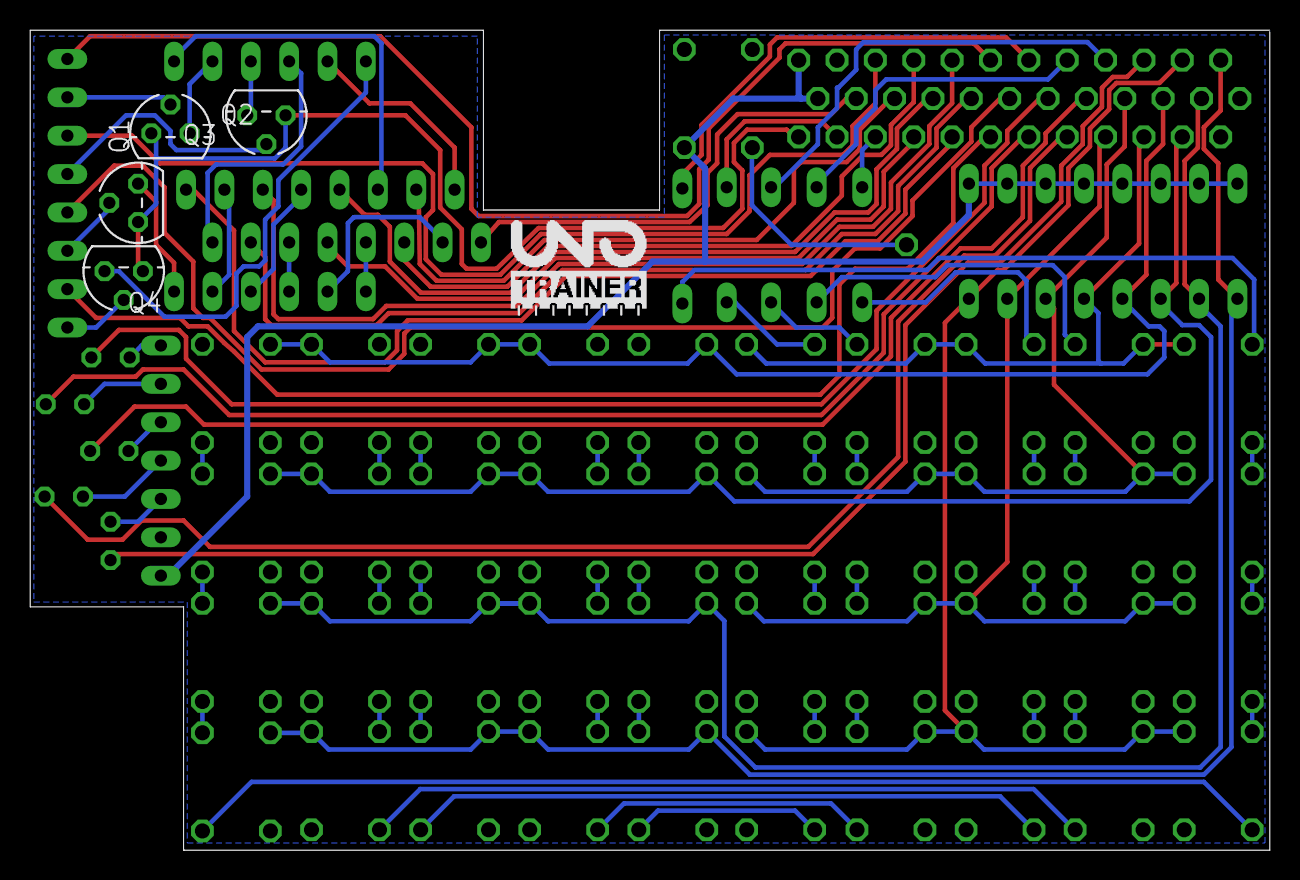
[picture p161: board trainer2.brd from below]

Board: 2 copper layers, 82.1 x 54.3 mm, 63 parts (4 on the bottom side), 94 nets.
