nikiiv/zx-uno/hardware/otros/interface2/iRepair.brd

## EAGLE design hardware/otros/interface2/iRepair.brd (2019-06-25)

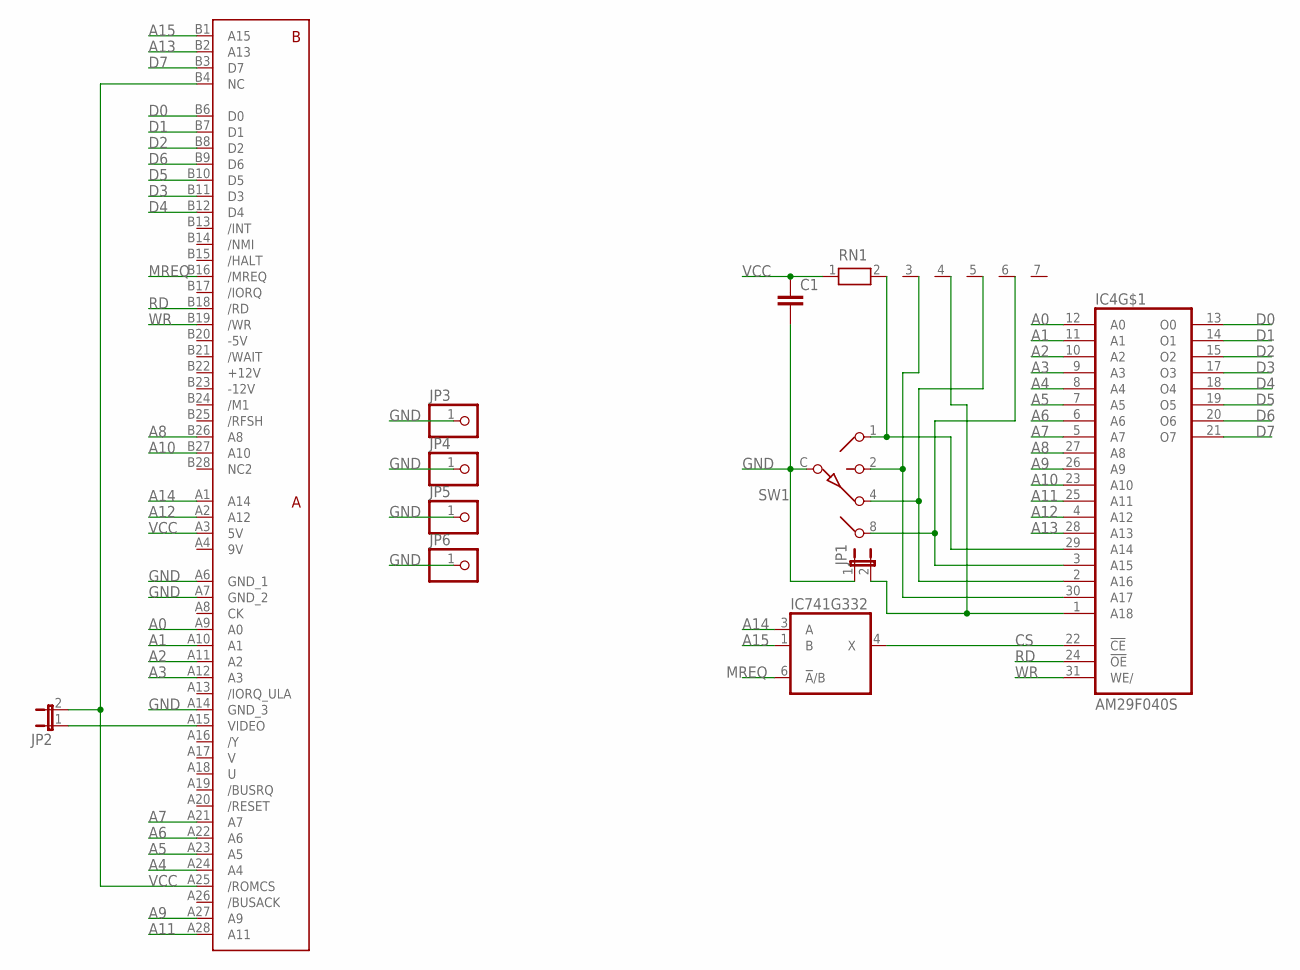
[picture p162: schematic iRepair.sch]

Parts:
C1: C-EU025-025X050; C025-025X050
IC4: AM29F040S; PLCC-SR32
IC741G332: 741G3157DBVR; DBV_R-PDSO-G6
JP1, JP2: JP1E; JP1
JP3, JP4, JP5, JP6: PINHD-1X1; 1X01
RN1: RN06; RN-7
SW1: SW-C16
U$3: ZXSP_ED2X28_SPE; 2X28_SPE

Connections:
9V: U$3.A4 (9V)
+12V: U$3.B22 (+12V)
-5V: U$3.B20 (-5V)
-12V: U$3.B23 (-12V)
A0: IC4.12 (A0), U$3.A9 (A0)
A1: IC4.11 (A1), U$3.A10 (A1)
A2: IC4.10 (A2), U$3.A11 (A2)
A3: IC4.9 (A3), U$3.A12 (A3)
A4: IC4.8 (A4), U$3.A24 (A4)
A5: IC4.7 (A5), U$3.A23 (A5)
A6: IC4.6 (A6), U$3.A22 (A6)
A7: IC4.5 (A7), U$3.A21 (A7)
A8: IC4.27 (A8), U$3.B26 (A8)
A9: IC4.26 (A9), U$3.A27 (A9)
A10: IC4.23 (A10), U$3.B27 (A10)
A11: IC4.25 (A11), U$3.A28 (A11)
A12: IC4.4 (A12), U$3.A2 (A12)
A13: IC4.28 (A13), U$3.B2 (A13)
A14: IC741G332.3 (A), U$3.A1 (A14)
A15: IC741G332.1 (B), U$3.B1 (A15)
CS: IC4.22 (!CE), IC741G332.4 (X)
D0: IC4.13 (O0), U$3.B6 (D0)
D1: IC4.14 (O1), U$3.B7 (D1)
D2: IC4.15 (O2), U$3.B8 (D2)
D3: IC4.17 (O3), U$3.B11 (D3)
D4: IC4.18 (O4), U$3.B12 (D4)
D5: IC4.19 (O5), U$3.B10 (D5)
D6: IC4.20 (O6), U$3.B9 (D6)
D7: IC4.21 (O7), U$3.B3 (D7)
GND: C1.2, IC4.16 (GND), IC741G332.2 (GND), JP1.1, JP3.1, JP4.1, JP5.1, JP6.1, SW1.C, U$3.A6 (GND_1), U$3.A7 (GND_2), U$3.A14 (GND_3)
MREQ: IC741G332.6 (!A!/B), U$3.B16 (/MREQ)
unnamed: JP2.1, U$3.A15 (VIDEO)
unnamed: IC4.1 (A18), JP1.2, RN1.4
unnamed: IC4.30 (A17), RN1.3, SW1.2
unnamed: IC4.2 (A16), RN1.5, SW1.4
unnamed: IC4.3 (A15), RN1.6, SW1.8
unnamed: IC4.29 (A14), RN1.2, SW1.1
RD: IC4.24 (!OE), U$3.B18 (/RD)
VCC: C1.1, IC4.32 (VCC), IC741G332.5 (VCC), JP2.2, RN1.1, U$3.A3 (5V), U$3.A25 (/ROMCS), U$3.B4 (NC)
WR: IC4.31 (WE/), U$3.B19 (/WR)

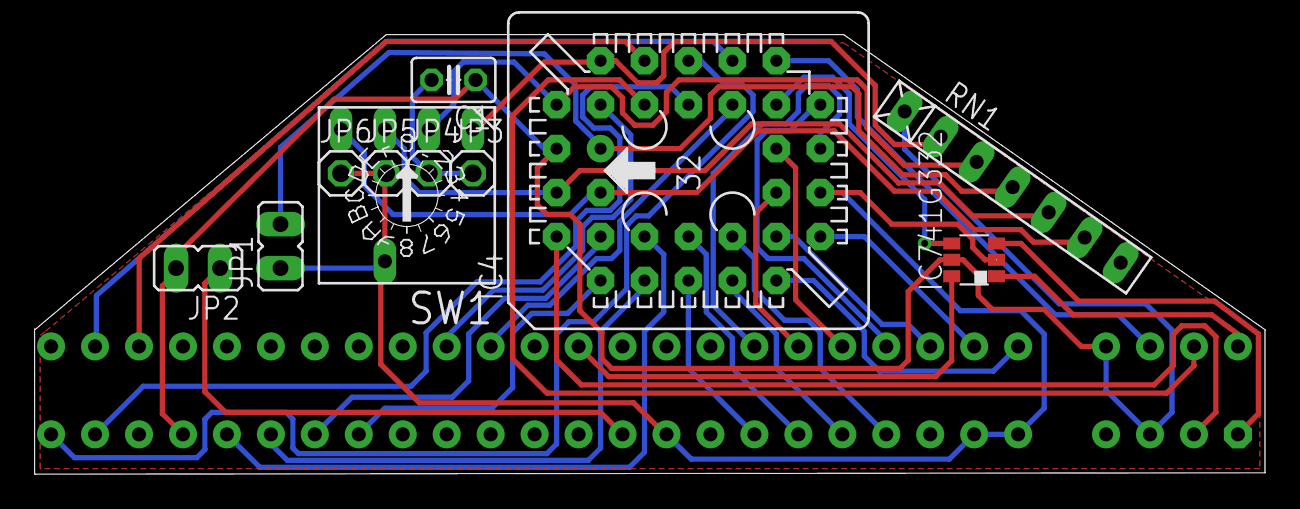
[picture p163: board iRepair.brd from above]

Board: 2 copper layers, 71.1 x 25.4 mm, 12 parts (1 on the bottom side), 36 nets.
