nikiiv/zx-uno/hardware/scart/adaptador_scart_v2.brd

## EAGLE design hardware/scart/adaptador_scart_v2.brd (2019-06-25)

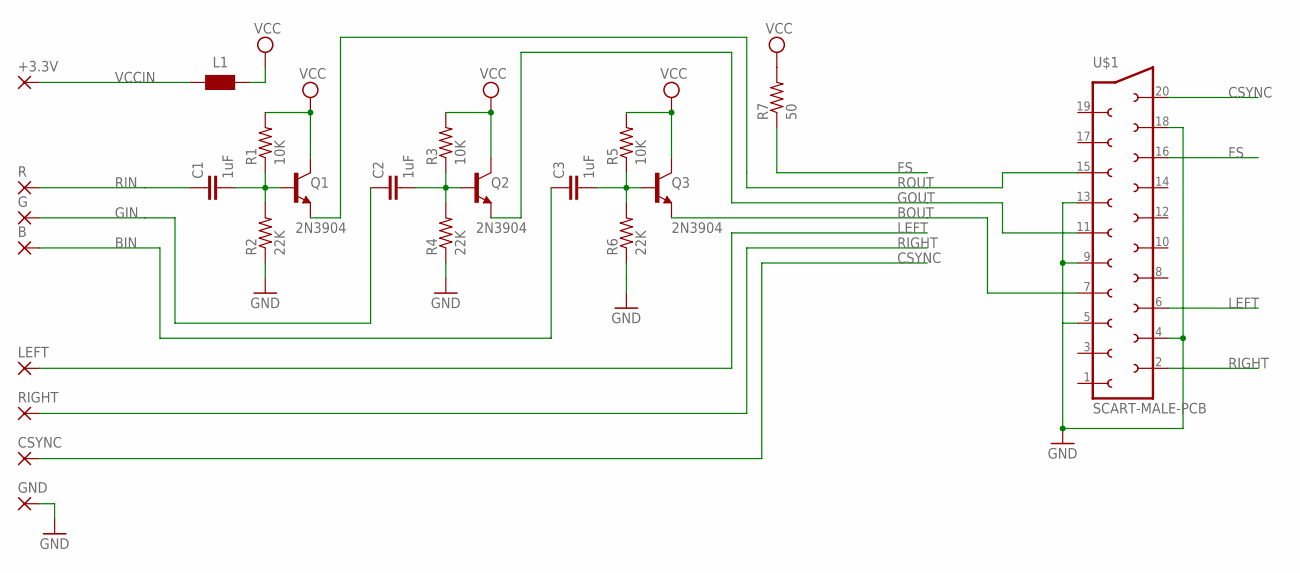
[picture p164: schematic adaptador_scart_v2.sch]

Parts:
+3.3V: SMD2; SMD1,27-2,54
B: SMD2; SMD1,27-2,54
C1, C2, C3: 1uF; C1206K
CSYNC: SMD2; SMD1,27-2,54
G: SMD2; SMD1,27-2,54
GND: SMD2; SMD1,27-2,54
L1: WE-CBF_0805; 0805
LEFT: SMD2; SMD1,27-2,54
Q1, Q2, Q3: 2N3904; SOT23
R: SMD2; SMD1,27-2,54
R1, R3, R5: 10K; R0805
R2, R4, R6: 22K; R0805
R7: 50; R0805
RIGHT: SMD2; SMD1,27-2,54
U$1: SCART-MALE-PCB; SCART-PCB

Connections:
BIN: B.1, C3.1
BOUT: Q3.2 (E), U$1.7
CSYNC: CSYNC.1, U$1.20
FS: R7.1, U$1.16
GIN: C2.1, G.1
GND: GND.1, R2.1, R4.1, R6.1, U$1.4, U$1.5, U$1.9, U$1.13, U$1.18
GOUT: Q2.2 (E), U$1.11
LEFT: LEFT.1, U$1.6
unnamed: C1.2, Q1.1 (B), R1.1, R2.2
unnamed: C3.2, Q3.1 (B), R5.1, R6.2
unnamed: C2.2, Q2.1 (B), R3.1, R4.2
RIGHT: RIGHT.1, U$1.2
RIN: C1.1, R.1
ROUT: Q1.2 (E), U$1.15
VCC: L1.2, Q1.3 (C), Q2.3 (C), Q3.3 (C), R1.2, R3.2, R5.2, R7.2
VCCIN: +3.3V.1, L1.1

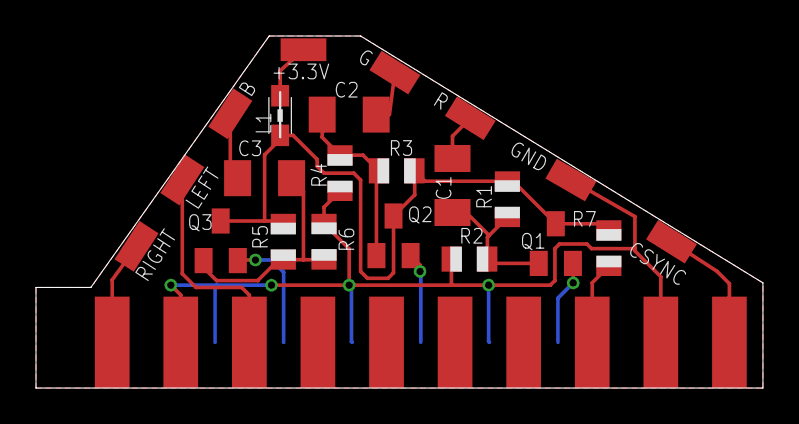
[picture p165: board adaptador_scart_v2.brd from above]

Board: 2 copper layers, 40.4 x 19.6 mm, 23 parts (1 on the bottom side), 16 nets.
