nikiiv/zx-uno/hardware/joysplitter/splitter.brd

## EAGLE design hardware/joysplitter/splitter.brd (2019-06-25)

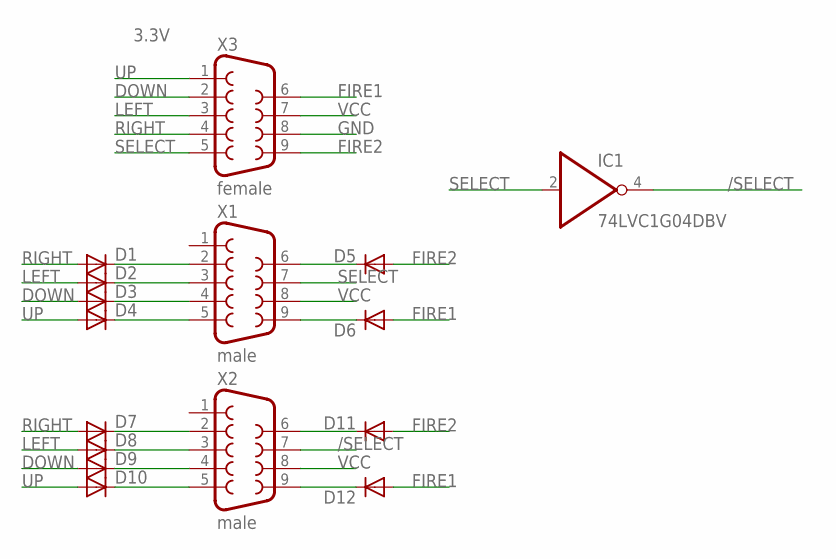
[picture p166: schematic splitter.sch]

Parts:
D1, D2, D3, D4, D5, D6, D7, D8, D9, D10, D11, D12: DIODE-SOD323-R; SOD323-R
IC1: 74LVC1G04DBV; SOT23-5
X1, X2: male; F09D
X3: female; F09D

Connections:
/SELECT: IC1.4 (O), X2.7
DOWN: D3.A, D9.A, X3.2
FIRE1: D6.A, D12.A, X3.6
FIRE2: D5.A, D11.A, X3.9
GND: IC1.3 (GND), X3.8
LEFT: D2.A, D8.A, X3.3
unnamed: D2.C, X1.3
unnamed: D8.C, X2.3
unnamed: D1.C, X1.2
unnamed: D3.C, X1.4
unnamed: D7.C, X2.2
unnamed: D9.C, X2.4
unnamed: D10.C, X2.5
unnamed: D4.C, X1.5
unnamed: D6.C, X1.9
unnamed: D5.C, X1.6
unnamed: D12.C, X2.9
unnamed: D11.C, X2.6
RIGHT: D1.A, D7.A, X3.4
SELECT: IC1.2 (I), X1.7, X3.5
UP: D4.A, D10.A, X3.1
VCC: IC1.5 (VCC), X1.8, X2.8, X3.7

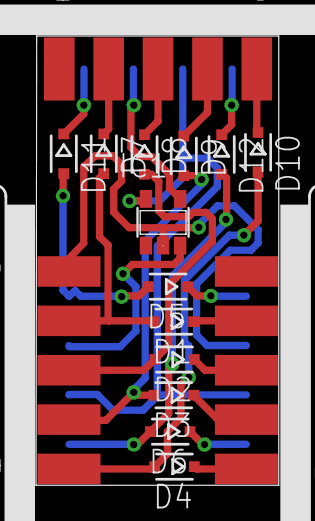
[picture p167: board splitter.brd from above]

Board: 2 copper layers, 13.5 x 25.0 mm, 16 parts (0 on the bottom side), 22 nets.
