nikiiv/zx-uno/hardware/otros/interface2/kartusho.brd

## EAGLE design hardware/otros/interface2/kartusho.brd (2019-06-25)

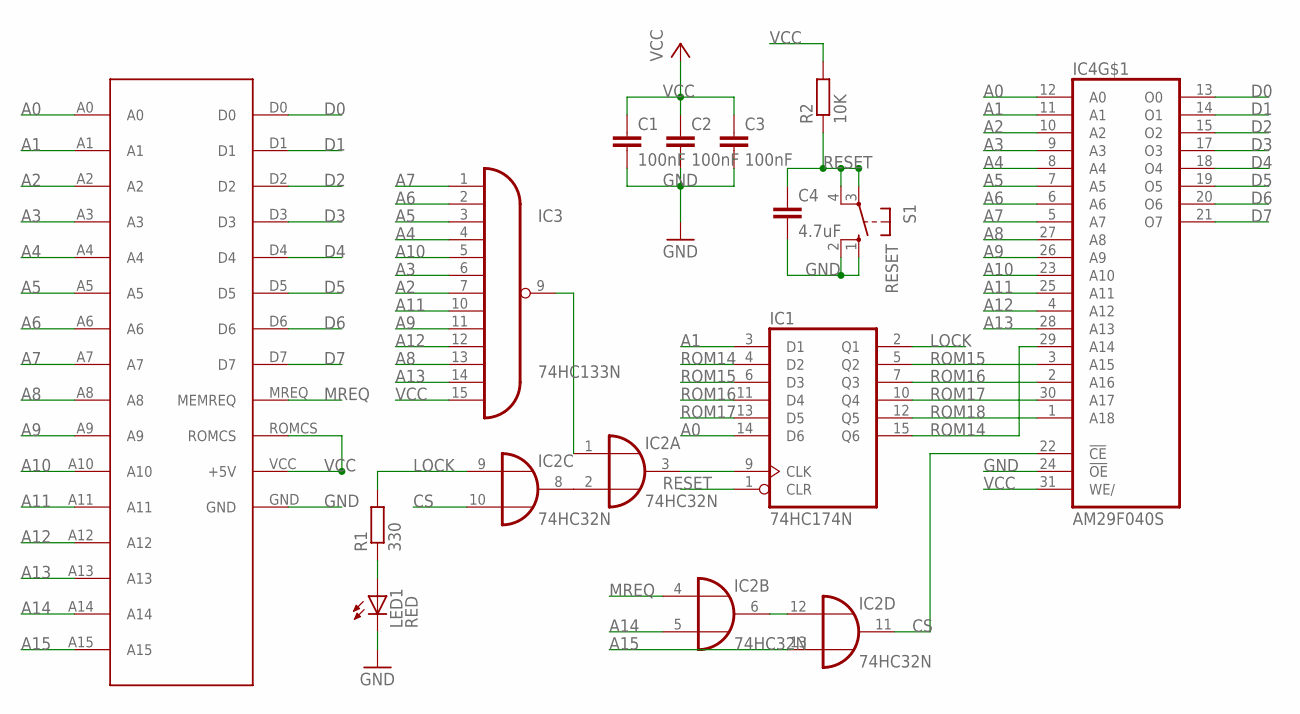
[picture p168: schematic kartusho.sch]

Parts:
C1, C3: 100nF; C050-025X075
C2: 100nF; C025-025X050
C4: 4.7uF; C025-025X050
IC1: 74HC174N; DIL16
IC2: 74HC32N; DIL14
IC3: 74HC133N; DIL16
IC4: AM29F040S; PLCC-SR32
LED1: RED; LED3MM
R1: 330; 0204/7
R2: 10K; 0204/7
S1: RESET; B3F-10XX
U$1: IF2BUS; BUS_CARTUCHO_IF2

Connections:
A0: IC1.14 (D6), IC4.12 (A0), U$1.A0
A1: IC1.3 (D1), IC4.11 (A1), U$1.A1
A2: IC3.7 (I6), IC4.10 (A2), U$1.A2
A3: IC3.6 (I5), IC4.9 (A3), U$1.A3
A4: IC3.4 (I3), IC4.8 (A4), U$1.A4
A5: IC3.3 (I2), IC4.7 (A5), U$1.A5
A6: IC3.2 (I1), IC4.6 (A6), U$1.A6
A7: IC3.1 (I0), IC4.5 (A7), U$1.A7
A8: IC3.13 (I10), IC4.27 (A8), U$1.A8
A9: IC3.11 (I8), IC4.26 (A9), U$1.A9
A10: IC3.5 (I4), IC4.23 (A10), U$1.A10
A11: IC3.10 (I7), IC4.25 (A11), U$1.A11
A12: IC3.12 (I9), IC4.4 (A12), U$1.A12
A13: IC3.14 (I11), IC4.28 (A13), U$1.A13
A14: IC2.5 (I1), U$1.A14
A15: IC2.13 (I1), U$1.A15
CS: IC2.10 (I1), IC2.11 (O), IC4.22 (!CE)
D0: IC4.13 (O0), U$1.D0
D1: IC4.14 (O1), U$1.D1
D2: IC4.15 (O2), U$1.D2
D3: IC4.17 (O3), U$1.D3
D4: IC4.18 (O4), U$1.D4
D5: IC4.19 (O5), U$1.D5
D6: IC4.20 (O6), U$1.D6
D7: IC4.21 (O7), U$1.D7
GND: C1.2, C2.2, C3.2, C4.2, IC1.8 (GND), IC2.7 (GND), IC3.8 (GND), IC4.16 (GND), IC4.24 (!OE), LED1.K (C), S1.1 (S), S1.2 (S1), U$1.GND
LOCK: IC1.2 (Q1), IC2.9 (I0), R1.2
MREQ: IC2.4 (I0), U$1.MREQ (MEMREQ)
unnamed: IC1.9 (CLK), IC2.3 (O)
unnamed: IC2.6 (O), IC2.12 (I0)
unnamed: IC2.2 (I1), IC2.8 (O)
unnamed: IC2.1 (I0), IC3.9 (O)
unnamed: LED1.A, R1.1
RESET: C4.1, IC1.1 (CLR), R2.1, S1.3, S1.4 (P1)
ROM14: IC1.4 (D2), IC1.15 (Q6), IC4.29 (A14)
ROM15: IC1.5 (Q2), IC1.6 (D3), IC4.3 (A15)
ROM16: IC1.7 (Q3), IC1.11 (D4), IC4.2 (A16)
ROM17: IC1.10 (Q4), IC1.13 (D5), IC4.30 (A17)
ROM18: IC1.12 (Q5), IC4.1 (A18)
VCC: C1.1, C2.1, C3.1, IC1.16 (VCC), IC2.14 (VCC), IC3.15 (I12), IC3.16 (VCC), IC4.31 (WE/), IC4.32 (VCC), R2.2, U$1.ROMCS, U$1.VCC (+5V)

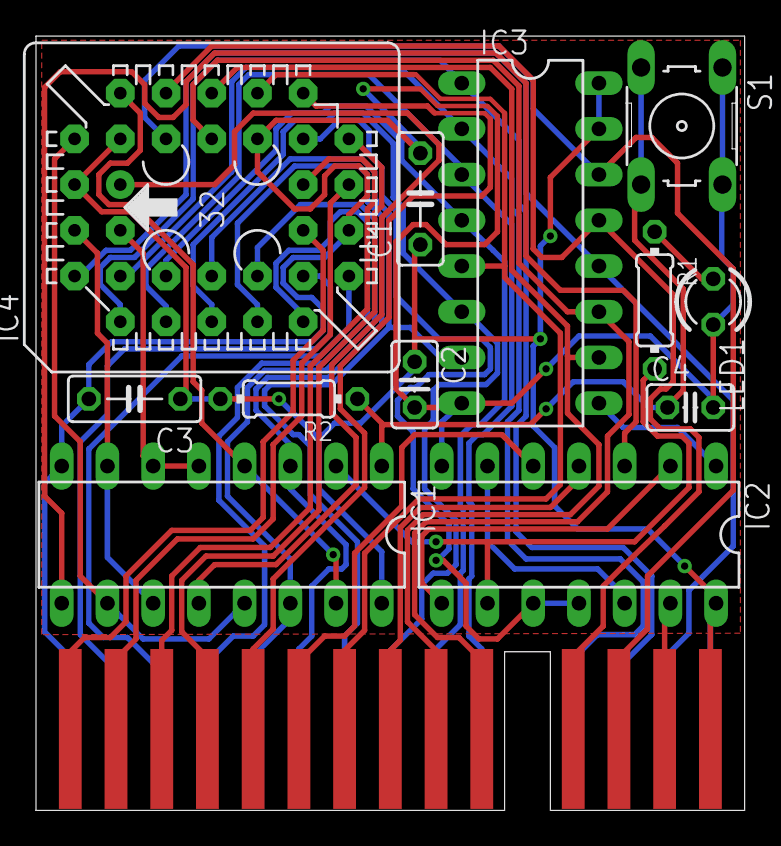
[picture p169: board kartusho.brd from above]

Board: 2 copper layers, 39.4 x 43.0 mm, 13 parts (0 on the bottom side), 40 nets.
