nikiiv/zx-uno/hardware/spectranet_lite_v2/arduino-ethernet-shield-06-reference-design/Shield_Eth06-REV3.brd

## EAGLE design hardware/spectranet_lite_v2/arduino-ethernet-shield-06-reference-design/Shield_Eth06-REV3.brd (2019-06-25)


Parts:
100M: Green; CHIPLED_0805
C1, C2, C4, C11, C12, C14, C15: 100n; C0603-ROUND
C5, C8, C9: 47u; PANASONIC_D
C6, C7: 22p; C0603-ROUND
C10, C16: 1u; C0603-ROUND
C13: 10u; SMC_B
FID1, FID2, FID3, FID4: FIDUCIALMOUNT; FIDUCIA-MOUNT
IC1: CAT811TTBI-CT3; SOT143
IC2: MC33269ST-3.3; SOT223
IC4: W5100; SQFP-S-10X10-80
IC8, IC9, IC10: 74LVC1G125DCK; SC70-5
IC11: 74LVC1G14DBV; SOT23-5
ICSP: 3x2F-H11; 2X03
INT: SJ
JANALOG: 6x1F-H8.5-L14.5mm; 1X06
JHIGH: 10x1F-H8.5-L14.5mm; 1X10
JLOW: 8x1F-H8.5-L14.5mm; 1X08
L1, L2, L3: BLM21; 0805
LINK: Yellow; CHIPLED_0805
ON: Green; CHIPLED_0805
POWER: 8x1F-H8.5-L14.5mm; 1X08
Q2: 25MHz SMD; HC49UP
R2: 300R 1%; R0603-ROUND
R3: 12k 1%; R0603-ROUND
R4: 1M; R0603-ROUND
R5: 0R; R0603-ROUND
R6, R7: N.M.; R0603-ROUND
R8, R9: 10k; R0603-ROUND
RESET1: TS42
RN1, RN3: 1k; CAY16
RN2: 49R9; CAY16
RX: Yellow; CHIPLED_0805
TX: Yellow; CHIPLED_0805
U$1: POE-RJ45
U$2: DISCLAIMER
X1: SDCARD-15TW-8821
ZZ1: AG9XX0; AG9000

Connections:
5-GND: RESET1.5 (5-GND)
+1V8: IC4.11 (1V8-OUT), IC4.15 (1V8D1), IC4.16 (1V8D2), IC4.33 (1V8D3), IC4.69 (1V8D4), L2.1
+1V8A: IC4.7 (1V8A), IC4.74 (1V8A1), L2.2
+3V3: C8.+, C11.1, C12.1, C16.1, IC2.2 (OUT), IC2.4 (OUT), IC4.12 (3V3D1), IC4.18 (3V3D2), IC4.44 (3V3D3), IC8.5 (VCC), IC9.5 (VCC), IC10.5 (VCC), IC11.5 (VCC), L3.2, R8.1, R9.2, RN1.1, RN1.2 (1), RN1.4 (1), RN3.1, RN3.2 (1), RN3.3 (1), RN3.4 (1), X1.4 (4-VDD)
+3V3A: C1.1, C13.+, C14.1, C15.1, IC4.2 (3V3A1), L3.1, U$1.R3 (CT)
+5V: C5.+, IC1.4 (VCC), IC2.3 (IN), ICSP.2, POWER.5
AREF: JHIGH.8
COLLLED: IC4.71 (COLLED)
FDXLED: IC4.70 (FDXLED)
GND: C1.2, C2.1, C4.1, C5.-, C6.2, C7.2, C8.-, C9.-, C10.1, C11.2, C12.2, C13.-, C14.2, C15.2, C16.2, IC1.1 (GND), IC2.1 (GND/ADJ), IC4.4 (GNDA1), IC4.10 (GNDA2), IC4.13 (GNDD1), IC4.14 (GNDD2), IC4.17 (GNDD3), IC4.19 (D7), IC4.20 (D6), IC4.21 (D5), IC4.22 (D4), IC4.23 (D3), IC4.24 (D2), IC4.25 (D1), IC4.26 (D0), IC4.32 (GNDD4), IC4.34 (TEST3), IC4.35 (TEST2), IC4.36 (TEST1), IC4.37 (TEST0), IC4.38 (A14), IC4.39 (A13), IC4.40 (A12), IC4.41 (A11), IC4.42 (A10), IC4.43 (GNDD5), IC4.45 (A9), IC4.46 (A8), IC4.47 (A7), IC4.48 (A6), IC4.49 (A5), IC4.50 (A4), IC4.51 (A3), IC4.52 (A2), IC4.53 (A1), IC4.54 (A0), IC4.63 (OPMODE0), IC4.64 (OPMODE1), IC4.65 (OPMODE2), IC4.68 (GNDD6), IC4.77 (GNDA3), IC8.1 (OE), IC8.3 (GND), IC9.1 (OE), IC9.3 (GND), IC10.1 (OE), IC10.3 (GND), IC11.3 (GND), ICSP.6, JHIGH.7, L1.1, ON.C, POWER.6, POWER.7, R2.2, R7.2, RESET1.1, RESET1.2, X1.6 (6-VSS), X1.GND1 (GND), X1.GND2 (GND1), X1.GND3 (GND2), X1.GND4 (GND3), ZZ1.P$7 (GND)
INT: IC4.56 (*INT), INT.1
LINKLED: IC4.66 (LINKLED), LINK.C, U$1.L4 (L4G-)
MISO: IC4.27 (MISO), ICSP.1, X1.7 (7-DAT0)
MOSI: IC4.28 (MOSI), IC8.2 (I), ICSP.4
MOSI3: IC8.4 (O), X1.3 (3-CMO)
unnamed: RN3.5 (2), U$1.L3 (L3G+)
unnamed: RN3.8 (2), U$1.L1 (L1Y+)
unnamed: IC4.73 (TXLED), TX.C
unnamed: IC4.72 (RXLED), RX.C
unnamed: ON.A, RN1.5 (2)
unnamed: RN1.7 (2), TX.A
unnamed: C2.2, RN2.3 (1), RN2.4 (1)
unnamed: RN1.8 (2), RX.A
unnamed: 100M.A, RN3.7 (2)
unnamed: LINK.A, RN3.6 (2)
unnamed: C4.2, RN2.1, RN2.2 (1)
unnamed: R2.1, R3.2
unnamed: IC4.1 (RSET-BG), R3.1
unnamed: R6.1, ZZ1.P$5 (CP1)
unnamed: R6.2, ZZ1.P$6 (CP2)
unnamed: R5.2, R7.1, ZZ1.P$9 (ADJ)
unnamed: IC4.55 (*CS), IC4.57 (*WR), IC4.58 (*RD), R9.1
OSC1E: C6.1, IC4.76 (XTLP), Q2.1, R4.1
OSC2E: C7.1, IC4.75 (XTLN), Q2.2, R4.2
PD0: JLOW.1
PD1: JLOW.2
PD2: INT.2, JLOW.3
PD3: JLOW.4
RESET: IC1.3 (/MR), ICSP.5, POWER.3, RESET1.3, RESET1.4
RESET_W: IC1.2 (RES), IC4.59 (*RESET)
RXIN: IC4.6 (RXIN), RN2.7 (2), U$1.R2 (RD-)
RXIP: IC4.5 (RXIP), RN2.8 (2), U$1.R1 (RD+)
SCK: IC4.30 (SCLK), IC9.2 (I), ICSP.3
SCK3: IC9.4 (O), X1.5 (5-CLK)
SD_CS: IC10.2 (I), JLOW.5
SEN: IC4.31 (SEN), IC11.4 (O), R8.2
SEN3: IC10.4 (O), X1.2 (2-CD/DAT3)
SH: L1.2, U$1.CH1, U$1.CH2
SPDLED: 100M.C, IC4.67 (SPDLED), U$1.L2 (L2Y-)
SS: IC4.29 (*SCS), IC11.2 (I), JHIGH.3
TXON: IC4.9 (TXON), RN2.5 (2), U$1.R4 (TD-)
TXOP: IC4.8 (TXOP), RN2.6 (2), U$1.R5 (TD+)
V1+: U$1.R10 (SPARE2), ZZ1.P$1 (VA1)
V1-: U$1.R9 (SPARE1), ZZ1.P$2 (VA2)
V2+: U$1.R7 (RXCT), ZZ1.P$4 (VB2)
V2-: U$1.R8 (TXCT), ZZ1.P$3 (VB1)
VIN: C9.+, C10.2, POWER.8, R5.1, ZZ1.P$8 (+VDC)

Notes on the sheet:
ARDUINO ETH SHIELD 06 - Rev 03
active low


Board: 2 copper layers, 68.6 x 53.3 mm, 57 parts (1 on the bottom side), 50 nets.
