nikiiv/zx-uno/hardware/hdmi/hdmi.brd

## EAGLE design hardware/hdmi/hdmi.brd (continued)

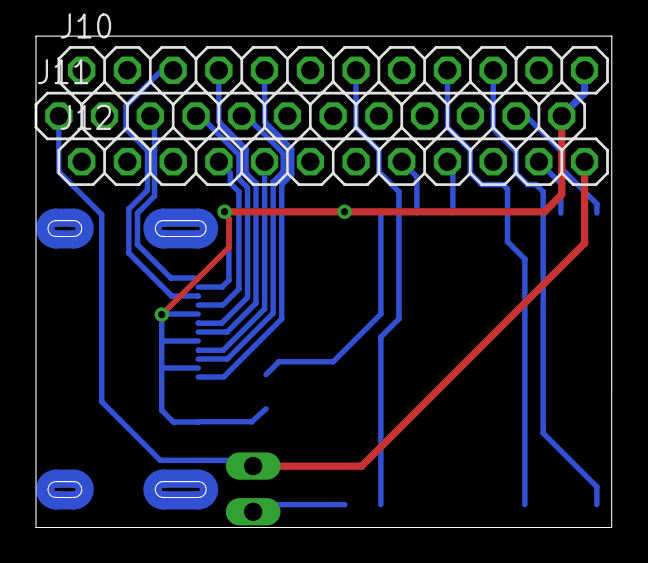
[picture p173: board hdmi.brd from above]

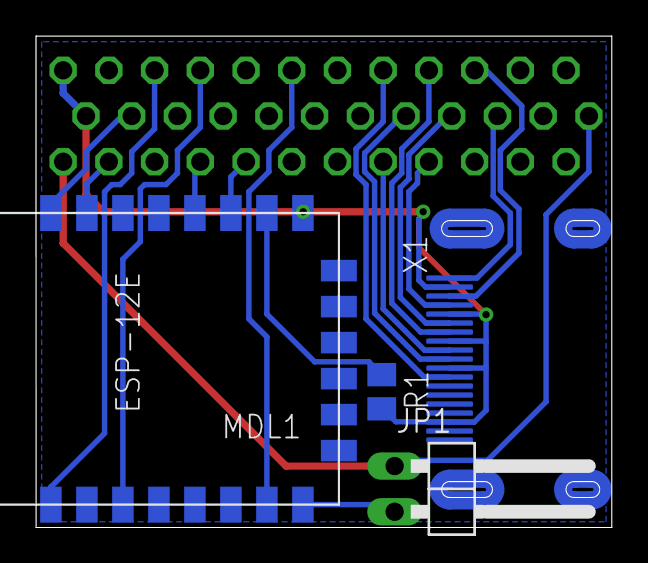
[picture p174: board hdmi.brd from below]

Board: 2 copper layers, 32.0 x 27.3 mm, 7 parts (4 on the bottom side), 19 nets.
