nikiiv/zx-uno/hardware/scart/antiguos/adaptador_vga_scart_activo.brd

## EAGLE design hardware/scart/antiguos/adaptador_vga_scart_activo.brd (2019-06-25, an earlier design)

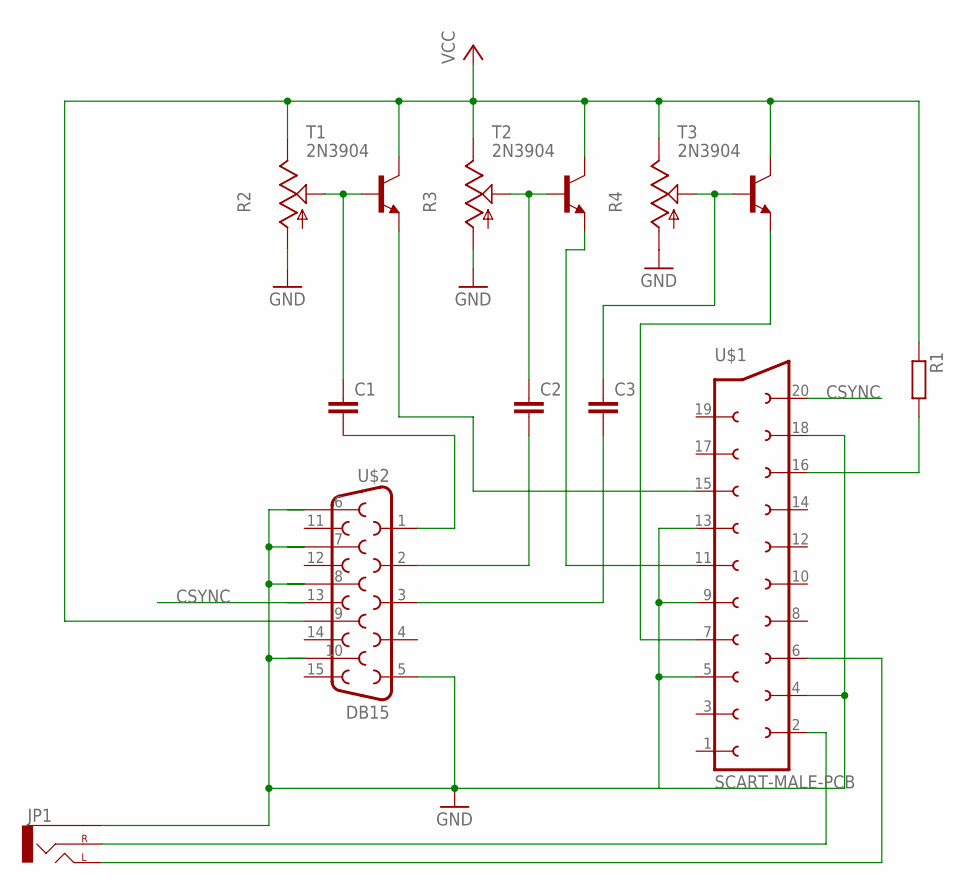
[picture p175: schematic adaptador_vga_scart_activo.sch]

Parts:
C1, C2, C3: C2,5-3; C2.5-3
JP1: AUDIO-JACKPTH; AUDIO-JACK
R1: R-EU_0204/5; 0204/5
R2, R3, R4: TRIM_US-CA6V; CA6V
T1, T2, T3: 2N3904; TO92
U$1: SCART-MALE-PCB; SCART-PCB
U$2: DB15

Connections:
BIN: C3.1, R4.S, T3.2 (B)
BOUT: T3.3 (E), U$1.7
CSYNC: U$1.20, U$2.13
GIN: C2.2, U$2.2
GND: JP1.SLEEVE, R2.A, R3.A, R4.A, U$1.4, U$1.5, U$1.9, U$1.13, U$1.18, U$2.5, U$2.6, U$2.7, U$2.8, U$2.10
GOUT: T2.3 (E), U$1.11
LEFT: JP1.TIP (LEFT), U$1.6
unnamed: C1.1, R2.S, T1.2 (B)
unnamed: C2.1, R3.S, T2.2 (B)
unnamed: C3.2, U$2.3
unnamed: R1.2, U$1.16
RIGHT: JP1.RING (RIGHT), U$1.2
RIN: C1.2, U$2.1
ROUT: T1.3 (E), U$1.15
VCC: R1.1, R2.E, R3.E, R4.E, T1.1 (C), T2.1 (C), T3.1 (C), U$2.9

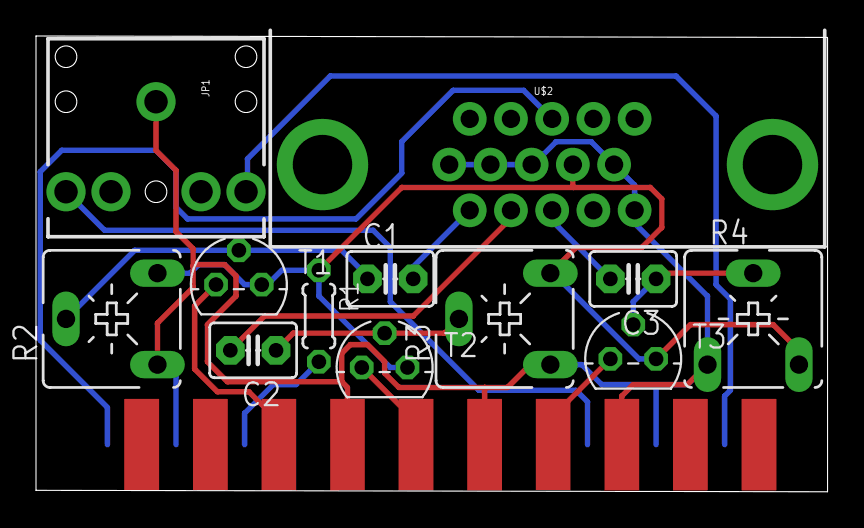
[picture p176: board adaptador_vga_scart_activo.brd from above]

Board: 2 copper layers, 44.0 x 25.3 mm, 13 parts (0 on the bottom side), 15 nets.
