nikiiv/zx-uno/hardware/unojamma/jamma.brd

## EAGLE design hardware/unojamma/jamma.brd (2019-06-25)

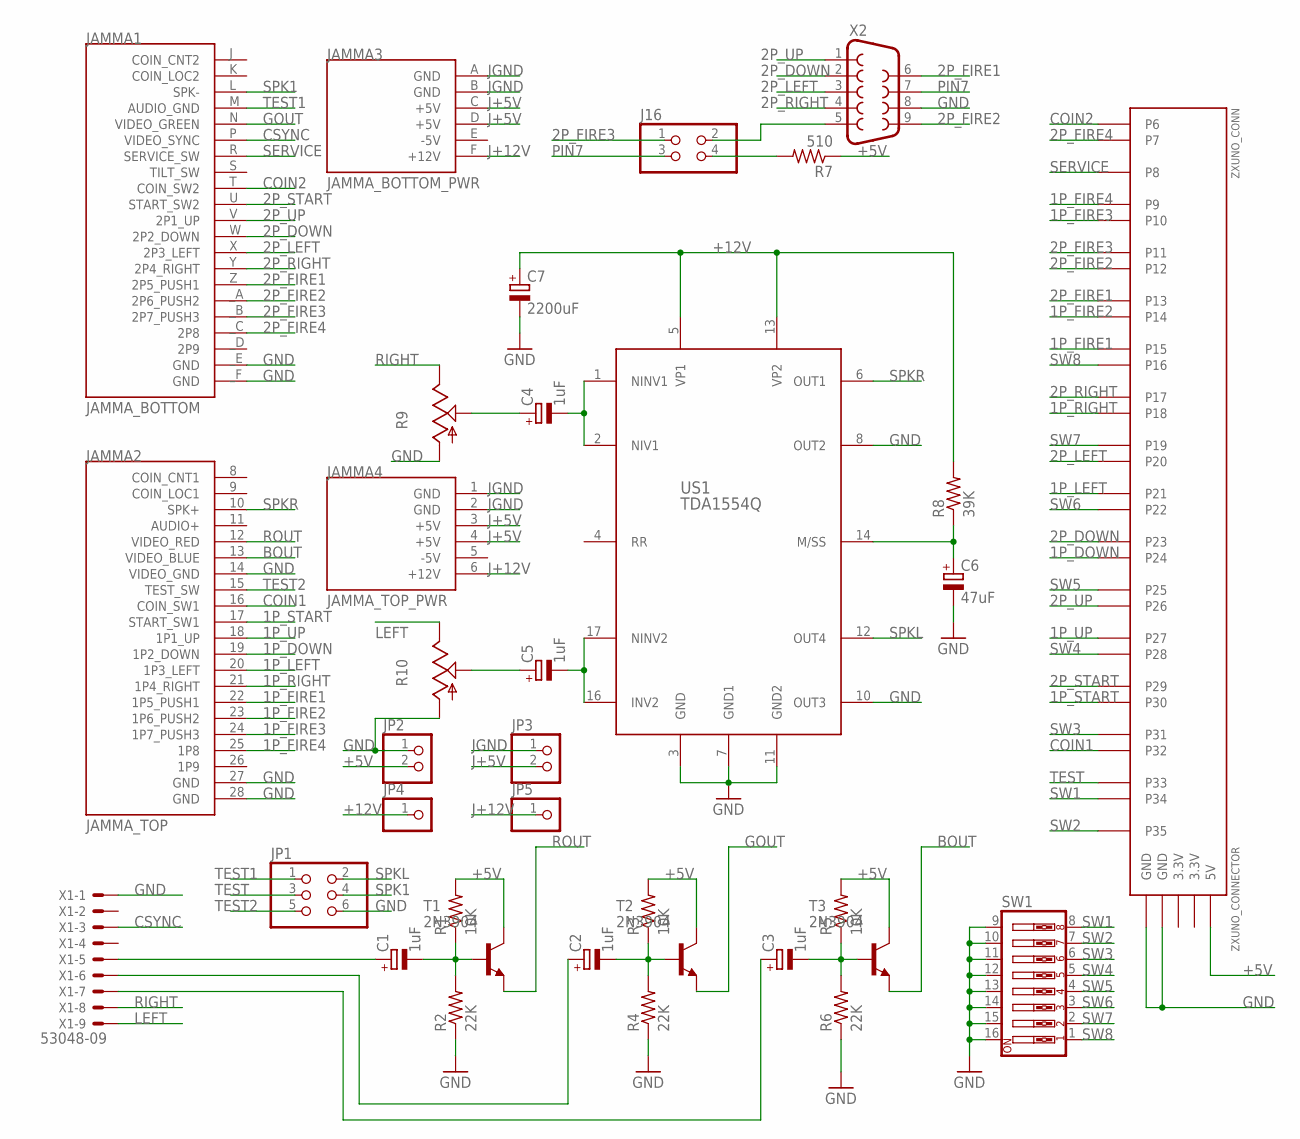
[picture p177: schematic jamma.sch]

Parts:
C1, C2, C3, C4, C5: 1uF; E2-5
C6: 47uF; E5-5
C7: 2200uF; E5-10,5
J16: PINHD-2X2; 2X02
JAMMA1: JAMMA_BOTTOM
JAMMA2: JAMMA_TOP
JAMMA3: JAMMA_BOTTOM_PWR
JAMMA4: JAMMA_TOP_PWR
JP1: PINHD-2X3/90; 2X03/90
JP2, JP3: PINHD-1X2; 1X02
JP4, JP5: PINHD-1X1; 1X01
R1, R3, R5: 10K; 0204/7
R2, R4, R6: 22K; 0204/7
R7: 510; 0204/7
R8: 39K; 0204/7
R9, R10: TRIM_US-CA6V; CA6V
SW1: SW_DIP-8; EDG-08
T1, T2, T3: 2N3904; TO92
US1: TDA1554Q; SOT243-1
X1: 53048-09
X2: DB9MALE; DB9_MALE
ZXUNO_CONN: ZXUNO_CONNECTOR

Connections:
1P_DOWN: JAMMA2.19 (1P2_DOWN), ZXUNO_CONN.P24
1P_FIRE1: JAMMA2.22 (1P5_PUSH1), ZXUNO_CONN.P15
1P_FIRE2: JAMMA2.23 (1P6_PUSH2), ZXUNO_CONN.P14
1P_FIRE3: JAMMA2.24 (1P7_PUSH3), ZXUNO_CONN.P10
1P_FIRE4: JAMMA2.25 (1P8), ZXUNO_CONN.P9
1P_LEFT: JAMMA2.20 (1P3_LEFT), ZXUNO_CONN.P21
1P_RIGHT: JAMMA2.21 (1P4_RIGHT), ZXUNO_CONN.P18
1P_START: JAMMA2.17 (START_SW1), ZXUNO_CONN.P30
1P_UP: JAMMA2.18 (1P1_UP), ZXUNO_CONN.P27
2P_DOWN: JAMMA1.W (2P2_DOWN), X2.2, ZXUNO_CONN.P23
2P_FIRE1: JAMMA1.Z (2P5_PUSH1), X2.6, ZXUNO_CONN.P13
2P_FIRE2: JAMMA1._A (2P6_PUSH2), X2.9, ZXUNO_CONN.P12
2P_FIRE3: J16.1, JAMMA1._B (2P7_PUSH3), ZXUNO_CONN.P11
2P_FIRE4: JAMMA1._C (2P8), ZXUNO_CONN.P7
2P_LEFT: JAMMA1.X (2P3_LEFT), X2.3, ZXUNO_CONN.P20
2P_RIGHT: JAMMA1.Y (2P4_RIGHT), X2.4, ZXUNO_CONN.P17
2P_START: JAMMA1.U (START_SW2), ZXUNO_CONN.P29
2P_UP: JAMMA1.V (2P1_UP), X2.1, ZXUNO_CONN.P26
3.3V: ZXUNO_CONN.3.3V@1 (3.3V), ZXUNO_CONN.3.3V@2 (3.3V)
+5V: JP2.2, R1.2, R3.2, R5.2, R7.1, T1.1 (C), T2.1 (C), T3.1 (C), ZXUNO_CONN.5V
+12V: C7.+, JP4.1, R8.2, US1.5 (VP1), US1.13 (VP2)
-5V: JAMMA3.E (-5V), JAMMA4.5 (-5V)
BIN: C3.+, X1.3
BOUT: JAMMA2.13 (VIDEO_BLUE), T3.3 (E)
COIN1: JAMMA2.16 (COIN_SW1), ZXUNO_CONN.P32
COIN2: JAMMA1.T (COIN_SW2), ZXUNO_CONN.P6
CSYNC: JAMMA1.P (VIDEO_SYNC), X1.7
GIN: C2.+, X1.4
GND: C6.-, C7.-, JAMMA1._E (GND), JAMMA1._F (GND), JAMMA2.14 (VIDEO_GND), JAMMA2.27 (GND), JAMMA2.28 (GND), JP1.6, JP2.1, R2.1, R4.1, R6.1, R9.A, R10.A, SW1.9, SW1.10, SW1.11, SW1.12, SW1.13, SW1.14, SW1.15, SW1.16, US1.3 (GND), US1.7 (GND1), US1.8 (OUT2), US1.10 (OUT3), US1.11 (GND2), X1.9, X2.8, ZXUNO_CONN.GND@1 (GND), ZXUNO_CONN.GND@2 (GND)
GOUT: JAMMA1.N (VIDEO_GREEN), T2.3 (E)
J+5V: JAMMA3.C (+5V), JAMMA3.D (+5V), JAMMA4.3 (+5V), JAMMA4.4 (+5V), JP3.2
J+12V: JAMMA3.F (+12V), JAMMA4.6 (+12V), JP5.1
JGND: JAMMA3.A (GND), JAMMA3.B (GND), JAMMA4.1 (GND), JAMMA4.2 (GND), JP3.1
LEFT: R10.E, X1.1
unnamed: C4.-, US1.1 (NINV1), US1.2 (NIV1)
unnamed: C5.-, US1.16 (INV2), US1.17 (NINV2)
unnamed: C5.+, R10.S
unnamed: C1.-, R1.1, R2.2, T1.2 (B)
unnamed: J16.2, X2.5
unnamed: C6.+, R8.1, US1.14 (M/SS)
unnamed: C3.-, R5.1, R6.2, T3.2 (B)
unnamed: C4.+, R9.S
unnamed: C2.-, R3.1, R4.2, T2.2 (B)
unnamed: J16.4, R7.2
PIN7: J16.3, X2.7
RIGHT: R9.E, X1.2
RIN: C1.+, X1.5
ROUT: JAMMA2.12 (VIDEO_RED), T1.3 (E)
SERVICE: JAMMA1.R (SERVICE_SW), ZXUNO_CONN.P8
SPK1: JAMMA1.L (SPK-), JP1.4
SPKL: JP1.2, US1.12 (OUT4)
SPKR: JAMMA2.10 (SPK+), US1.6 (OUT1)
SW1: SW1.8, ZXUNO_CONN.P34
SW2: SW1.7, ZXUNO_CONN.P35
SW3: SW1.6, ZXUNO_CONN.P31
SW4: SW1.5, ZXUNO_CONN.P28
SW5: SW1.4, ZXUNO_CONN.P25
SW6: SW1.3, ZXUNO_CONN.P22
SW7: SW1.2, ZXUNO_CONN.P19
SW8: SW1.1, ZXUNO_CONN.P16
TEST: JP1.3, ZXUNO_CONN.P33
TEST1: JAMMA1.M (AUDIO_GND), JP1.1
TEST2: JAMMA2.15 (TEST_SW), JP1.5

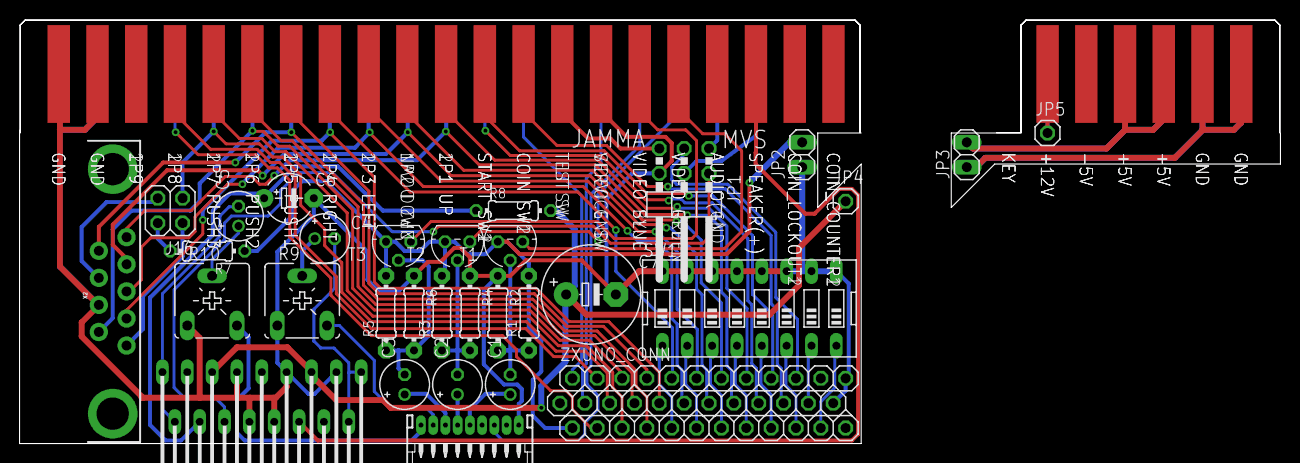
[picture p178: board jamma.brd from above]

Board: 2 copper layers, 128.9 x 43.3 mm, 35 parts (0 on the bottom side), 63 nets.
