nikiiv/zx-uno/hardware/otros/teclado_sustituto_membranas/keyboard.brd

## EAGLE design hardware/otros/teclado_sustituto_membranas/keyboard.brd (2019-06-25)

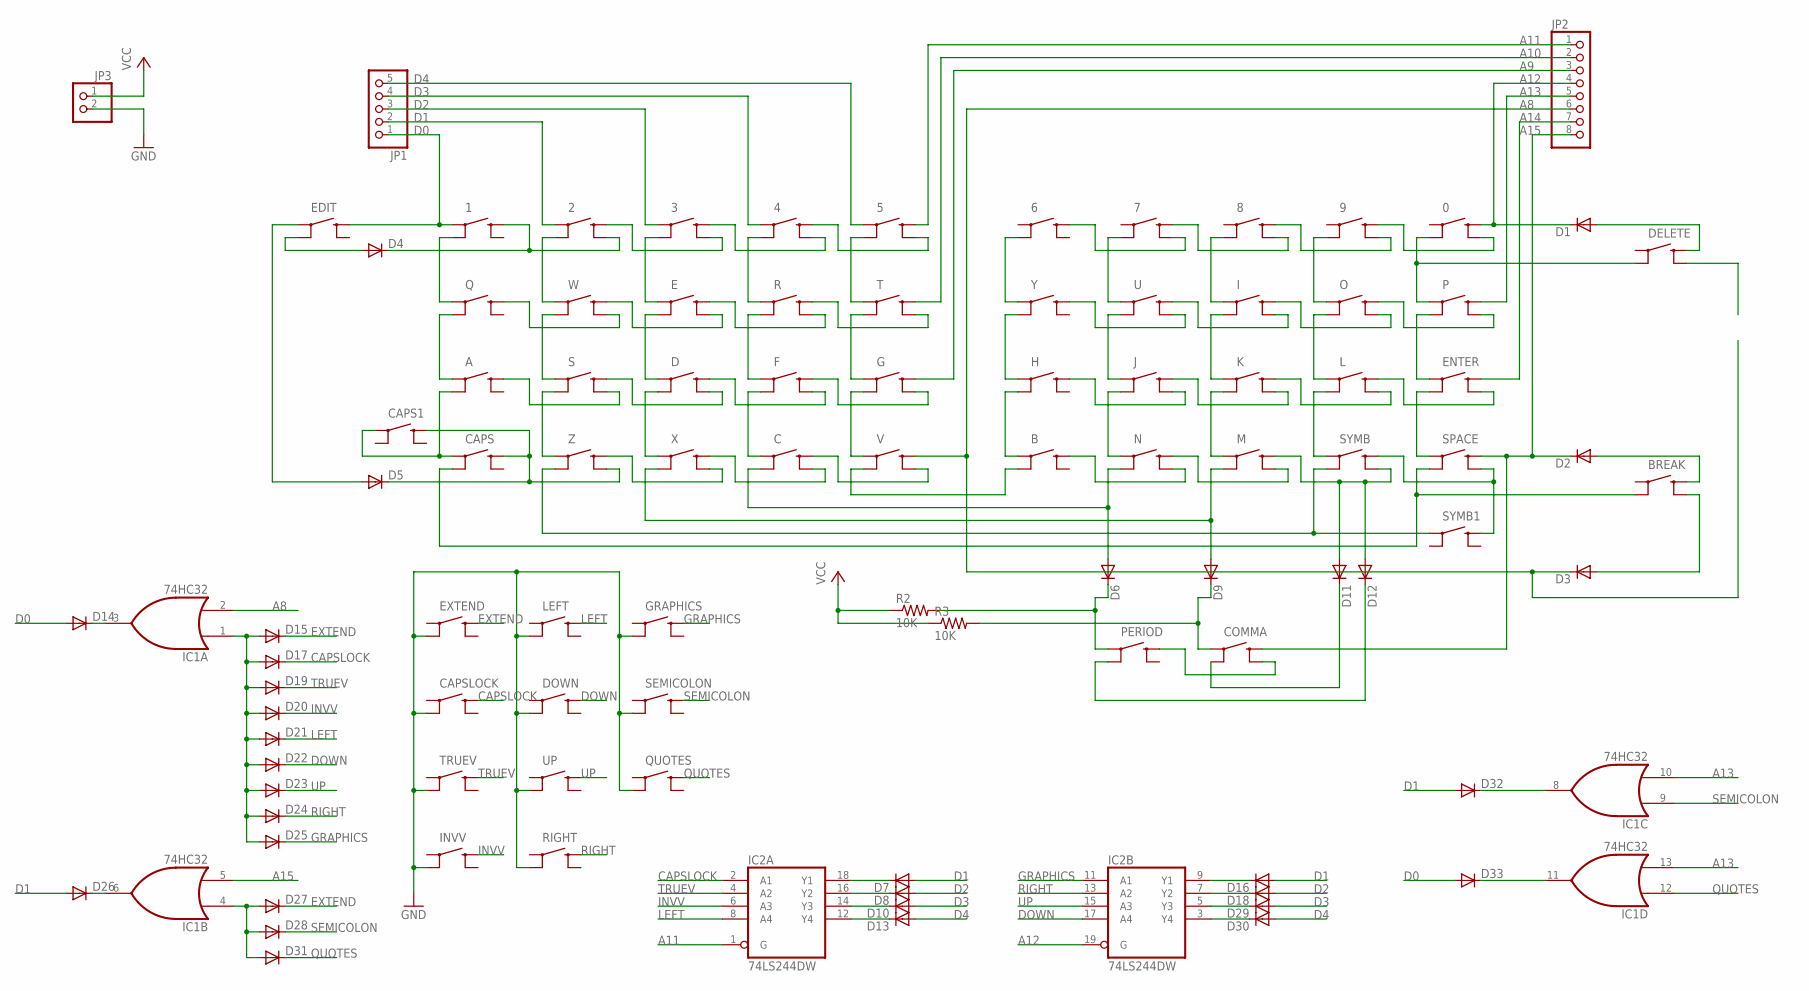
[picture p179: schematic keyboard.sch]

Parts:
0, 1, 2, 3, 4, 5, 6, 7, 8, 9: SWITCH-MOMENTARY-2SMD; TACTILE-SWITCH-SMD
A: SWITCH-MOMENTARY-2SMD; TACTILE-SWITCH-SMD
B: SWITCH-MOMENTARY-2SMD; TACTILE-SWITCH-SMD
BREAK: SWITCH-MOMENTARY-2SMD; TACTILE-SWITCH-SMD
C: SWITCH-MOMENTARY-2SMD; TACTILE-SWITCH-SMD
CAPS, CAPS1: SWITCH-MOMENTARY-2SMD; TACTILE-SWITCH-SMD
CAPSLOCK: SWITCH-MOMENTARY-2SMD; TACTILE-SWITCH-SMD
COMMA: SWITCH-MOMENTARY-2SMD; TACTILE-SWITCH-SMD
D: SWITCH-MOMENTARY-2SMD; TACTILE-SWITCH-SMD
D1, D2, D3, D4, D5, D6, D7, D8, D9, D10, D11, D12, D13, D14, D15, D16, D17, D18, D19, D20, D21, D22, D23, D24, D25, D26, D27, D28, D29, D30, D31, D32, D33: DIODE-SOD323-R; SOD323-R
DELETE: SWITCH-MOMENTARY-2SMD; TACTILE-SWITCH-SMD
DOWN: SWITCH-MOMENTARY-2SMD; TACTILE-SWITCH-SMD
E: SWITCH-MOMENTARY-2SMD; TACTILE-SWITCH-SMD
EDIT: SWITCH-MOMENTARY-2SMD; TACTILE-SWITCH-SMD
ENTER: SWITCH-MOMENTARY-2SMD; TACTILE-SWITCH-SMD
EXTEND: SWITCH-MOMENTARY-2SMD; TACTILE-SWITCH-SMD
F: SWITCH-MOMENTARY-2SMD; TACTILE-SWITCH-SMD
G: SWITCH-MOMENTARY-2SMD; TACTILE-SWITCH-SMD
GRAPHICS: SWITCH-MOMENTARY-2SMD; TACTILE-SWITCH-SMD
H: SWITCH-MOMENTARY-2SMD; TACTILE-SWITCH-SMD
I: SWITCH-MOMENTARY-2SMD; TACTILE-SWITCH-SMD
IC1: 74HC32; SO14
IC2: 74LS244DW; SO20W
INVV: SWITCH-MOMENTARY-2SMD; TACTILE-SWITCH-SMD
J: SWITCH-MOMENTARY-2SMD; TACTILE-SWITCH-SMD
JP1: PINHD-1X5; 1X05
JP2: PINHD-1X8; 1X08
JP3: PINHD-1X2; 1X02
K: SWITCH-MOMENTARY-2SMD; TACTILE-SWITCH-SMD
L: SWITCH-MOMENTARY-2SMD; TACTILE-SWITCH-SMD
LEFT: SWITCH-MOMENTARY-2SMD; TACTILE-SWITCH-SMD
M: SWITCH-MOMENTARY-2SMD; TACTILE-SWITCH-SMD
N: SWITCH-MOMENTARY-2SMD; TACTILE-SWITCH-SMD
O: SWITCH-MOMENTARY-2SMD; TACTILE-SWITCH-SMD
P: SWITCH-MOMENTARY-2SMD; TACTILE-SWITCH-SMD
PERIOD: SWITCH-MOMENTARY-2SMD; TACTILE-SWITCH-SMD
Q: SWITCH-MOMENTARY-2SMD; TACTILE-SWITCH-SMD
QUOTES: SWITCH-MOMENTARY-2SMD; TACTILE-SWITCH-SMD
R: SWITCH-MOMENTARY-2SMD; TACTILE-SWITCH-SMD
R2, R3: 10K; M0805
RIGHT: SWITCH-MOMENTARY-2SMD; TACTILE-SWITCH-SMD
S: SWITCH-MOMENTARY-2SMD; TACTILE-SWITCH-SMD
SEMICOLON: SWITCH-MOMENTARY-2SMD; TACTILE-SWITCH-SMD
SPACE: SWITCH-MOMENTARY-2SMD; TACTILE-SWITCH-SMD
SYMB, SYMB1: SWITCH-MOMENTARY-2SMD; TACTILE-SWITCH-SMD
T: SWITCH-MOMENTARY-2SMD; TACTILE-SWITCH-SMD
TRUEV: SWITCH-MOMENTARY-2SMD; TACTILE-SWITCH-SMD
U: SWITCH-MOMENTARY-2SMD; TACTILE-SWITCH-SMD
UP: SWITCH-MOMENTARY-2SMD; TACTILE-SWITCH-SMD
V: SWITCH-MOMENTARY-2SMD; TACTILE-SWITCH-SMD
W: SWITCH-MOMENTARY-2SMD; TACTILE-SWITCH-SMD
X: SWITCH-MOMENTARY-2SMD; TACTILE-SWITCH-SMD
Y: SWITCH-MOMENTARY-2SMD; TACTILE-SWITCH-SMD
Z: SWITCH-MOMENTARY-2SMD; TACTILE-SWITCH-SMD

Connections:
A8: D3.C, IC1.2 (I1), JP2.6, V.3 (2)
A9: G.3 (2), JP2.3
A10: JP2.2, T.3 (2)
A11: 5.3 (2), IC2.1 (G), JP2.1
A12: 0.3 (2), D1.C, IC2.19 (G), JP2.4
A13: IC1.10 (I1), IC1.13 (I1), JP2.5, P.3 (2)
A14: ENTER.3 (2), JP2.7
A15: COMMA.3 (2), D2.C, IC1.5 (I1), JP2.8, SPACE.3 (2)
CAPSLOCK: CAPSLOCK.3 (2), D17.C, IC2.2 (A1)
D0: 1.1, D14.A, D33.A, EDIT.3 (2), JP1.1
D1: 2.1, D7.A, D16.A, D26.A, D32.A, JP1.2
D2: 3.1, D8.A, D18.A, JP1.3
D3: 4.1, D10.A, D29.A, JP1.4
D4: 5.1, D13.A, D30.A, JP1.5
DOWN: D22.C, DOWN.3 (2), IC2.17 (A4)
EXTEND: D15.C, D27.C, EXTEND.3 (2)
GND: CAPSLOCK.2 (3), DOWN.2 (3), EXTEND.2 (3), GRAPHICS.2 (3), IC1.7 (GND), IC2.10 (GND), INVV.2 (3), JP3.2, LEFT.2 (3), QUOTES.2 (3), RIGHT.2 (3), SEMICOLON.2 (3), TRUEV.2 (3), UP.2 (3)
GRAPHICS: D25.C, GRAPHICS.3 (2), IC2.11 (A1)
INVV: D20.C, IC2.6 (A3), INVV.3 (2)
LEFT: D21.C, IC2.8 (A4), LEFT.3 (2)
unnamed: D4.A, EDIT.2 (3)
unnamed: D5.A, EDIT.1
unnamed: BREAK.3 (2), D2.A
unnamed: BREAK.4, D3.A
unnamed: D1.A, DELETE.3 (2)
unnamed: 1.2 (3), Q.1
unnamed: A.1, Q.2 (3)
unnamed: A.2 (3), CAPS.1, CAPS1.1
unnamed: BREAK.2 (3), CAPS.2 (3), SPACE.2 (3)
unnamed: B.1, H.2 (3)
unnamed: H.1, Y.2 (3)
unnamed: 6.2 (3), Y.1
unnamed: 2.2 (3), W.1
unnamed: S.1, W.2 (3)
unnamed: S.2 (3), Z.1
unnamed: SYMB.2 (3), SYMB1.1, Z.2 (3)
unnamed: D9.A, M.2 (3), X.2 (3)
unnamed: C.2 (3), D6.A, N.2 (3)
unnamed: B.2 (3), V.2 (3)
unnamed: 3.2 (3), E.1
unnamed: D.1, E.2 (3)
unnamed: D.2 (3), X.1
unnamed: 4.2 (3), R.1
unnamed: F.1, R.2 (3)
unnamed: C.1, F.2 (3)
unnamed: 5.2 (3), T.1
unnamed: G.1, T.2 (3)
unnamed: G.2 (3), V.1
unnamed: 3.3 (2), 4.4
unnamed: 4.3 (2), 5.4
unnamed: 2.3 (2), 3.4
unnamed: 1.3 (2), 2.4, D4.C
unnamed: C.3 (2), V.4
unnamed: R.3 (2), T.4
unnamed: E.3 (2), R.4
unnamed: E.4, W.3 (2)
unnamed: Q.3 (2), W.4
unnamed: F.3 (2), G.4
unnamed: D.3 (2), F.4
unnamed: D.4, S.3 (2)
unnamed: A.3 (2), S.4
unnamed: 0.4, 9.3 (2)
unnamed: J.2 (3), N.1
unnamed: J.1, U.2 (3)
unnamed: 7.2 (3), U.1
unnamed: K.2 (3), M.1
unnamed: I.2 (3), K.1
unnamed: 8.2 (3), I.1
unnamed: L.2 (3), SYMB.1
unnamed: L.1, O.2 (3)
unnamed: 9.2 (3), O.1
unnamed: ENTER.2 (3), SPACE.1
unnamed: ENTER.1, P.2 (3)
unnamed: 0.2 (3), DELETE.2 (3), P.1
unnamed: 8.3 (2), 9.4
unnamed: 7.3 (2), 8.4
unnamed: 6.3 (2), 7.4
unnamed: C.4, X.3 (2)
unnamed: X.4, Z.3 (2)
unnamed: CAPS.3 (2), CAPS1.3 (2), D5.C, Z.4
unnamed: O.3 (2), P.4
unnamed: I.3 (2), O.4
unnamed: I.4, U.3 (2)
unnamed: U.4, Y.3 (2)
unnamed: ENTER.4, L.3 (2)
unnamed: K.3 (2), L.4
unnamed: J.3 (2), K.4
unnamed: H.3 (2), J.4
unnamed: SPACE.4, SYMB.3 (2), SYMB1.3 (2)
unnamed: D11.A, D12.A, M.3 (2), SYMB.4
unnamed: M.4, N.3 (2)
unnamed: B.3 (2), N.4
unnamed: D7.C, IC2.18 (Y1)
unnamed: D8.C, IC2.16 (Y2)
unnamed: COMMA.4, PERIOD.3 (2)
unnamed: D10.C, IC2.14 (Y3)
unnamed: COMMA.2 (3), D11.C
unnamed: D12.C, PERIOD.2 (3)
unnamed: D13.C, IC2.12 (Y4)
unnamed: D16.C, IC2.9 (Y1)
unnamed: D6.C, PERIOD.1, R2.2
unnamed: COMMA.1, D9.C, R3.2
unnamed: D14.C, IC1.3 (O)
unnamed: D18.C, IC2.7 (Y2)
unnamed: D26.C, IC1.6 (O)
unnamed: D27.A, D28.A, D31.A, IC1.4 (I0)
unnamed: D29.C, IC2.5 (Y3)
unnamed: D30.C, IC2.3 (Y4)
unnamed: D15.A, D17.A, D19.A, D20.A, D21.A, D22.A, D23.A, D24.A, D25.A, IC1.1 (I0)
unnamed: D32.C, IC1.8 (O)
unnamed: D33.C, IC1.11 (O)
QUOTES: D31.C, IC1.12 (I0), QUOTES.3 (2)
RIGHT: D24.C, IC2.13 (A2), RIGHT.3 (2)
SEMICOLON: D28.C, IC1.9 (I0), SEMICOLON.3 (2)
TRUEV: D19.C, IC2.4 (A2), TRUEV.3 (2)
UP: D23.C, IC2.15 (A3), UP.3 (2)
VCC: IC1.14 (VCC), IC2.20 (VCC), JP3.1, R2.1, R3.1

Board: 2 copper layers, 98 parts (58 on the bottom side), 117 nets, no tracks yet.
