nikiiv/zx-uno/hardware/USB-PS2/USB-PS2_v4.2.brd

## EAGLE design hardware/USB-PS2/USB-PS2_v4.2.brd (2019-06-25)

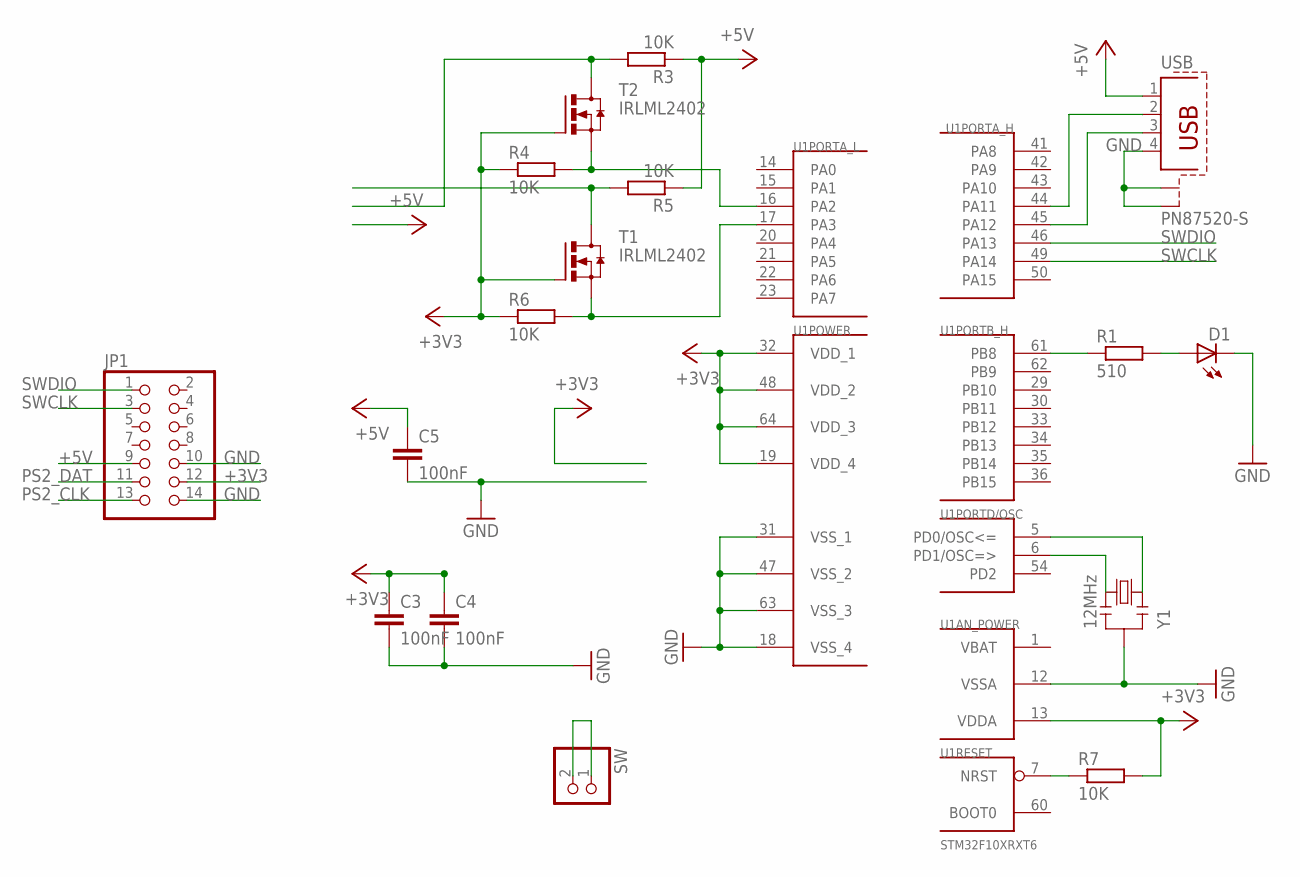
[picture p180: schematic USB-PS2_v4.2.sch]

Parts:
C3, C4, C5: 100nF; C0805
D1: LEDSML0805; SML0805
JP1: PINHD-2X7; 2X07
R1: 510; R0805
R3, R4, R5, R6, R7: 10K; R0805
SW: PINHD-1X2; 1X02
T1, T2: IRLML2402; MICRO3
U1: STM32F10XRXT6; TQFP64
USB: PN87520-S
Y1: 12MHz; RESONATOR

Connections:
+3V3: C3.1, C4.1, JP1.12, R4.1, R6.1, R7.2, T1.1 (G), T2.1 (G), U1.13 (VDDA), U1.19 (VDD_4), U1.32 (VDD_1), U1.48 (VDD_2), U1.64 (VDD_3)
+5V: C5.1, JP1.9, R3.1, R5.1, USB.1
GND: C3.2, C4.2, C5.2, D1.C, JP1.10, JP1.14, U1.12 (VSSA), U1.18 (VSS_4), U1.31 (VSS_1), U1.47 (VSS_2), U1.63 (VSS_3), USB.4, USB.S1, USB.S2, Y1.2
unnamed: U1.44 (PA11), USB.2
unnamed: U1.45 (PA12), USB.3
unnamed: R1.1, U1.61 (PB8)
unnamed: U1.5 (PD0/OSC<=), Y1.1
unnamed: D1.A, R1.2
unnamed: U1.6 (PD1/OSC=>), Y1.3
unnamed: R7.1, U1.7 (NRST)
unnamed: SW.1, SW.2
unnamed: R6.2, T1.2 (S), U1.17 (PA3)
unnamed: R4.2, T2.2 (S), U1.16 (PA2)
PS2_CLK: JP1.13, R5.2, T1.3 (D)
PS2_DAT: JP1.11, R3.2, T2.3 (D)
SWCLK: JP1.3, U1.49 (PA14)
SWDIO: JP1.1, U1.46 (PA13)
VBAT: U1.1 (VBAT)

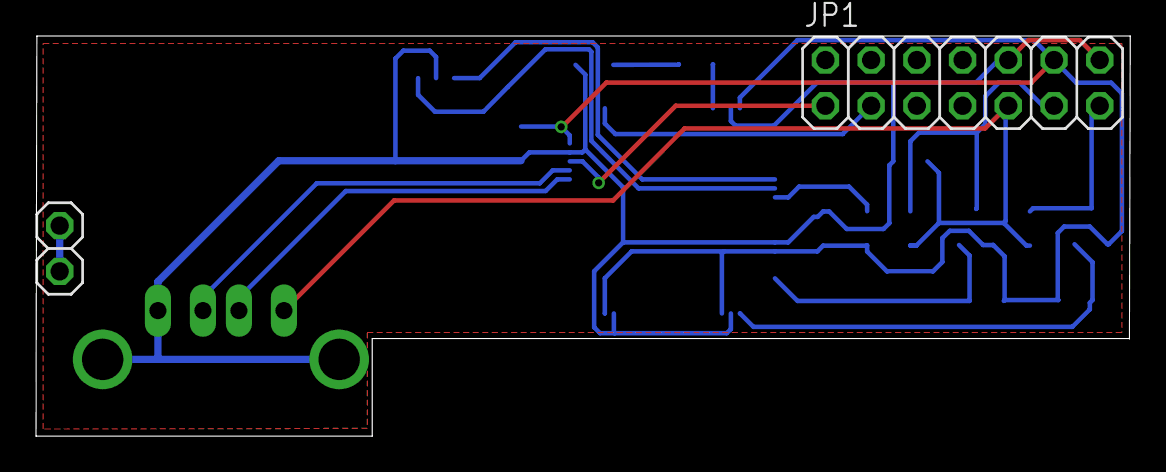
[picture p181: board USB-PS2_v4.2.brd from above]

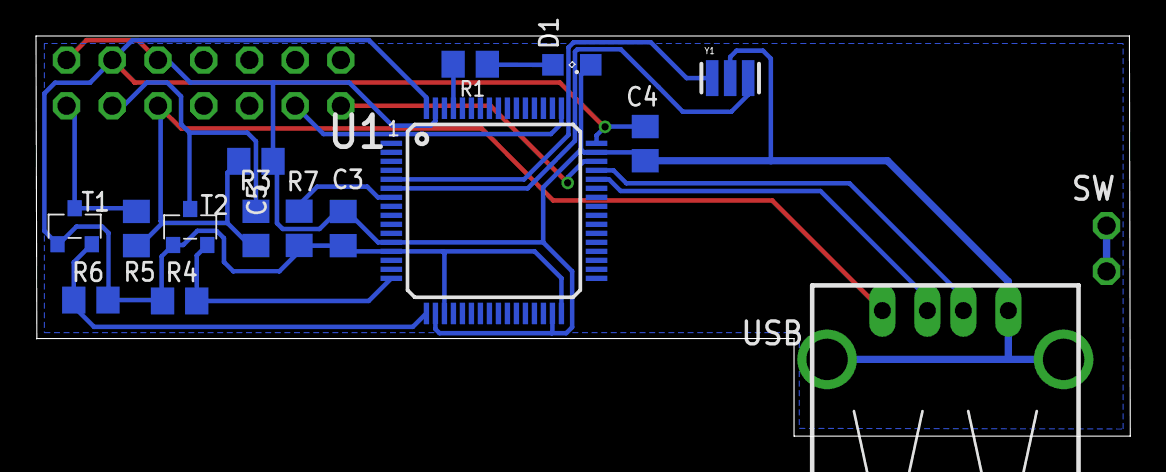
[picture p182: board USB-PS2_v4.2.brd from below]

Board: 2 copper layers, 60.8 x 22.2 mm, 17 parts (15 on the bottom side), 17 nets.
