nikiiv/zx-uno/hardware/ps2arduino/arduino_adapter+2a.brd

## EAGLE design hardware/ps2arduino/arduino_adapter+2a.brd (2019-06-25)

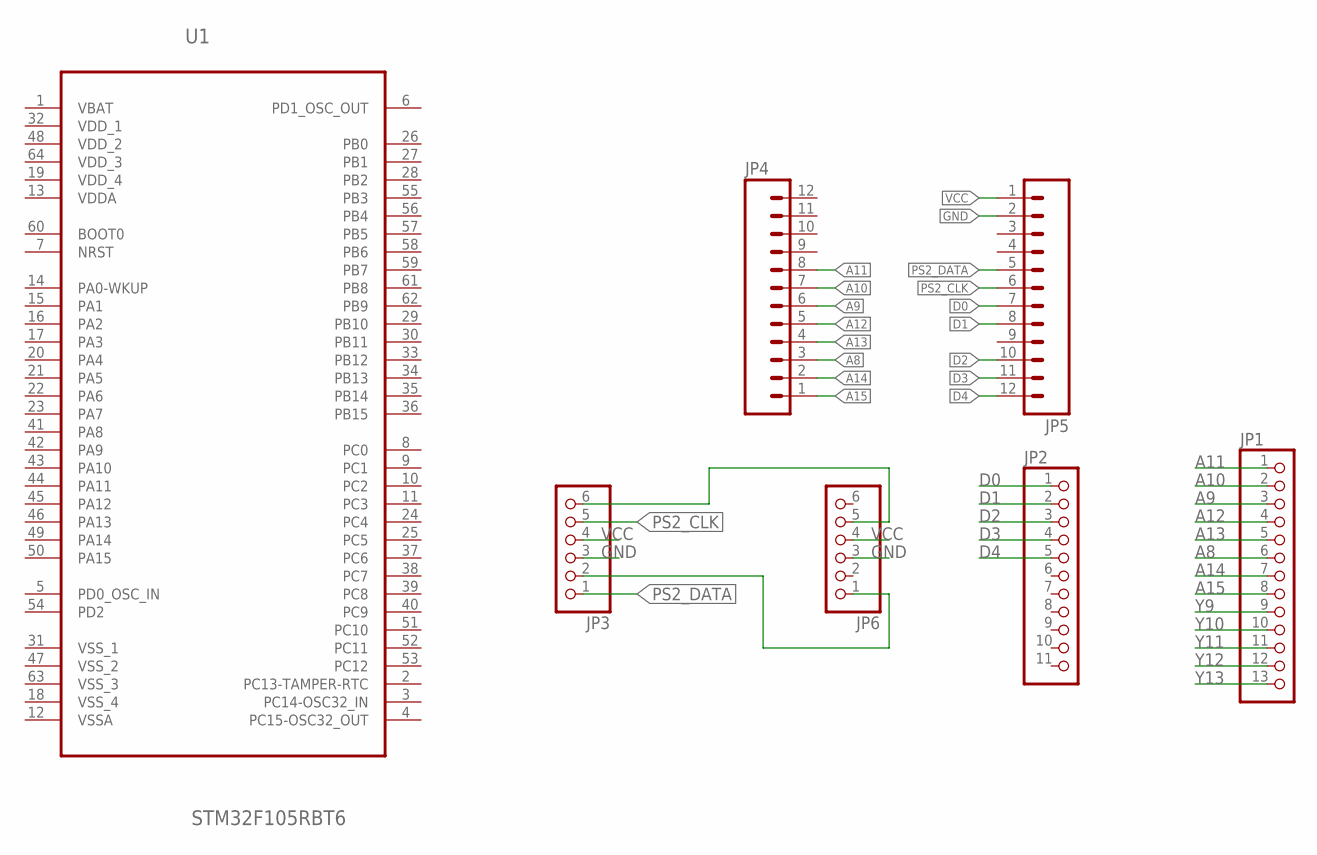
[picture p183: schematic arduino_adapter+2a.sch]

Parts:
JP1: PINHD-1X13; 1X13
JP2: PINHD-1X11; 1X11
JP3, JP6: PINHD-1X6; 1X06
JP4, JP5: M12PTH; 1X12
U1: STM32F105RBT6; QFP50P1200X1200X160-64N

Connections:
A8: JP1.6, JP4.3
A9: JP1.3, JP4.6
A10: JP1.2, JP4.7
A11: JP1.1, JP4.8
A12: JP1.4, JP4.5
A13: JP1.5, JP4.4
A14: JP1.7, JP4.2
A15: JP1.8, JP4.1
D0: JP2.1, JP5.7
D1: JP2.2, JP5.8
D2: JP2.3, JP5.10
D3: JP2.4, JP5.11
D4: JP2.5, JP5.12
GND: JP3.3, JP5.2, JP6.3
unnamed: JP3.6, JP6.5
unnamed: JP3.2, JP6.1
PS2_CLK: JP3.5, JP5.6
PS2_DATA: JP3.1, JP5.5
VBAT: U1.1 (VBAT)
VCC: JP3.4, JP5.1, JP6.4
VDDA: U1.13 (VDDA)
VDD_1: U1.32 (VDD_1)
VDD_2: U1.48 (VDD_2)
VDD_3: U1.64 (VDD_3)
VDD_4: U1.19 (VDD_4)
VSSA: U1.12 (VSSA)
VSS_1: U1.31 (VSS_1)
VSS_2: U1.47 (VSS_2)
VSS_3: U1.63 (VSS_3)
VSS_4: U1.18 (VSS_4)
Y9: JP1.9
Y10: JP1.10
Y11: JP1.11
Y12: JP1.12
Y13: JP1.13

Board: 2 copper layers, 7 parts (0 on the bottom side), 19 nets, no tracks yet.
