nikiiv/zx-uno/hardware/otros/interface2/kartusho2.brd

## EAGLE design hardware/otros/interface2/kartusho2.brd (2019-06-25)

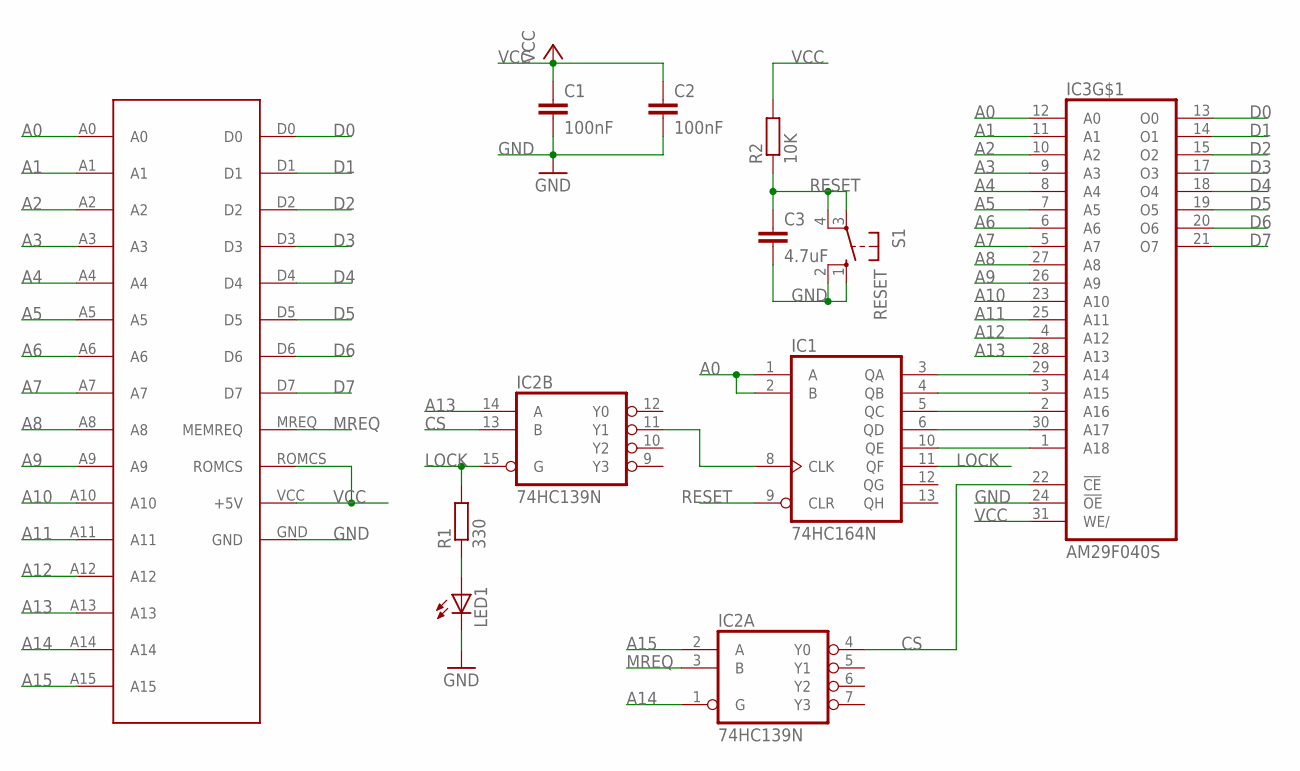
[picture p184: schematic kartusho2.sch]

Parts:
C1, C2: 100nF; C025-025X050
C3: 4.7uF; C025-025X050
IC1: 74HC164N; DIL14
IC2: 74HC139N; DIL16
IC3: AM29F040S; PLCC-SR32
LED1: LED3MM
R1: 330; 0204/7
R2: 10K; 0204/7
S1: RESET; B3F-10XX
U$1: IF2BUS; BUS_CARTUCHO_IF2

Connections:
A0: IC1.1 (A), IC1.2 (B), IC3.12 (A0), U$1.A0
A1: IC3.11 (A1), U$1.A1
A2: IC3.10 (A2), U$1.A2
A3: IC3.9 (A3), U$1.A3
A4: IC3.8 (A4), U$1.A4
A5: IC3.7 (A5), U$1.A5
A6: IC3.6 (A6), U$1.A6
A7: IC3.5 (A7), U$1.A7
A8: IC3.27 (A8), U$1.A8
A9: IC3.26 (A9), U$1.A9
A10: IC3.23 (A10), U$1.A10
A11: IC3.25 (A11), U$1.A11
A12: IC3.4 (A12), U$1.A12
A13: IC2.14 (A), IC3.28 (A13), U$1.A13
A14: IC2.1 (G), U$1.A14
A15: IC2.2 (A), U$1.A15
CS: IC2.4 (Y0), IC2.13 (B), IC3.22 (!CE)
D0: IC3.13 (O0), U$1.D0
D1: IC3.14 (O1), U$1.D1
D2: IC3.15 (O2), U$1.D2
D3: IC3.17 (O3), U$1.D3
D4: IC3.18 (O4), U$1.D4
D5: IC3.19 (O5), U$1.D5
D6: IC3.20 (O6), U$1.D6
D7: IC3.21 (O7), U$1.D7
GND: C1.2, C2.2, C3.2, IC1.7 (GND), IC2.8 (GND), IC3.16 (GND), IC3.24 (!OE), LED1.K (C), S1.1 (S), S1.2 (S1), U$1.GND
LOCK: IC1.11 (QF), IC2.15 (G), R1.2
MREQ: IC2.3 (B), U$1.MREQ (MEMREQ)
unnamed: IC1.8 (CLK), IC2.11 (Y1)
unnamed: IC1.10 (QE), IC3.1 (A18)
unnamed: IC1.6 (QD), IC3.30 (A17)
unnamed: IC1.5 (QC), IC3.2 (A16)
unnamed: IC1.4 (QB), IC3.3 (A15)
unnamed: IC1.3 (QA), IC3.29 (A14)
unnamed: LED1.A, R1.1
RESET: C3.1, IC1.9 (CLR), R2.1, S1.3, S1.4 (P1)
VCC: C1.1, C2.1, IC1.14 (VCC), IC2.16 (VCC), IC3.31 (WE/), IC3.32 (VCC), R2.2, U$1.ROMCS, U$1.VCC (+5V)

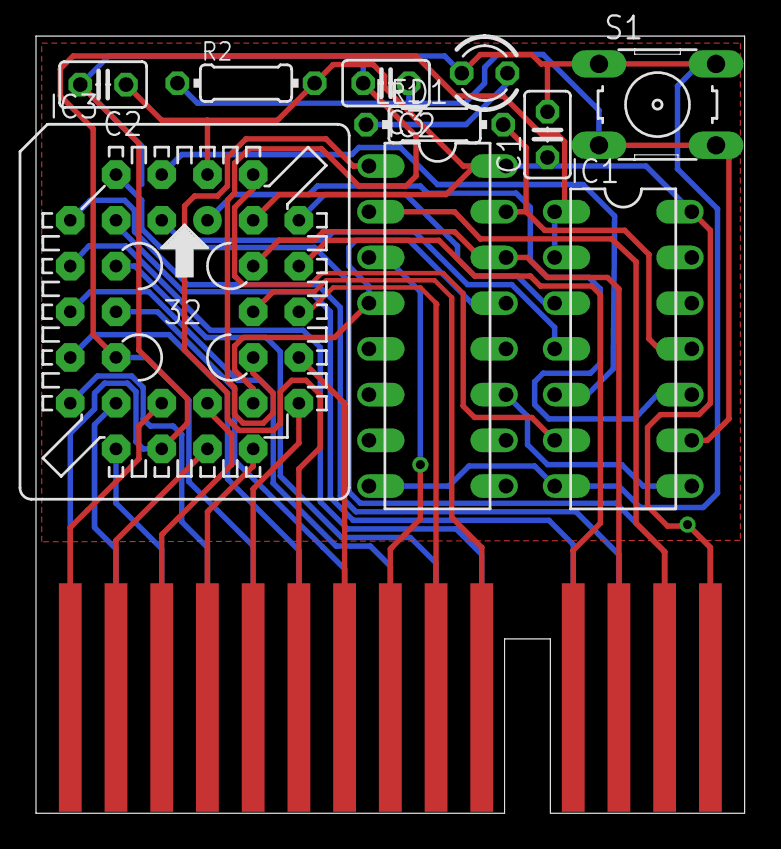
[picture p185: board kartusho2.brd from above]

Board: 2 copper layers, 39.4 x 43.2 mm, 11 parts (0 on the bottom side), 37 nets.
