nikiiv/zx-uno/hardware/otros/raspberry/amebot2_motors.brd

## EAGLE design hardware/otros/raspberry/amebot2_motors.brd (2019-06-25)

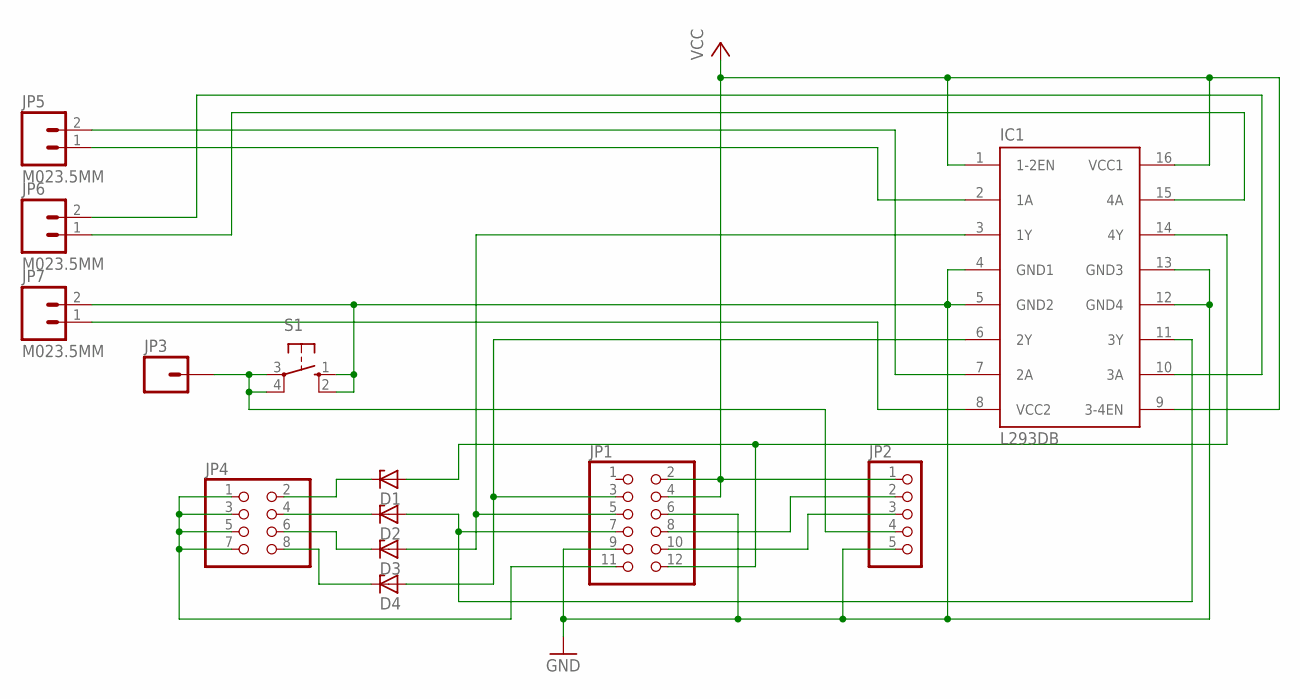
[picture p186: schematic amebot2_motors.sch]

Parts:
D1, D2, D3, D4: ZENER-DIODEZD-7.5; ZDIO-7.5
IC1: L293DB; DIL16VAR
JP1: PINHD-2X6; 2X06
JP2: PINHD-1X5; 1X05
JP3: M01PTH_LONGPAD; 1X01_LONGPAD
JP4: PINHD-2X4; 2X04
JP5, JP6, JP7: M023.5MM; SCREWTERMINAL-3.5MM-2
S1: 10-XX; B3F-10XX

Connections:
GND: IC1.4 (GND1), IC1.5 (GND2), IC1.12 (GND4), IC1.13 (GND3), JP1.6, JP1.9, JP2.5, JP7.2, S1.1 (S), S1.2 (S1)
unnamed: D1.C, JP4.2
unnamed: JP2.4, JP3.1, S1.3, S1.4 (P1)
unnamed: D4.A, IC1.6 (2Y), JP1.3
unnamed: D3.A, IC1.3 (1Y), JP1.5
unnamed: JP1.11, JP4.1, JP4.3, JP4.5, JP4.7
unnamed: D1.A, IC1.14 (4Y), JP1.12
unnamed: JP1.8, JP2.2
unnamed: IC1.2 (1A), JP5.1
unnamed: IC1.7 (2A), JP5.2
unnamed: IC1.15 (4A), JP6.1
unnamed: IC1.10 (3A), JP6.2
unnamed: IC1.8 (VCC2), JP7.1
unnamed: JP1.10, JP2.3
unnamed: D2.A, IC1.11 (3Y), JP1.7
unnamed: D2.C, JP4.4
unnamed: D3.C, JP4.6
unnamed: D4.C, JP4.8
VCC: IC1.1 (1-2EN), IC1.9 (3-4EN), IC1.16 (VCC1), JP1.2, JP1.4, JP2.1

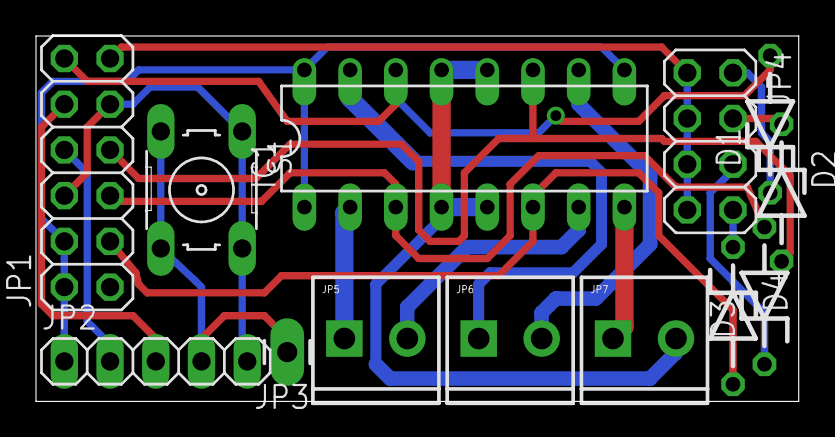
[picture p187: board amebot2_motors.brd from above]

Board: 2 copper layers, 42.4 x 20.3 mm, 13 parts (0 on the bottom side), 19 nets.
