nikiiv/zx-uno/hardware/usbjtag/usb_blaster.brd

## EAGLE design hardware/usbjtag/usb_blaster.brd (2019-06-25)

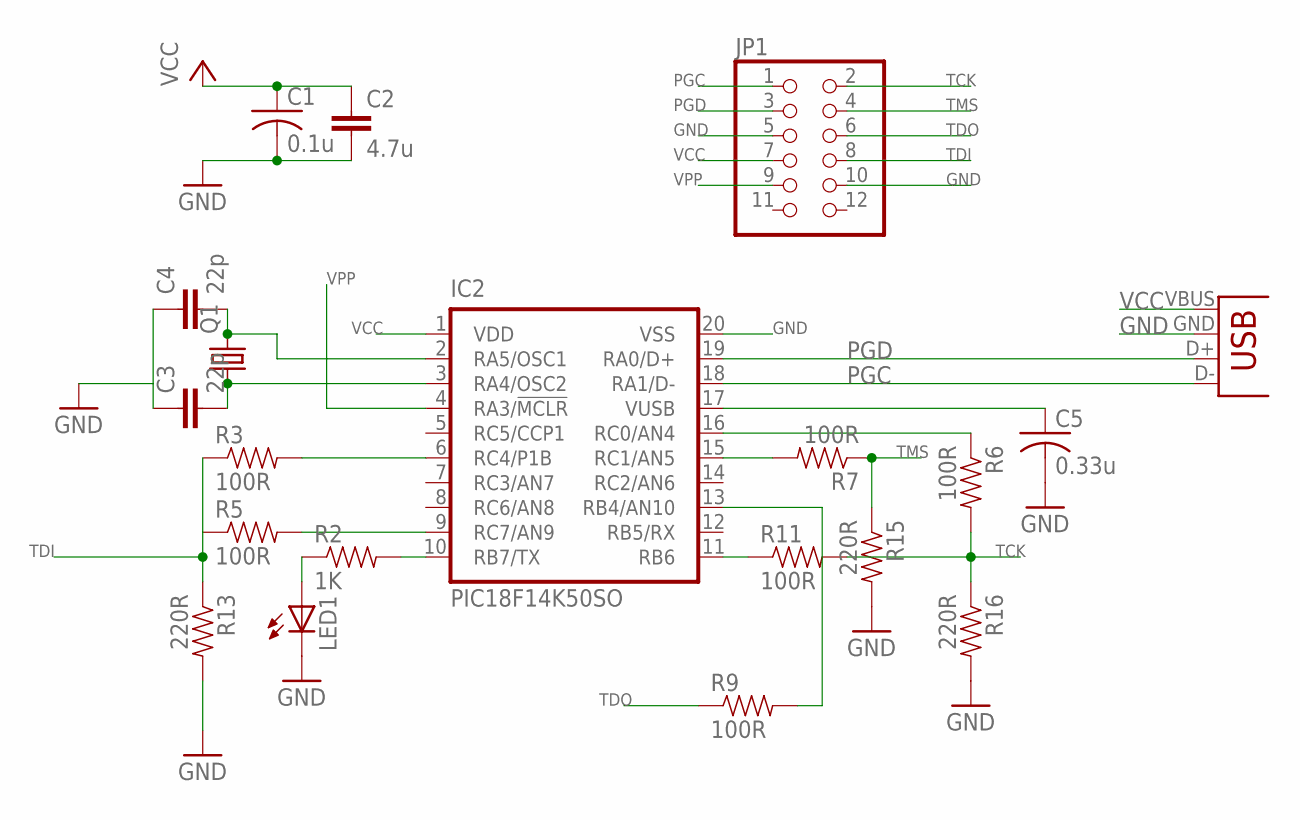
[picture p188: schematic usb_blaster.sch]

Parts:
C1: 0.1u; C0603K
C2: 4.7u; 0805
C3, C4: 22p; 0805
C5: 0.33u; C0603K
IC2: PIC18F14K50SO; SO20
JP1: PINHD-2X6; 2X06
LED1: LEDCHIP-LED0805; CHIP-LED0805
Q1: CRYSTALHC49UP; HC49UP
R2: 1K; 0805
R3, R5, R6, R7, R9, R11: 100R; 0805
R13, R15, R16: 220R; 0805
X2: USB-A-H

Connections:
GND: C1.2, C2.2, C3.1, C4.1, C5.2, IC2.20 (VSS), JP1.5, JP1.10, LED1.C, R13.2, R15.2, R16.2, X2.GND (VBUS)
unnamed: C4.2, IC2.2 (RA5/OSC1), Q1.2
unnamed: IC2.15 (RC1/AN5), R7.2
unnamed: C3.2, IC2.3 (RA4/OSC2), Q1.1
unnamed: IC2.16 (RC0/AN4), R6.1
unnamed: IC2.13 (RB4/AN10), R9.2
unnamed: IC2.6 (RC4/P1B), R3.2
unnamed: C5.1, IC2.17 (VUSB)
unnamed: IC2.9 (RC7/AN9), R5.2
unnamed: IC2.10 (RB7/TX), R2.2
unnamed: LED1.A, R2.1
unnamed: IC2.11 (RB6), R11.1
PGC: IC2.18 (RA1/D-), JP1.1, X2.D- (D+)
PGD: IC2.19 (RA0/D+), JP1.3, X2.D+ (D-)
TCK: JP1.2, R6.2, R11.2, R16.1
TDI: JP1.8, R3.1, R5.1, R13.1
TDO: JP1.6, R9.1
TMS: JP1.4, R7.1, R15.1
VCC: C1.1, C2.1, IC2.1 (VDD), JP1.7, X2.VBUS (GND)
VPP: IC2.4 (RA3/!MCLR!), JP1.9

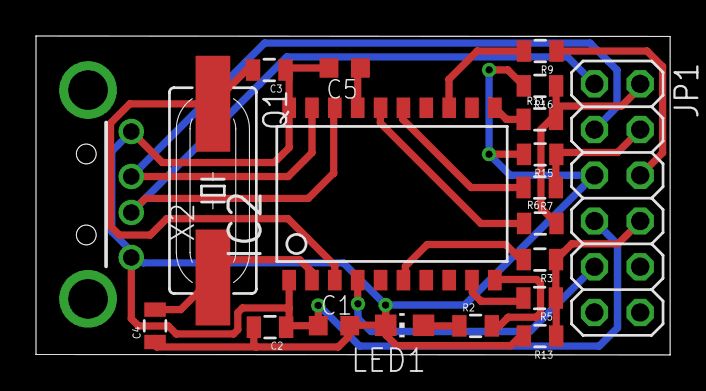
[picture p189: board usb_blaster.brd from above]

Board: 2 copper layers, 35.2 x 17.7 mm, 20 parts (0 on the bottom side), 20 nets.
