nikiiv/zx-uno/hardware/otros/raspberry/amebot_arduino_leds.brd

## EAGLE design hardware/otros/raspberry/amebot_arduino_leds.brd (2019-06-25)

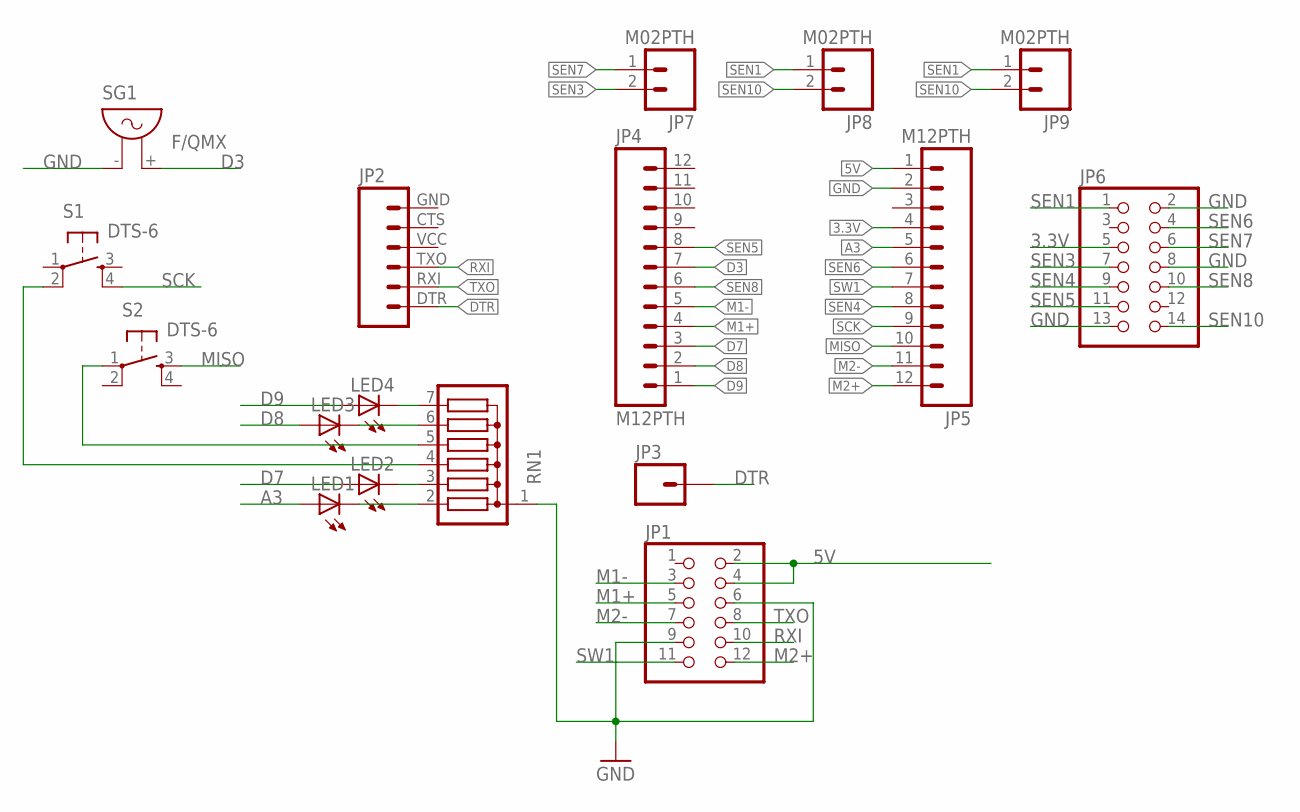
[picture p193: schematic amebot_arduino_leds.sch]

Parts:
JP1: PINHD-2X6; 2X06
JP2: M06SIP; 1X06
JP3: M01PTH_LONGPAD; 1X01_LONGPAD
JP4, JP5: M12PTH; 1X12
JP6: PINHD-2X7; 2X07
JP7, JP8, JP9: M02PTH; 1X02
LED1, LED2, LED3, LED4: LED3MM
RN1: G06R; SIL7
S1, S2: DTS-6
SG1: F/QMX

Connections:
3.3V: JP5.4, JP6.5
5V: JP1.2, JP1.4, JP5.1
A3: JP5.5, LED1.A
D3: JP4.7, SG1.+ (2)
D7: JP4.3, LED2.A
D8: JP4.2, LED3.A
D9: JP4.1, LED4.A
DTR: JP2.DTR (1), JP3.1
GND: JP1.6, JP1.9, JP5.2, JP6.2, JP6.8, JP6.13, RN1.1, SG1.- (1)
M1+: JP1.5, JP4.4
M1-: JP1.3, JP4.5
M2+: JP1.12, JP5.12
M2-: JP1.7, JP5.11
MISO: JP5.10, S2.3
unnamed: LED2.K (C), RN1.3
unnamed: LED1.K (C), RN1.2
unnamed: LED4.K (C), RN1.7
unnamed: LED3.K (C), RN1.6
unnamed: RN1.4, S1.2
unnamed: RN1.5, S2.1
RXI: JP1.10, JP2.TXO (3)
SCK: JP5.9, S1.4
SEN1: JP6.1, JP8.1, JP9.1
SEN3: JP6.7, JP7.2
SEN4: JP5.8, JP6.9
SEN5: JP4.8, JP6.11
SEN6: JP5.6, JP6.4
SEN7: JP6.6, JP7.1
SEN8: JP4.6, JP6.10
SEN10: JP6.14, JP8.2, JP9.2
SW1: JP1.11, JP5.7
TXO: JP1.8, JP2.RXI (2)

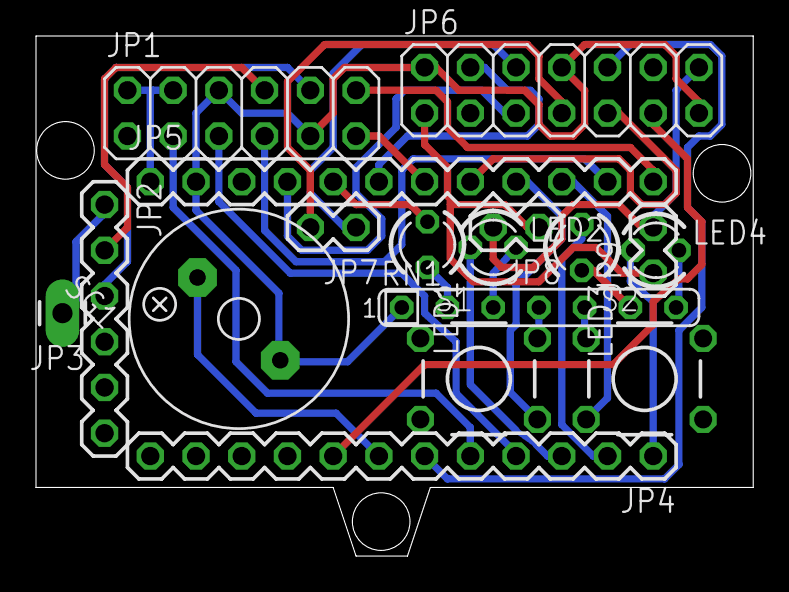
[picture p194: board amebot_arduino_leds.brd from above]

Board: 2 copper layers, 39.8 x 28.9 mm, 17 parts (0 on the bottom side), 32 nets.
