nikiiv/zx-uno/hardware/wifi/dac_wifi.brd

## EAGLE design hardware/wifi/dac_wifi.brd (2019-06-25)

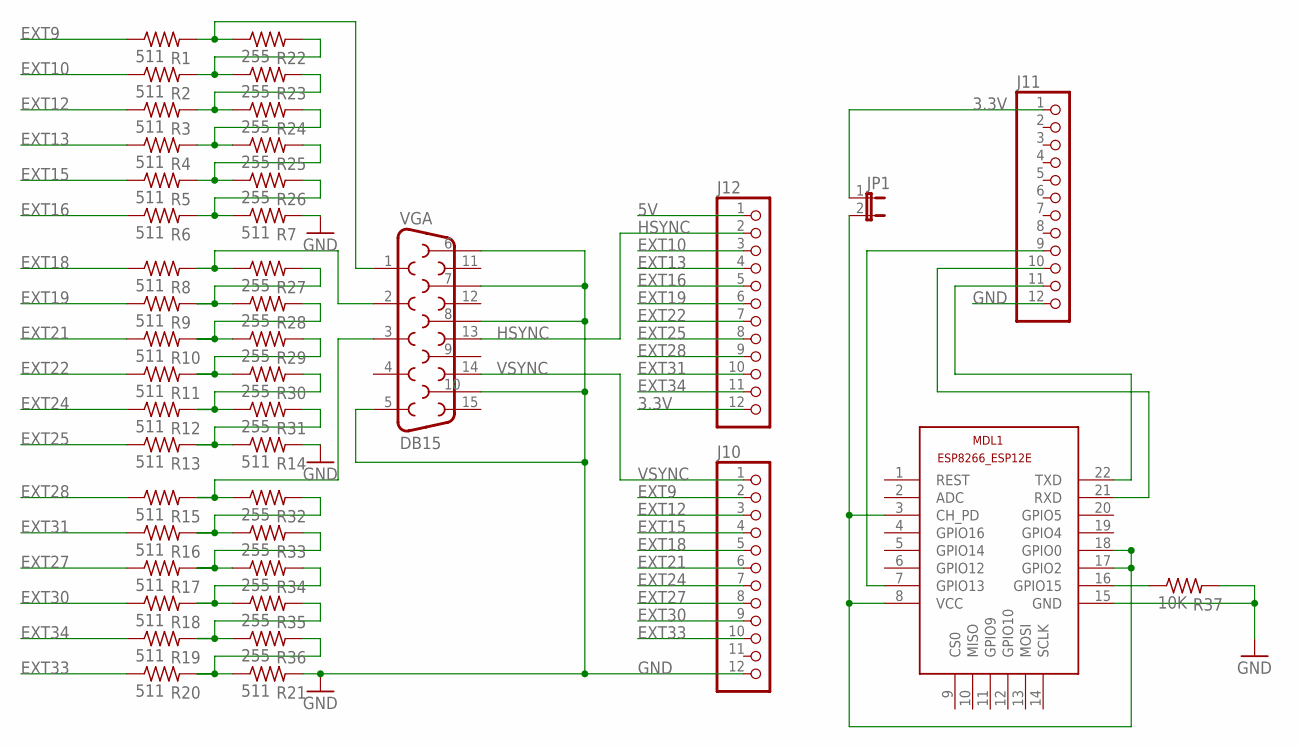
[picture p195: schematic dac_wifi.sch]

Parts:
J10, J11, J12: PINHD-1X12; 1X12
JP1: JP1E; JP1
MDL1: ESP8266-12EESP8266-ESP12E; ESP8266-ESP12E
R1, R2, R3, R4, R5, R6, R7, R8, R9, R10, R11, R12, R13, R14, R15, R16, R17, R18, R19, R20, R21: 511; R0805
R22, R23, R24, R25, R26, R27, R28, R29, R30, R31, R32, R33, R34, R35, R36: 255; R0805
R37: 10K; R0805
VGA: DB15

Connections:
3.3V: J11.1, J12.12, JP1.1
5V: J12.1
EXT9: J10.2, R1.1
EXT10: J12.3, R2.1
EXT12: J10.3, R3.1
EXT13: J12.4, R4.1
EXT15: J10.4, R5.1
EXT16: J12.5, R6.1
EXT18: J10.5, R8.1
EXT19: J12.6, R9.1
EXT21: J10.6, R10.1
EXT22: J12.7, R11.1
EXT24: J10.7, R12.1
EXT25: J12.8, R13.1
EXT27: J10.8, R17.1
EXT28: J12.9, R15.1
EXT30: J10.9, R18.1
EXT31: J12.10, R16.1
EXT33: J10.10, R20.1
EXT34: J12.11, R19.1
GND: J10.12, J11.12, MDL1.15 (GND), R7.2, R14.2, R21.2, R37.2, VGA.5, VGA.6, VGA.7, VGA.8, VGA.10
GREEN: R8.2, R27.1, VGA.2
HSYNC: J12.2, VGA.13
unnamed: MDL1.16 (GPIO15), R37.1
unnamed: J11.9, MDL1.7 (GPIO13)
unnamed: J11.10, MDL1.21 (RXD)
unnamed: J11.11, MDL1.22 (TXD)
unnamed: R20.2, R21.1, R36.2
unnamed: R9.2, R27.2, R28.1
unnamed: R2.2, R22.2, R23.1
unnamed: R1.2, R22.1, VGA.1
unnamed: R12.2, R30.2, R31.1
unnamed: R6.2, R7.1, R26.2
unnamed: R3.2, R23.2, R24.1
unnamed: R4.2, R24.2, R25.1
unnamed: R5.2, R25.2, R26.1
unnamed: R11.2, R29.2, R30.1
unnamed: R13.2, R14.1, R31.2
unnamed: R10.2, R28.2, R29.1
unnamed: R15.2, R32.1, VGA.3
unnamed: R16.2, R32.2, R33.1
unnamed: R17.2, R33.2, R34.1
unnamed: R18.2, R34.2, R35.1
unnamed: R19.2, R35.2, R36.1
VIN: JP1.2, MDL1.3 (CH_PD), MDL1.8 (VCC), MDL1.17 (GPIO2), MDL1.18 (GPIO0)
VSYNC: J10.1, VGA.14

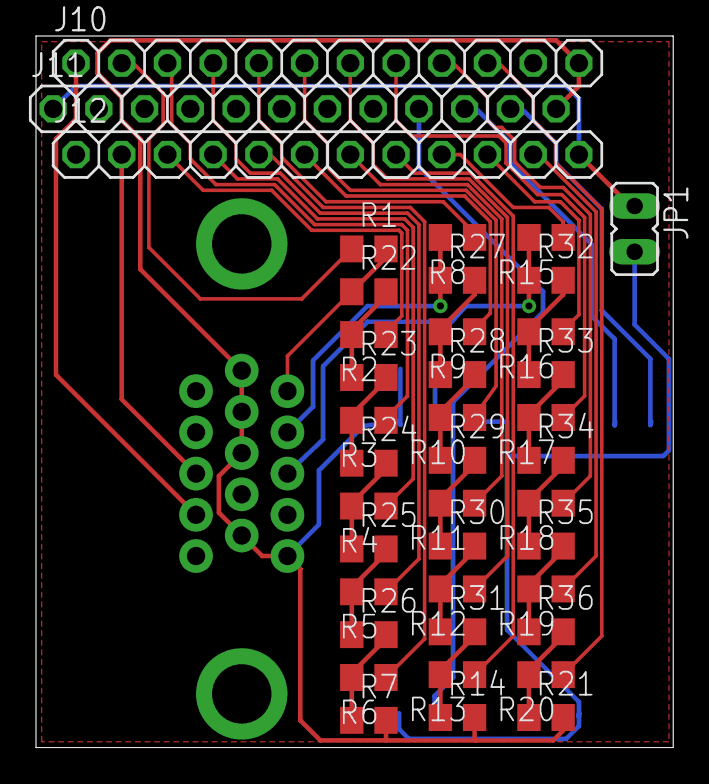
[picture p196: board dac_wifi.brd from above]

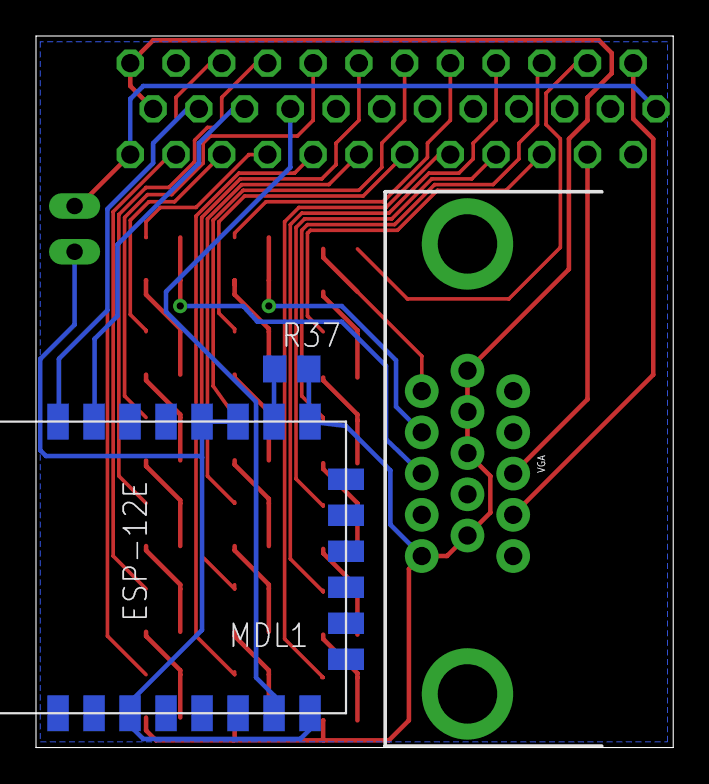
[picture p197: board dac_wifi.brd from below]

Board: 2 copper layers, 35.4 x 39.5 mm, 43 parts (3 on the bottom side), 45 nets.
