nikiiv/zx-uno/hardware/zxuno/chloe/chloe.sch

## EAGLE design hardware/zxuno/chloe/chloe.sch (2019-06-25)

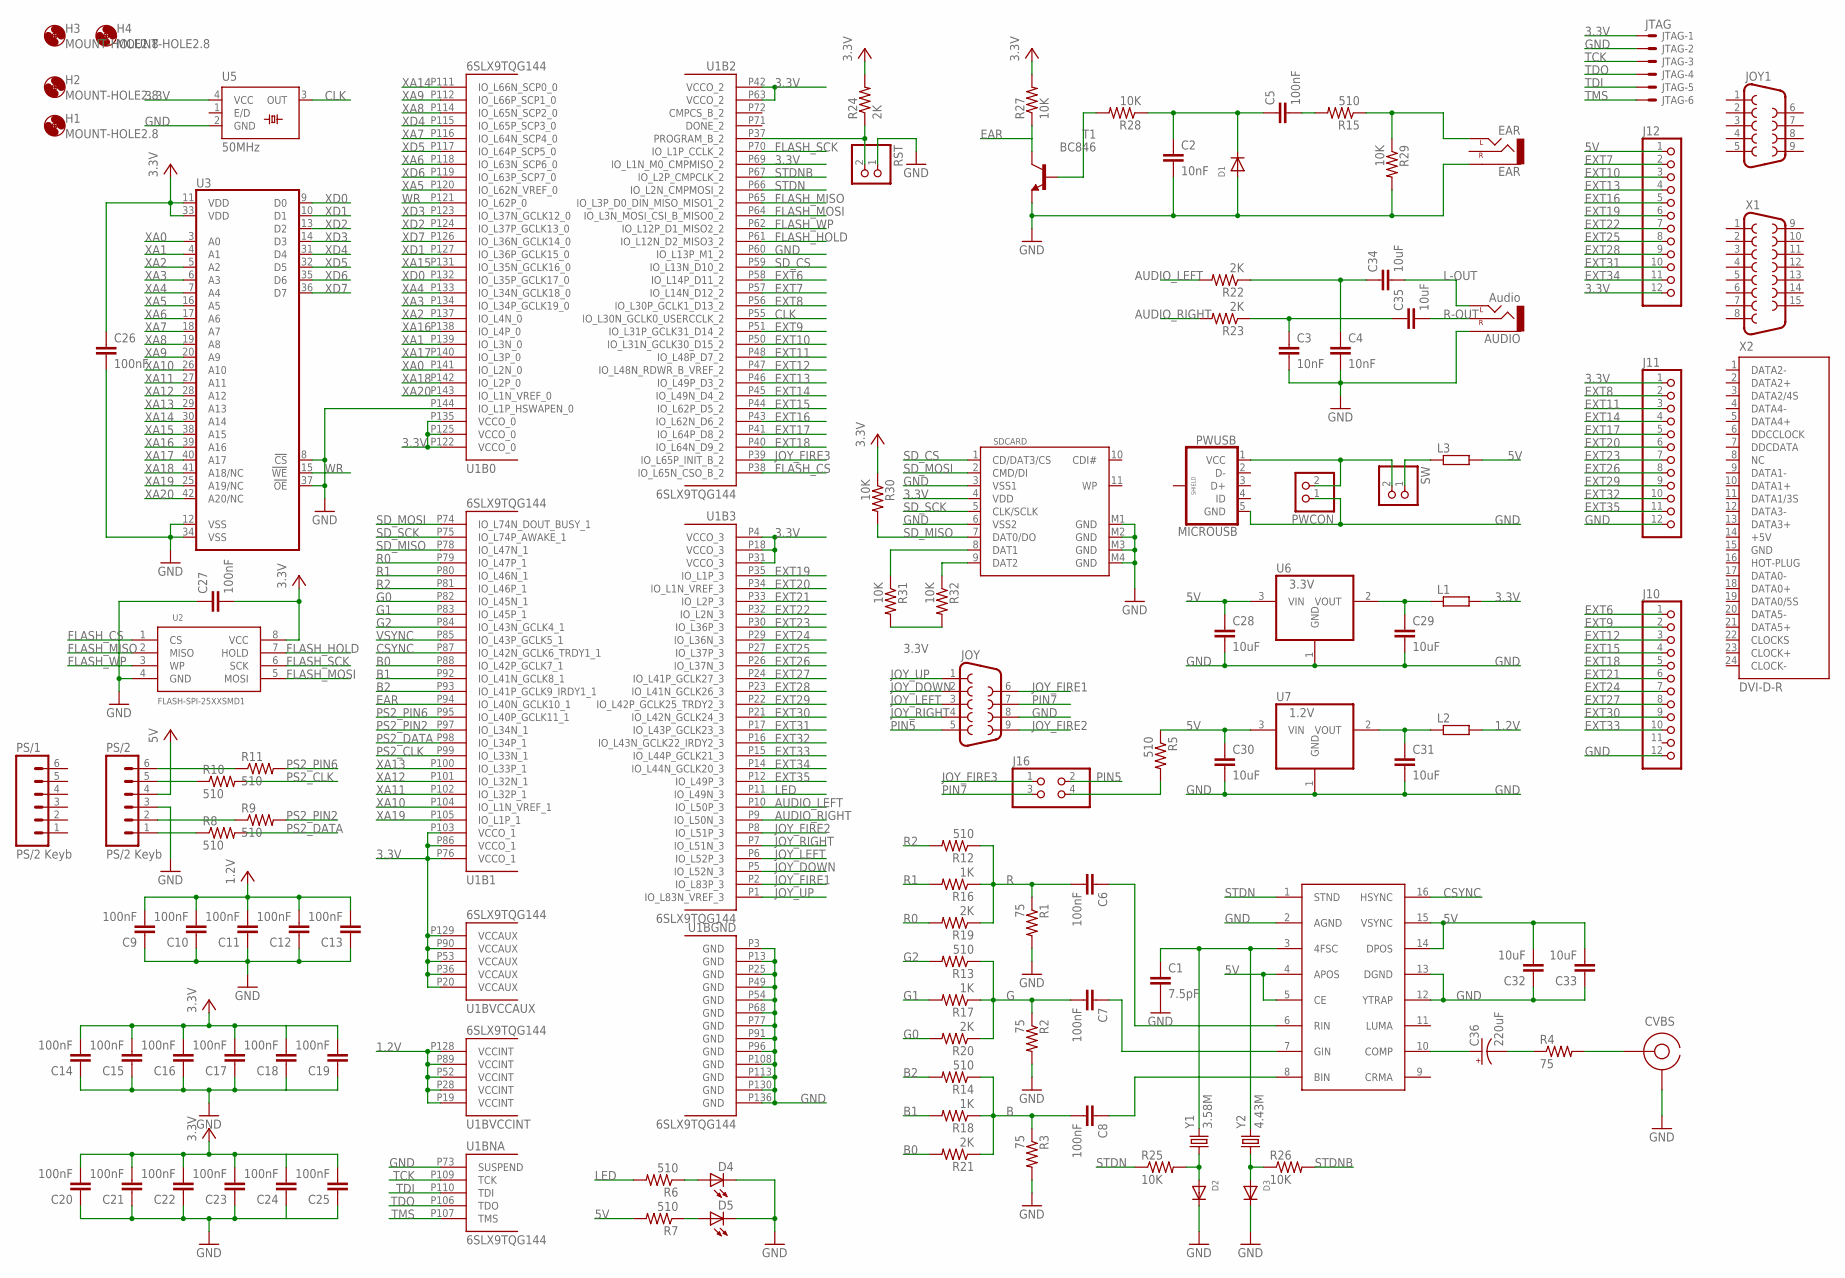
[picture p199: schematic chloe.sch]

Parts:
AUDIO: Audio; AUDIO-JACK
C1: 7.5pF; C0805
C2, C3, C4: 10nF; C0805
C5, C6, C7, C8, C9, C10, C11, C12, C13, C14, C15, C16, C17, C18, C19, C20, C21, C22, C23, C24, C25, C26, C27: 100nF; C0603
C28, C29, C30, C31, C32, C33, C34, C35: 10uF; C0805
C36: 220uF; 153CLV-0605
CVBS: RCA
D1, D2, D3: DIODESOD-323F; SOD-323F
D4, D5: LEDCHIP-LED0805; CHIP-LED0805
EAR: EAR; AUDIO-JACK
H1, H2, H3, H4: MOUNT-HOLE2.8; 2,8
J10, J11, J12: PINHD-1X12; 1X12
J16: PINHD-2X2; 2X02
JOY, JOY1: DB9MALE; DB9_MALE
JTAG: JTAG; 53047-06
L1, L2, L3: R-EU_M0805; M0805
PS/1, PS/2: PS/2 Keyb; DINC/MIN_TM/6_1PRIMARY
PWCON: PINHD-1X2; 1X02
PWUSB: MICROUSB; MICRO_USB_1PRIMARY
R1, R2, R3, R4: 75; M0805
R5, R6, R7, R8, R9, R10, R11, R12, R13, R14, R15: 510; M0805
R16, R17, R18: 1K; M0805
R19, R20, R21, R22, R23, R24: 2K; M0805
R25, R26, R27, R28, R29, R30, R31, R32: 10K; M0805
RST: PINHD-1X2; 1X02
SDCARD: SDCARD; SDCMF-10915W010
SW: PINHD-1X2; 1X02
T1: BC846; SOT23
U1: 6SLX9TQG144; TQ144
U2: FLASH-SPI-25XXSMD1; SO08-EIAJ
U3: ISSI_SRAM_8BIT; TSOP44-II
U4: AD724; SO16W
U5: 50MHz; SM/OSC_1PRIMARY
U6: 3.3V; SOT223
U7: 1.2V; SOT223
X1: F15HDH; HDF15H
X2: DVI-D-R
Y1: 3.58M; HC49UP
Y2: 4.43M; HC49UP

Connections:
1.2V: C9.2, C10.2, C11.2, C12.2, C13.2, L2.2, U1.P19 (VCCINT), U1.P28 (VCCINT), U1.P52 (VCCINT), U1.P89 (VCCINT), U1.P128 (VCCINT)
3.3V: C14.2, C15.2, C16.2, C17.2, C18.2, C19.2, C20.2, C21.2, C22.2, C23.2, C24.2, C25.2, C26.1, C27.2, J11.1, J12.12, JTAG.1, L1.2, R24.2, R27.2, R30.1, R31.2, R32.2, SDCARD.4 (VDD), U1.P4 (VCCO_3), U1.P18 (VCCO_3), U1.P20 (VCCAUX), U1.P31 (VCCO_3), U1.P36 (VCCAUX), U1.P42 (VCCO_2), U1.P53 (VCCAUX), U1.P63 (VCCO_2), U1.P69 (IO_L1N_M0_CMPMISO_2), U1.P76 (VCCO_1), U1.P86 (VCCO_1), U1.P90 (VCCAUX), U1.P103 (VCCO_1), U1.P122 (VCCO_0), U1.P125 (VCCO_0), U1.P129 (VCCAUX), U1.P135 (VCCO_0), U2.8 (VCC), U3.11 (VDD), U3.33 (VDD), U5.4 (VCC)
5V: C28.1, C30.1, C32.2, C33.2, J12.1, L3.2, PS/2.4, R5.1, R7.2, U4.4 (APOS), U4.5 (CE), U4.14 (DPOS), U4.15 (VSYNC), U6.3 (VIN), U7.3 (VIN)
AUDIO_LEFT: R22.2, U1.P10 (IO_L50P_3)
AUDIO_RIGHT: R23.2, U1.P9 (IO_L50N_3)
B: C8.2, R3.1, R14.1, R18.1, R21.1
B0: R21.2, U1.P88 (IO_L42P_GCLK7_1)
B1: R18.2, U1.P92 (IO_L41N_GCLK8_1)
B2: R14.2, U1.P93 (IO_L41P_GCLK9_IRDY1_1)
CLK: U1.P55 (IO_L30N_GCLK0_USERCCLK_2), U5.3 (OUT)
CSYNC: U1.P87 (IO_L42N_GCLK6_TRDY1_1), U4.16 (HSYNC)
EAR: R27.1, T1.3 (C), U1.P94 (IO_L40N_GCLK10_1)
EXT6: J10.1, U1.P58 (IO_L14P_D11_2)
EXT7: J12.2, U1.P57 (IO_L14N_D12_2)
EXT8: J11.2, U1.P56 (IO_L30P_GCLK1_D13_2)
EXT9: J10.2, U1.P51 (IO_L31P_GCLK31_D14_2)
EXT10: J12.3, U1.P50 (IO_L31N_GCLK30_D15_2)
EXT11: J11.3, U1.P48 (IO_L48P_D7_2)
EXT12: J10.3, U1.P47 (IO_L48N_RDWR_B_VREF_2)
EXT13: J12.4, U1.P46 (IO_L49P_D3_2)
EXT14: J11.4, U1.P45 (IO_L49N_D4_2)
EXT15: J10.4, U1.P44 (IO_L62P_D5_2)
EXT16: J12.5, U1.P43 (IO_L62N_D6_2)
EXT17: J11.5, U1.P41 (IO_L64P_D8_2)
EXT18: J10.5, U1.P40 (IO_L64N_D9_2)
EXT19: J12.6, U1.P35 (IO_L1P_3)
EXT20: J11.6, U1.P34 (IO_L1N_VREF_3)
EXT21: J10.6, U1.P33 (IO_L2P_3)
EXT22: J12.7, U1.P32 (IO_L2N_3)
EXT23: J11.7, U1.P30 (IO_L36P_3)
EXT24: J10.7, U1.P29 (IO_L36N_3)
EXT25: J12.8, U1.P27 (IO_L37P_3)
EXT26: J11.8, U1.P26 (IO_L37N_3)
EXT27: J10.8, U1.P24 (IO_L41P_GCLK27_3)
EXT28: J12.9, U1.P23 (IO_L41N_GCLK26_3)
EXT29: J11.9, U1.P22 (IO_L42P_GCLK25_TRDY2_3)
EXT30: J10.9, U1.P21 (IO_L42N_GCLK24_3)
EXT31: J12.10, U1.P17 (IO_L43P_GCLK23_3)
EXT32: J11.10, U1.P16 (IO_L43N_GCLK22_IRDY2_3)
EXT33: J10.10, U1.P15 (IO_L44P_GCLK21_3)
EXT34: J12.11, U1.P14 (IO_L44N_GCLK20_3)
EXT35: J11.11, U1.P12 (IO_L49P_3)
FLASH_CS: U1.P38 (IO_L65N_CSO_B_2), U2.1 (CS)
FLASH_HOLD: U1.P61 (IO_L12N_D2_MISO3_2), U2.7 (HOLD)
FLASH_MISO: U1.P65 (IO_L3P_D0_DIN_MISO_MISO1_2), U2.2 (MISO)
FLASH_MOSI: U1.P64 (IO_L3N_MOSI_CSI_B_MISO0_2), U2.5 (MOSI)
FLASH_SCK: U1.P70 (IO_L1P_CCLK_2), U2.6 (SCK)
FLASH_WP: U1.P62 (IO_L12P_D1_MISO2_2), U2.3 (WP)
G: C7.2, R2.1, R13.1, R17.1, R20.1
G0: R20.2, U1.P82 (IO_L45N_1)
G1: R17.2, U1.P83 (IO_L45P_1)
G2: R13.2, U1.P84 (IO_L43N_GCLK4_1)
GND: AUDIO.SLEEVE, C1.2, C2.2, C3.2, C4.2, C9.1, C10.1, C11.1, C12.1, C13.1, C14.1, C15.1, C16.1, C17.1, C18.1, C19.1, C20.1, C21.1, C22.1, C23.1, C24.1, C25.1, C26.2, C27.1, C28.2, C29.2, C30.2, C31.2, C32.1, C33.1, CVBS.GND, D1.A, D2.C, D3.C, D4.C, D5.C, EAR.SLEEVE, J10.12, J11.12, JOY.8, JTAG.2, PS/2.3, PWCON.1, PWUSB.5 (GND), R1.2, R2.2, R3.2, R29.2, RST.1, SDCARD.3 (VSS1), SDCARD.6 (VSS2), SDCARD.M1 (GND), SDCARD.M2 (GND), SDCARD.M3 (GND), SDCARD.M4 (GND), T1.2 (E), U1.P3 (GND), U1.P13 (GND), U1.P25 (GND), U1.P49 (GND), U1.P54 (GND), U1.P60 (IO_L13P_M1_2), U1.P68 (GND), U1.P73 (SUSPEND), U1.P77 (GND), U1.P91 (GND), U1.P96 (GND), U1.P108 (GND), U1.P113 (GND), U1.P130 (GND), U1.P136 (GND), U1.P144 (IO_L1P_HSWAPEN_0), U2.4 (GND), U3.8 (!CS), U3.12 (VSS), U3.34 (VSS), U3.37 (!OE), U4.2 (AGND), U4.12 (YTRAP), U4.13 (DGND), U5.2 (GND), U6.1 (GND), U7.1 (GND)
JOY_DOWN: JOY.2, U1.P5 (IO_L52N_3)
JOY_FIRE1: JOY.6, U1.P2 (IO_L83P_3)
JOY_FIRE2: JOY.9, U1.P8 (IO_L51P_3)
JOY_FIRE3: J16.1, U1.P39 (IO_L65P_INIT_B_2)
JOY_LEFT: JOY.3, U1.P6 (IO_L52P_3)
JOY_RIGHT: JOY.4, U1.P7 (IO_L51N_3)
JOY_UP: JOY.1, U1.P1 (IO_L83N_VREF_3)
L-OUT: AUDIO.TIP (LEFT), C34.2
LED: R6.2, U1.P11 (IO_L49N_3)
unnamed: PS/2.6, R11.1
unnamed: PS/2.5, R10.1
unnamed: PS/2.2, R9.1
unnamed: PS/2.1, R8.1
unnamed: R24.1, RST.2, U1.P37 (PROGRAM_B_2)
unnamed: R28.2, T1.1 (B)
unnamed: C2.1, C5.1, D1.C, R28.1
unnamed: C5.2, R15.2
unnamed: EAR.TIP (LEFT), R15.1, R29.1
unnamed: C3.1, C35.1, R23.1
unnamed: C4.1, C34.1, R22.1
unnamed: PWCON.2, PWUSB.1 (VCC), SW.2
unnamed: L3.1, SW.1
unnamed: C29.1, L1.1, U6.2 (VOUT)
unnamed: J16.4, R5.2
unnamed: C31.1, L2.1, U7.2 (VOUT)
unnamed: R31.1, SDCARD.8 (DAT1)
unnamed: C8.1, U4.8 (BIN)
unnamed: R32.1, SDCARD.9 (DAT2)
unnamed: C7.1, U4.7 (GIN)
unnamed: C6.1, U4.6 (RIN)
unnamed: C1.1, U4.3 (4FSC), Y1.2, Y2.2
unnamed: D3.A, R26.1, Y2.1
unnamed: D2.A, R25.2, Y1.1
unnamed: C36.+, U4.10 (COMP)
unnamed: C36.-, R4.1
unnamed: CVBS.SIG, R4.2
unnamed: D4.A, R6.1
unnamed: D5.A, R7.1
PIN5: J16.2, JOY.5
PIN7: J16.3, JOY.7
PS2_CLK: R10.2, U1.P99 (IO_L33N_1)
PS2_DATA: R8.2, U1.P98 (IO_L34P_1)
PS2_PIN2: R9.2, U1.P97 (IO_L34N_1)
PS2_PIN6: R11.2, U1.P95 (IO_L40P_GCLK11_1)
R: C6.2, R1.1, R12.1, R16.1, R19.1
R0: R19.2, U1.P79 (IO_L47P_1)
R1: R16.2, U1.P80 (IO_L46N_1)
R2: R12.2, U1.P81 (IO_L46P_1)
R-OUT: AUDIO.RING (RIGHT), C35.2
SD_CS: SDCARD.1 (CD/DAT3/CS), U1.P59 (IO_L13N_D10_2)
SD_MISO: R30.2, SDCARD.7 (DAT0/DO), U1.P78 (IO_L47N_1)
SD_MOSI: SDCARD.2 (CMD/DI), U1.P74 (IO_L74N_DOUT_BUSY_1)
SD_SCK: SDCARD.5 (CLK/SCLK), U1.P75 (IO_L74P_AWAKE_1)
STDN: R25.1, U1.P66 (IO_L2N_CMPMOSI_2), U4.1 (STND)
STDNB: R26.2, U1.P67 (IO_L2P_CMPCLK_2)
TCK: JTAG.3, U1.P109 (TCK)
TDI: JTAG.5, U1.P110 (TDI)
TDO: JTAG.4, U1.P106 (TDO)
TMS: JTAG.6, U1.P107 (TMS)
VSYNC: U1.P85 (IO_L43P_GCLK5_1)
WR: U1.P121 (IO_L62P_0), U3.15 (!WE)
XA0: U1.P141 (IO_L2N_0), U3.3 (A0)
XA1: U1.P139 (IO_L3N_0), U3.4 (A1)
XA2: U1.P137 (IO_L4N_0), U3.5 (A2)
XA3: U1.P134 (IO_L34P_GCLK19_0), U3.6 (A3)
XA4: U1.P133 (IO_L34N_GCLK18_0), U3.7 (A4)
XA5: U1.P120 (IO_L62N_VREF_0), U3.16 (A5)
XA6: U1.P118 (IO_L63N_SCP6_0), U3.17 (A6)
XA7: U1.P116 (IO_L64N_SCP4_0), U3.18 (A7)
XA8: U1.P114 (IO_L65N_SCP2_0), U3.19 (A8)
XA9: U1.P112 (IO_L66P_SCP1_0), U3.20 (A9)
XA10: U1.P104 (IO_L1N_VREF_1), U3.26 (A10)
XA11: U1.P102 (IO_L32P_1), U3.27 (A11)
XA12: U1.P101 (IO_L32N_1), U3.28 (A12)
XA13: U1.P100 (IO_L33P_1), U3.29 (A13)
XA14: U1.P111 (IO_L66N_SCP0_0), U3.30 (A14)
XA15: U1.P131 (IO_L35N_GCLK16_0), U3.38 (A15)
XA16: U1.P138 (IO_L4P_0), U3.39 (A16)
XA17: U1.P140 (IO_L3P_0), U3.40 (A17)
XA18: U1.P142 (IO_L2P_0), U3.41 (A18/NC)
XA19: U1.P105 (IO_L1P_1), U3.25 (A19/NC)
XA20: U1.P143 (IO_L1N_VREF_0), U3.42 (A20/NC)
XD0: U1.P132 (IO_L35P_GCLK17_0), U3.9 (D0)
XD1: U1.P127 (IO_L36P_GCLK15_0), U3.10 (D1)
XD2: U1.P124 (IO_L37P_GCLK13_0), U3.13 (D2)
XD3: U1.P123 (IO_L37N_GCLK12_0), U3.14 (D3)
XD4: U1.P115 (IO_L65P_SCP3_0), U3.31 (D4)
XD5: U1.P117 (IO_L64P_SCP5_0), U3.32 (D5)
XD6: U1.P119 (IO_L63P_SCP7_0), U3.35 (D6)
XD7: U1.P126 (IO_L36N_GCLK14_0), U3.36 (D7)
