nikiiv/zx-uno/cores/Arcades/frogger/source/scramble_top.vhd

--------------------------------------------------------------------------------
-- Frogger ZX-UNO Port by Quest 2017
--------------------------------------------------------------------------------
--
-- A simulation model of Scramble hardware
-- Copyright (c) MikeJ - Feb 2007
--
-- All rights reserved
--
-- Redistribution and use in source and synthezised forms, with or without
-- modification, are permitted provided that the following conditions are met:
--
-- Redistributions of source code must retain the above copyright notice,
-- this list of conditions and the following disclaimer.
--
-- Redistributions in synthesized form must reproduce the above copyright
-- notice, this list of conditions and the following disclaimer in the
-- documentation and/or other materials provided with the distribution.
--
-- Neither the name of the author nor the names of other contributors may
-- be used to endorse or promote products derived from this software without
-- specific prior written permission.
--
-- THIS CODE IS PROVIDED BY THE COPYRIGHT HOLDERS AND CONTRIBUTORS "AS IS"
-- AND ANY EXPRESS OR IMPLIED WARRANTIES, INCLUDING, BUT NOT LIMITED TO,
-- THE IMPLIED WARRANTIES OF MERCHANTABILITY AND FITNESS FOR A PARTICULAR
-- PURPOSE ARE DISCLAIMED. IN NO EVENT SHALL THE AUTHOR OR CONTRIBUTORS BE
-- LIABLE FOR ANY DIRECT, INDIRECT, INCIDENTAL, SPECIAL, EXEMPLARY, OR
-- CONSEQUENTIAL DAMAGES (INCLUDING, BUT NOT LIMITED TO, PROCUREMENT OF
-- SUBSTITUTE GOODS OR SERVICES; LOSS OF USE, DATA, OR PROFITS; OR BUSINESS
-- INTERRUPTION) HOWEVER CAUSED AND ON ANY THEORY OF LIABILITY, WHETHER IN
-- CONTRACT, STRICT LIABILITY, OR TORT (INCLUDING NEGLIGENCE OR OTHERWISE)
-- ARISING IN ANY WAY OUT OF THE USE OF THIS SOFTWARE, EVEN IF ADVISED OF THE
-- POSSIBILITY OF SUCH DAMAGE.
--
-- You are responsible for any legal issues arising from your use of this code.
--
-- The latest version of this file can be found at: www.fpgaarcade.com
--
-- Email support@fpgaarcade.com
--
-- Revision list
--
-- version 001 initial release
--
library ieee;
  use ieee.std_logic_1164.all;
  use ieee.std_logic_arith.all;
  use ieee.std_logic_unsigned.all;

library UNISIM;
  use UNISIM.Vcomponents.all;

entity frogger_zxuno is
  port (
	 sram_addr : out std_logic_vector(20 downto 0);
	 sram_dq   : inout std_logic_vector(1 downto 0);
	 sram_we_n : out std_logic;
    --
    O_VIDEO_R             : out   std_logic_vector(2 downto 0);
    O_VIDEO_G             : out   std_logic_vector(2 downto 0);
    O_VIDEO_B             : out   std_logic_vector(2 downto 0);
    O_HSYNC               : out   std_logic;
    O_VSYNC               : out   std_logic;
    --
    O_AUDIO_L             : out   std_logic;
    O_AUDIO_R             : out   std_logic;
    --
    JOYSTICK              : in    std_logic_vector(5 downto 0);
    O_LED                 : out   std_logic;
    --
    OSC_IN                : in    std_logic;
	 
	 NTSC	: out std_logic;
	 PAL : out std_logic;
	 
	 ps2_clk : in std_logic;
	 ps2_data : in std_logic
    );
end;

architecture RTL of frogger_zxuno is
  -- this MUST be set true for frogger
  constant I_HWSEL_FROGGER  : boolean := true;

  signal I_RESET_L        : std_logic;
  signal reset            : std_logic;
  signal clk_ref          : std_logic;
  signal clk              : std_logic;
  signal ena_12           : std_logic;
  signal ena_6            : std_logic;
  signal ena_6b           : std_logic;
  signal ena_1_79         : std_logic;
  -- ip registers
  signal button_in        : std_logic_vector(7 downto 0);
  signal button_debounced : std_logic_vector(7 downto 0);
  signal ip_1p            : std_logic_vector(6 downto 0);
  signal ip_2p            : std_logic_vector(6 downto 0);
  signal ip_service       : std_logic;
  signal ip_coin1         : std_logic;
  signal ip_coin2         : std_logic;
  signal ip_dip_switch    : std_logic_vector(5 downto 1);

  -- scan doubler signals
  signal video_r          : std_logic_vector(3 downto 0);
  signal video_g          : std_logic_vector(3 downto 0);
  signal video_b          : std_logic_vector(3 downto 0);
  signal hsync            : std_logic;
  signal vsync            : std_logic;
  --
  signal video_r_x2       : std_logic_vector(3 downto 0);
  signal video_g_x2       : std_logic_vector(3 downto 0);
  signal video_b_x2       : std_logic_vector(3 downto 0);
  signal hsync_x2         : std_logic;
  signal vsync_x2         : std_logic;
  -- ties to audio board
  signal audio_addr       : std_logic_vector(15 downto 0);
  signal audio_data_out   : std_logic_vector(7 downto 0);
  signal audio_data_in    : std_logic_vector(7 downto 0);
  signal audio_data_oe_l  : std_logic;
  signal audio_rd_l       : std_logic;
  signal audio_wr_l       : std_logic;
  signal audio_iopc7      : std_logic;
  signal audio_reset_l    : std_logic;

  -- audio
  signal audio            : std_logic_vector(9 downto 0);
  signal audio_pwm        : std_logic;
  signal dbl_scan        : std_logic;
  
  signal comp_sync_l		: std_logic;

  signal clk_temp : std_logic;
  
  signal resetKey : std_logic;
  signal resetClk : std_logic;
  signal master_reset : std_logic;
  signal scanSW   : std_logic_vector(10 downto 0);
  
  signal buttons        : std_logic_vector(7 downto 0);
  signal joystick_reg   : std_logic_vector(5 downto 0);
  
  signal scandblctrl   : std_logic_vector(1 downto 0);

begin

  I_RESET_L <= '1';
  reset <= resetClk or resetKey;
  --
  -- clocks
  --
  u_clocks : entity work.SCRAMBLE_CLOCKS
    port map (
      I_CLK_REF  => OSC_IN,
      I_RESET_L  => I_RESET_L,
      --
      O_CLK_REF  => clk_ref,  -- 50
      --
      O_ENA_12   => ena_12,   -- 6.25 x 2
      O_ENA_6B   => ena_6b,   -- 6.25 (inverted)
      O_ENA_6    => ena_6,    -- 6.25
      O_ENA_1_79 => ena_1_79, -- 1.786
      O_CLK      => clk,
      O_RESET    => resetClk
      );

  u_scramble : entity work.SCRAMBLE
    port map (
      I_HWSEL_FROGGER       => I_HWSEL_FROGGER,
      --
      O_VIDEO_R             => video_r,
      O_VIDEO_G             => video_g,
      O_VIDEO_B             => video_b,
      O_HSYNC               => hsync,
      O_VSYNC               => vsync,
      --
      -- to audio board
      --
      O_ADDR                => audio_addr,
      O_DATA                => audio_data_out,
      I_DATA                => audio_data_in,
      I_DATA_OE_L           => audio_data_oe_l,
      O_RD_L                => audio_rd_l,
      O_WR_L                => audio_wr_l,
      O_IOPC7               => audio_iopc7,
      O_RESET_WD_L          => audio_reset_l,
      --
      ENA                   => ena_6,
      ENAB                  => ena_6b,
      ENA_12                => ena_12,
      --
      RESET                 => reset,
      CLK                   => clk
      );

  u_scan_doubler : entity work.SCRAMBLE_DBLSCAN
    port map (
      I_R          => video_r,
      I_G          => video_g,
      I_B          => video_b,
      I_HSYNC      => hsync,
      I_VSYNC      => vsync,
      --
      O_R          => video_r_x2,
      O_G          => video_g_x2,
      O_B          => video_b_x2,
      O_HSYNC      => hsync_x2,
      O_VSYNC      => vsync_x2,
      --
      ENA_X2       => ena_12,
      ENA          => ena_6,
      CLK          => clk,
      scanlines    =>  scandblctrl(1) xor scanSW(8)
      );

  dbl_scan <=  scandblctrl(0) xor scanSW(6); -- 1 = VGAS  0 = RGB
  
  ----genera sincro compuesta
   p_comp_sync : process(hsync, vsync)
  begin
    comp_sync_l <= (not vsync) and (not hsync);
  end process; 
  
  PAL <= '1';
  NTSC <='0';
  
  O_LED <= scanSW(9); --pad directions switch status
  
  p_video_ouput : process
  begin
    wait until rising_edge(clk);
    if (dbl_scan = '1') then
      O_VIDEO_R <= video_r_x2(2 downto 0);
      O_VIDEO_G <= video_g_x2(2 downto 0);
      O_VIDEO_B <= video_b_x2(2 downto 0);
      O_HSYNC   <= hsync_x2;
      O_VSYNC   <= vsync_x2;
    else
      O_VIDEO_R <= video_r(2 downto 0);
      O_VIDEO_G <= video_g(2 downto 0);
      O_VIDEO_B <= video_b(2 downto 0);
		O_HSYNC   <= comp_sync_l;
      O_VSYNC   <= '1';
    end if;
  end process;
  --
  --
  -- audio subsystem
  --
  u_audio : entity work.SCRAMBLE_AUDIO
    port map (
      I_HWSEL_FROGGER    => I_HWSEL_FROGGER,
      --
      I_ADDR             => audio_addr,
      I_DATA             => audio_data_out,
      O_DATA             => audio_data_in,
      O_DATA_OE_L        => audio_data_oe_l,
      --
      I_RD_L             => audio_rd_l,
      I_WR_L             => audio_wr_l,
      I_IOPC7            => audio_iopc7,
      --
      O_AUDIO            => audio,
      --
      I_1P_CTRL          => ip_1p, -- start, shoot1, shoot2, left,right,up,down
      I_2P_CTRL          => ip_2p, -- start, shoot1, shoot2, left,right,up,down
      I_SERVICE          => ip_service,
      I_COIN1            => ip_coin1,
      I_COIN2            => ip_coin2,
      O_COIN_COUNTER     => open,
      --
      I_DIP              => ip_dip_switch,
      --
      I_RESET_L          => audio_reset_l,
      ENA                => ena_6,
      ENA_1_79           => ena_1_79,
      CLK                => clk
      );

  --
  -- Audio DAC
  --
  u_dac : entity work.dac
    generic map(
      msbi_g => 9
    )
    port  map(
      clk_i   => clk_ref,
      res_n_i => I_RESET_L,
      dac_i   => audio,
      dac_o   => audio_pwm
    );
  O_AUDIO_L <= audio_pwm;
  O_AUDIO_R <= audio_pwm;

  joystick_reg <= JOYSTICK;
  
--  button_in(8) <= not scanSW(7);
  button_in(7) <= not scanSW(7); --pause
  button_in(5) <= joystick_reg(5) and not scanSW(5); --fire2 / x / lwin
  button_in(6) <= joystick_reg(4) and not scanSW(4); -- fire1 / enter / z / space

  button_in(4) <= joystick_reg(4) and not scanSW(4); -- fire1 / enter / z / space
  button_in(3) <= joystick_reg(3) and not scanSW(3); -- right
  button_in(2) <= joystick_reg(2) and not scanSW(2); -- left
  button_in(1) <= joystick_reg(1) and not scanSW(1); -- down
  button_in(0) <= joystick_reg(0) and not scanSW(0); -- up
  
  --Swap directions for horizontal screen help
  buttons(0) <= button_in(0) when scanSW(9) = '0' else button_in(2);
  buttons(1) <= button_in(1) when scanSW(9) = '0' else button_in(3);
  buttons(2) <= button_in(2) when scanSW(9) = '0' else button_in(1);
  buttons(3) <= button_in(3) when scanSW(9) = '0' else button_in(0);
  buttons(7 downto 4) <= button_in(7 downto 4);  

  u_debounce : entity work.SCRAMBLE_DEBOUNCE
  generic map (
    G_WIDTH => 8
    )
  port map (
    I_BUTTON => buttons, --button_in,
    O_BUTTON => button_debounced,
    CLK      => clk
    );

  -- assign inputs
  -- start, shoot1, shoot2, left,right,up,down
  ip_1p(6) <= button_debounced(4); -- start 1 -- not
  ip_1p(5) <= button_debounced(6); -- shoot1
  ip_1p(4) <= button_debounced(6); -- shoot2
  ip_1p(3) <= button_debounced(2); -- p1 left
  ip_1p(2) <= button_debounced(3); -- p1 right
  ip_1p(1) <= button_debounced(0); -- p1 up
  ip_1p(0) <= button_debounced(1); -- p1 down
  --
  ip_2p(6) <= button_debounced(7); -- start 2 --not
  ip_2p(5) <= '1';
  ip_2p(4) <= '1';
  ip_2p(3) <= button_debounced(2); -- p2 left
  ip_2p(2) <= button_debounced(3); -- p2 right
  ip_2p(1) <= button_debounced(0); -- p2 up
  ip_2p(0) <= button_debounced(1); -- p2 down
  --
  ip_service <= not scanSW(10); --service menu
  ip_coin1   <= button_debounced(5); -- credit --not
  ip_coin2   <= not scanSW(10);

  -- dip switch settings
  scramble_dips : if (not I_HWSEL_FROGGER) generate
  begin
    --SW #1   SW #2       Rockets              SW #3       Cabinet
    -------   -----      ---------             -----       --------
     --OFF     OFF       Unlimited              OFF        Table
     --OFF     ON            5                  ON         Up Right
     --ON      OFF           4
     --ON      ON            3


    --SW #4   SW #5      Coins/Play
    -------   -----      ----------
     --OFF     OFF           4
     --OFF     ON            3
     --ON      OFF           2
     --ON      ON            1

    ip_dip_switch(5 downto 4)  <= not "11"; -- 1 play/coin.
    ip_dip_switch(3)           <= not '1';
    ip_dip_switch(2 downto 1)  <= not "10";
  end generate;

  frogger_dips : if (    I_HWSEL_FROGGER) generate
  begin
  --1   2   3   4   5       Meaning
  -------------------------------------------------------
  --On  On                  3 Frogs
  --On  Off                 5 Frogs
  --Off On                  7 Frogs
  --Off Off                 256 Frogs (!)
  --
  --        On              Upright unit
  --        Off             Cocktail unit
  --
  --            On  On      1 coin 1 play
  --            On  Off     2 coins 1 play
  --            Off On      3 coins 1 play
  --            Off Off     1 coin 2 plays

    ip_dip_switch(5 downto 4)  <= not "11";
    ip_dip_switch(3)           <= not '1'; 
    ip_dip_switch(2 downto 1)  <= not "01";
  end generate;
  
 --0x8FD5 SRAM (SCANDBLCTRL ZXUNO REG)  
 sram_addr <= "000001000111111010101"; 	
 scandblctrl <= sram_dq(1 downto 0);  
 sram_we_n <= '1';
  
---- keyboard module
  keyboard : entity work.keyboard 
	  port map (
		CLOCK => ena_12,
		PS2_CLK => ps2_clk,
		PS2_DATA => ps2_data,
		resetKey => resetKey,
		MRESET => master_reset,
		scanSW => scanSW
	);
  
-----------------Multiboot-------------
	multiboot : entity work.multiboot 
	port map (
	  clk_icap => ena_12,
	  REBOOT => master_reset
	);  
  

end RTL;
