nikiiv/zx-uno/cores/zx80yuno/rom/rom81l.vhd

library IEEE;
use IEEE.std_logic_1164.all;
use IEEE.numeric_std.all;

entity ROM81 is
	port(
		Clk	: in std_logic;
		AIn	: in std_logic_vector(11 downto 0);
		D	: out std_logic_vector(7 downto 0)
	);
end ROM81;

architecture rtl of ROM81 is
	signal A	: std_logic_vector(11 downto 0);
begin
	process (Clk)
	begin
		if Clk'event and Clk = '1' then
			A <= AIn;
		end if;
	end process;
	process (A)
	begin
		case to_integer(unsigned(A)) is
		when 000000 => D <= "11010011";	-- 0x0000
		when 000001 => D <= "11111101";	-- 0x0001
		when 000002 => D <= "00000001";	-- 0x0002
		when 000003 => D <= "11111111";	-- 0x0003
		when 000004 => D <= "01111111";	-- 0x0004
		when 000005 => D <= "11000011";	-- 0x0005
		when 000006 => D <= "11001011";	-- 0x0006
		when 000007 => D <= "00000011";	-- 0x0007
		when 000008 => D <= "00101010";	-- 0x0008
		when 000009 => D <= "00010110";	-- 0x0009
		when 000010 => D <= "01000000";	-- 0x000A
		when 000011 => D <= "00100010";	-- 0x000B
		when 000012 => D <= "00011000";	-- 0x000C
		when 000013 => D <= "01000000";	-- 0x000D
		when 000014 => D <= "00011000";	-- 0x000E
		when 000015 => D <= "01000110";	-- 0x000F
		when 000016 => D <= "10100111";	-- 0x0010
		when 000017 => D <= "11000010";	-- 0x0011
		when 000018 => D <= "11110001";	-- 0x0012
		when 000019 => D <= "00000111";	-- 0x0013
		when 000020 => D <= "11000011";	-- 0x0014
		when 000021 => D <= "11110101";	-- 0x0015
		when 000022 => D <= "00000111";	-- 0x0016
		when 000023 => D <= "11111111";	-- 0x0017
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
		when 002704 => D <= "00001001";	-- 0x0A90
		when 002705 => D <= "11011010";	-- 0x0A91
		when 002706 => D <= "10011010";	-- 0x0A92
		when 002707 => D <= "00001101";	-- 0x0A93
		when 002708 => D <= "10111111";	-- 0x0A94
		when 002709 => D <= "11000011";	-- 0x0A95
		when 002710 => D <= "10111100";	-- 0x0A96
		when 002711 => D <= "00010100";	-- 0x0A97
		when 002712 => D <= "11010101";	-- 0x0A98
		when 002713 => D <= "11100101";	-- 0x0A99
		when 002714 => D <= "10101111";	-- 0x0A9A
		when 002715 => D <= "11001011";	-- 0x0A9B
		when 002716 => D <= "01111000";	-- 0x0A9C
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
