nikiiv/zx-uno/cores/zx80yuno/zx/zxuno/scandbl_estudiar.vhd

--
-- A simulation model of Pacman hardware
-- VHDL conversion by MikeJ - October 2002
--
-- FPGA PACMAN video scan doubler
--
-- based on a design by Tatsuyuki Satoh
--
--
-- All rights reserved
--
-- Redistribution and use in source and synthezised forms, with or without
-- modification, are permitted provided that the following conditions are met:
--
-- Redistributions of source code must retain the above copyright notice,
-- this list of conditions and the following disclaimer.
--
-- Redistributions in synthesized form must reproduce the above copyright
-- notice, this list of conditions and the following disclaimer in the
-- documentation and/or other materials provided with the distribution.
--
-- Neither the name of the author nor the names of other contributors may
-- be used to endorse or promote products derived from this software without
-- specific prior written permission.
--
-- THIS CODE IS PROVIDED BY THE COPYRIGHT HOLDERS AND CONTRIBUTORS "AS IS"
-- AND ANY EXPRESS OR IMPLIED WARRANTIES, INCLUDING, BUT NOT LIMITED TO,
-- THE IMPLIED WARRANTIES OF MERCHANTABILITY AND FITNESS FOR A PARTICULAR
-- PURPOSE ARE DISCLAIMED. IN NO EVENT SHALL THE AUTHOR OR CONTRIBUTORS BE
-- LIABLE FOR ANY DIRECT, INDIRECT, INCIDENTAL, SPECIAL, EXEMPLARY, OR
-- CONSEQUENTIAL DAMAGES (INCLUDING, BUT NOT LIMITED TO, PROCUREMENT OF
-- SUBSTITUTE GOODS OR SERVICES; LOSS OF USE, DATA, OR PROFITS; OR BUSINESS
-- INTERRUPTION) HOWEVER CAUSED AND ON ANY THEORY OF LIABILITY, WHETHER IN
-- CONTRACT, STRICT LIABILITY, OR TORT (INCLUDING NEGLIGENCE OR OTHERWISE)
-- ARISING IN ANY WAY OUT OF THE USE OF THIS SOFTWARE, EVEN IF ADVISED OF THE
-- POSSIBILITY OF SUCH DAMAGE.
--
-- You are responsible for any legal issues arising from your use of this code.
--
-- The latest version of this file can be found at: www.fpgaarcade.com
--
-- Email pacman@fpgaarcade.com
--
-- Revision list
--
-- version 005 spartan6 release (hamster@snap.net.nz)
-- version 004 spartan3e release
-- version 003 Jan 2006 release, general tidy up
-- version 002 initial release
--
--library ieee;
--  use ieee.std_logic_1164.all;
--  use ieee.std_logic_unsigned.all;
--  use ieee.numeric_std.all;
library IEEE;
use IEEE.STD_LOGIC_1164.ALL;
use IEEE.STD_LOGIC_ARITH.ALL;
use IEEE.STD_LOGIC_UNSIGNED.ALL;

--  Uncomment the following lines to use the declarations that are
--  provided for instantiating Xilinx primitive components.
library UNISIM;
use UNISIM.VComponents.all;
	
entity DBLSCAN is
  port (
	I_R               : in    std_logic_vector( 2 downto 0);
	I_G               : in    std_logic_vector( 2 downto 0);
	I_B               : in    std_logic_vector( 1 downto 0);
	I_HSYNC           : in    std_logic;
	I_VSYNC           : in    std_logic;
	--
	O_R               : out   std_logic_vector( 2 downto 0);
	O_G               : out   std_logic_vector( 2 downto 0);
	O_B               : out   std_logic_vector( 1 downto 0);
	O_HSYNC           : out   std_logic;
	O_VSYNC           : out   std_logic;
	--
	ENA_6             : in    std_logic;
	ENA_12            : in    std_logic;
	CLK               : in    std_logic
	);
end;

architecture RTL of DBLSCAN is
  signal ram_ena_12  : std_logic;
  signal ram_ena_6   : std_logic;
  --
  -- input timing
  --
  signal hsync_in_t1 : std_logic;
  signal vsync_in_t1 : std_logic;
  signal hpos_i      : std_logic_vector(8 downto 0) := (others => '0');    -- input capture postion
  signal ibank       : std_logic;
  signal we_a        : std_logic;
  signal we_b        : std_logic;
  signal rgb_in      : std_logic_vector(7 downto 0);
  --
  -- output timing
  --
  signal hpos_o      : std_logic_vector(8 downto 0) := (others => '0');
  signal ohs         : std_logic;
  signal ohs_t1      : std_logic;
  signal ovs         : std_logic;
  signal ovs_t1      : std_logic;
  signal obank       : std_logic;
  signal obank_t1    : std_logic;
  --
  signal vs_cnt      : std_logic_vector(2 downto 0);
  signal rgb_out_a   : std_logic_vector(7 downto 0);
  signal rgb_out_b   : std_logic_vector(7 downto 0);
  
--  COMPONENT ramb16_s9_s9
--  PORT (
--	 -- output
--    q 		  :OUT STD_LOGIC_VECTOR(7 DOWNTO 0);
--    rdaddress : IN STD_LOGIC_VECTOR(8 DOWNTO 0);
--	 rden		  : IN STD_LOGIC;
--    rdclock   : IN STD_LOGIC;
--	 
--	 -- input
--	 data      : IN STD_LOGIC_VECTOR(7 DOWNTO 0);
--    wraddress : IN STD_LOGIC_VECTOR(8 DOWNTO 0);
--	 wren      : IN STD_LOGIC;
--    wrclock   : IN STD_LOGIC
--	);
--	END COMPONENT;

begin

  p_input_timing : process
	variable rising_h : boolean;
	variable rising_v : boolean;
  begin
	wait until rising_edge (CLK);
	if (ENA_6 = '1') then
	  hsync_in_t1 <= I_HSYNC;
	  vsync_in_t1 <= I_VSYNC;

	  rising_h := (I_HSYNC = '1') and (hsync_in_t1 = '0');
	  rising_v := (I_VSYNC = '1') and (vsync_in_t1 = '0');

	  if rising_v then
		ibank <= '0';
	  elsif rising_h then
		ibank <= not ibank;
	  end if;

	  if rising_h then
		hpos_i <= (others => '0');
	  else
		hpos_i <= hpos_i + "1";
	  end if;
	end if;
  end process;

  we_a <=     ibank;
  we_b <= not ibank;
  rgb_in <= I_B & I_G & I_R;


-- por jepalza, adaptado a Spartan 6 LX9 desde spartan 3e 1000 (antes RAMB4_S8_S8)
 u_ram_a : RAMB16_S9_S9
	port map (
	  -- output
	  DOPB  => open,
	  DOB   => rgb_out_a,
	  DIPB  => "0",
	  DIB   => x"00", 
	  ADDRB => "00"&hpos_o,  -- 10 a 0:ojo con la salida que la he pasado de 9 a 11 bits
	  WEB   => '0',
	  ENB   => ENA_12, -- '1',
	  SSRB  => '0',
	  CLKB  => CLK, --_X2, -- pruebas

	  -- input
	  DOPA  => open,
	  DOA   => open,
	  DIPA   => "0",
	  DIA   => RGB_IN,
	  ADDRA => "00"&hpos_i,
	  WEA   => we_a,
	  ENA   => '1',
	  SSRA  => '0',
	  CLKA  => CLK
	  );

  u_ram_b : RAMB16_S9_S9
	port map (
	  -- output
	  DOPB  => open,
	  DOB   => rgb_out_b,
	  DIPB  => "0",
	  DIB   => x"00",
	  ADDRB => "00"&hpos_o, -- 10 a 0:ojo con la salida que la he pasado de 9 a 11 bits
	  WEB   => '0',
	  ENB   => ENA_12, -- '1',
	  SSRB  => '0',
	  CLKB  => CLK, --_X2, -- pruebas

	  -- input
	  DOPA  => open,
	  DOA   => open,
	  DIPA   => "0",
	  DIA   => RGB_IN,
	  ADDRA => "00"&hpos_i,
	  WEA   => we_b,
	  ENA   => '1',
	  SSRA  => '0',
	  CLKA  => CLK
	  );
-- hasta aqui, del menda


  p_output_timing : process
	variable rising_h : boolean;
  begin
	wait until rising_edge (CLK);
	if  (ENA_12 = '1') then
	  rising_h := ((ohs = '1') and (ohs_t1 = '0'));

	  if rising_h or (hpos_o = "110011101") then   -- was 101111111
		hpos_o <= (others => '0');
	  else
		hpos_o <= hpos_o + "1";
	  end if;

	  if (ovs = '1') and (ovs_t1 = '0') then -- rising_v
		obank <= '0';
		vs_cnt <= "000";
	  elsif rising_h then
		obank <= not obank;
		if (vs_cnt(2) = '0') then
		  vs_cnt <= vs_cnt + "1";
		end if;
	  end if;

	  ohs <= I_HSYNC; -- reg on clk_12
	  ohs_t1 <= ohs;

	  ovs <= I_VSYNC; -- reg on clk_12
	  ovs_t1 <= ovs;
	end if;
  end process;

  p_op : process
  begin
	wait until rising_edge (CLK);
	if (ENA_12 = '1') then
	  O_HSYNC <= '0';
	  if (hpos_o < 32) then -- may need tweaking !
		O_HSYNC <= '1';
	  end if;

	  obank_t1 <= obank;
	  if (obank_t1 = '1') then
		O_B <= rgb_out_b(7 downto 6);
		O_G <= rgb_out_b(5 downto 3);
		O_R <= rgb_out_b(2 downto 0);
	  else
		O_B <= rgb_out_a(7 downto 6);
		O_G <= rgb_out_a(5 downto 3);
		O_R <= rgb_out_a(2 downto 0);
	  end if;

	  O_VSYNC <= not vs_cnt(2);

	end if;
  end process;
end architecture RTL;
