nikiiv/zx-uno/(notices)

Notices in the files:
cores/zx80yuno/zx/zxuno/zx80yuno.v:
This source file is free software: you can redistribute it and/or modify
it under the terms of the GNU General Public License as published
hardware/USB-PS2/firmware/Src/main.c:
Copyright 2017 Juan Jose Luna Espinosa
(C) COPYRIGHT STMicroelectronics *****END OF FILE
software/genslideshow_512x384/main.c:
This program is free software: you can redistribute it and/or modify
it under the terms of the GNU General Public License as published by
the Free Software Foundation, either version 3 of the License, or
(at your option) any later version.
cores/a-z80/execute.v:
under the terms of the GNU General Public License as published by the Free
hardware/otros/comcon/comcon_version_mcleod.sch:
(C)2015 mcleod_ideafix
hardware/zxuno/v4.1/eagle/zxuno_v41.brd:
(C)2016 ZX-Uno Team
hardware/gomasuno/gomasuno.brd:
(C)2017 ZX-Uno Team
parts and their libraries:
SparkFun-Connectors: Licensing: Creative Commons ShareAlike 4.0 International - https://creativecommons.org/licenses/by-sa/4.0
SparkFun-Connectors: Licensing: CC v3.0 Share-Alike You are welcome to use this library for commercial purposes.
wuerth-elektronik: Copyright: Würth Elektronik eiSos
